Niclasapdk/ESD4_project/README.md

# ESD4_project

This repository contains notes and design files for the HiFi amplifier made in the P4 project at AAU in the spring semester of 2024.
