Niclasapdk/ESD4_project/figures/system_design/small_signal_figures/vas_stage.pdf

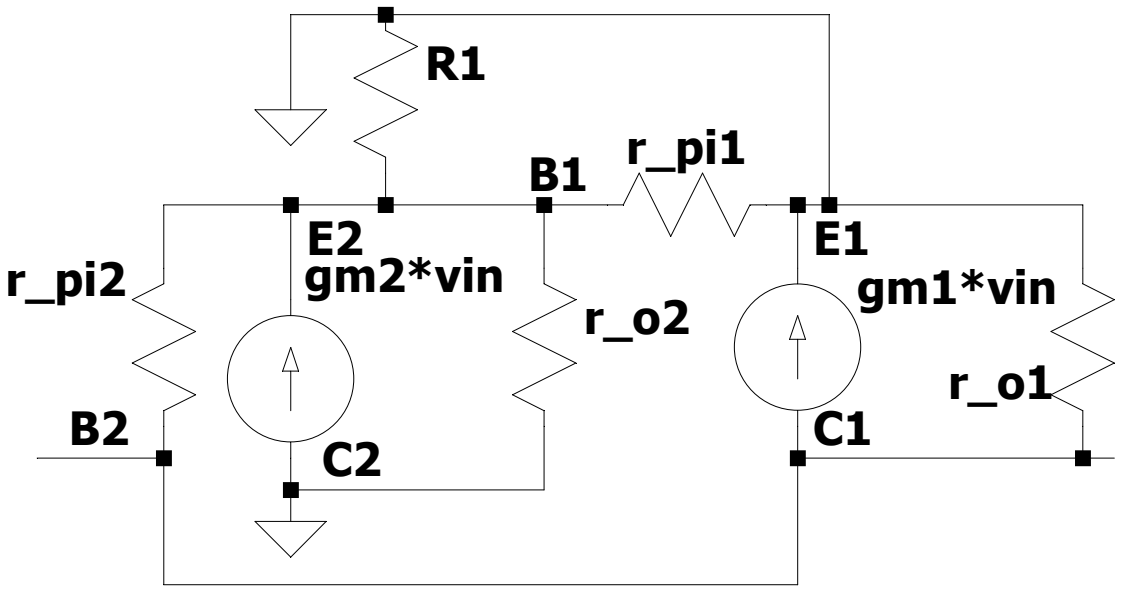
[picture p1: figure]
gm2*vin; gm1*vin

## Z_inOS

## Power Amp

--- C:\Users\johba\ESD4_project\figures\system_design\small_signal_figures\vas_stage.asc ---
