Niclasapdk/ESD4_project/figures/system_design/voltage_follower/Voltage_follower.pdf

U1
Input | Output

--- C:\Users\nicla\Documents\GitHub\ESD4_project\figures\system_design\voltage_follower\Voltage_follower.asc ---
