Niclasapdk/ESD4_project/aux_preamp/Readme.md

# op27
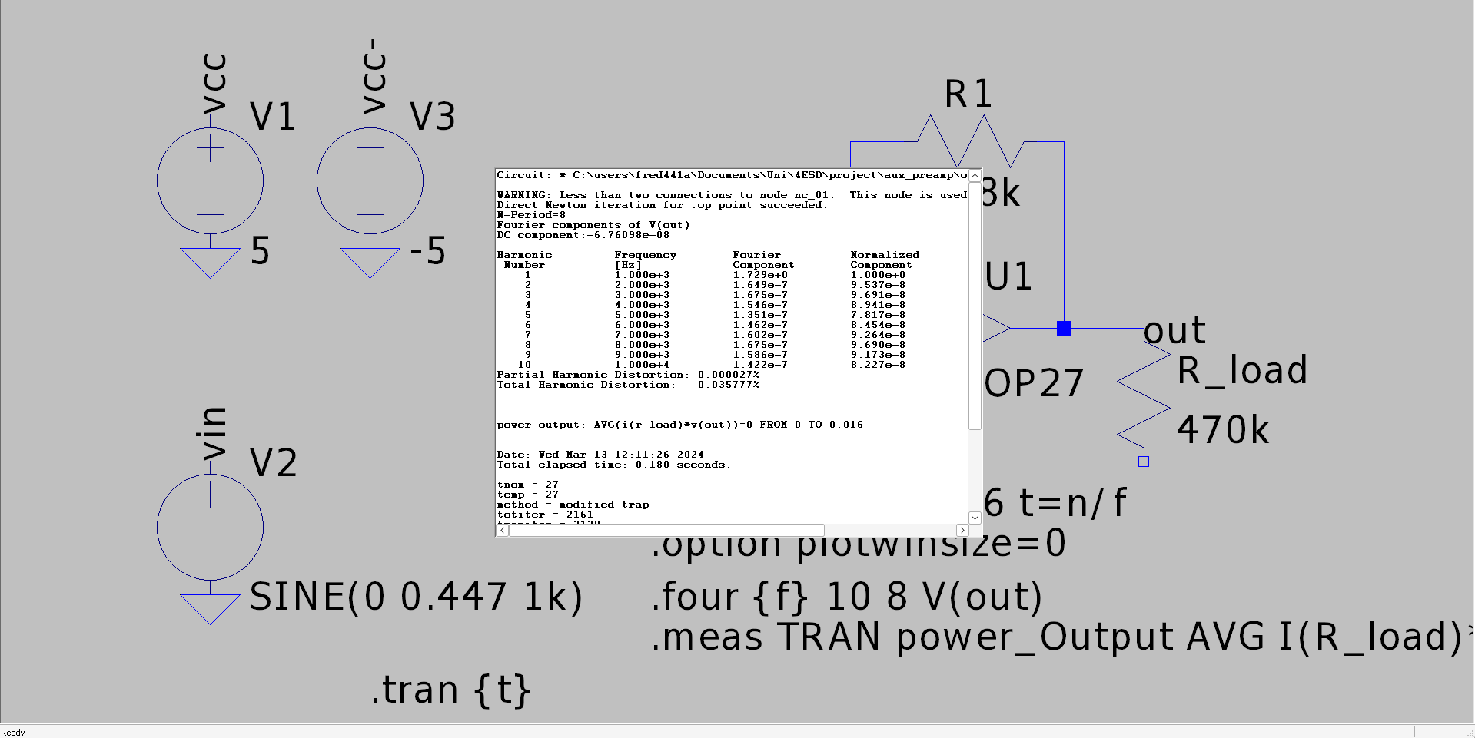
[picture p2: aux_preamp/images/img2222.png]

# op07
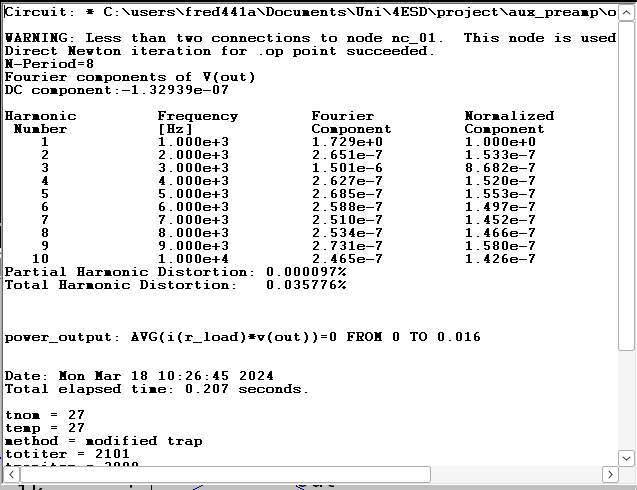
[picture p3: aux_preamp/images/img4966.png]

# differential
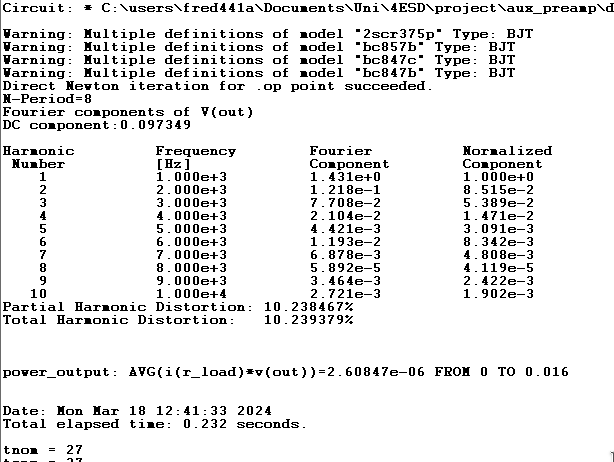
[picture p4: aux_preamp/images/img7617.png]
