Niclasapdk/ESD4_project/figures/system_design/small_signal_figures/differential_stage_v2.pdf

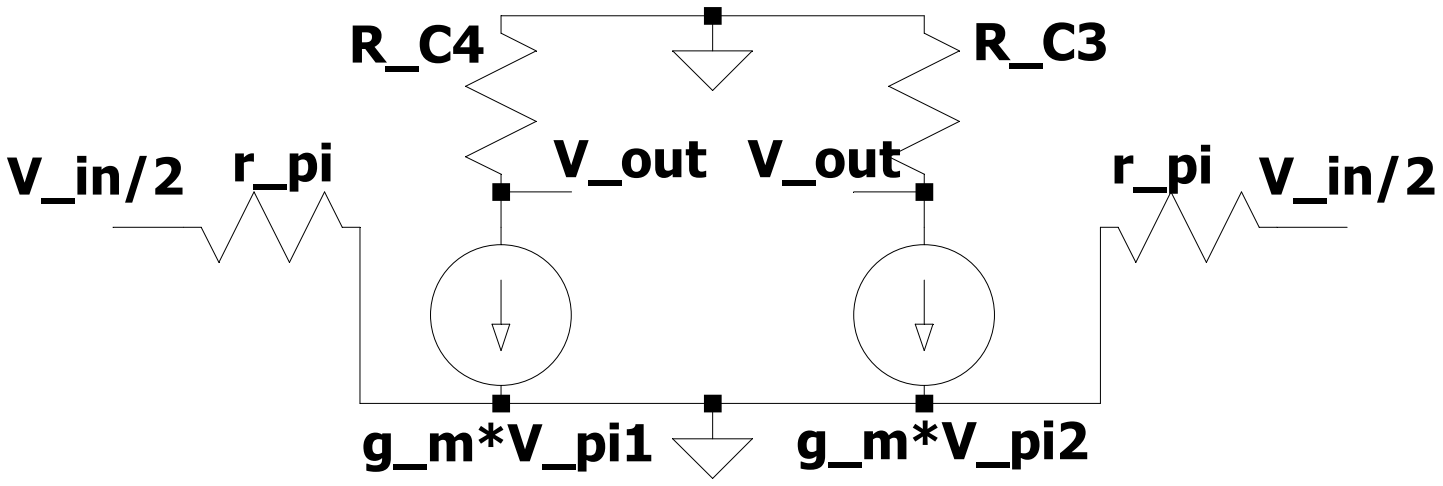
[picture p5: figure]
V_in/2 V_out V_out

--- C:\Users\johba\ESD4_project\figures\system_design\small_signal_figures\differential_stage_v2.asc ---
