Niclasapdk/ESD4_project/figures/system_design/output_compensation/output_compensation.pdf

L1

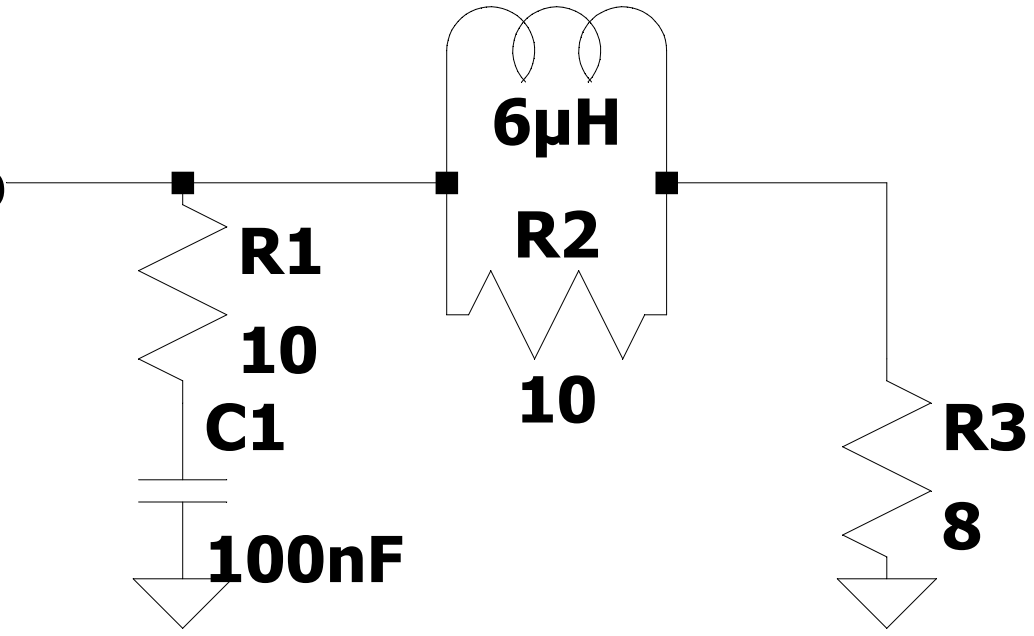
[picture p6: figure]

# Output_amp

--- C:\Users\nicla\Documents\GitHub\ESD4_project\figures\system_design\output_compensation\output_compensation.asc ---
