Niclasapdk/ESD4_project/figures/system_design/small_signal_figures/npn_darlington.pdf

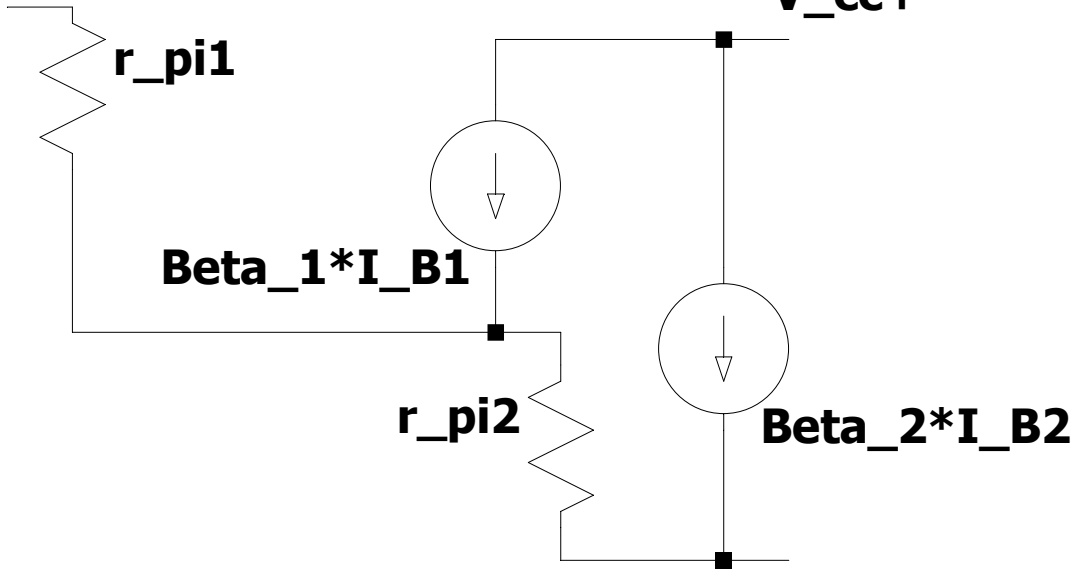
[picture p7: figure]
Beta_1*I_B1; Beta_2*I_B2

r_oVas | r_pi1

## V_cc+

## Out

--- C:\Users\johba\ESD4_project\figures\system_design\small_signal_figures\npn_darlington.asc ---
