Niclasapdk/ESD4_project/figures/system_design/vas_stage_pa/vas_stage_pa.pdf

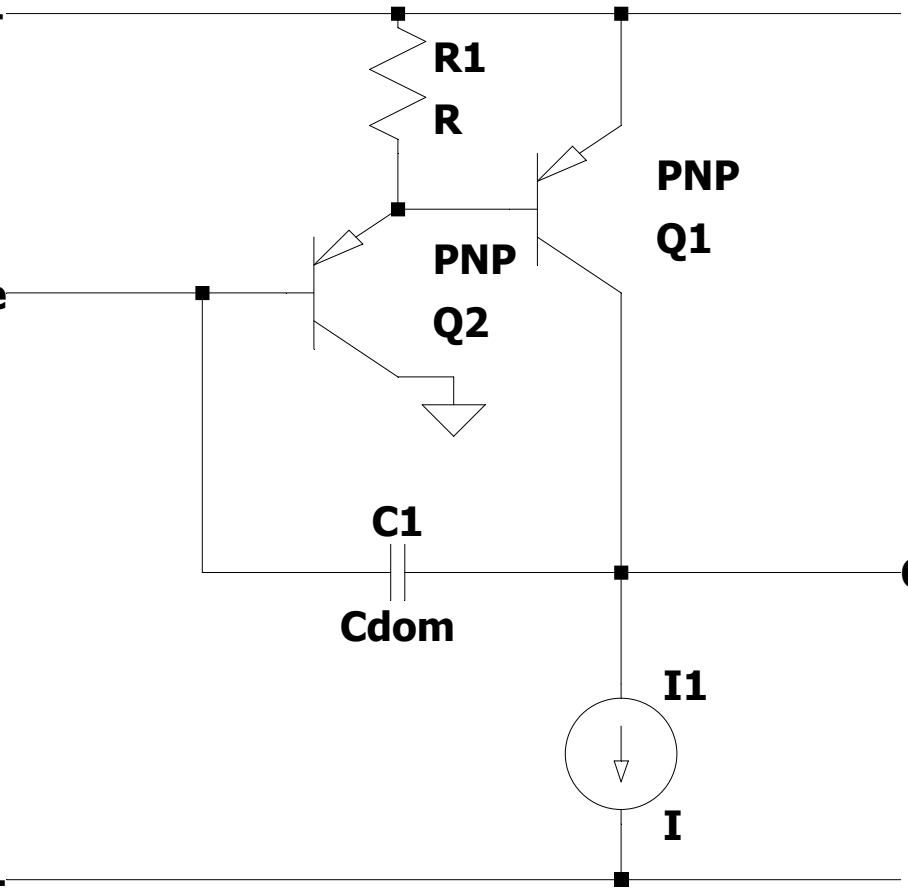
[picture p8: figure]
PNP; Cdom

## Input_Stage

V+

## Output_stage

V-

--- C:\Users\nicla\Documents\GitHub\ESD4_project\figures\system_design\vas_stage_pa\vas_stage_pa.asc ---
