Niclasapdk/ESD4_project/figures/system_design/riaa_preamp/rlc_hp_lp_schematic.pdf

R1

L1

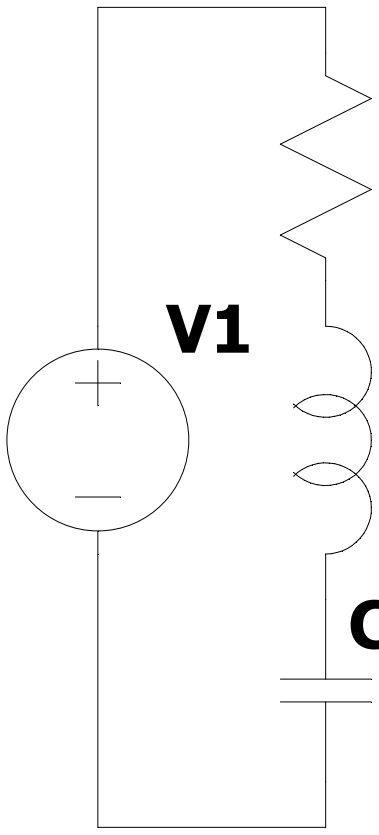
[picture p9: figure]

C1

C2

R2

R3

C3

V1 | V2 | V3
RLC | HP | LP

--- C:\Users\johba\ESD4_project\figures\system_design\riaa_pa\rlc_hp_lp_schematic.asc ---
