Niclasapdk/ESD4_project/figures/system_design/riaa_preamp/riaa_de-emphasis_circuit.pdf

R8

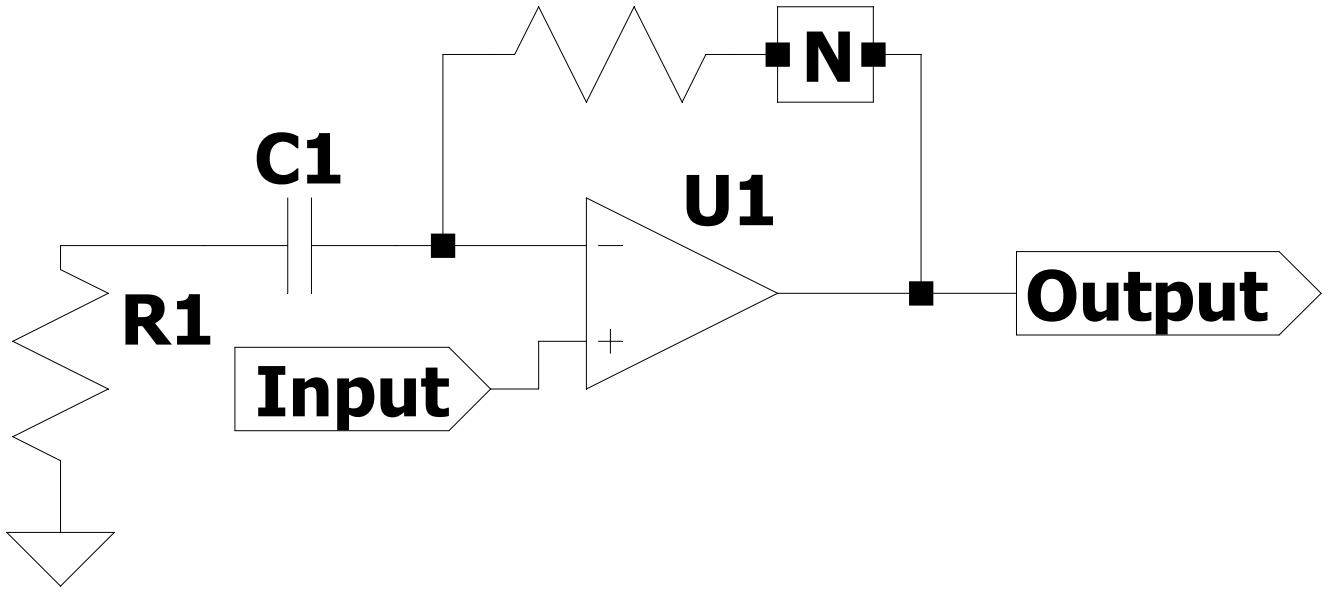
[picture p10: figure]
Input; Output

--- C:\Users\johba\ESD4_project\figures\system_design\riaa_pa\Draft1.asc ---
