Niclasapdk/ESD4_project/figures/system_design/bias_design/bias_design.pdf

# Vas

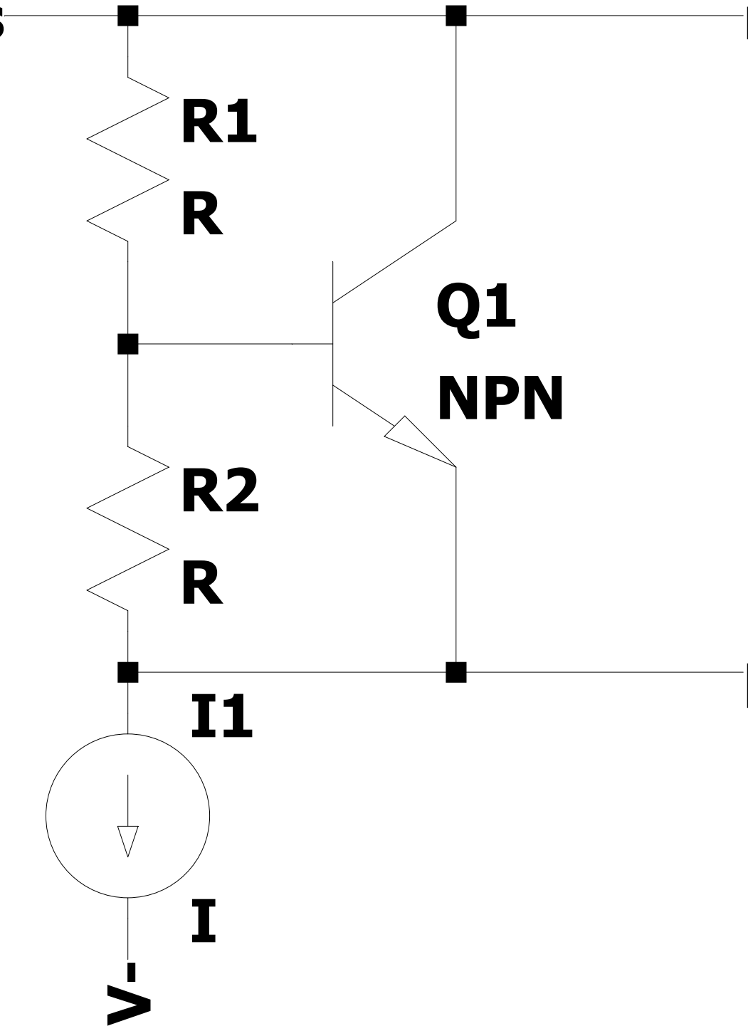
[picture p11: figure]
Q1 NPN

# pnp

# npn

--- C:\Users\nicla\Documents\GitHub\ESD4_project\figures\system_design\bias_design\bias_design.asc ---
