Niclasapdk/ESD4_project/figures/system_design/darlington_coupling/darling_coupling.pdf

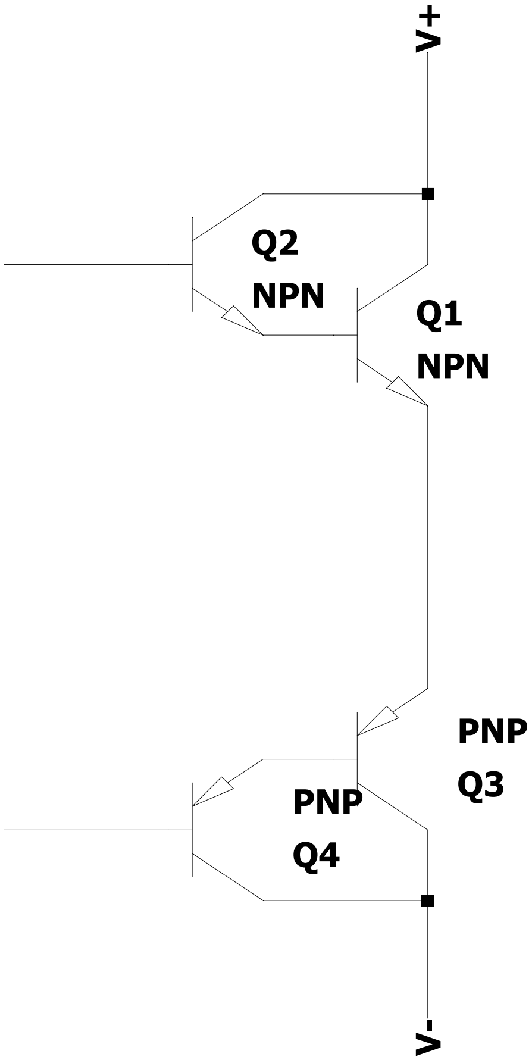
[picture p12: figure]
Q1 NPN; Q2 NPN; PNP; PNP V+ V⁻

--- C:\Users\nicla\Documents\GitHub\ESD4_project\figures\system_design\darlington_coupling\darlington_coupling.asc ---
