Niclasapdk/ESD4_project/figures/system_design/input_stage_pa/input_stage_pa.pdf

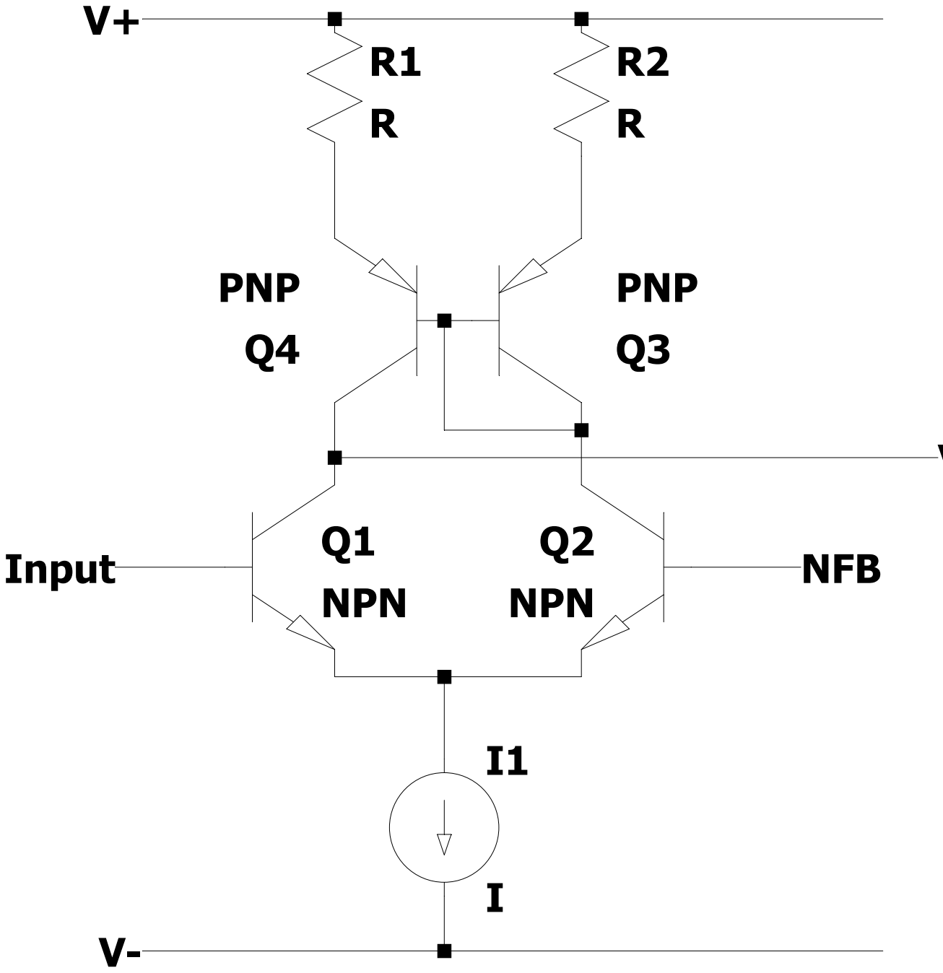
[picture p13: figure]
Q1 NPN; Q2 NPN; PNP; Input; NFB

# VAS

--- C:\Users\nicla\Documents\GitHub\ESD4_project\figures\system_design\input_stage_pa\input_stage_pa.asc ---
