Niclasapdk/ESD4_project/figures/system_design/output_stage_pa/output_stage_pa.pdf

V+

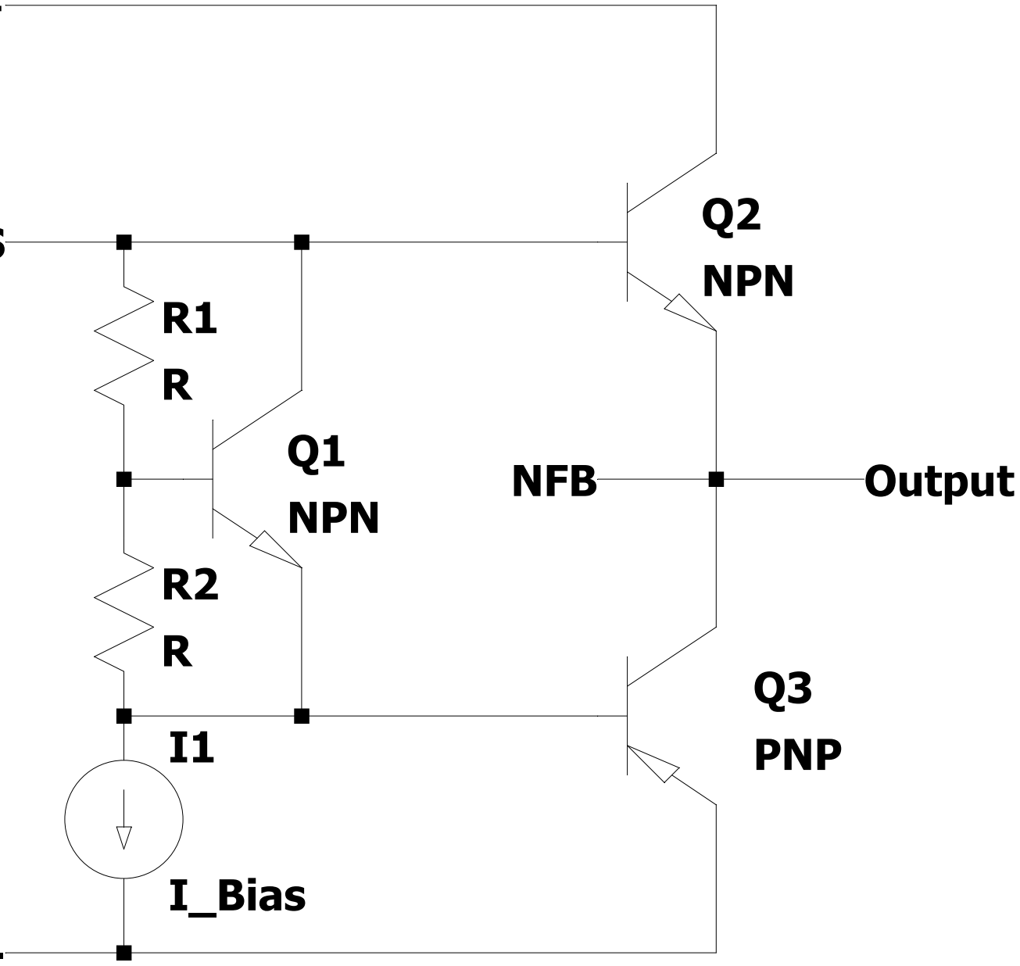
[picture p14: figure]
Q1 NPN; Q2 NPN; PNP; I_Bias; NFB; Output

V-

# VAS

--- C:\Users\nicla\Documents\GitHub\ESD4_project\figures\system_design\output_stage_pa\output_stage_pa.asc ---
