Niclasapdk/ESD4_project/forsider/Forside2.pdf

# Design of a Hi-Fi amplifier system

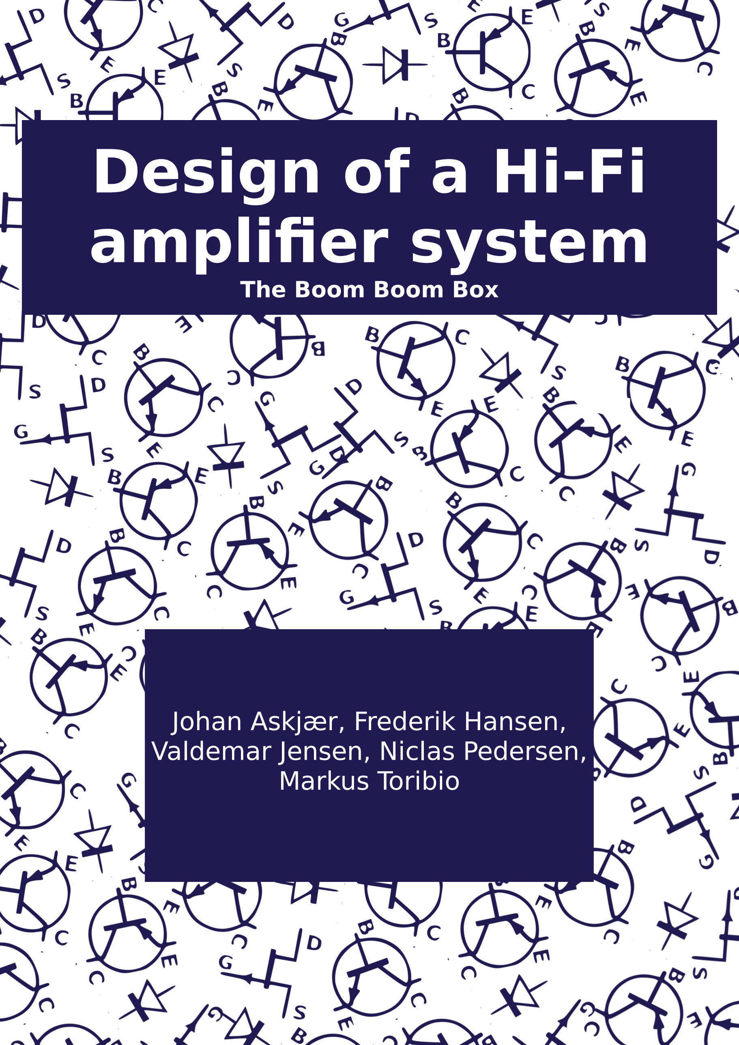
[picture p15: page 1]

Johan Askjær, Frederik Hansen, Valdemar Jensen, Niclas Pedersen, Markus Toribio

The Boom Boom Box
