Niclasapdk/ESD4_project/class_a_amplifier/output_stage.pdf

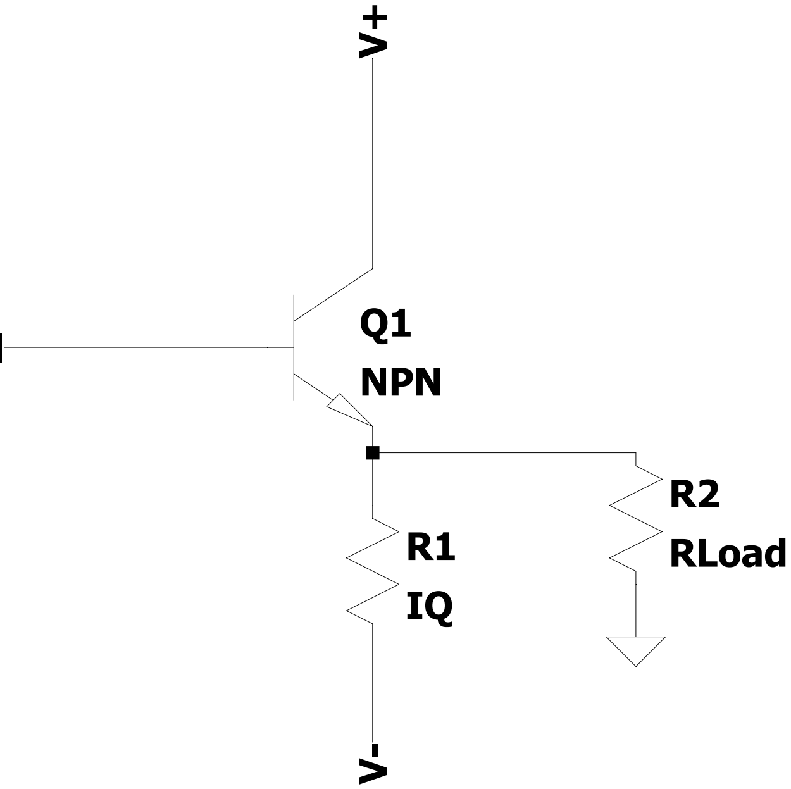
[picture p16: figure]
Q1 NPN; RLoad V+ V-

R2

# Signal

--- C:\Users\nicla\Documents\GitHub\ESD4_project\class_a_amplifier\output_stage.asc ---
