Niclasapdk/ESD4_project/forsider/Forside1.pdf

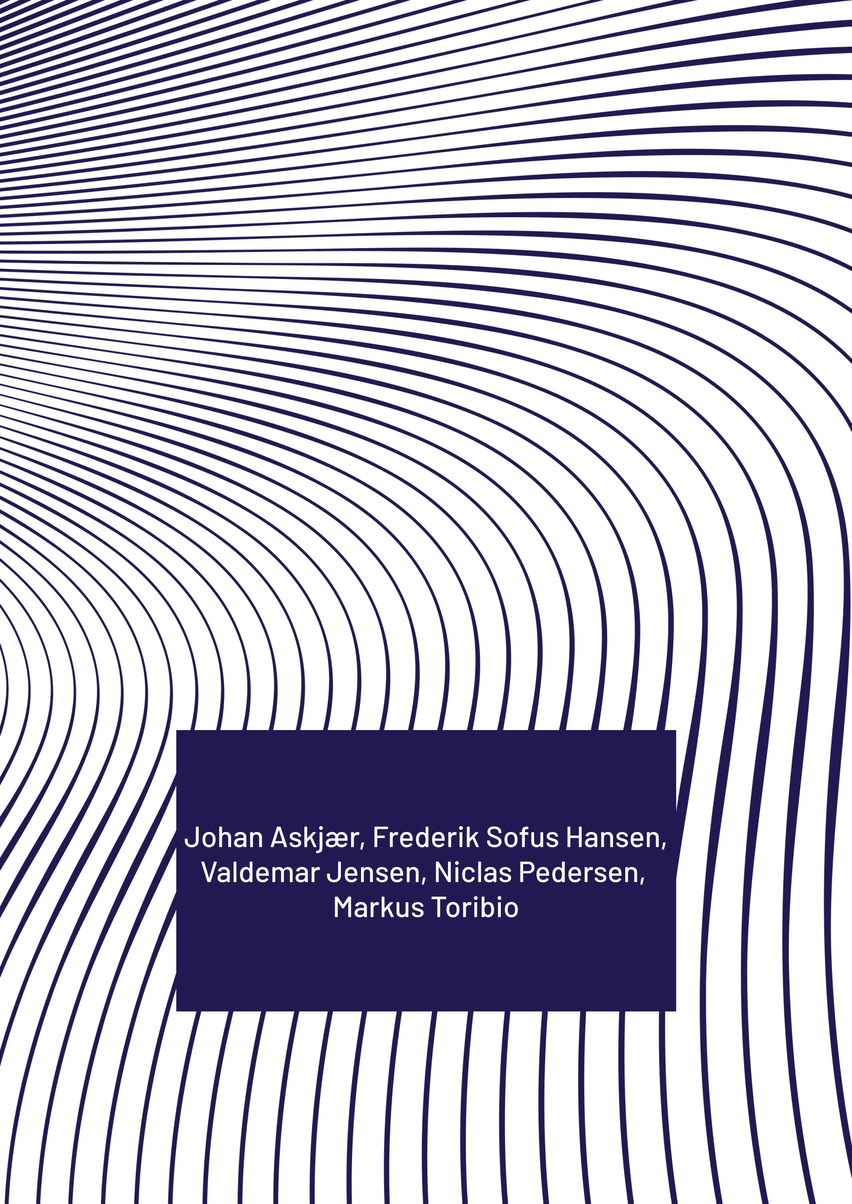
[picture p17: page 1]

Johan Askjær, Frederik Sofus Hansen, Valdemar Jensen, Niclas Pedersen, Markus Toribio
