Niclasapdk/ESD4_project/figures/system_design/small_signal_figures/differential_stage.pdf

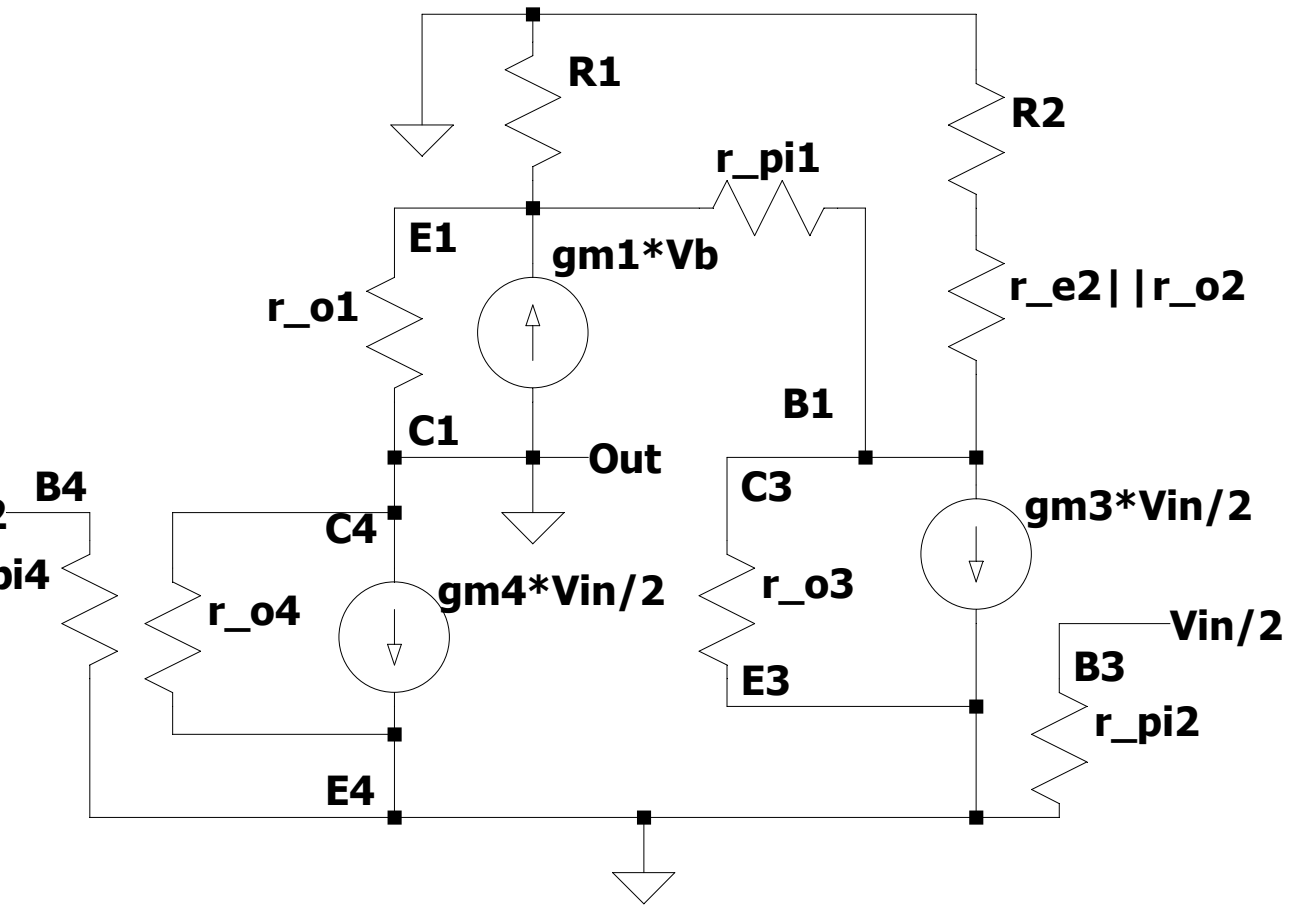
[picture p18: figure]
gm4*Vin/2; gm3*Vin/2; Out; Vin/2

## r_pi4

## Vin/2

--- C:\Users\johba\ESD4_project\figures\system_design\small_signal_figures\differential_stage.asc ---
