Niclasapdk/ESD4_project/class_ab_amplifier/images/img8365.png

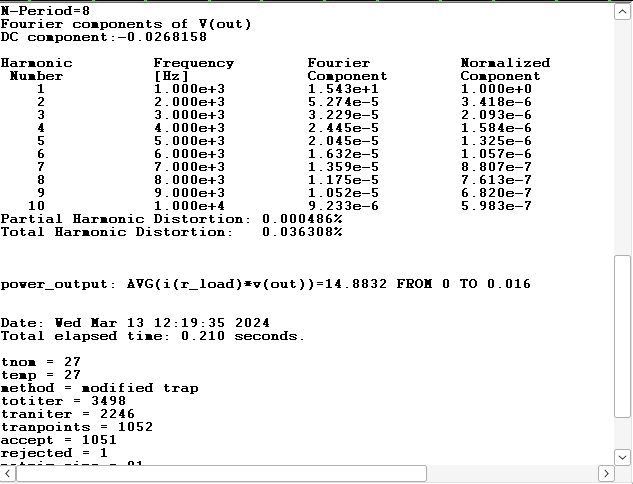
class_ab_amplifier/images/img8365.png
