Niclasapdk/ESD4_project/figures/integration/case/3dview_case_back.png

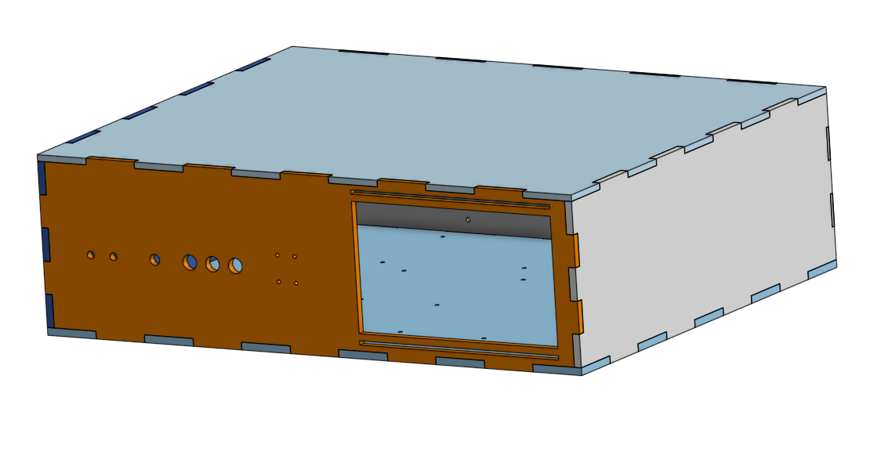
figures/integration/case/3dview_case_back.png
