Niclasapdk/ESD4_project/figures/integration/case/amplifier_box.png

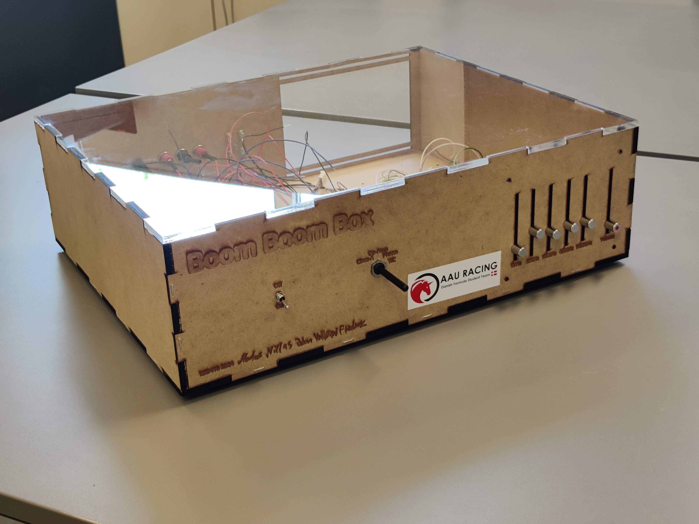
figures/integration/case/amplifier_box.png
