Niclasapdk/ESD4_project/figures/integration/case/backpane.png

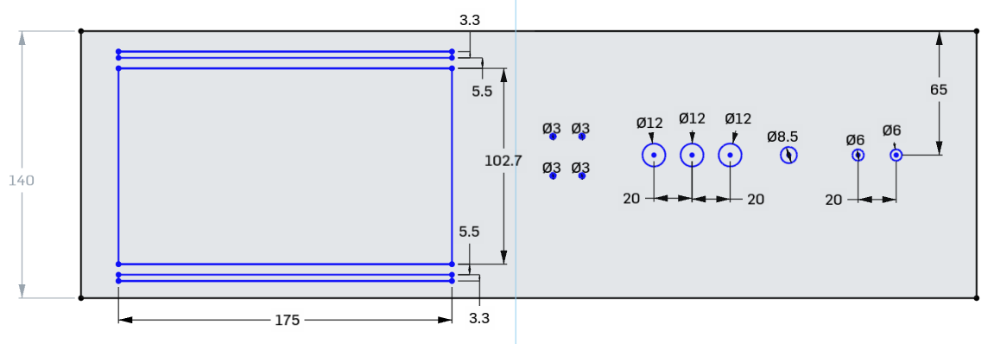
figures/integration/case/backpane.png
