Niclasapdk/ESD4_project/figures/integration/case/bottompane.png

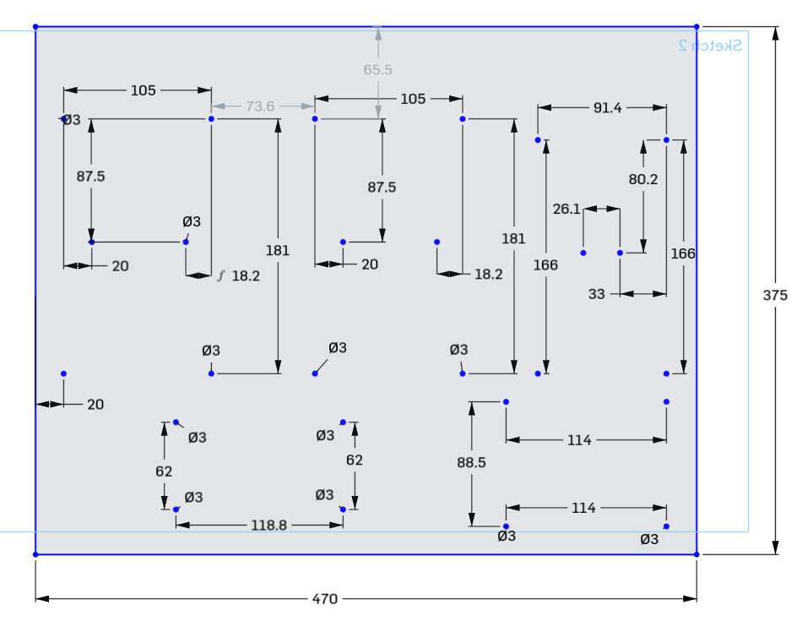
figures/integration/case/bottompane.png
