Niclasapdk/ESD4_project/figures/integration/case/frontpane.png

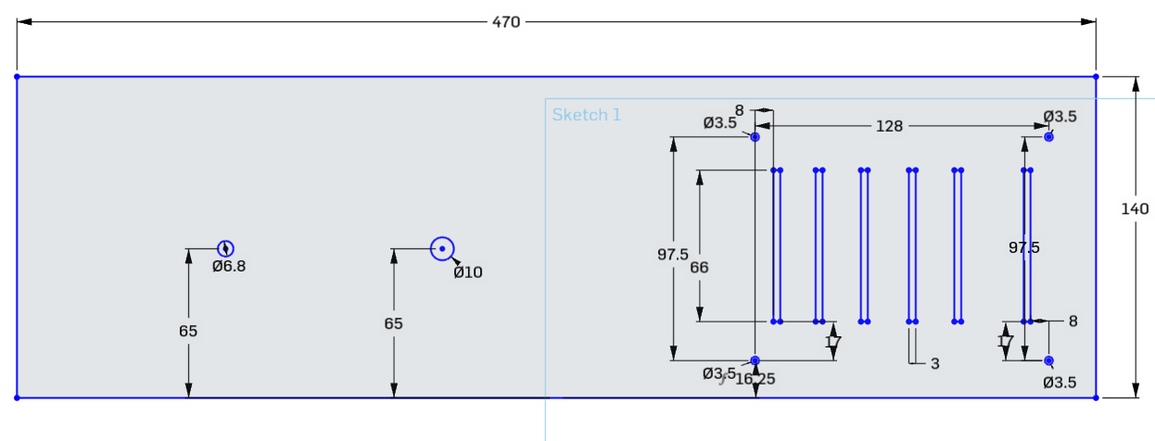
figures/integration/case/frontpane.png
