Niclasapdk/ESD4_project/figures/integration/classAPCB.png

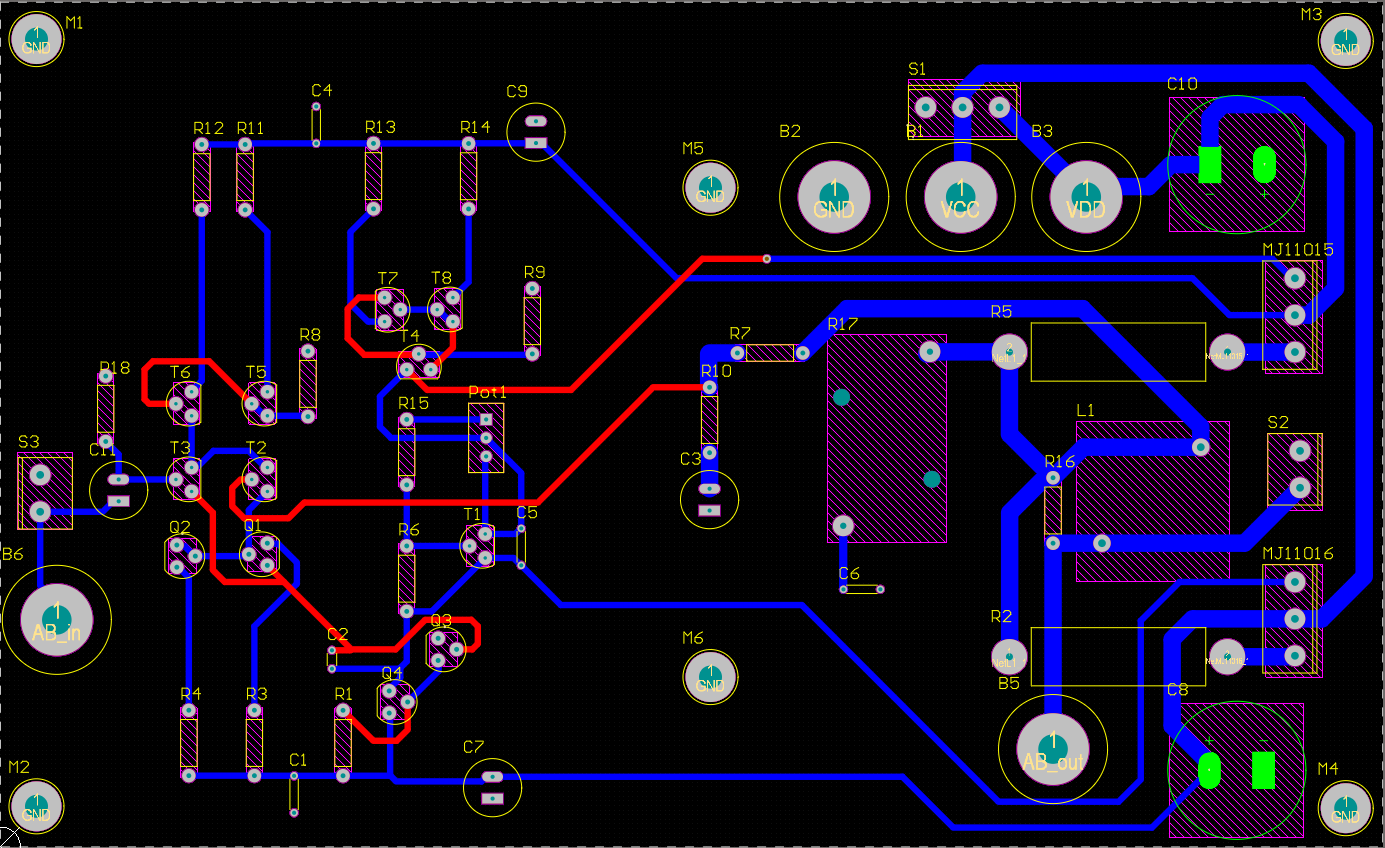
figures/integration/classAPCB.png
