Niclasapdk/ESD4_project/figures/integration/Equalizer_vol_bandpass.jpg

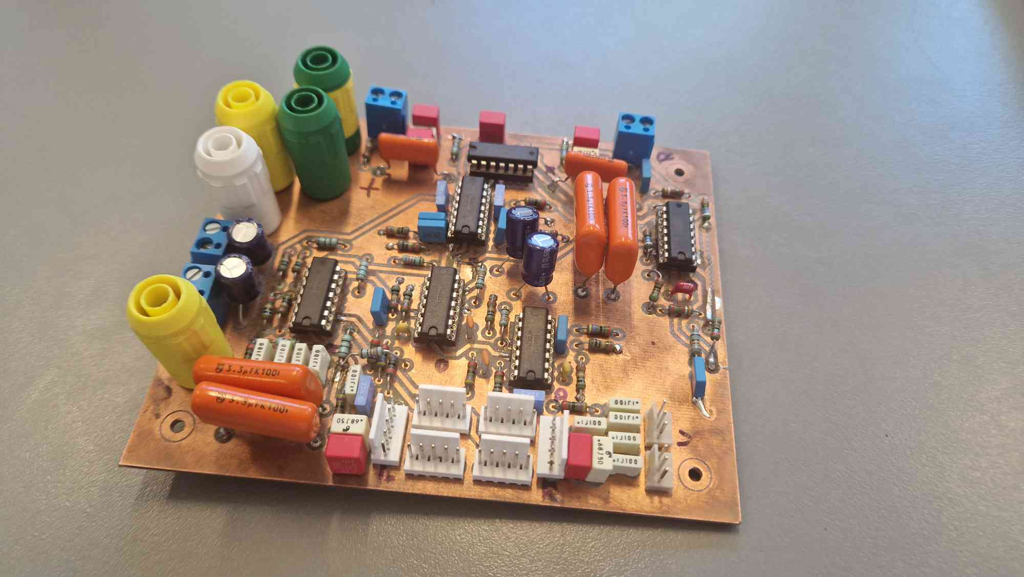
figures/integration/Equalizer_vol_bandpass.jpg
