Niclasapdk/ESD4_project/figures/integration/equalizerVCPCB.png

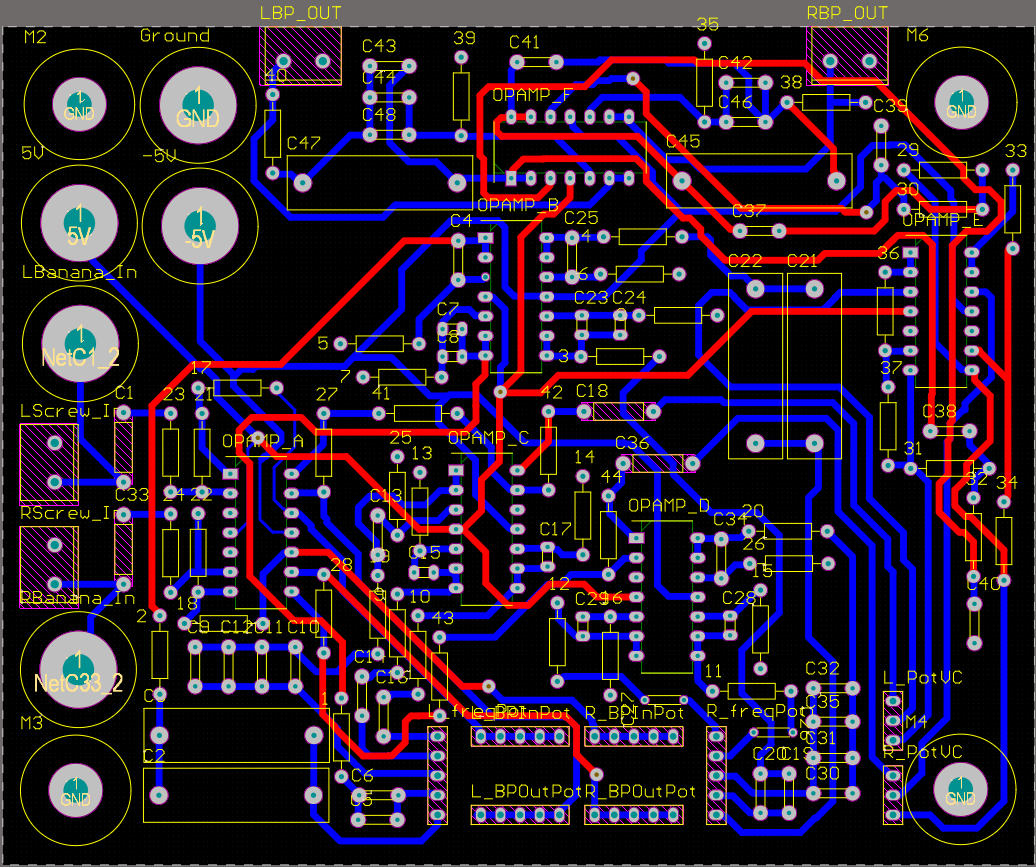
figures/integration/equalizerVCPCB.png
