Niclasapdk/ESD4_project/figures/integration/pa_heatsink.jpg

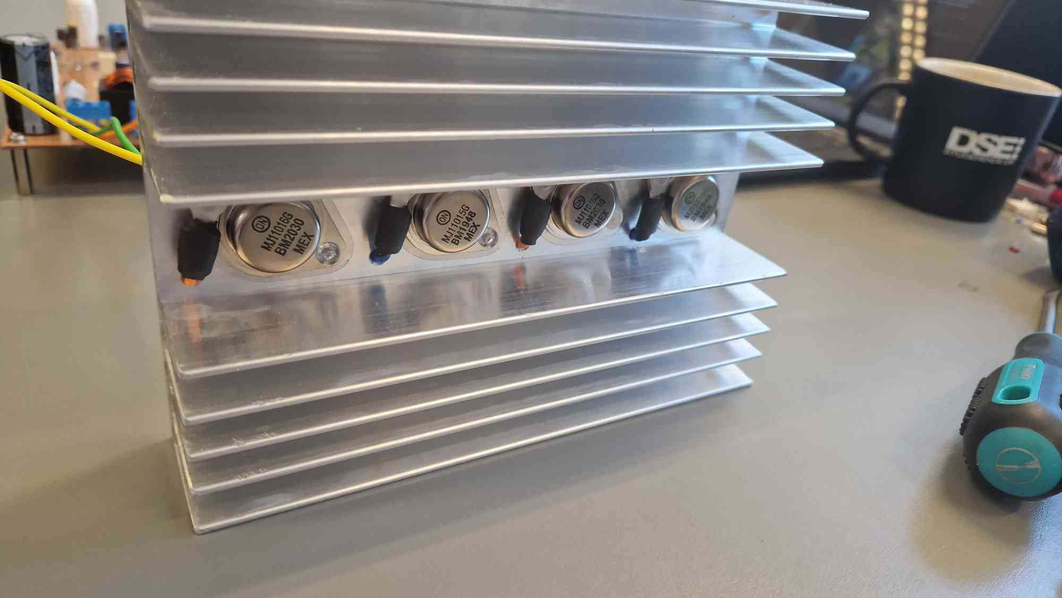
figures/integration/pa_heatsink.jpg
