Niclasapdk/ESD4_project/figures/integration/pa_physical.jpg

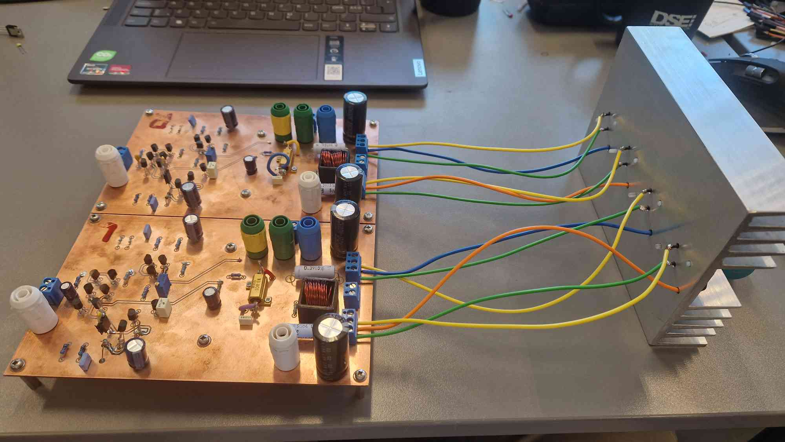
figures/integration/pa_physical.jpg
