Niclasapdk/ESD4_project/figures/integration/pcb_graveyard/eq_volume_control.jpg

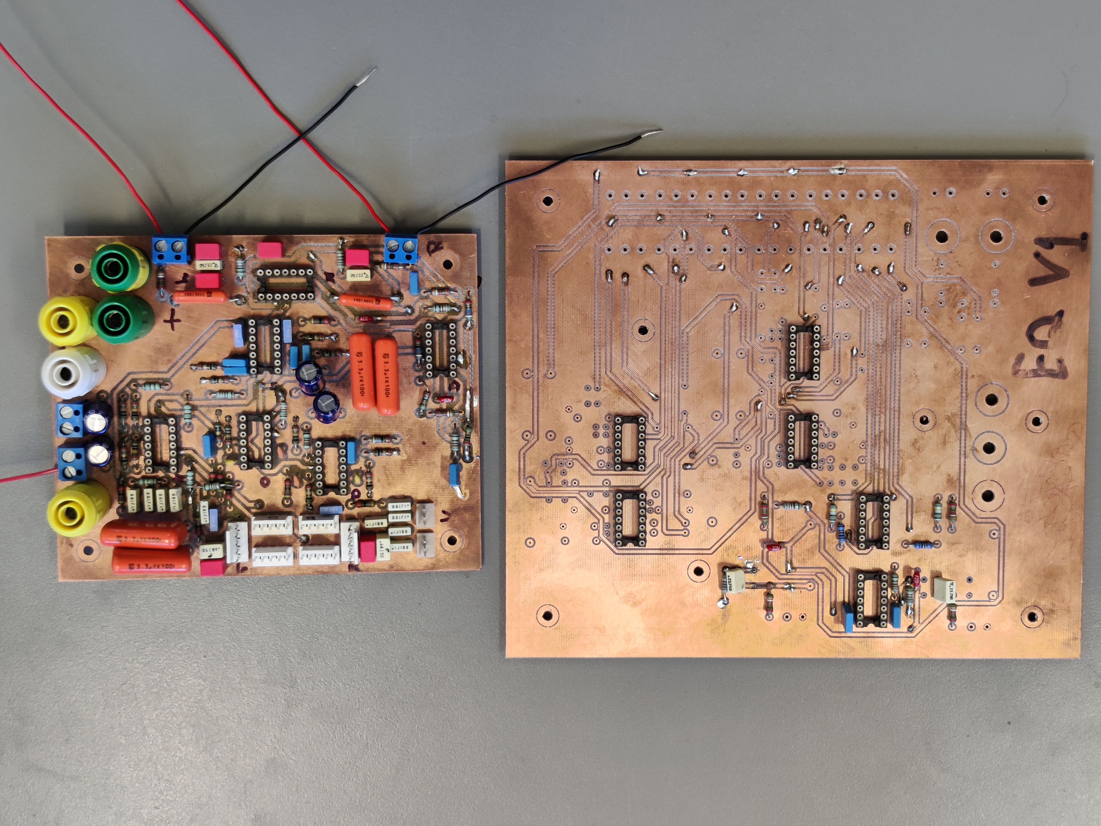
figures/integration/pcb_graveyard/eq_volume_control.jpg
