Niclasapdk/ESD4_project/figures/integration/pcb_graveyard/power_amplifier_spread.jpg

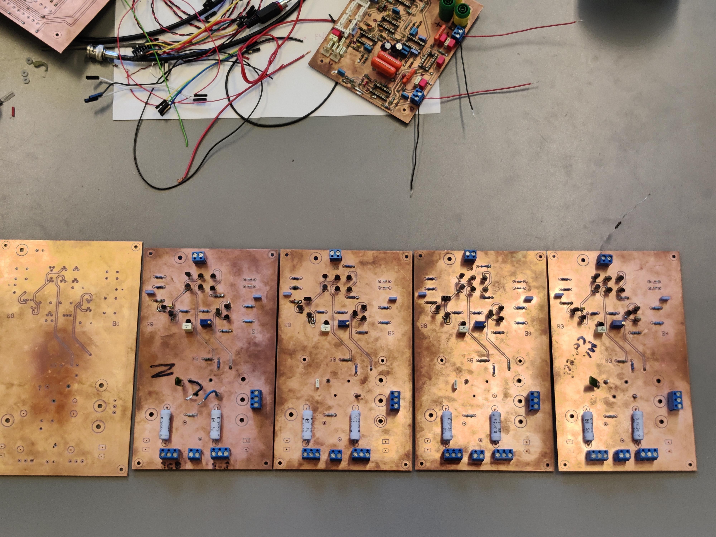
figures/integration/pcb_graveyard/power_amplifier_spread.jpg
