Niclasapdk/ESD4_project/figures/integration/pcb_graveyard/power_amplifier_stacked.jpg

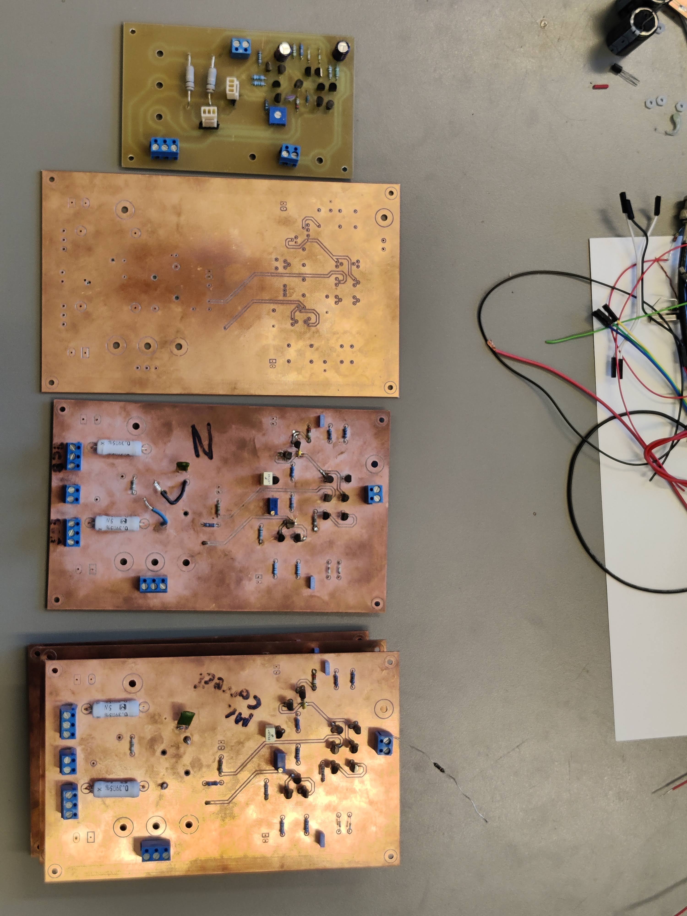
figures/integration/pcb_graveyard/power_amplifier_stacked.jpg
