Niclasapdk/ESD4_project/figures/integration/pcb_graveyard/power_supply.jpg

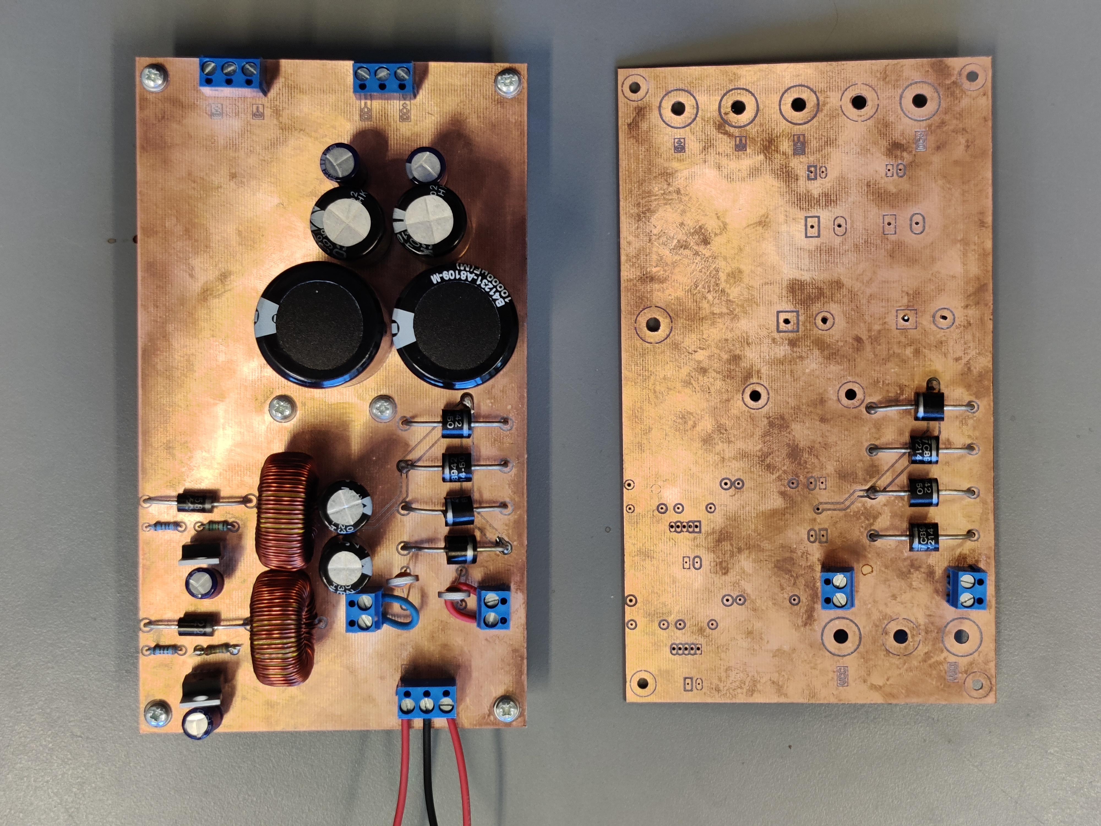
figures/integration/pcb_graveyard/power_supply.jpg
