Niclasapdk/ESD4_project/figures/integration/powersupply.jpg

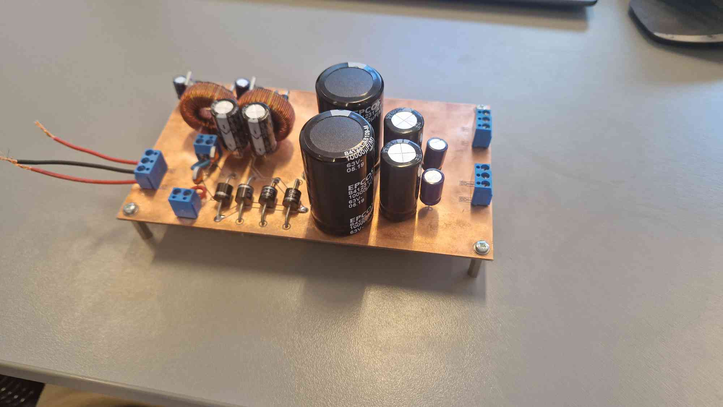
figures/integration/powersupply.jpg
