Niclasapdk/ESD4_project/figures/integration/powerSupplyPCB.png

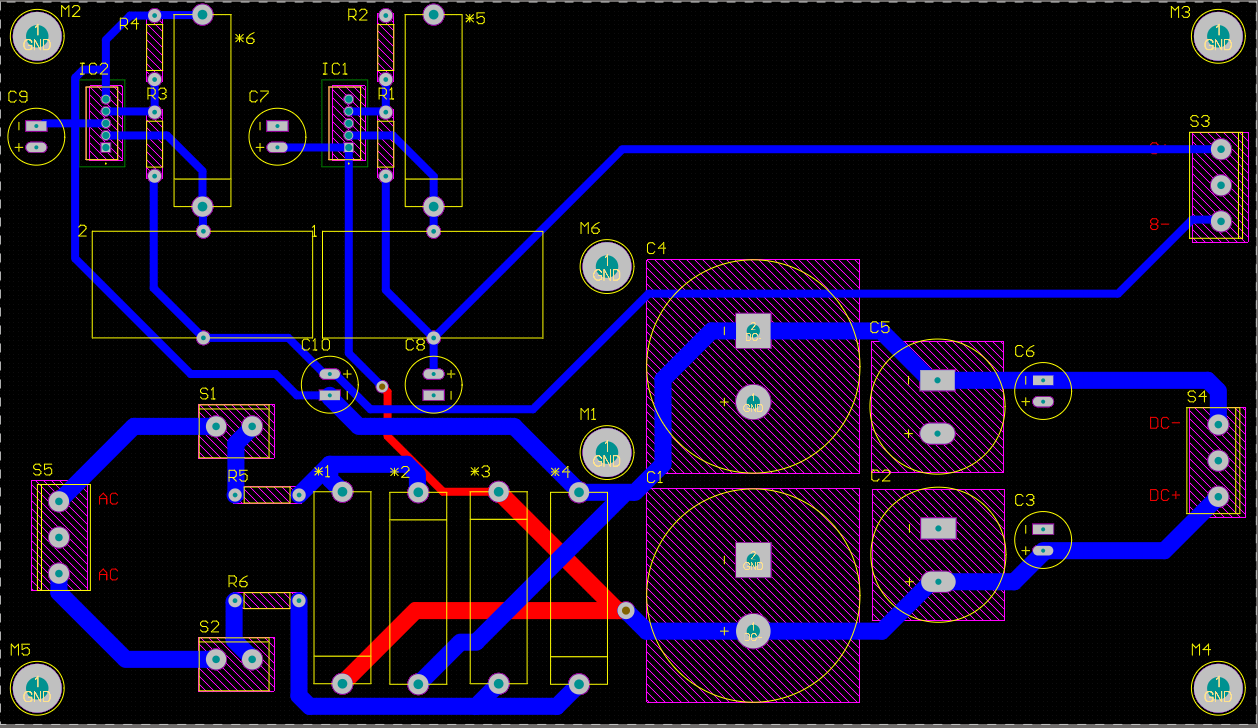
figures/integration/powerSupplyPCB.png
