Niclasapdk/ESD4_project/figures/integration/pre_amp_riaa.jpg

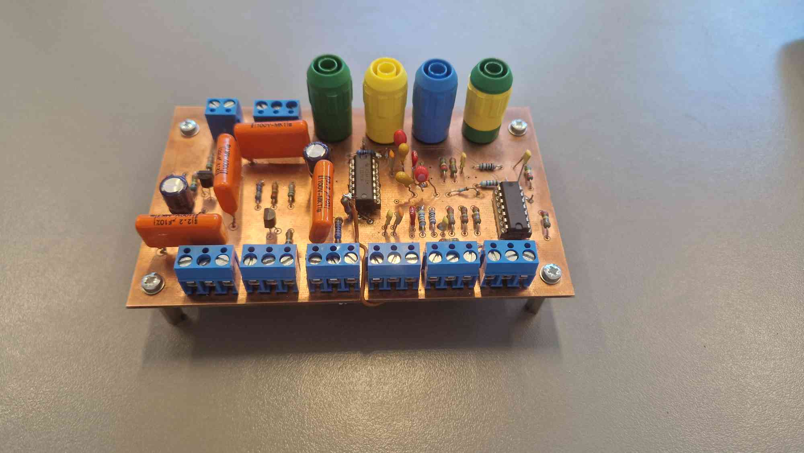
figures/integration/pre_amp_riaa.jpg
