Niclasapdk/ESD4_project/figures/integration/preampRIAAPCB.png

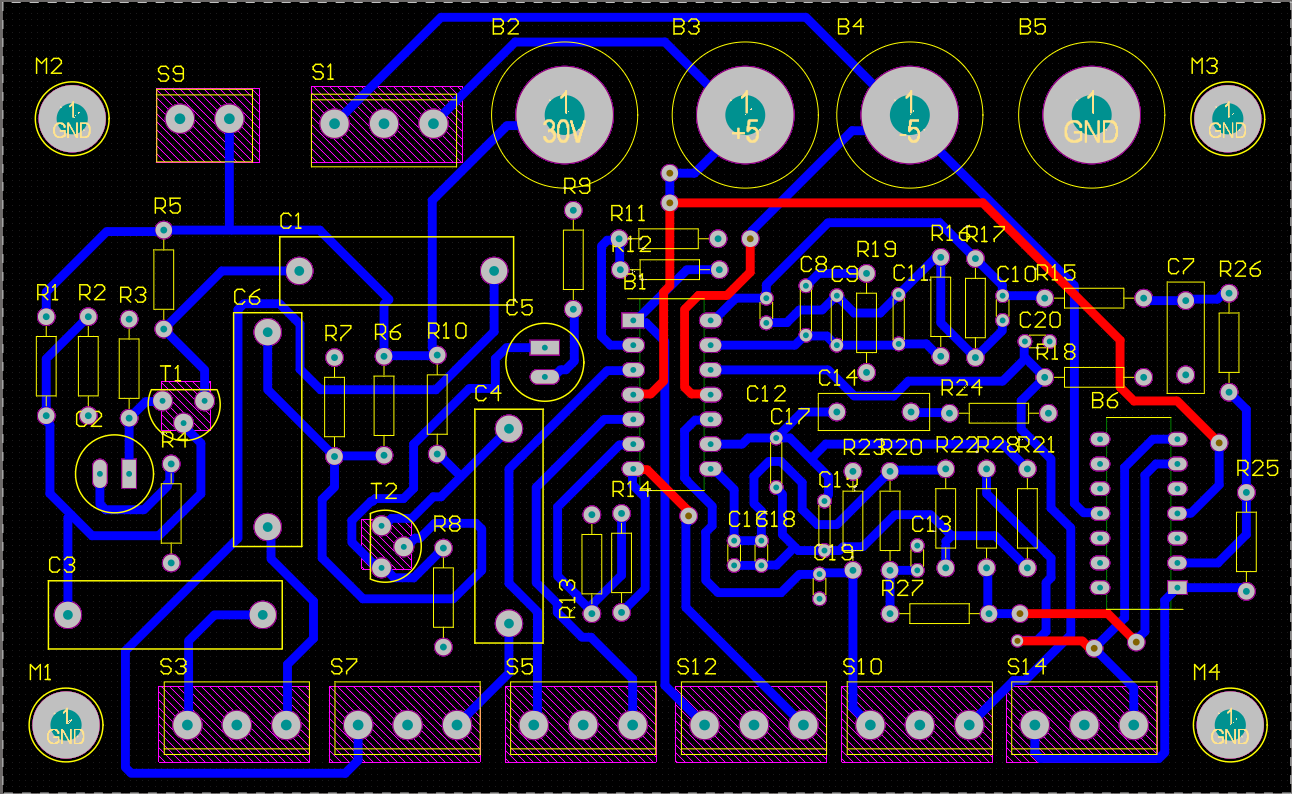
figures/integration/preampRIAAPCB.png
