Niclasapdk/ESD4_project/figures/integration_test/zo_schematic_equivalent.png

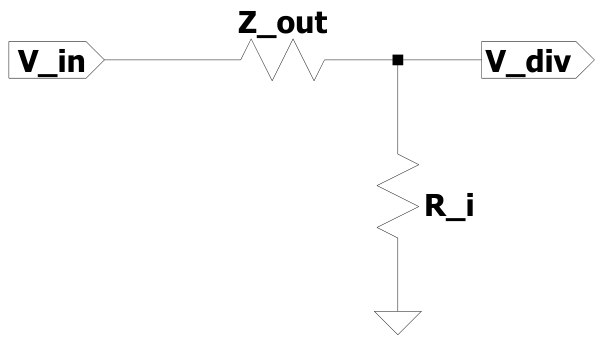
figures/integration_test/zo_schematic_equivalent.png
