Niclasapdk/ESD4_project/figures/system_design/auxPreAmp/ClassAPreAmp.png

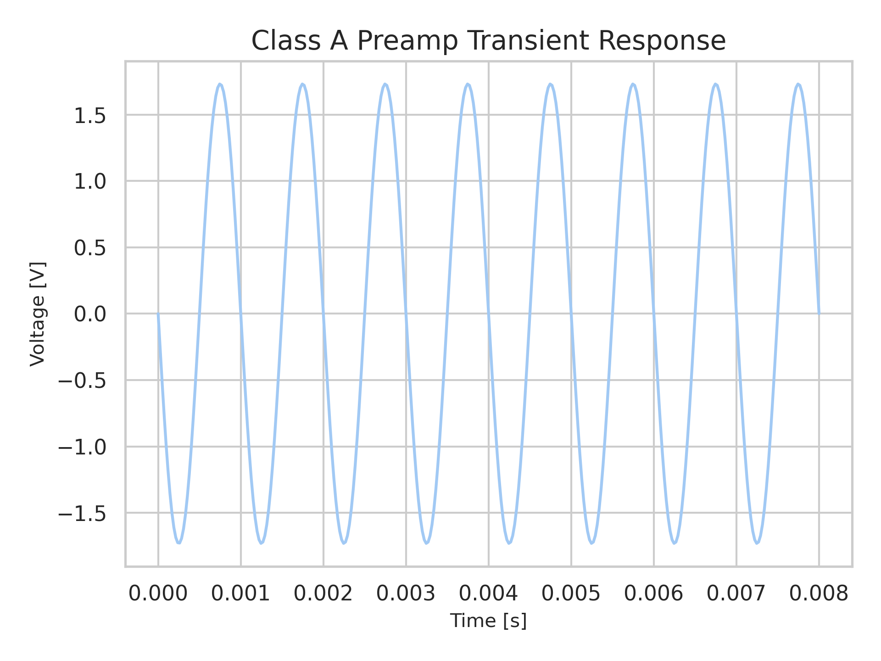
figures/system_design/auxPreAmp/ClassAPreAmp.png
