Niclasapdk/ESD4_project/figures/system_design/auxPreAmp/non_inverting_opamp.png

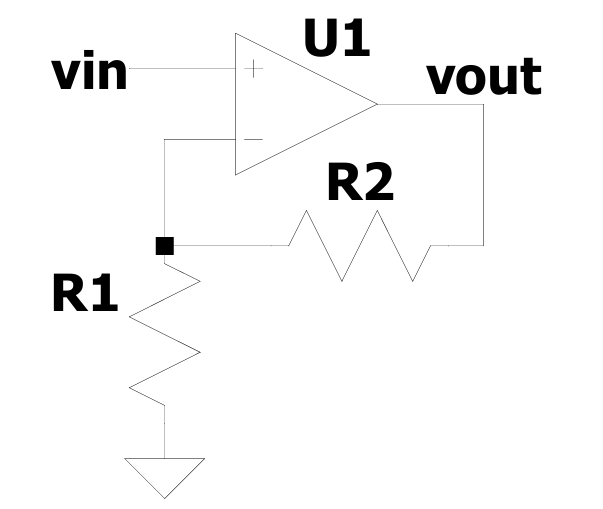
figures/system_design/auxPreAmp/non_inverting_opamp.png
