Niclasapdk/ESD4_project/figures/system_design/auxPreAmp/opamp_preamp_transient.png

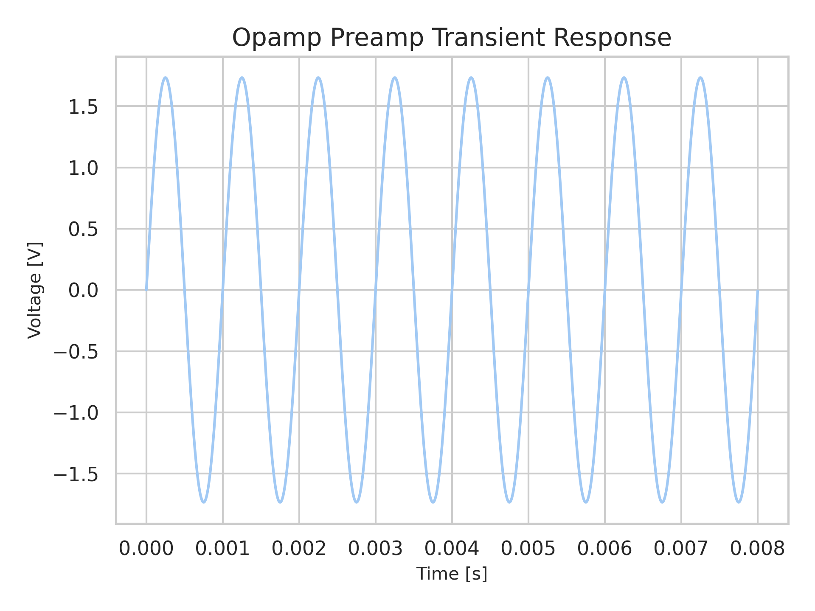
figures/system_design/auxPreAmp/opamp_preamp_transient.png
