Niclasapdk/ESD4_project/figures/system_design/auxPreAmp/preampTopologyDesign.png

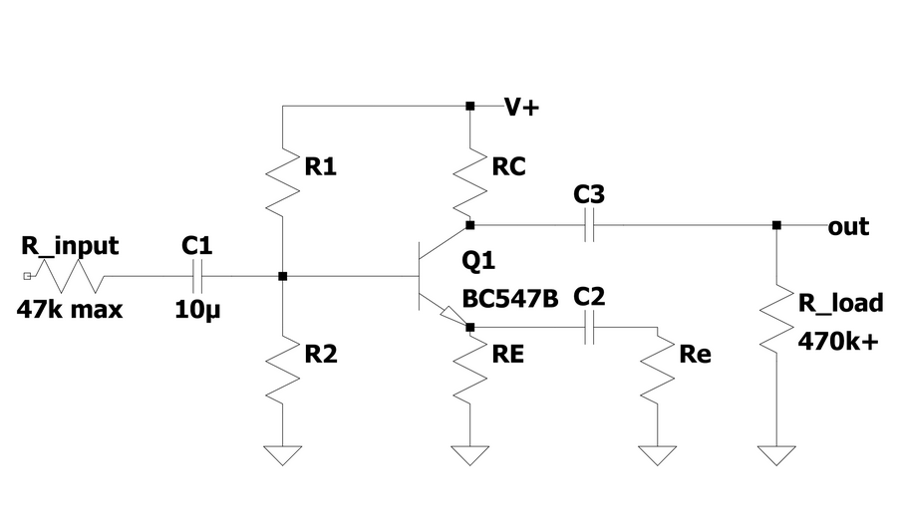
figures/system_design/auxPreAmp/preampTopologyDesign.png
