Niclasapdk/ESD4_project/figures/system_design/auxPreAmp/smallSignalAuxPreAmp.png

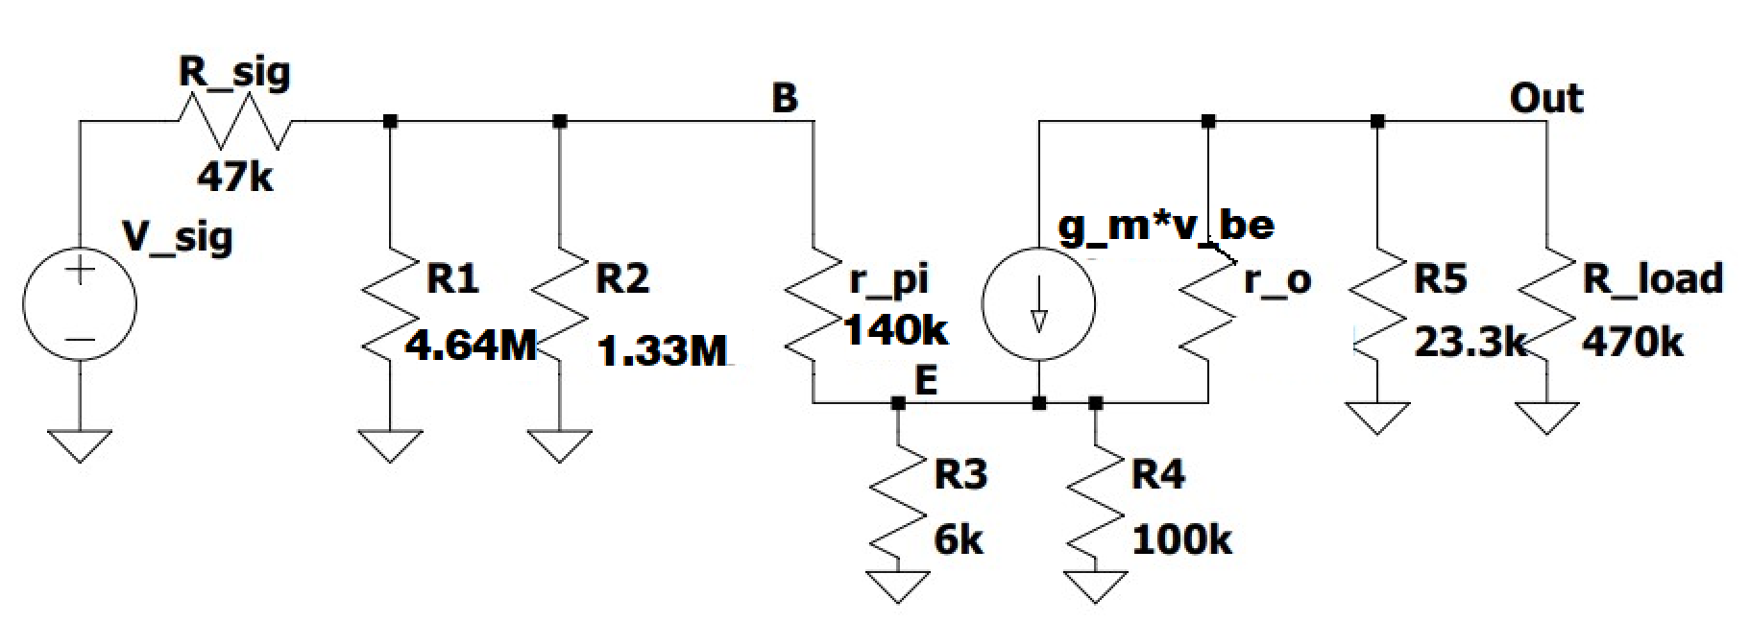
figures/system_design/auxPreAmp/smallSignalAuxPreAmp.png
