Niclasapdk/ESD4_project/figures/system_design/band_pass_response/bandpass_response_fig.png

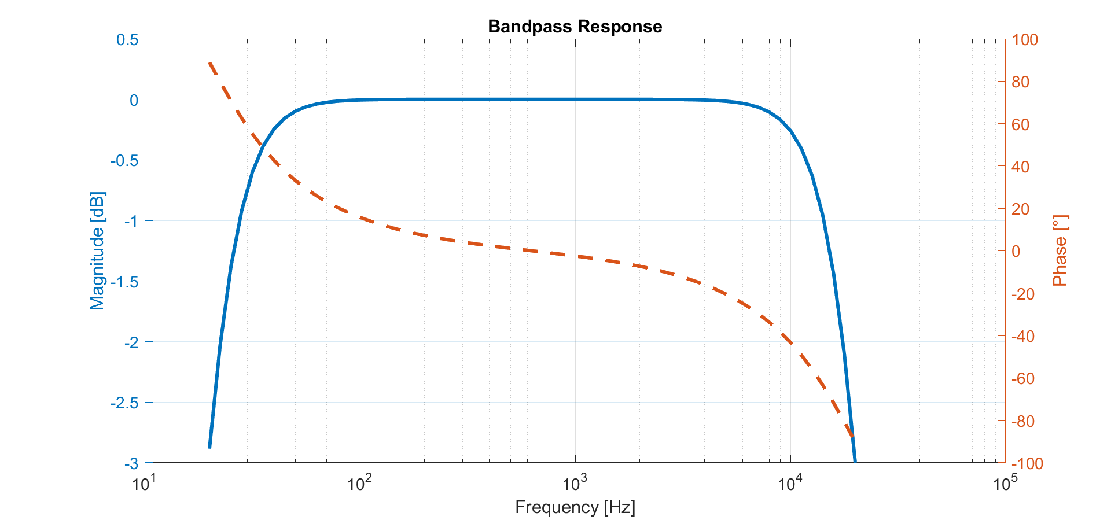
figures/system_design/band_pass_response/bandpass_response_fig.png
