Niclasapdk/ESD4_project/figures/system_design/band_pass_response/bandpass_script_calculated.png

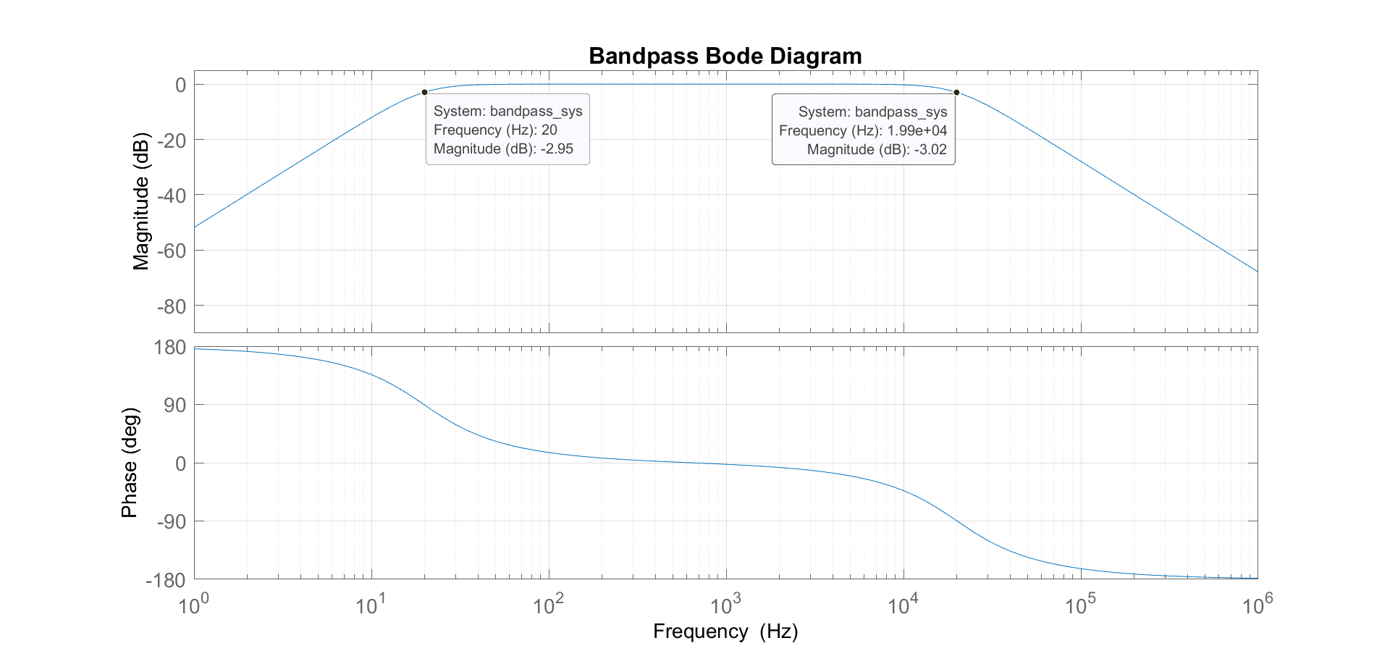
figures/system_design/band_pass_response/bandpass_script_calculated.png
