Niclasapdk/ESD4_project/figures/system_design/bandpass_filter_values/bandpass_filter_value.png

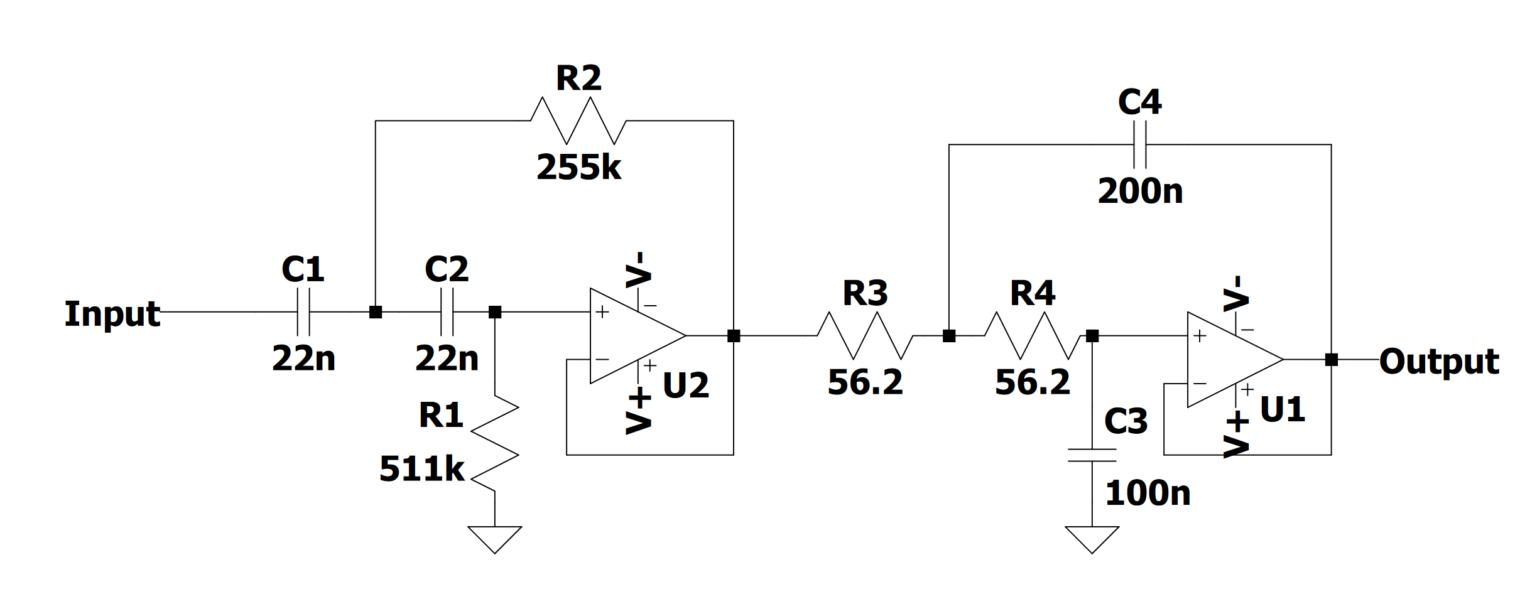
figures/system_design/bandpass_filter_values/bandpass_filter_value.png
