Niclasapdk/ESD4_project/figures/system_design/Baxendall.png

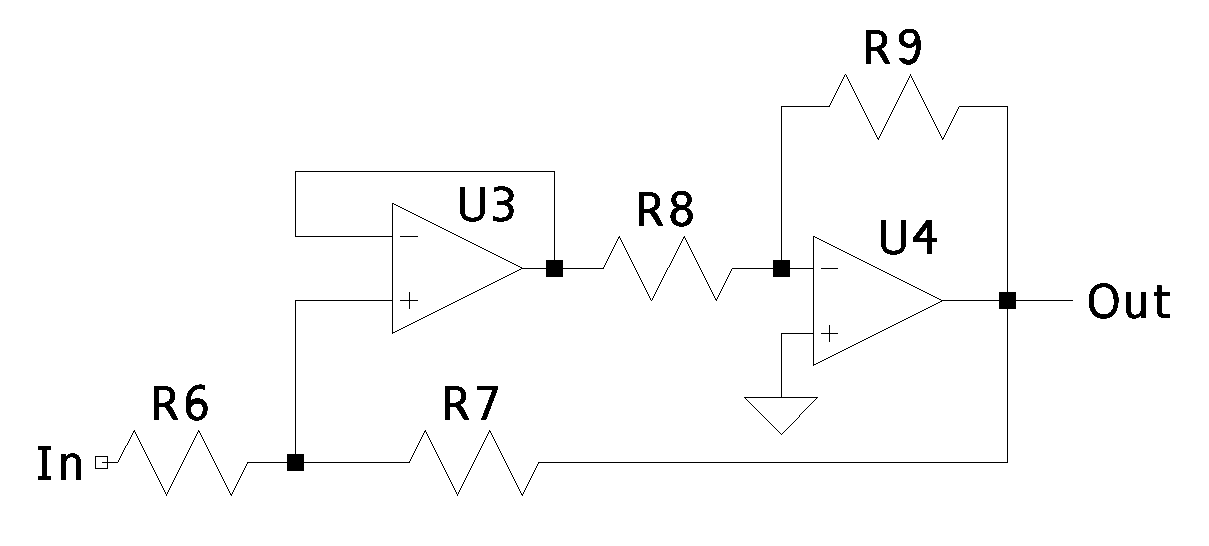
figures/system_design/Baxendall.png
