Niclasapdk/ESD4_project/figures/system_design/bias_current_final/bias_current_final.png

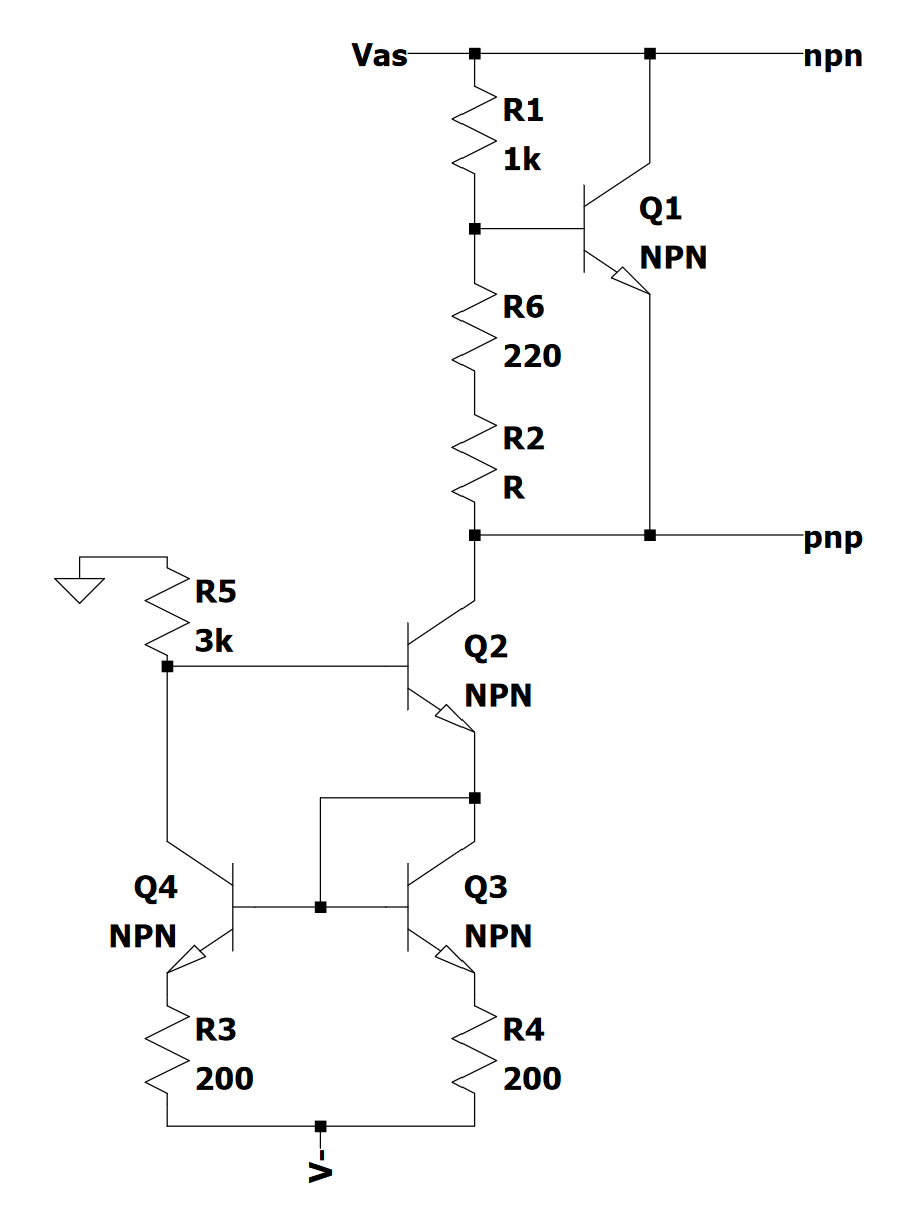
figures/system_design/bias_current_final/bias_current_final.png
