Niclasapdk/ESD4_project/figures/system_design/bias_design/bias_design.png

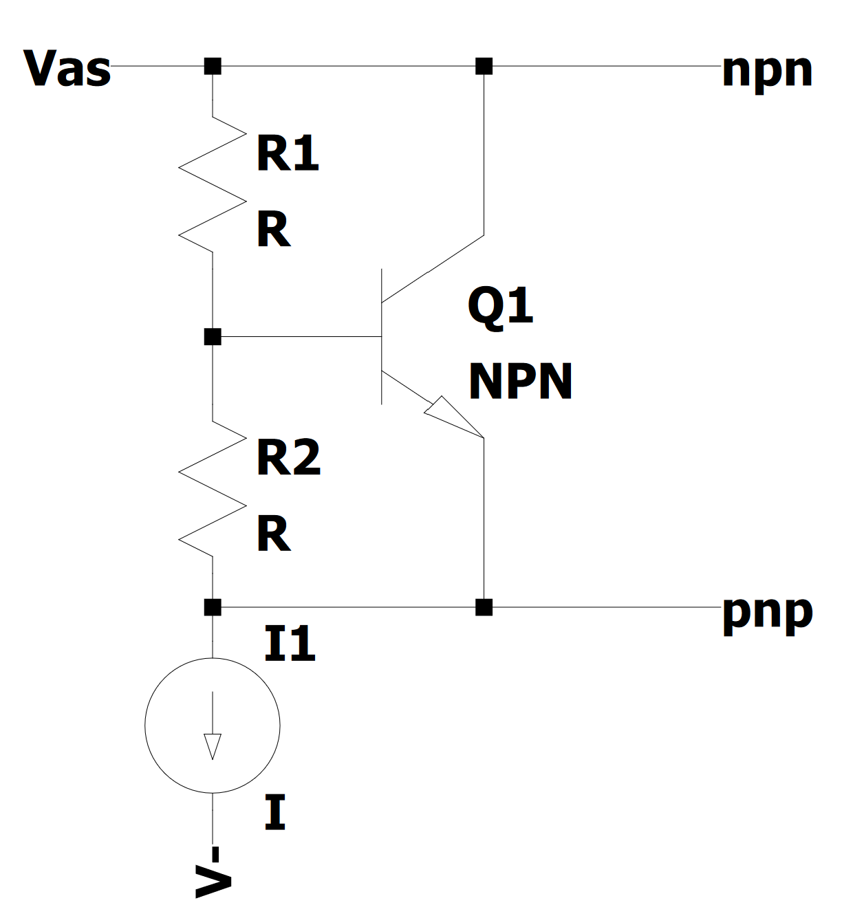
figures/system_design/bias_design/bias_design.png
