Niclasapdk/ESD4_project/figures/system_design/darlington_coupling/darlington_coupling.png

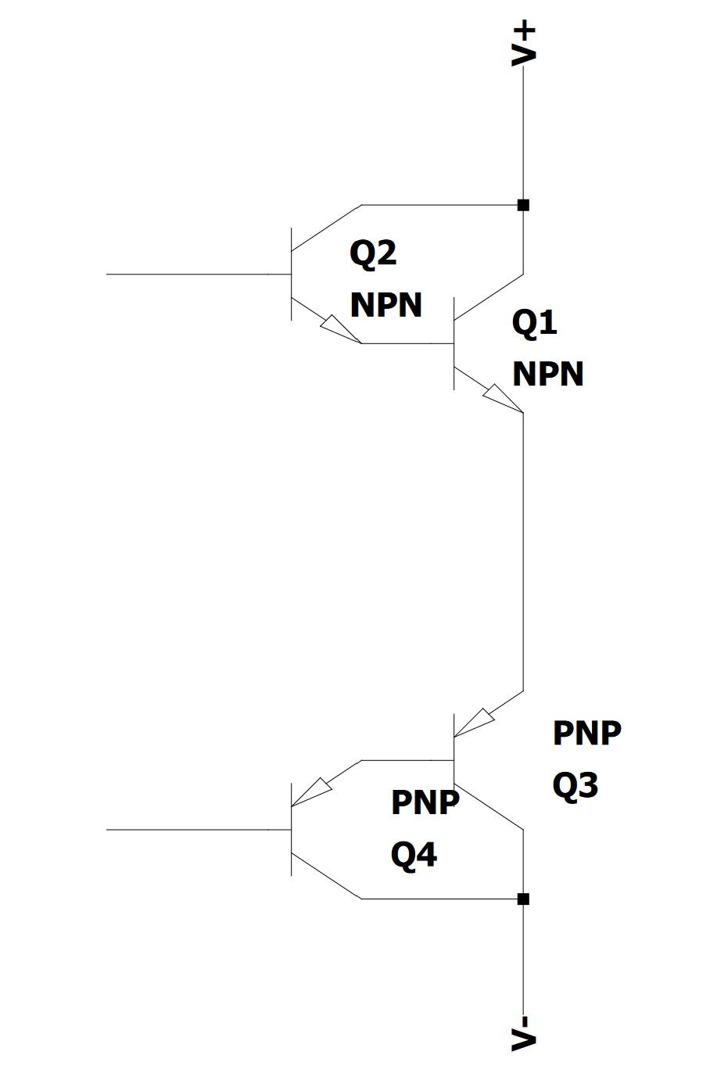
figures/system_design/darlington_coupling/darlington_coupling.png
