Niclasapdk/ESD4_project/figures/system_design/darlington_mj110_schematic.png

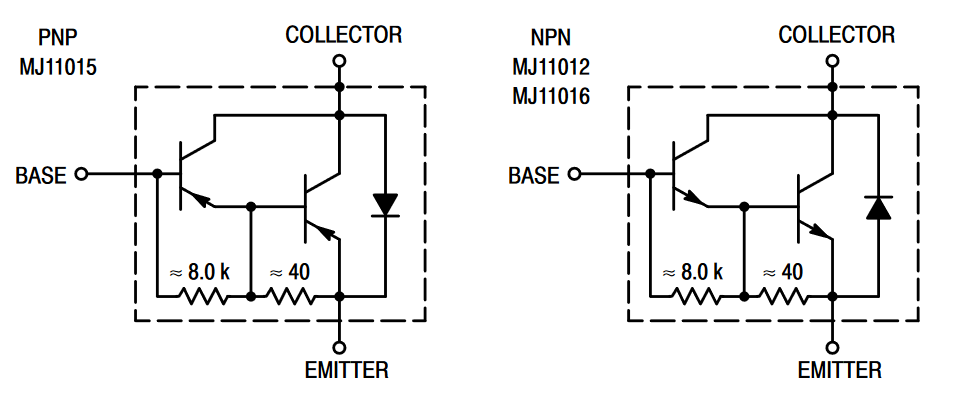
figures/system_design/darlington_mj110_schematic.png
