Niclasapdk/ESD4_project/figures/system_design/equalizer/equaliserMax.png

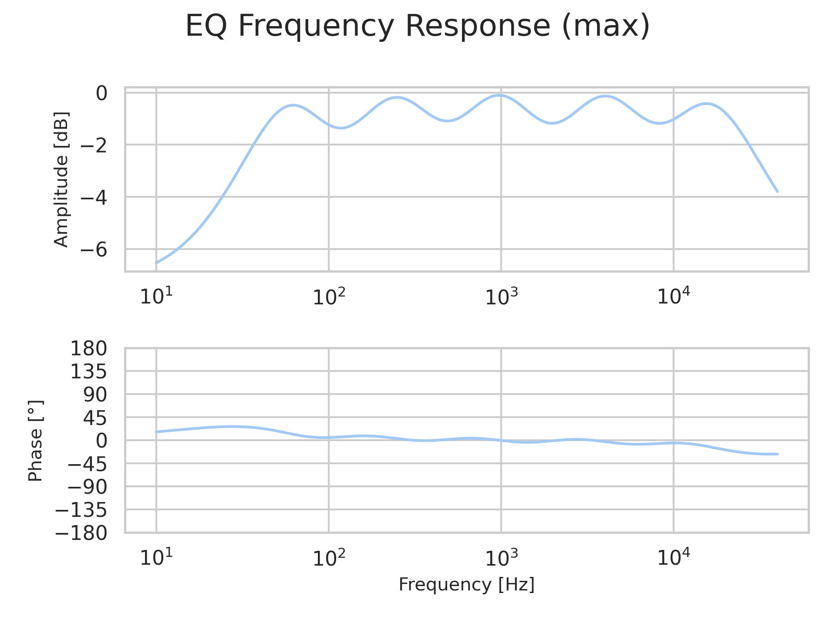
figures/system_design/equalizer/equaliserMax.png
