Niclasapdk/ESD4_project/figures/system_design/equalizer/equaliserMin.png

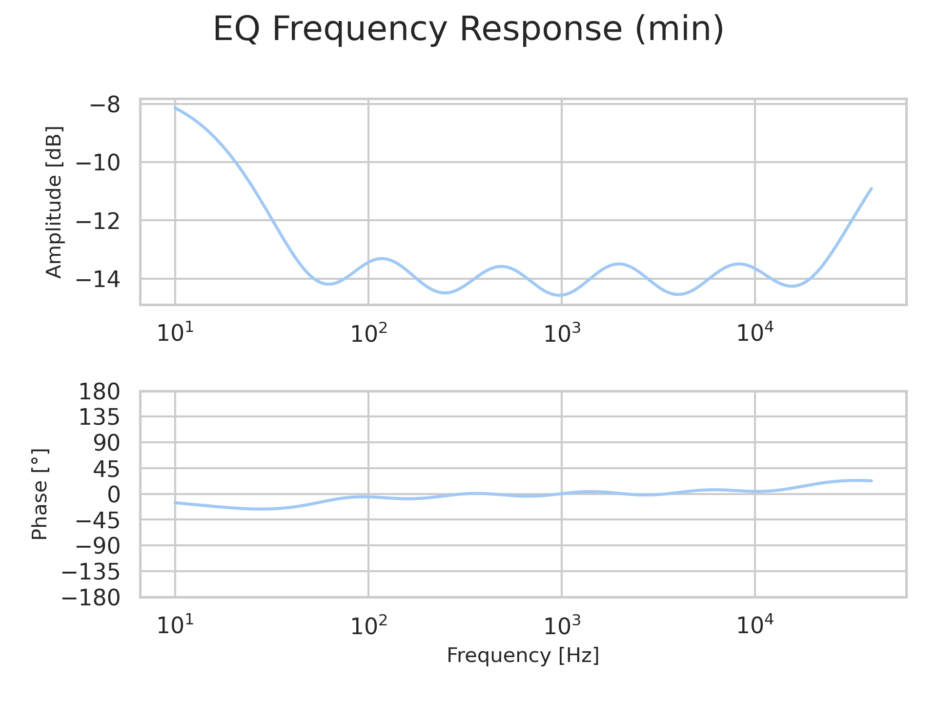
figures/system_design/equalizer/equaliserMin.png
