Niclasapdk/ESD4_project/figures/system_design/equalizer/Phaseplot.png

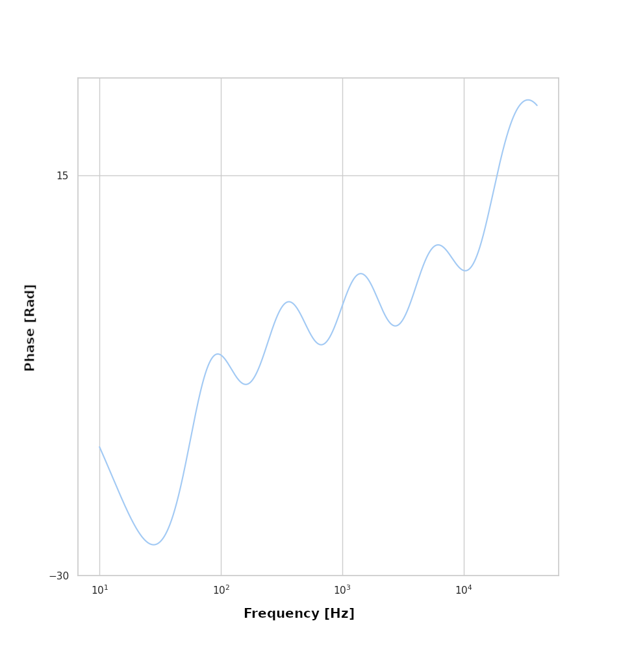
figures/system_design/equalizer/Phaseplot.png
