Niclasapdk/ESD4_project/figures/system_design/equalizer/topologyEqualizer.png

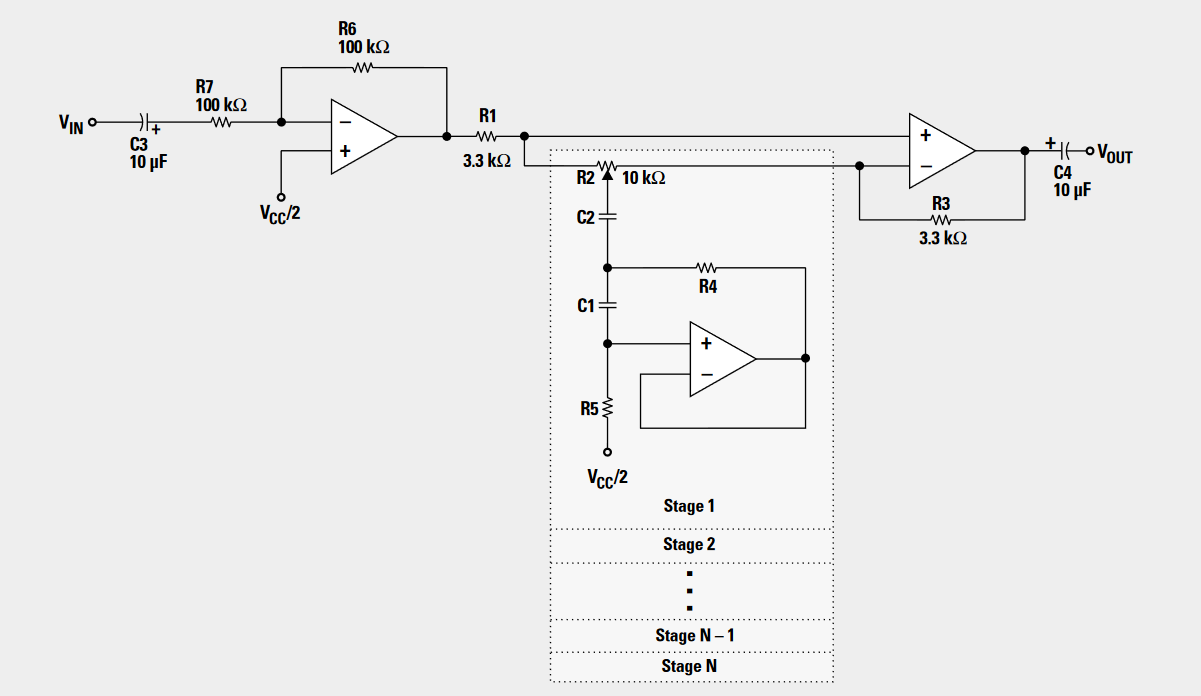
figures/system_design/equalizer/topologyEqualizer.png
