Niclasapdk/ESD4_project/figures/system_design/feedback_system/feedback_system.png

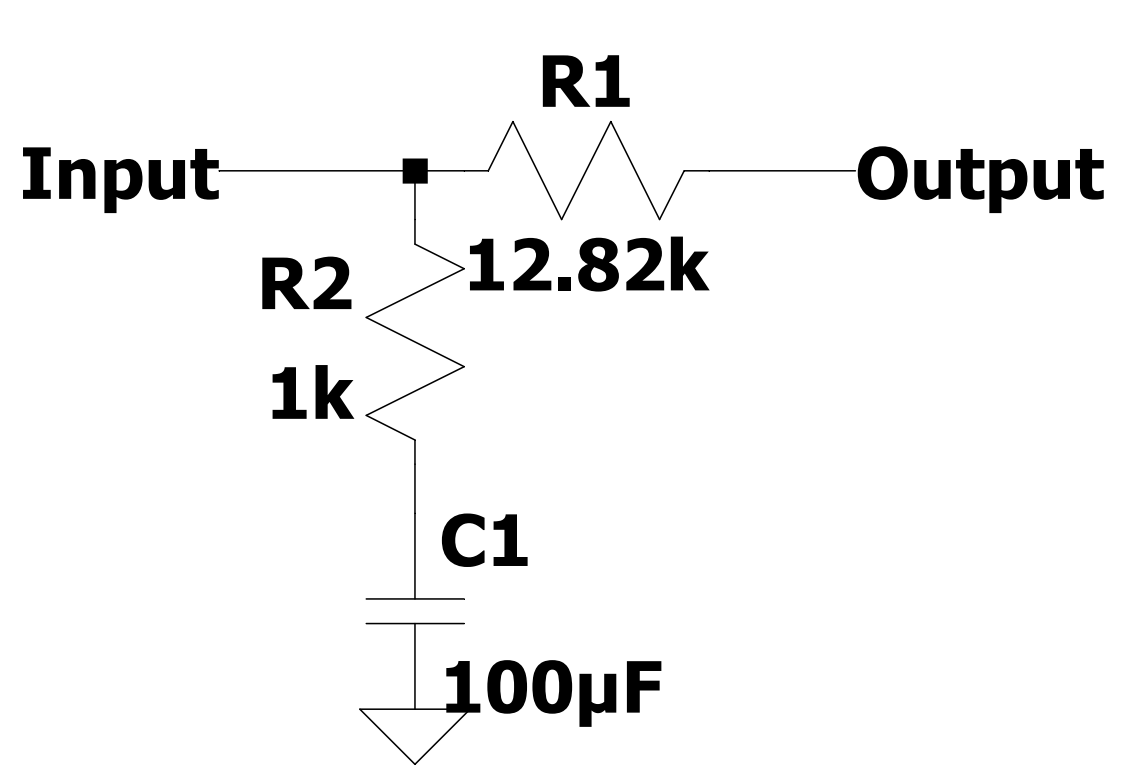
figures/system_design/feedback_system/feedback_system.png
