Niclasapdk/ESD4_project/figures/system_design/filtering/sallen_key_hp_lp.png

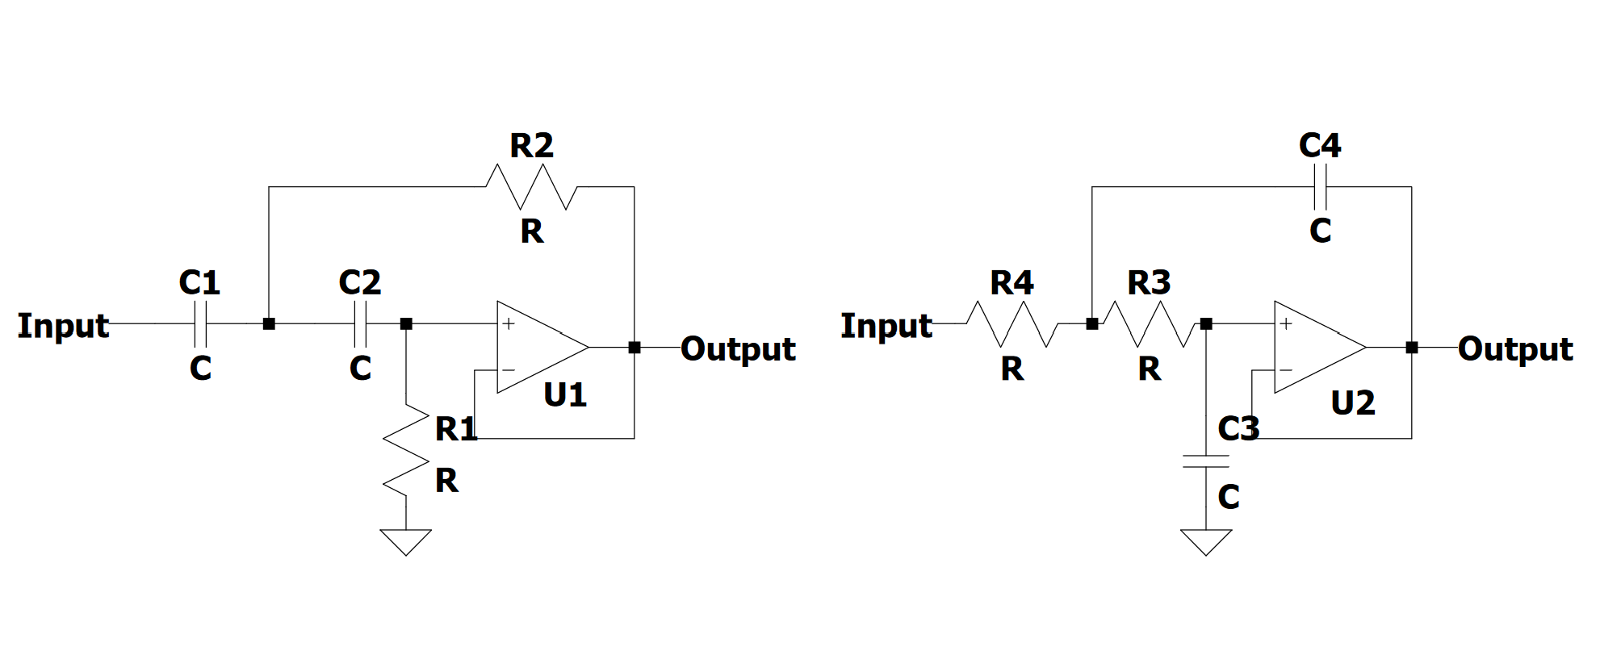
figures/system_design/filtering/sallen_key_hp_lp.png
