Niclasapdk/ESD4_project/figures/system_design/final_pa/final_pa.png

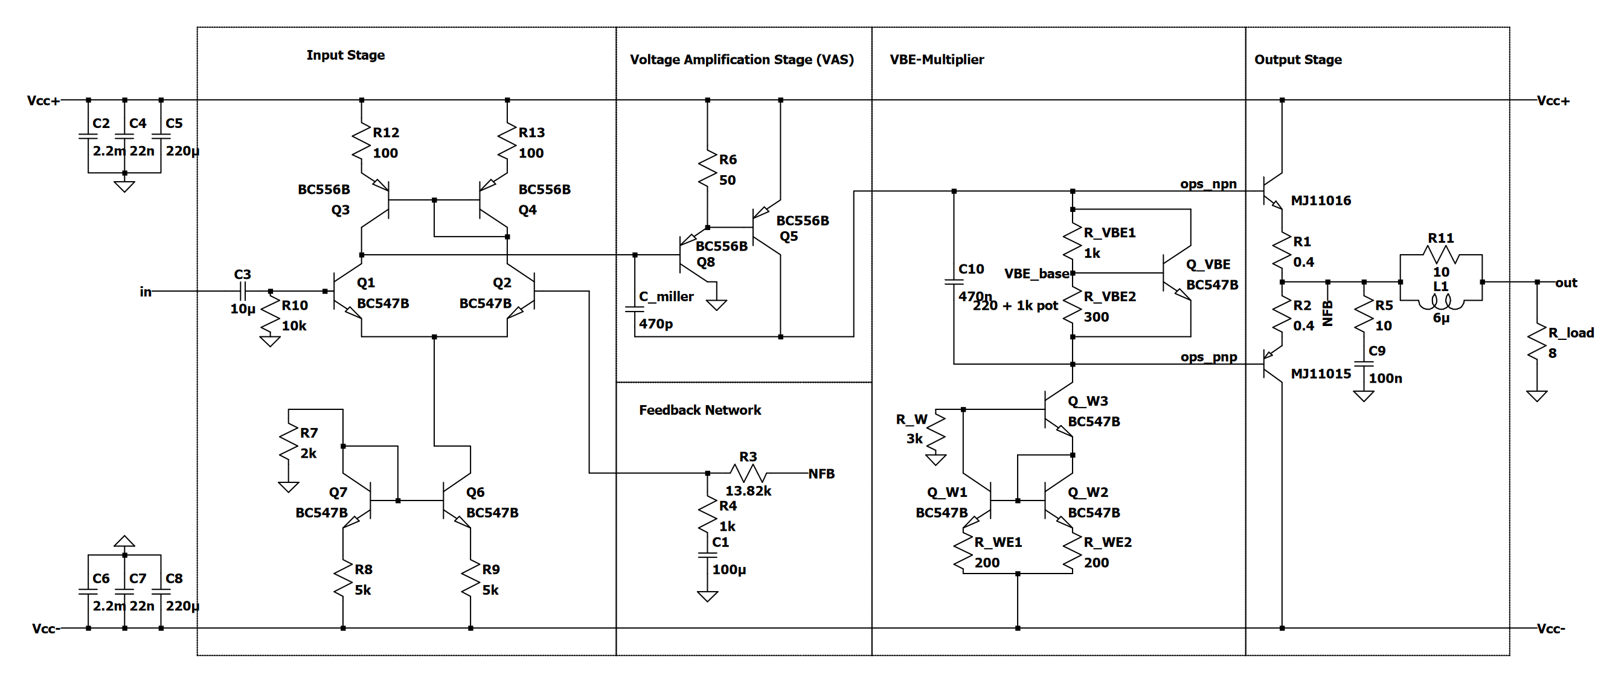
figures/system_design/final_pa/final_pa.png
