Niclasapdk/ESD4_project/figures/system_design/final_pa_topology/final_topology_pa.png

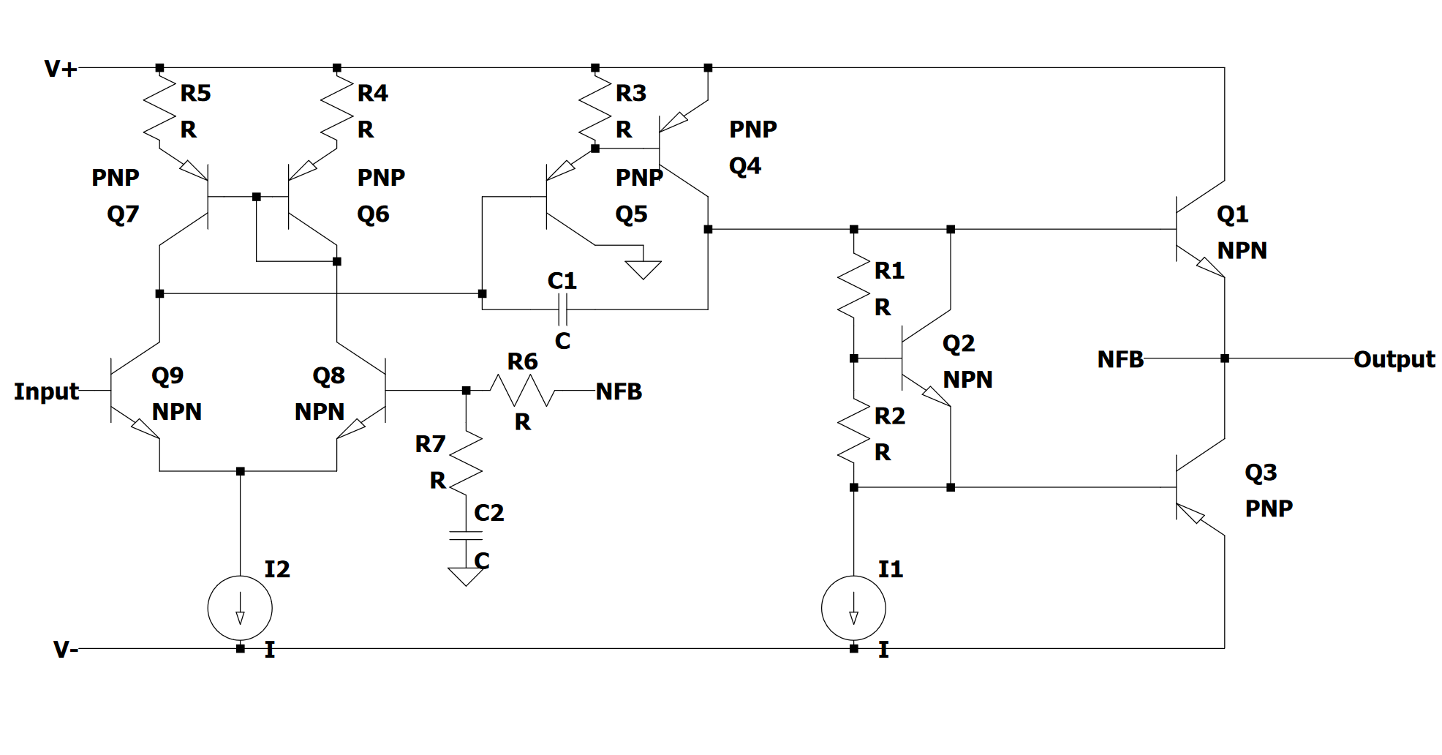
figures/system_design/final_pa_topology/final_topology_pa.png
