Niclasapdk/ESD4_project/figures/system_design/input_stage_pa/input_stage_pa.png

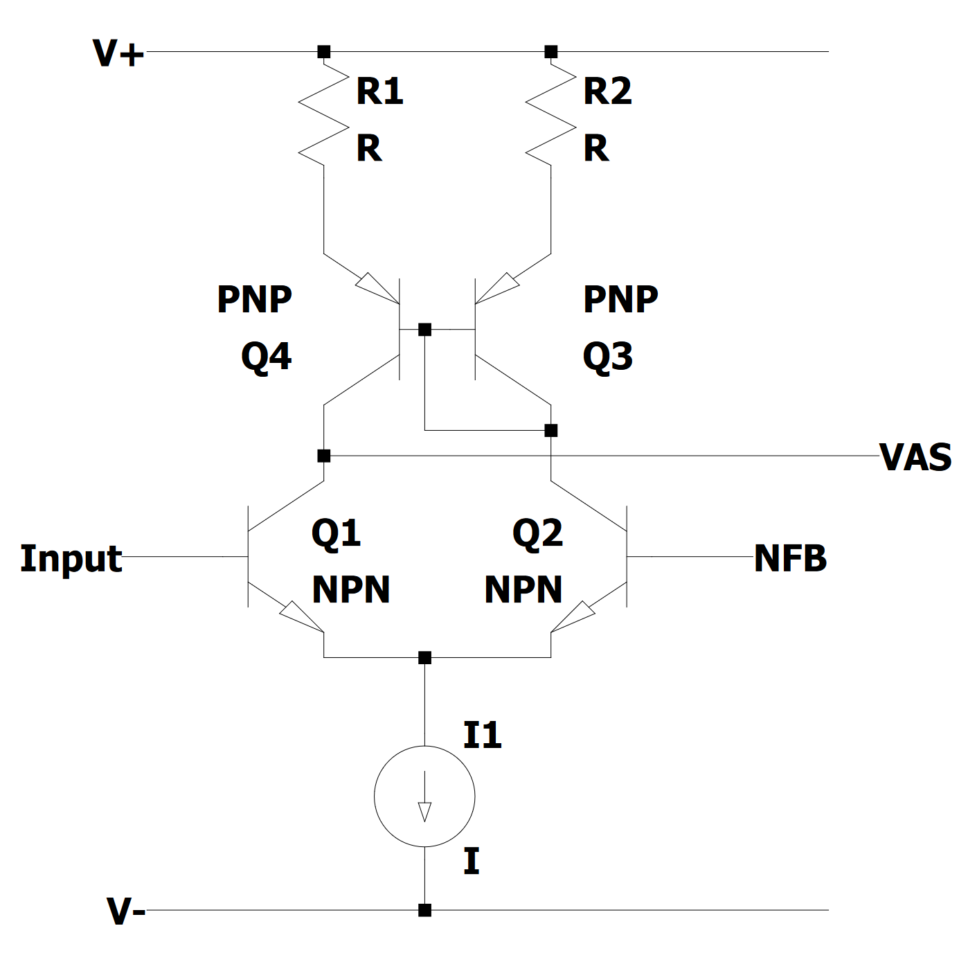
figures/system_design/input_stage_pa/input_stage_pa.png
