Niclasapdk/ESD4_project/figures/system_design/input_stage_with_current_mirror/input_stage_with_current_mirror.png

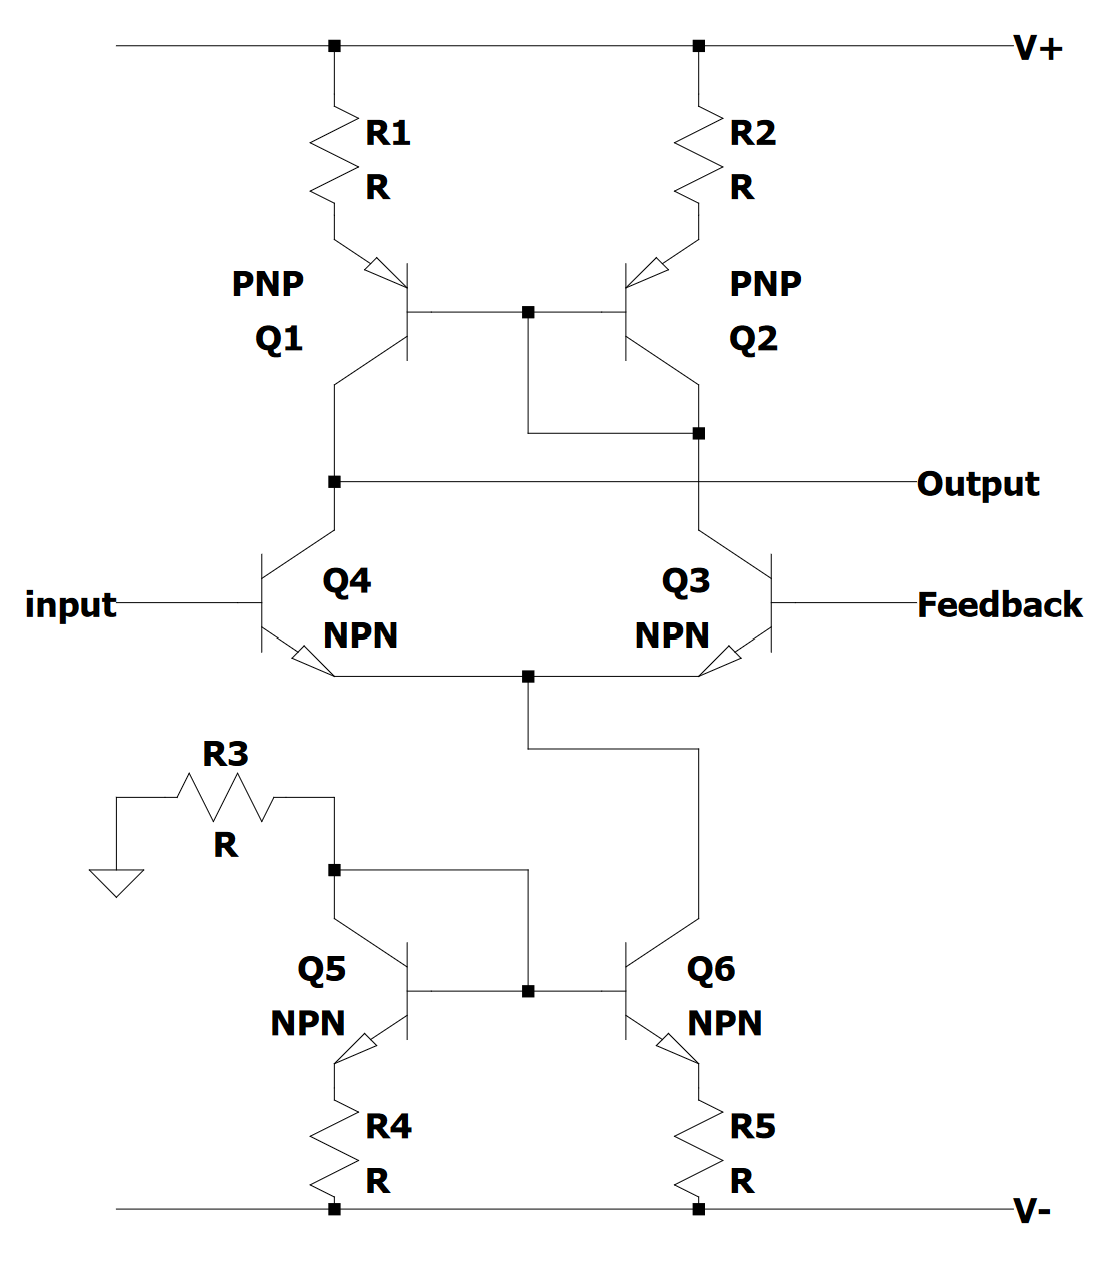
figures/system_design/input_stage_with_current_mirror/input_stage_with_current_mirror.png
