Niclasapdk/ESD4_project/figures/system_design/lm2575_typical_application.png

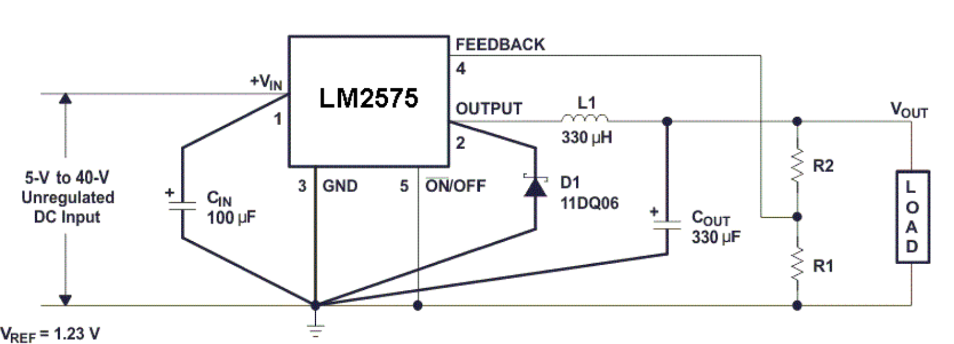
figures/system_design/lm2575_typical_application.png
