Niclasapdk/ESD4_project/figures/system_design/normalized_collector_fig_script.jpg

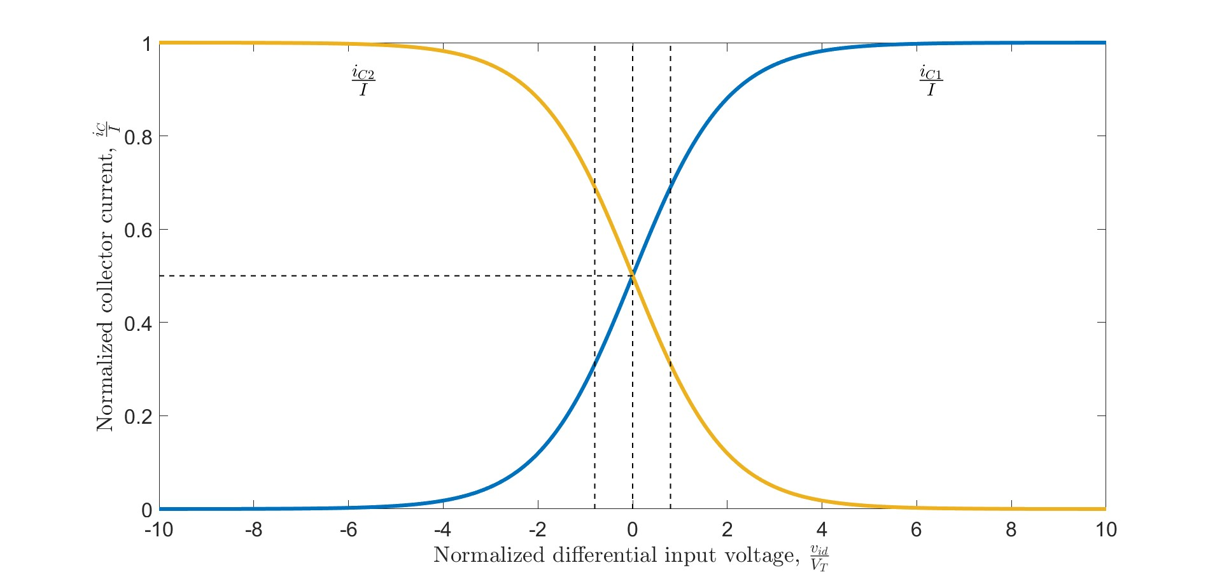
figures/system_design/normalized_collector_fig_script.jpg
