Niclasapdk/ESD4_project/figures/system_design/output_compensation/output_compensation.png

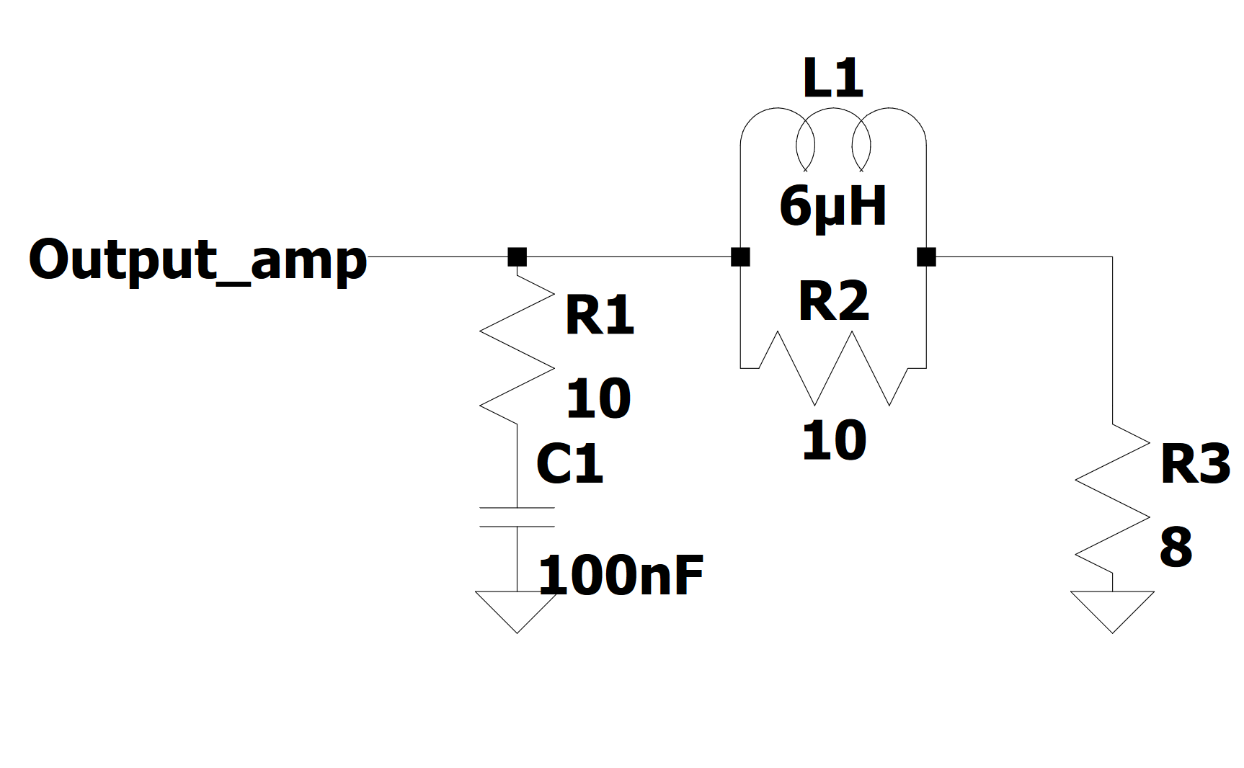
figures/system_design/output_compensation/output_compensation.png
