Niclasapdk/ESD4_project/figures/system_design/output_stage_current_mirror/output_stage_current_mirror.png

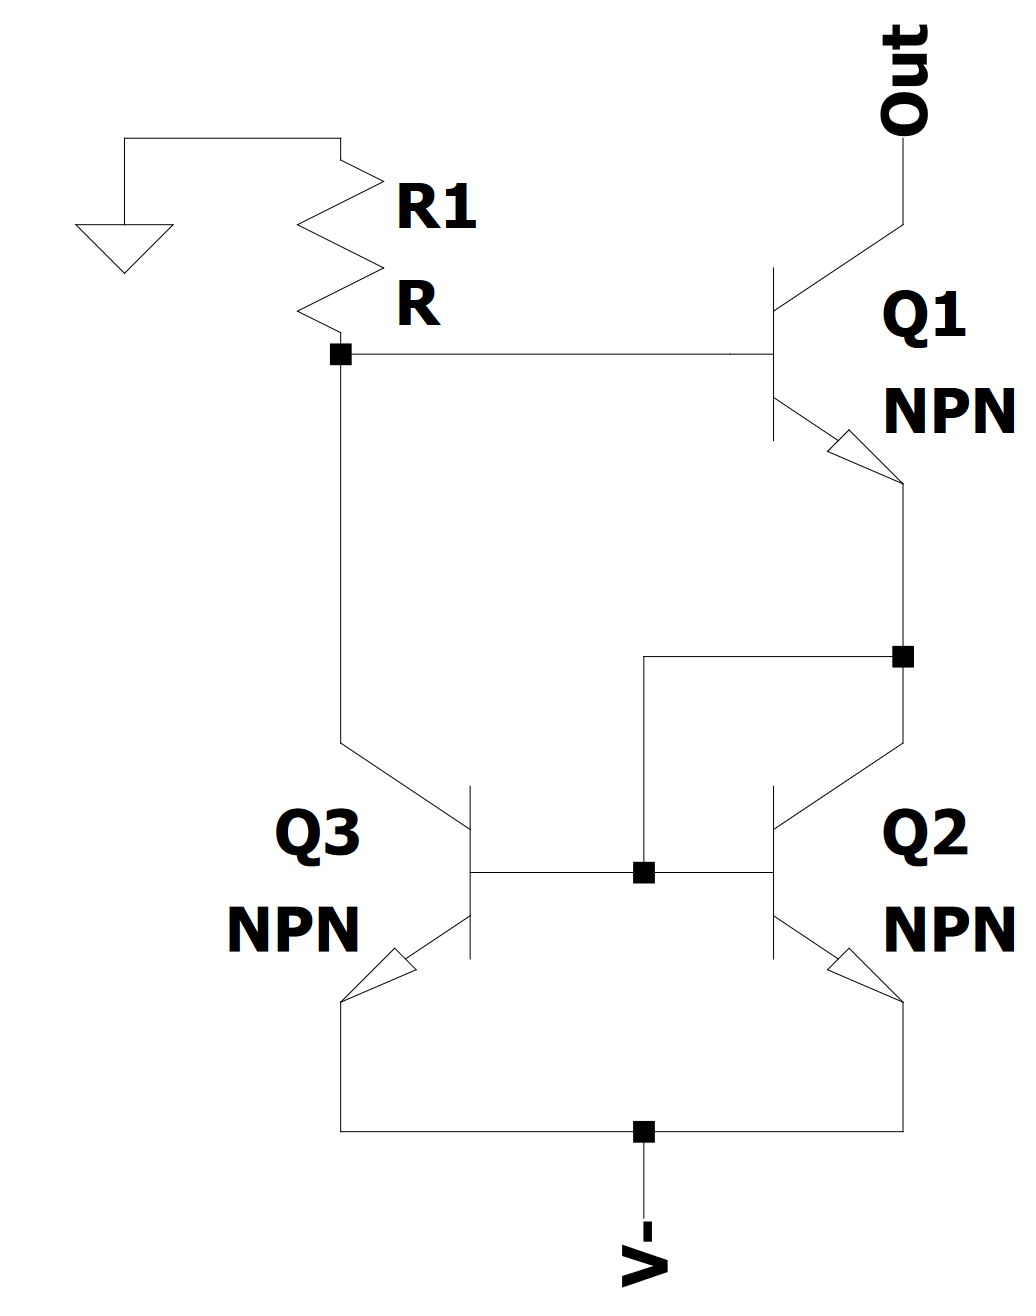
figures/system_design/output_stage_current_mirror/output_stage_current_mirror.png
