Niclasapdk/ESD4_project/figures/system_design/output_stage_pa/negative_feedback_fig.drawio.png

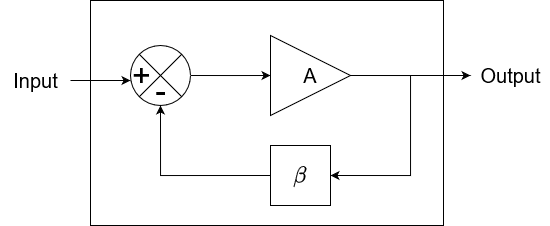
figures/system_design/output_stage_pa/negative_feedback_fig.drawio.png
