Niclasapdk/ESD4_project/figures/system_design/output_stage_pa/output_stage_pa.png

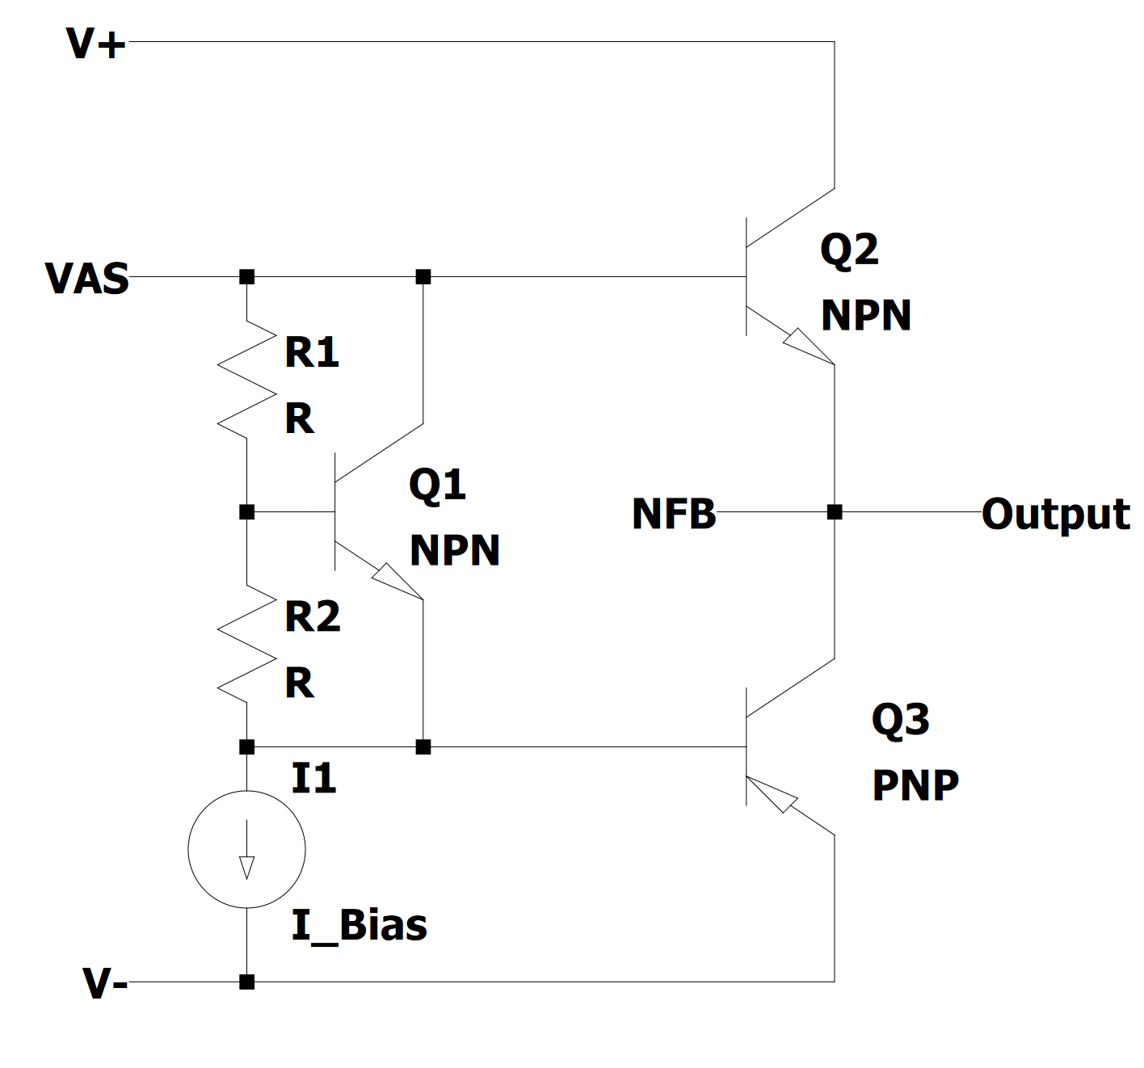
figures/system_design/output_stage_pa/output_stage_pa.png
