Niclasapdk/ESD4_project/figures/system_design/pa_after_theoretical_design/pa_after_theoretical_design.png

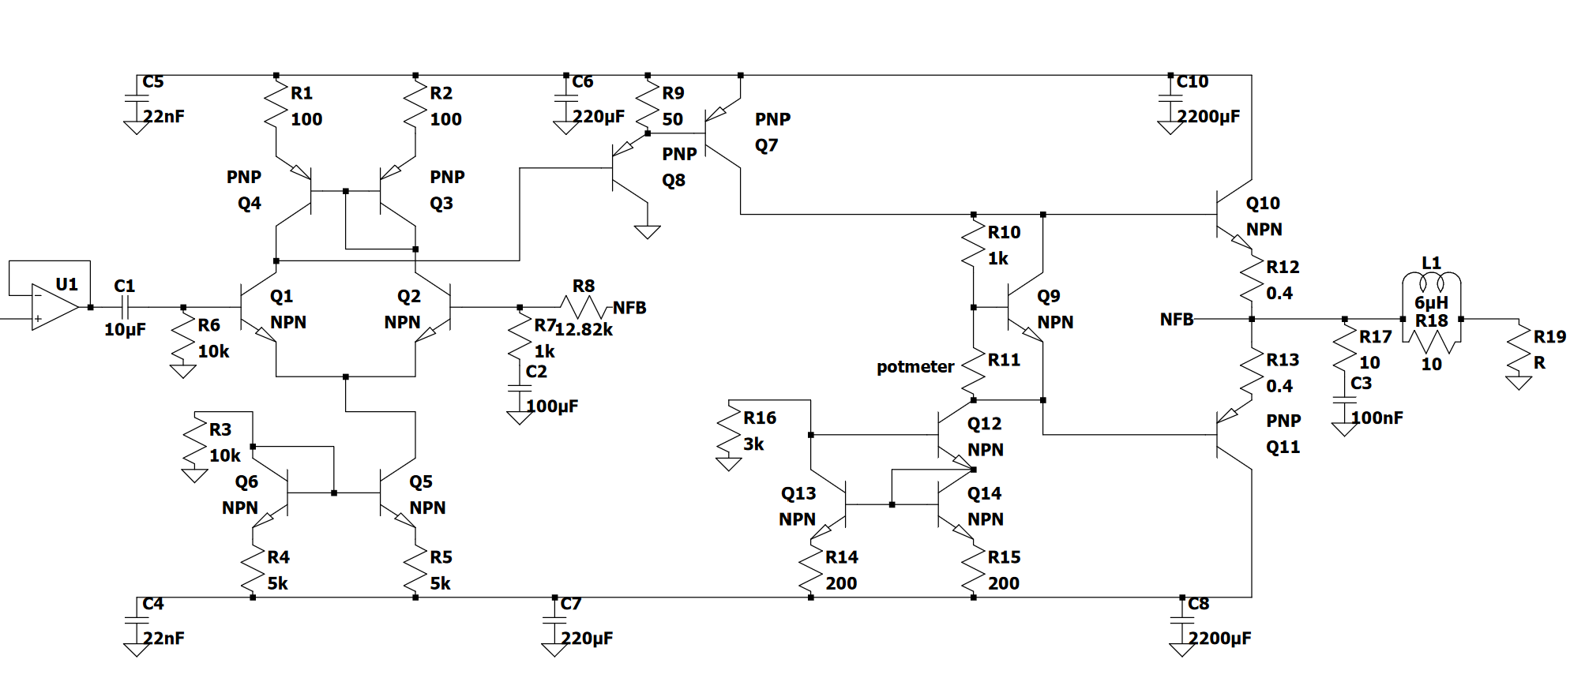
figures/system_design/pa_after_theoretical_design/pa_after_theoretical_design.png
