Niclasapdk/ESD4_project/figures/system_design/pa_stability/closed_loop_transient.png

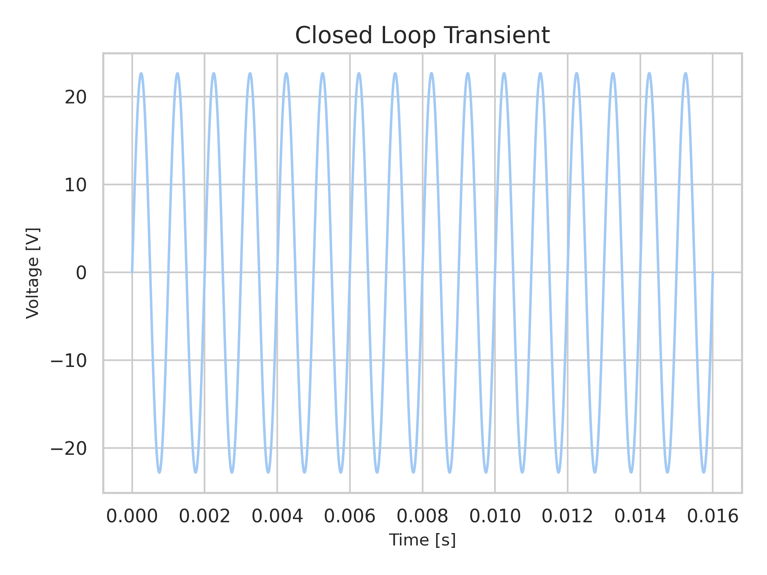
figures/system_design/pa_stability/closed_loop_transient.png
