Niclasapdk/ESD4_project/figures/system_design/pa_stability/closed_loop_with_HF_comp_cap.png

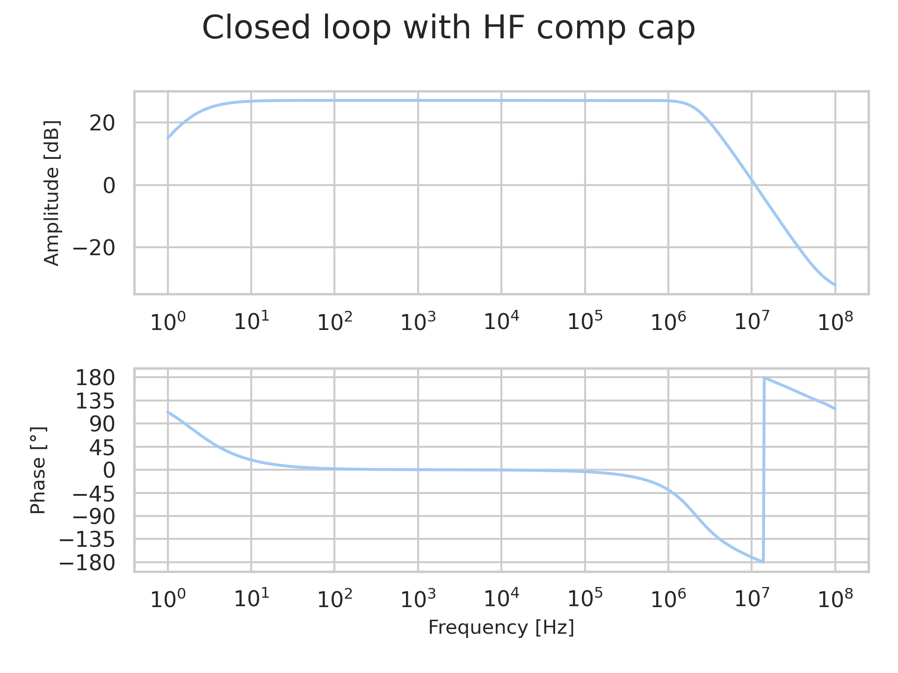
figures/system_design/pa_stability/closed_loop_with_HF_comp_cap.png
