Niclasapdk/ESD4_project/figures/system_design/pa_stability/open_loop_with_miller.png

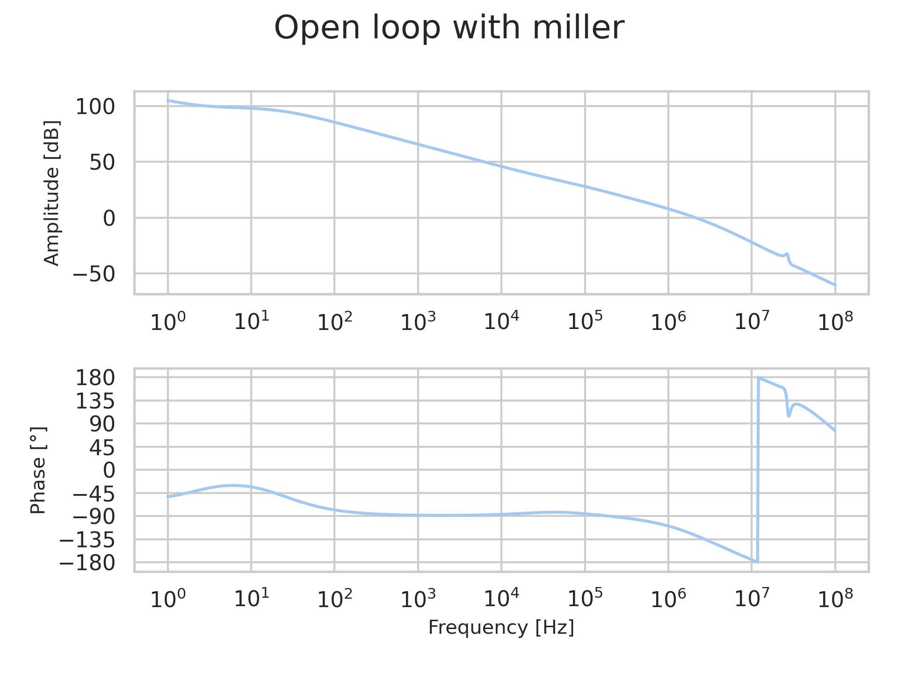
figures/system_design/pa_stability/open_loop_with_miller.png
