Niclasapdk/ESD4_project/figures/system_design/power_supply/switchmode_curcuit.png

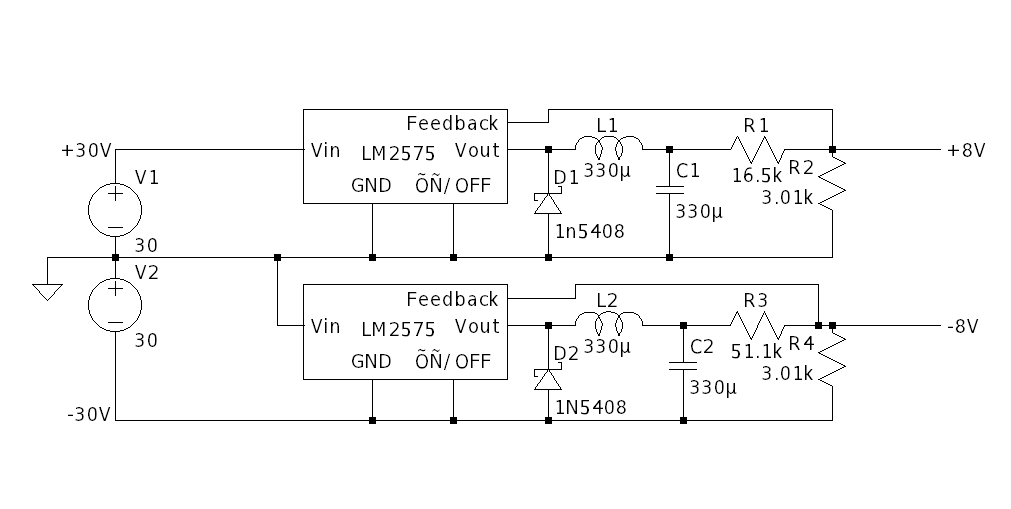
figures/system_design/power_supply/switchmode_curcuit.png
