Niclasapdk/ESD4_project/figures/system_design/riaa_filter_configurations.png

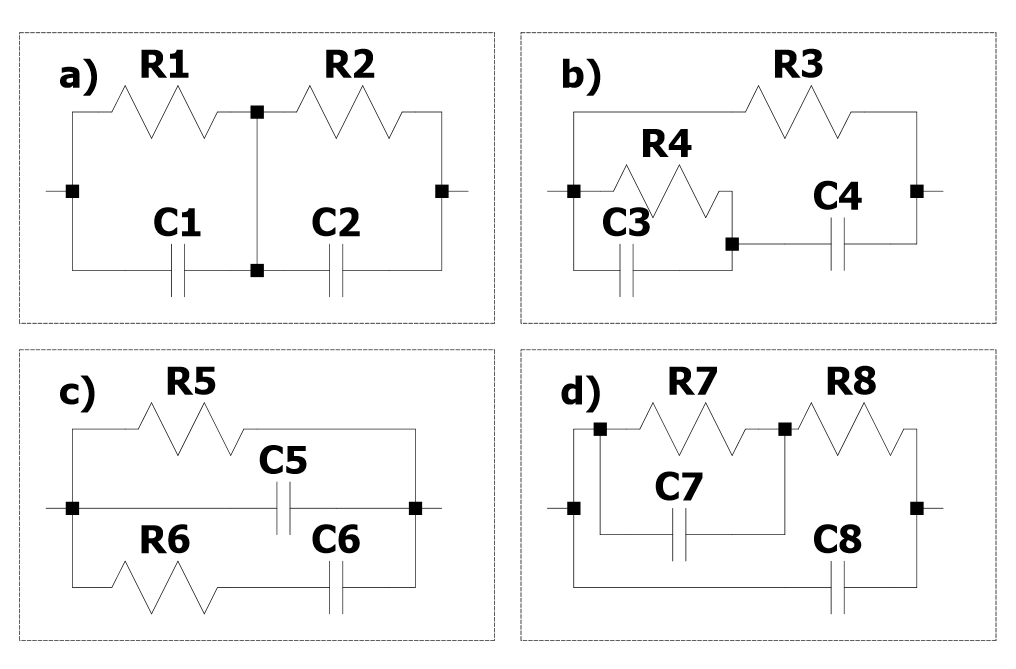
figures/system_design/riaa_filter_configurations.png
