Niclasapdk/ESD4_project/figures/system_design/riaa_preamp/complete_riaa_topology.png

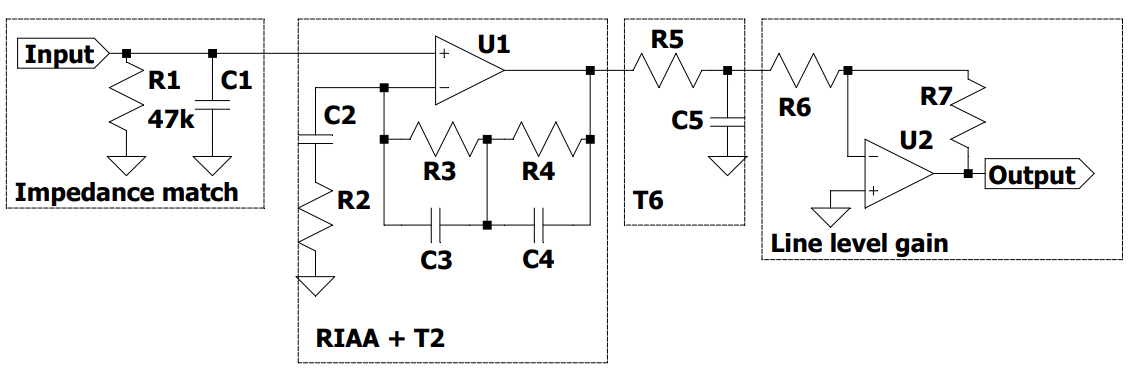
figures/system_design/riaa_preamp/complete_riaa_topology.png
