Niclasapdk/ESD4_project/figures/system_design/riaa_preamp/riaa_de-emphasis_circuit.png

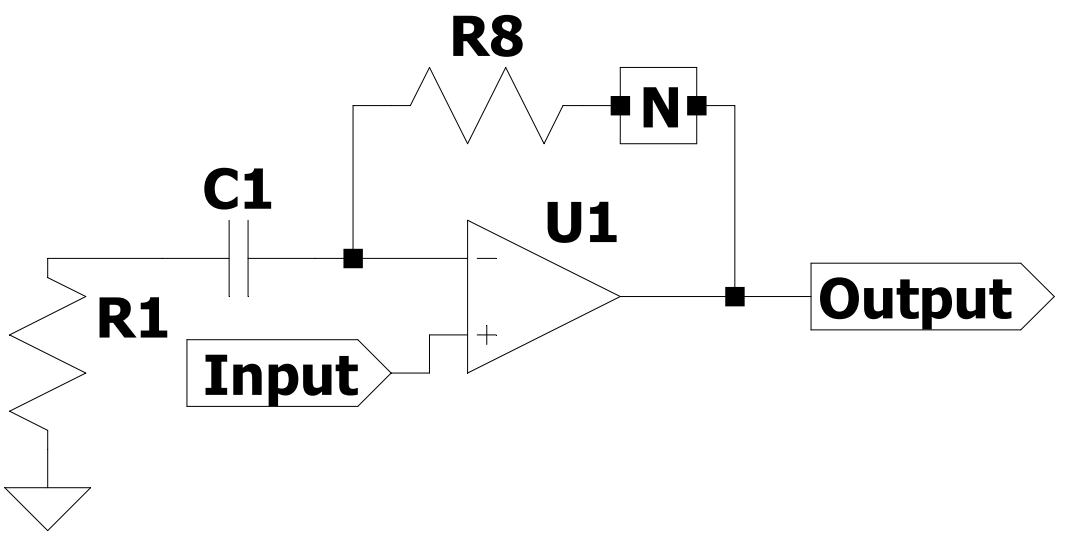
figures/system_design/riaa_preamp/riaa_de-emphasis_circuit.png
