Niclasapdk/ESD4_project/figures/system_design/riaa_preamp/riaa_simulated_tf.jpg

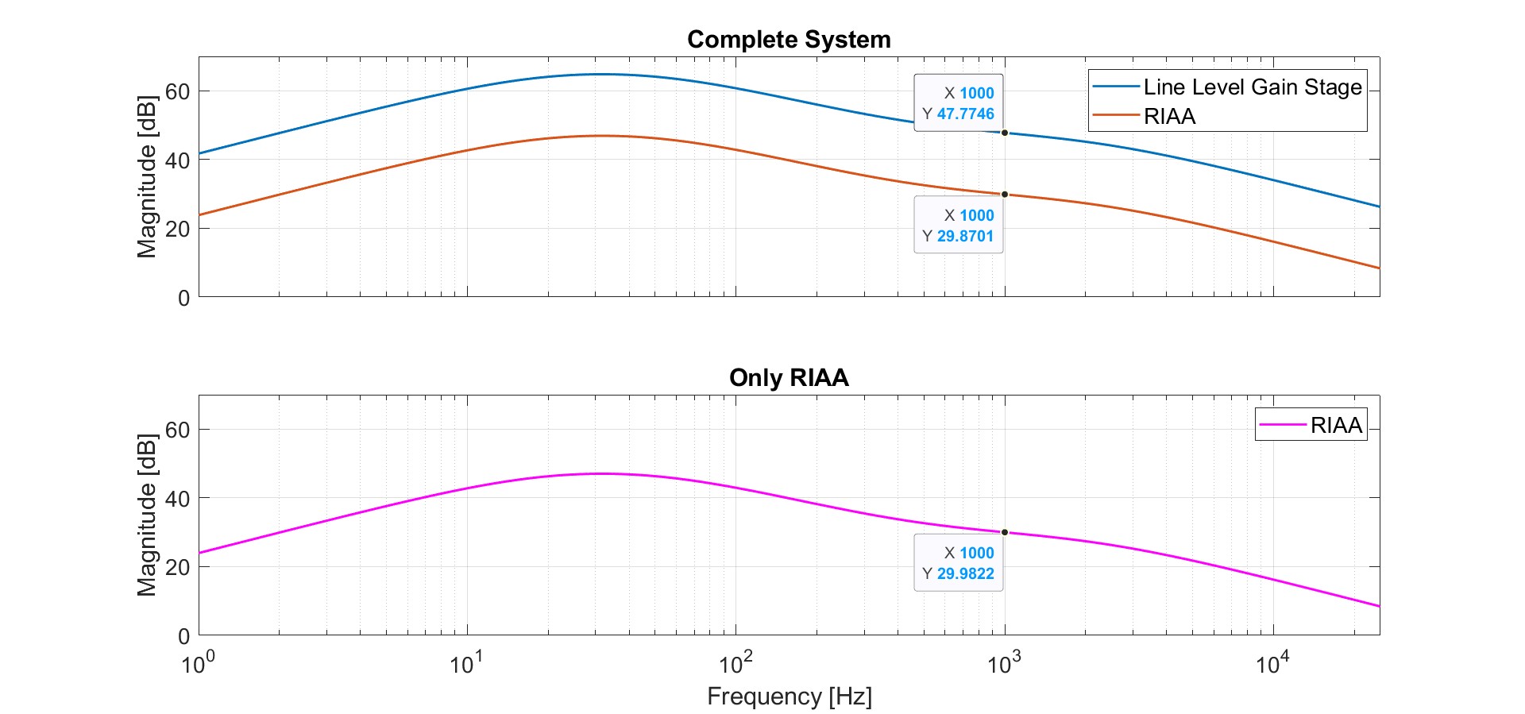
figures/system_design/riaa_preamp/riaa_simulated_tf.jpg
