Niclasapdk/ESD4_project/figures/system_design/riaa_preamp/rlc_hp_lp_schematic.png

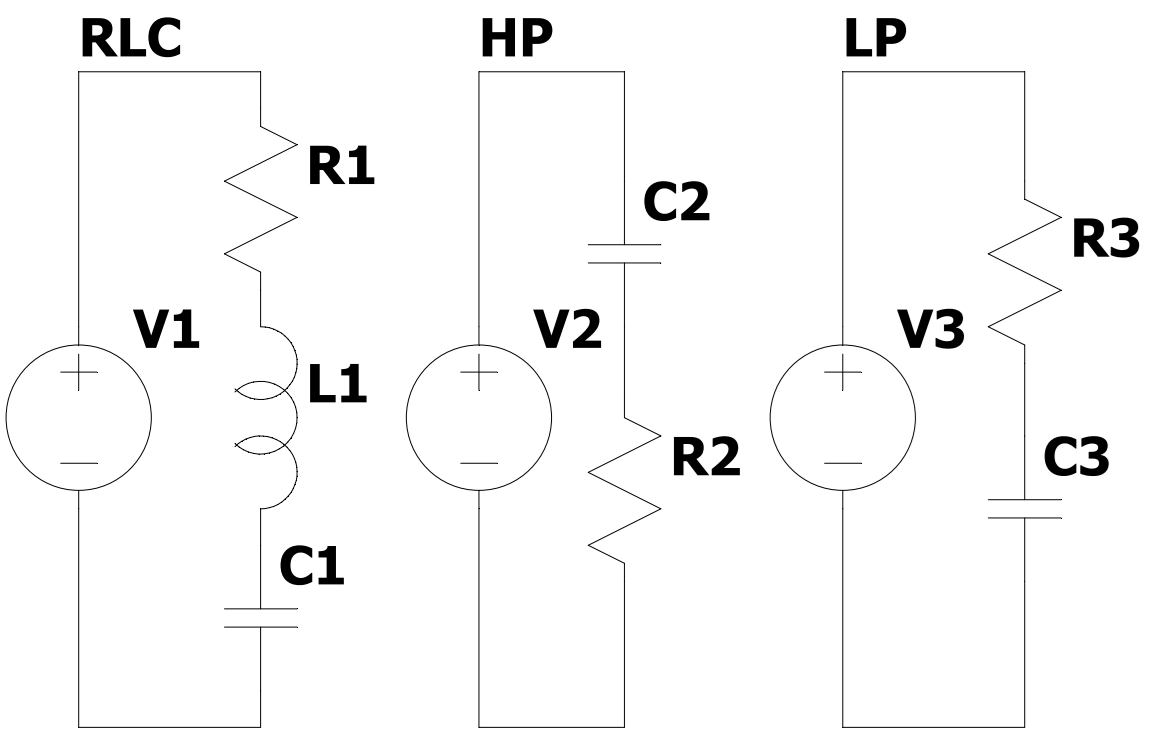
figures/system_design/riaa_preamp/rlc_hp_lp_schematic.png
