Niclasapdk/ESD4_project/figures/system_design/riaa_preamp/transfer_function_riaa.png

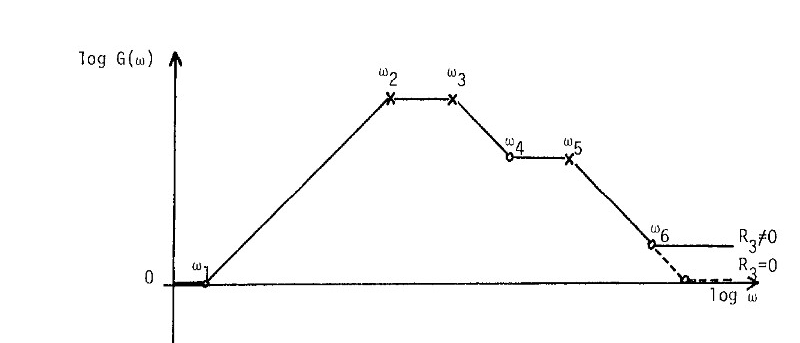
figures/system_design/riaa_preamp/transfer_function_riaa.png
