Niclasapdk/ESD4_project/figures/system_design/small_signal_figures/differential_stage_small_signal.png

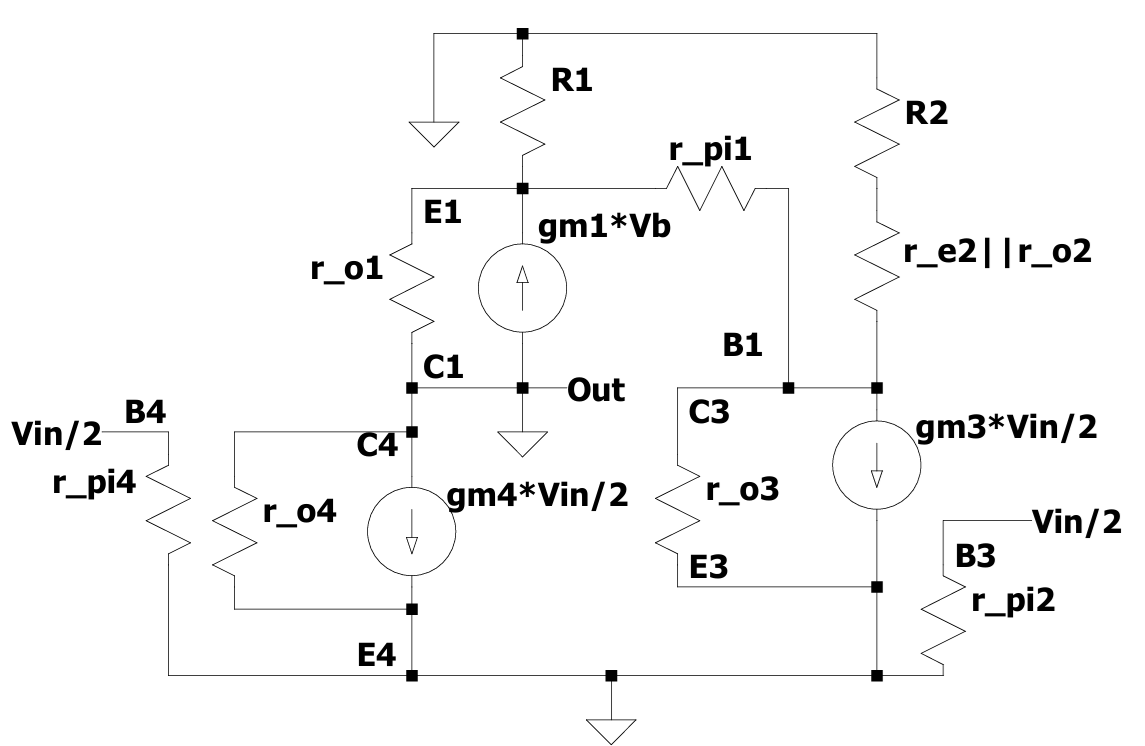
figures/system_design/small_signal_figures/differential_stage_small_signal.png
