Niclasapdk/ESD4_project/figures/system_design/small_signal_figures/npn_darlington_small_signal.png

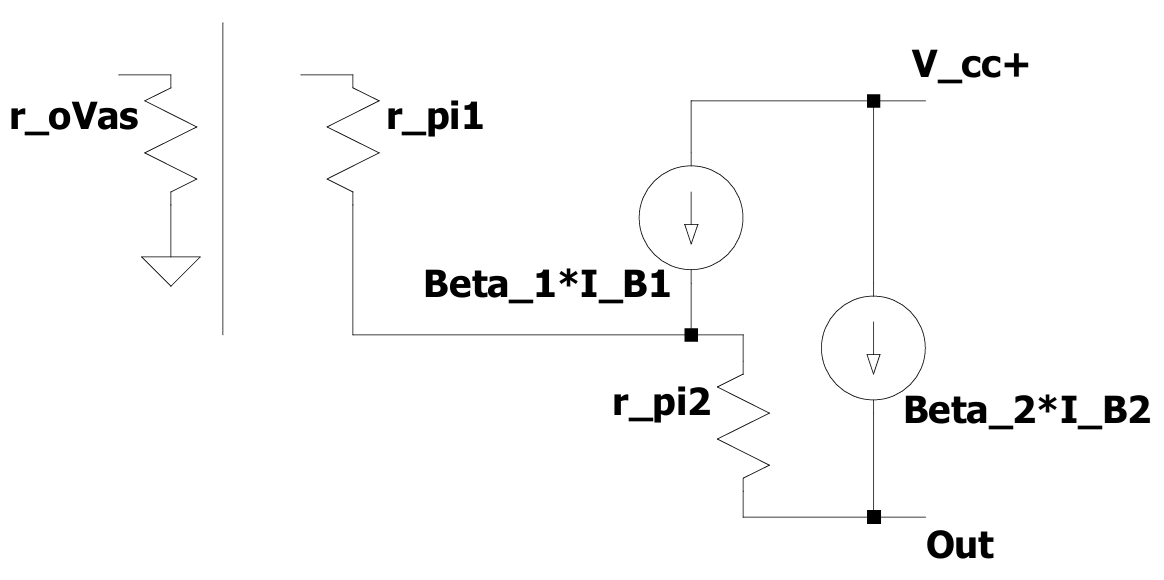
figures/system_design/small_signal_figures/npn_darlington_small_signal.png
