Niclasapdk/ESD4_project/figures/system_design/small_signal_figures/vas_stage_small_signal.png

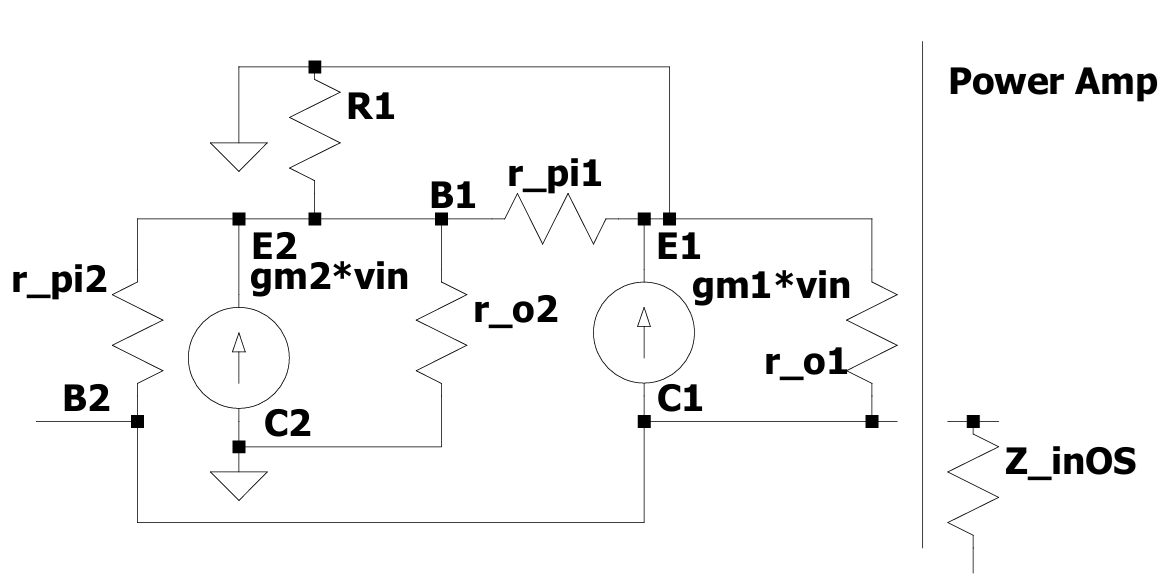
figures/system_design/small_signal_figures/vas_stage_small_signal.png
