Niclasapdk/ESD4_project/figures/system_design/three_stage_pa/three_stage_pa.png

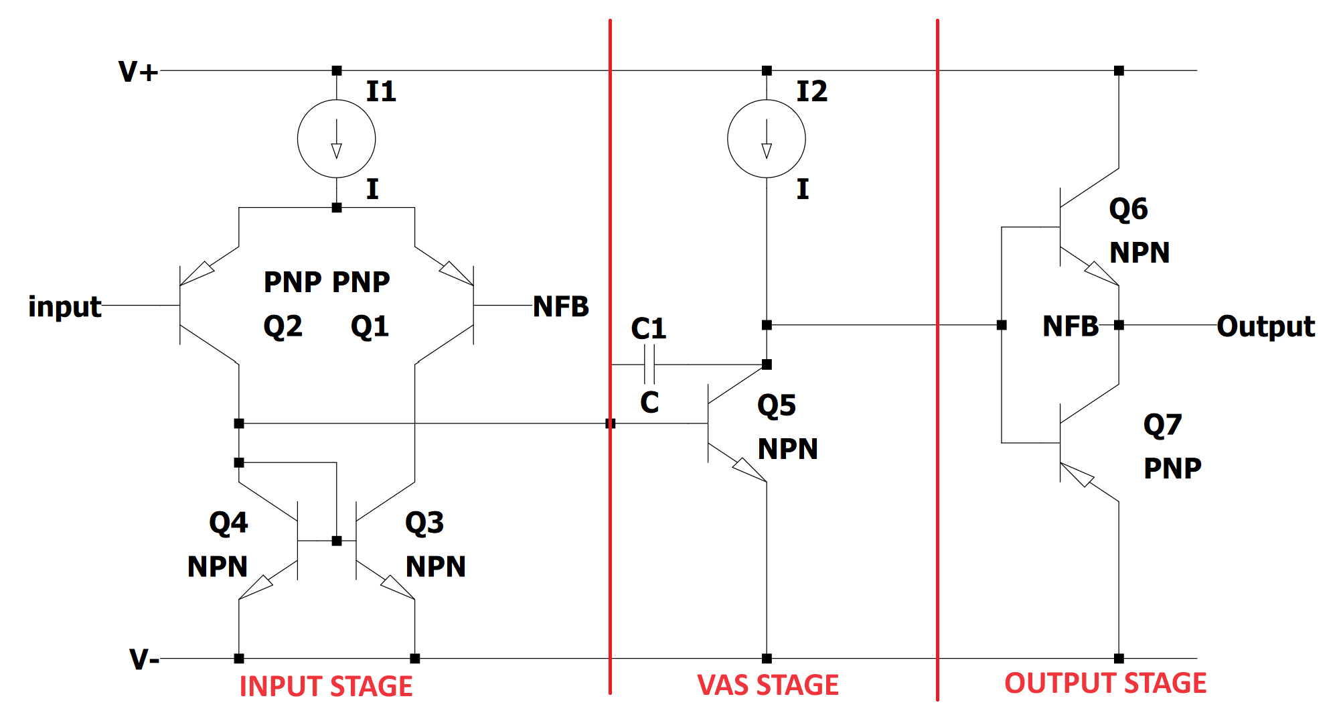
figures/system_design/three_stage_pa/three_stage_pa.png
