Niclasapdk/ESD4_project/figures/system_design/unregulated_powersupply/unregulated_powersupply.png

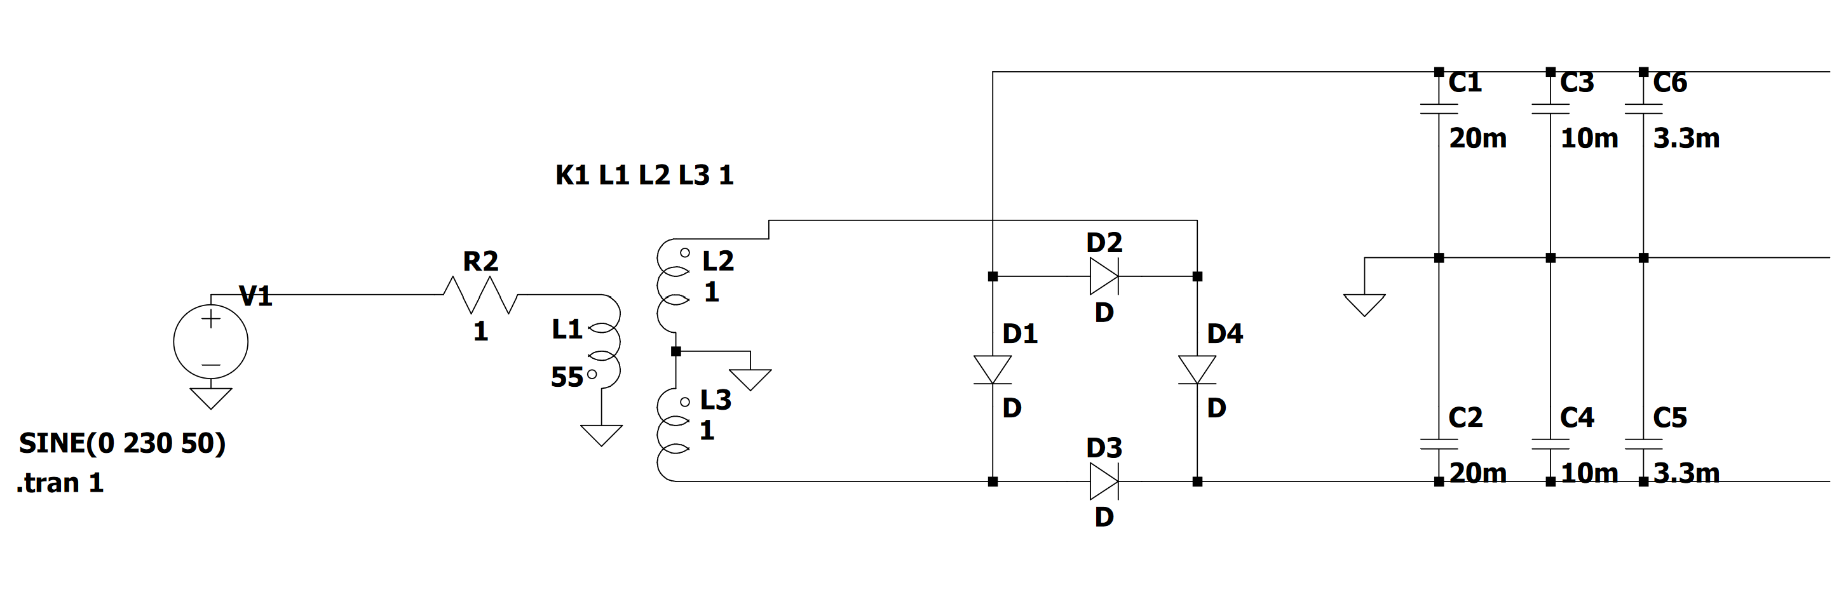
figures/system_design/unregulated_powersupply/unregulated_powersupply.png
