Niclasapdk/ESD4_project/figures/system_design/unregulated_powersupply/unregulated_supply_rails.png

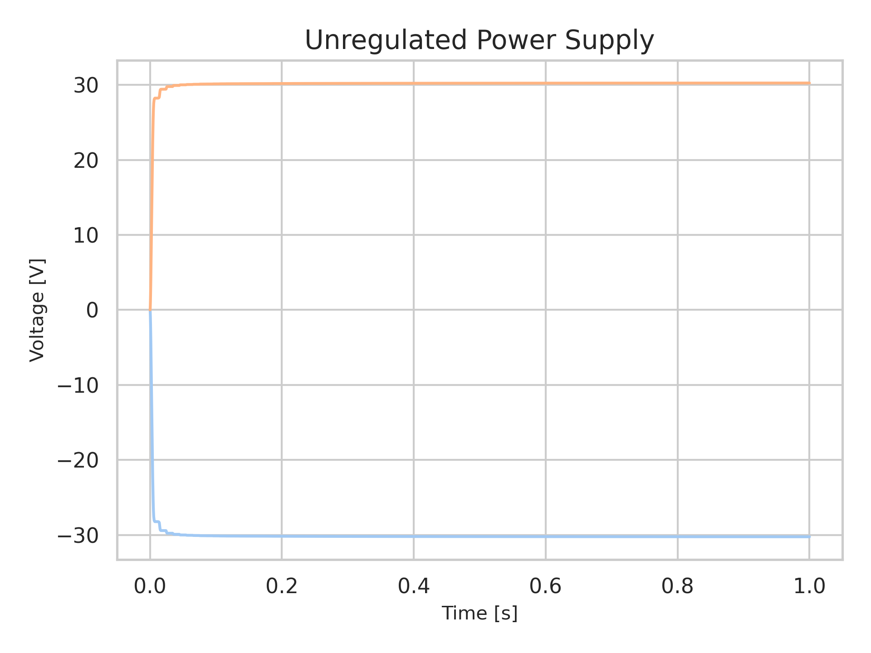
figures/system_design/unregulated_powersupply/unregulated_supply_rails.png
