Niclasapdk/ESD4_project/figures/system_design/vas_stage_pa/vas_stage_pa.png

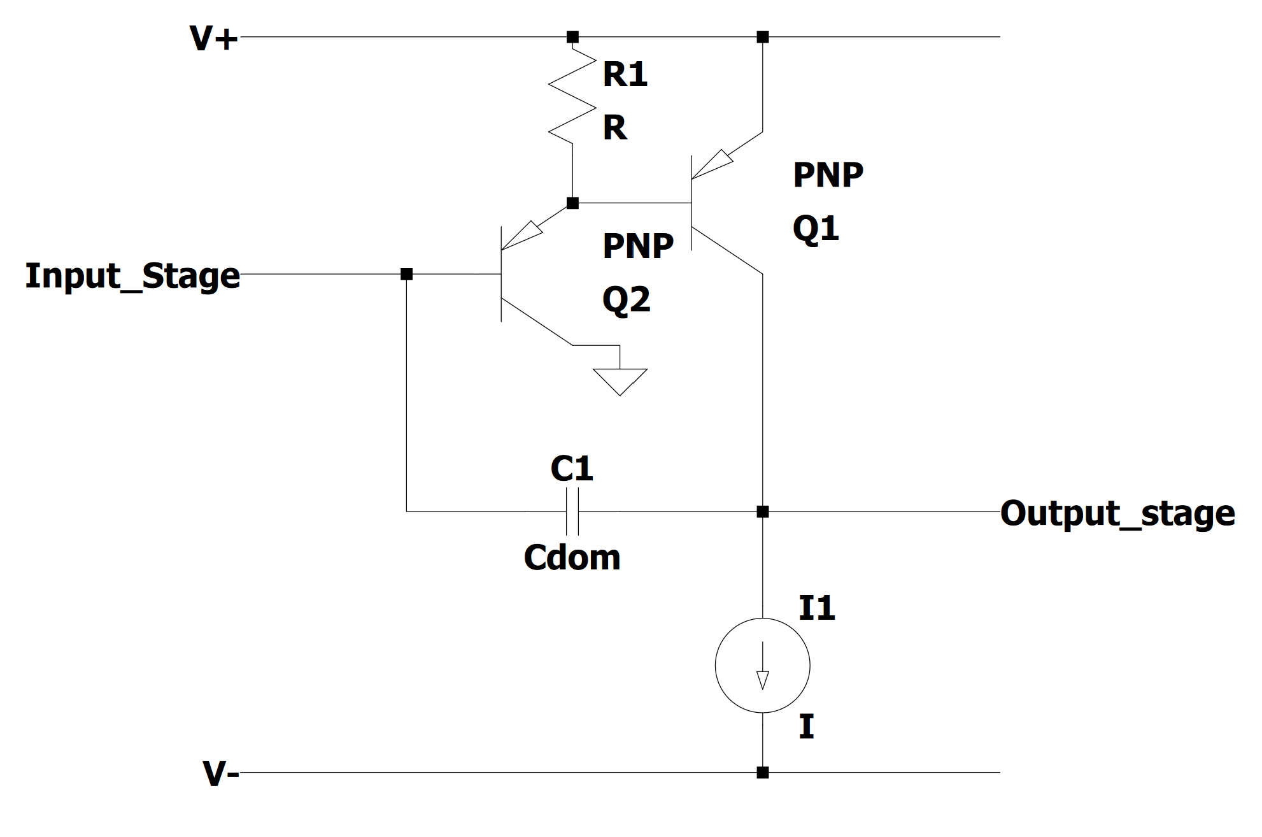
figures/system_design/vas_stage_pa/vas_stage_pa.png
