Niclasapdk/ESD4_project/figures/system_design/voltage_follower/voltage_follower.png

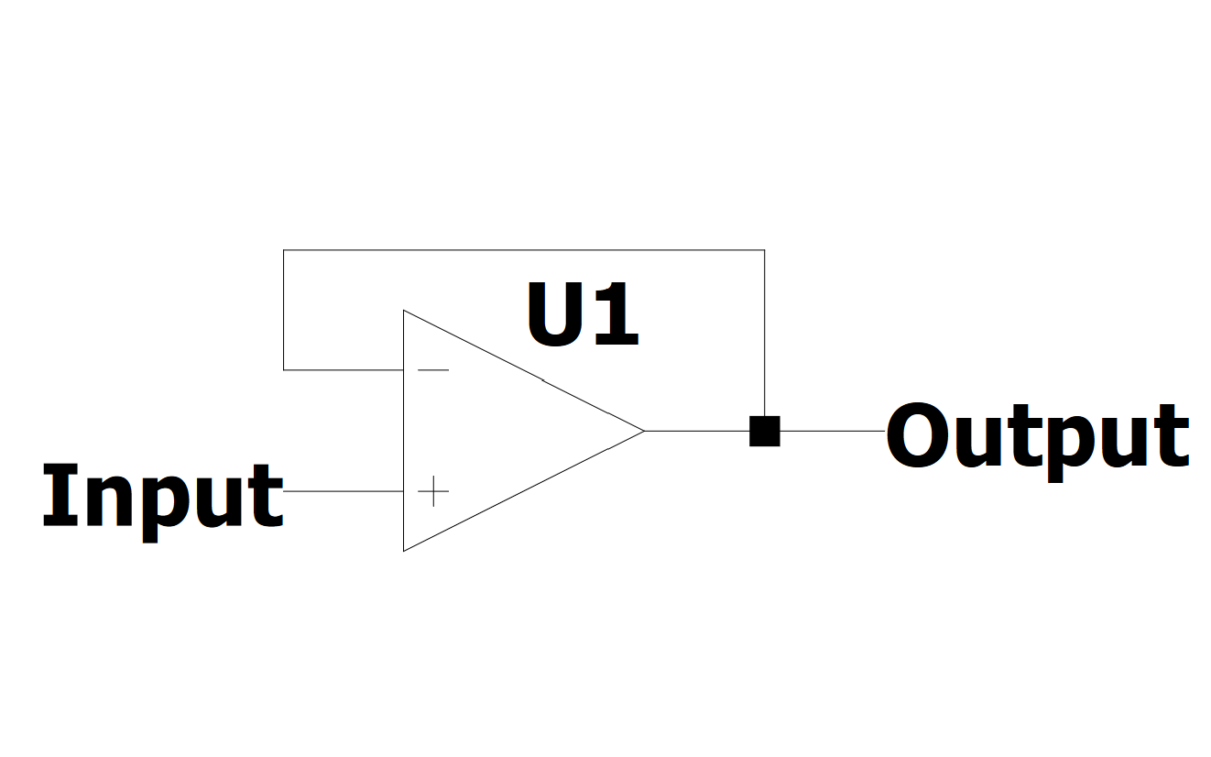
figures/system_design/voltage_follower/voltage_follower.png
