Niclasapdk/ESD4_project/figures/system_design/volume_control/volume_control.png

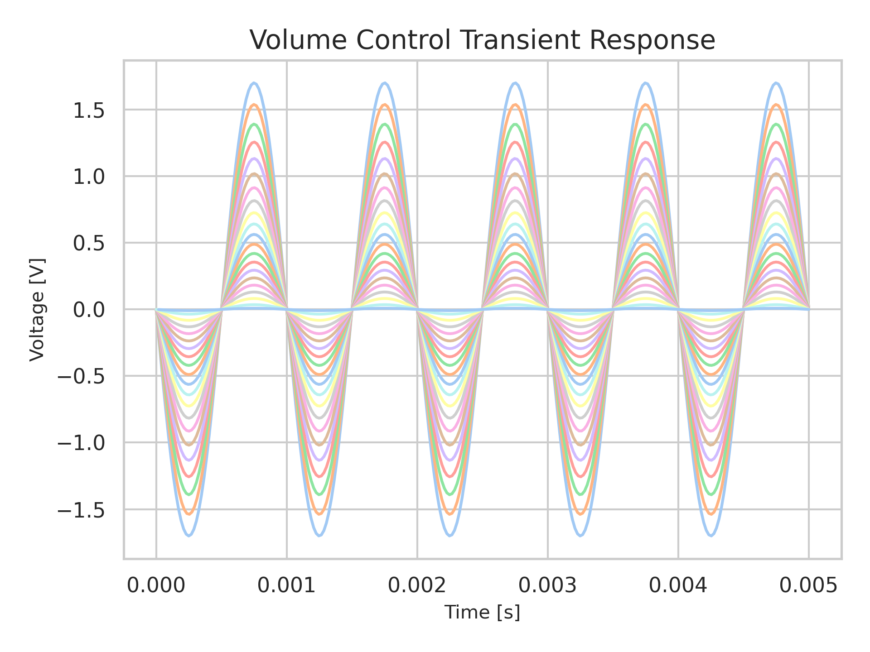
figures/system_design/volume_control/volume_control.png
