Niclasapdk/ESD4_project/figures/technical_analysis/amplifier_classes.png

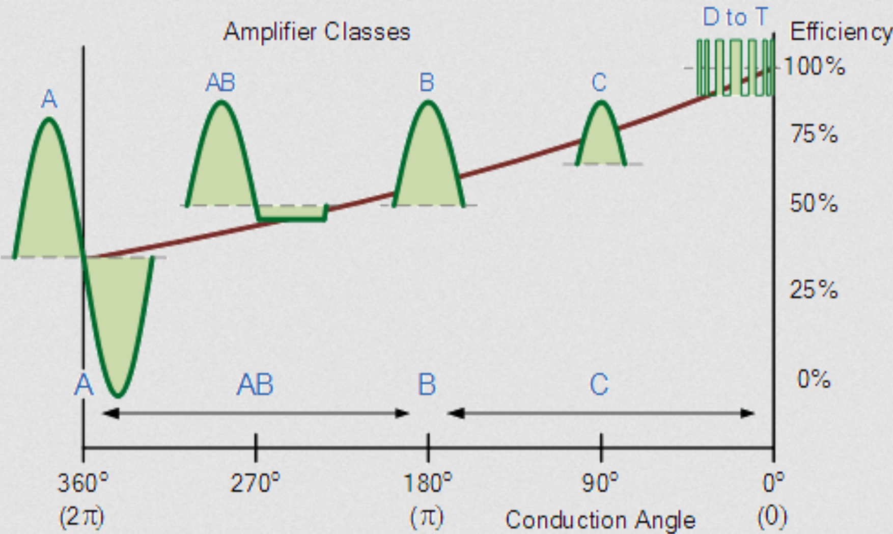
figures/technical_analysis/amplifier_classes.png
