Niclasapdk/ESD4_project/figures/technical_analysis/audio_sound_signal_ex.png

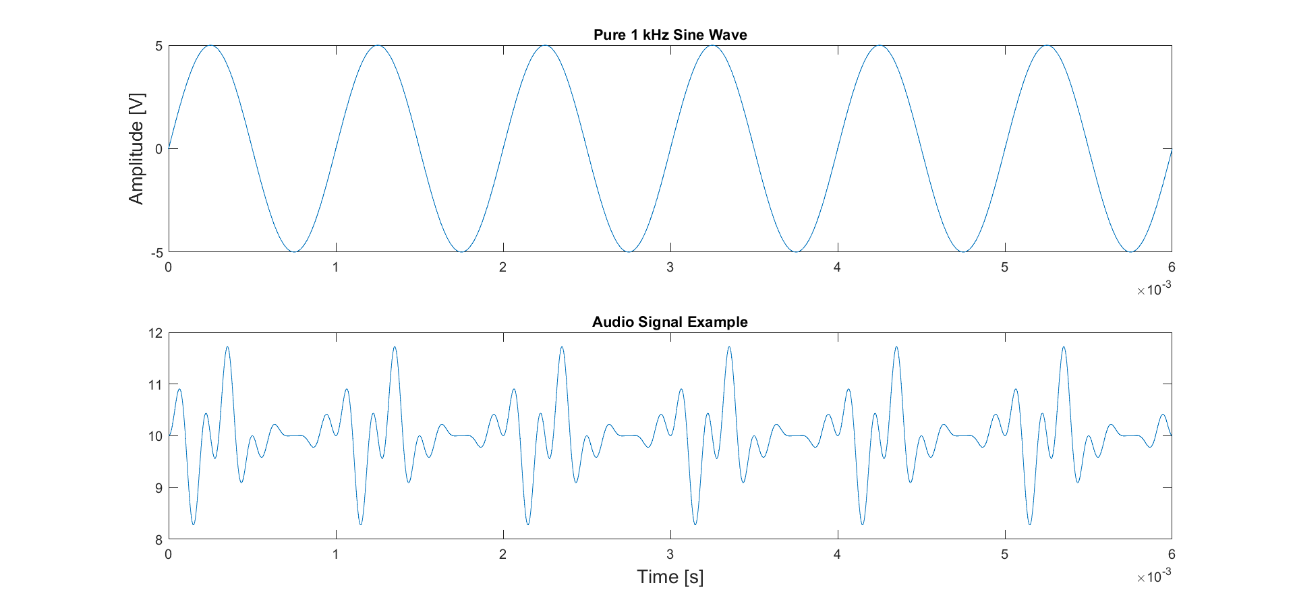
figures/technical_analysis/audio_sound_signal_ex.png
