Niclasapdk/ESD4_project/figures/technical_analysis/bandwidth_bp_illustration.png

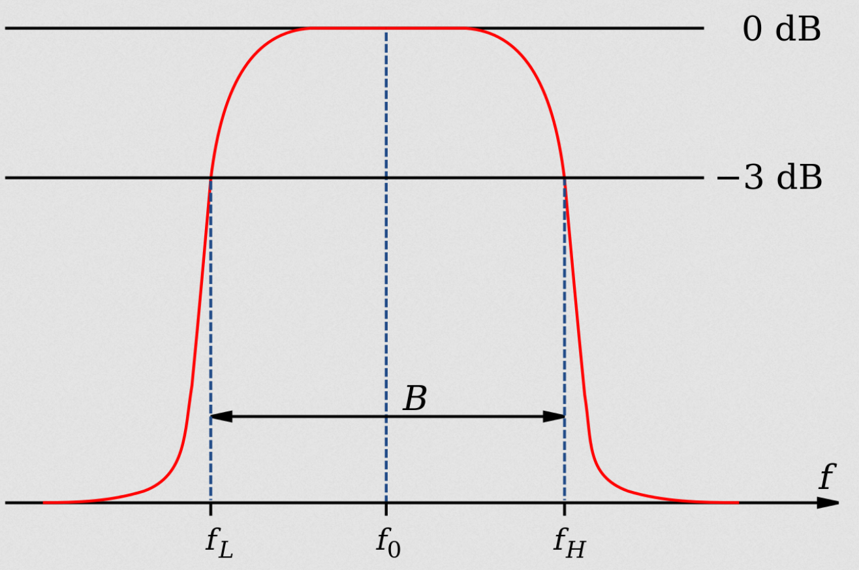
figures/technical_analysis/bandwidth_bp_illustration.png
