Niclasapdk/ESD4_project/figures/technical_analysis/bc547_hfe.png

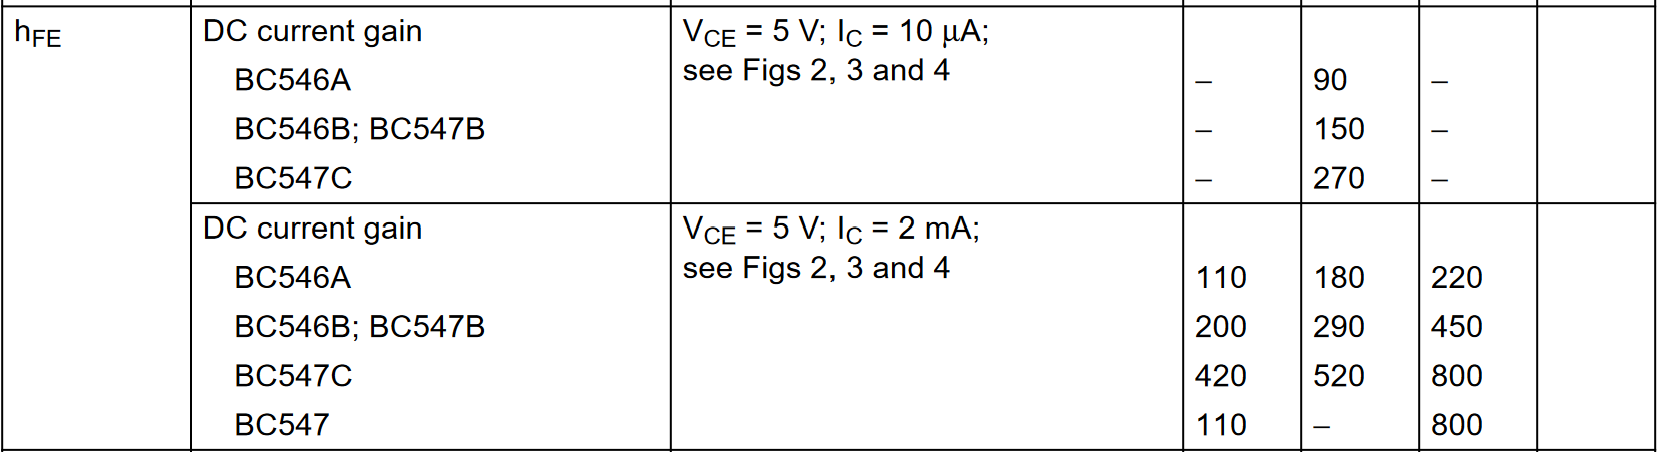
figures/technical_analysis/bc547_hfe.png
