Niclasapdk/ESD4_project/figures/technical_analysis/bc547_hfe_graph.png

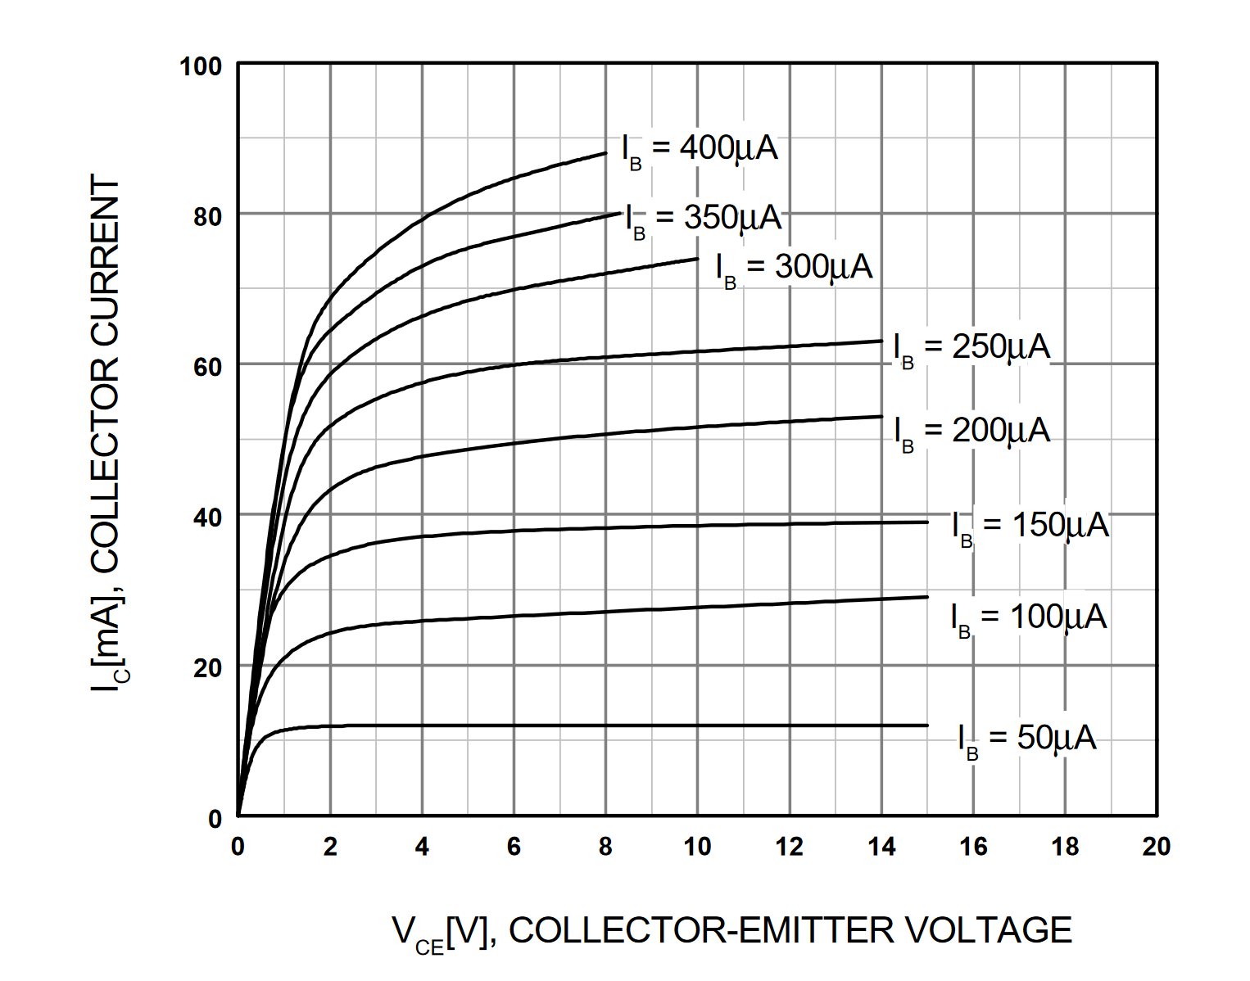
figures/technical_analysis/bc547_hfe_graph.png
