Niclasapdk/ESD4_project/figures/technical_analysis/bp_variable_q.png

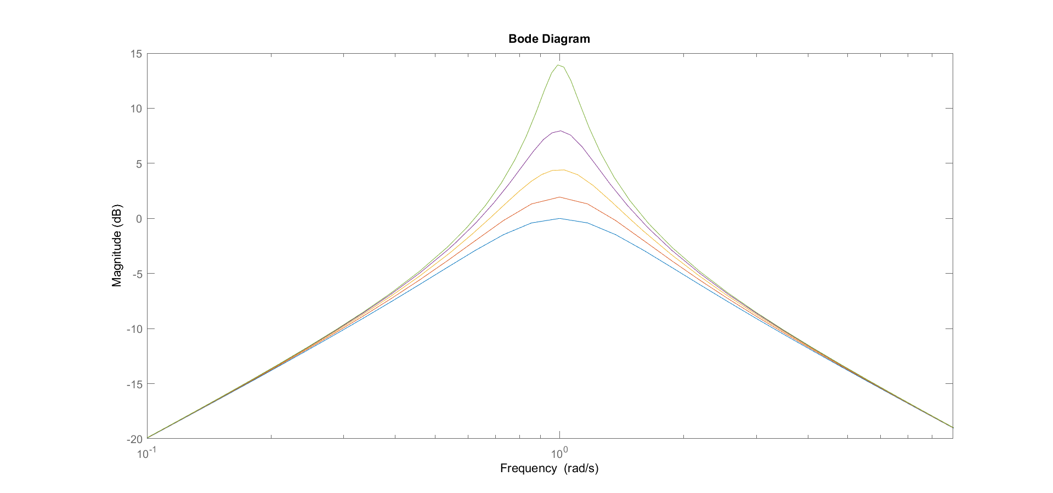
figures/technical_analysis/bp_variable_q.png
