Niclasapdk/ESD4_project/figures/technical_analysis/Class_a_circuit.png

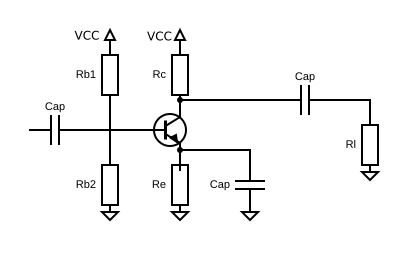
figures/technical_analysis/Class_a_circuit.png
