Niclasapdk/ESD4_project/figures/technical_analysis/Class_b_circuit.png

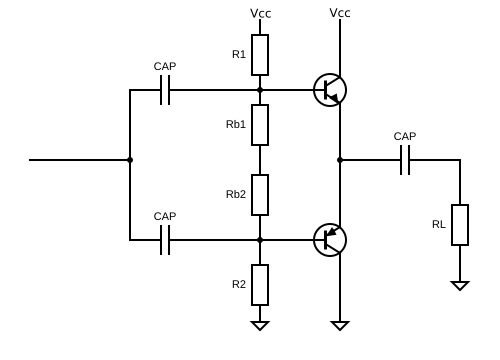
figures/technical_analysis/Class_b_circuit.png
