Niclasapdk/ESD4_project/figures/technical_analysis/class_d_working_principle.png

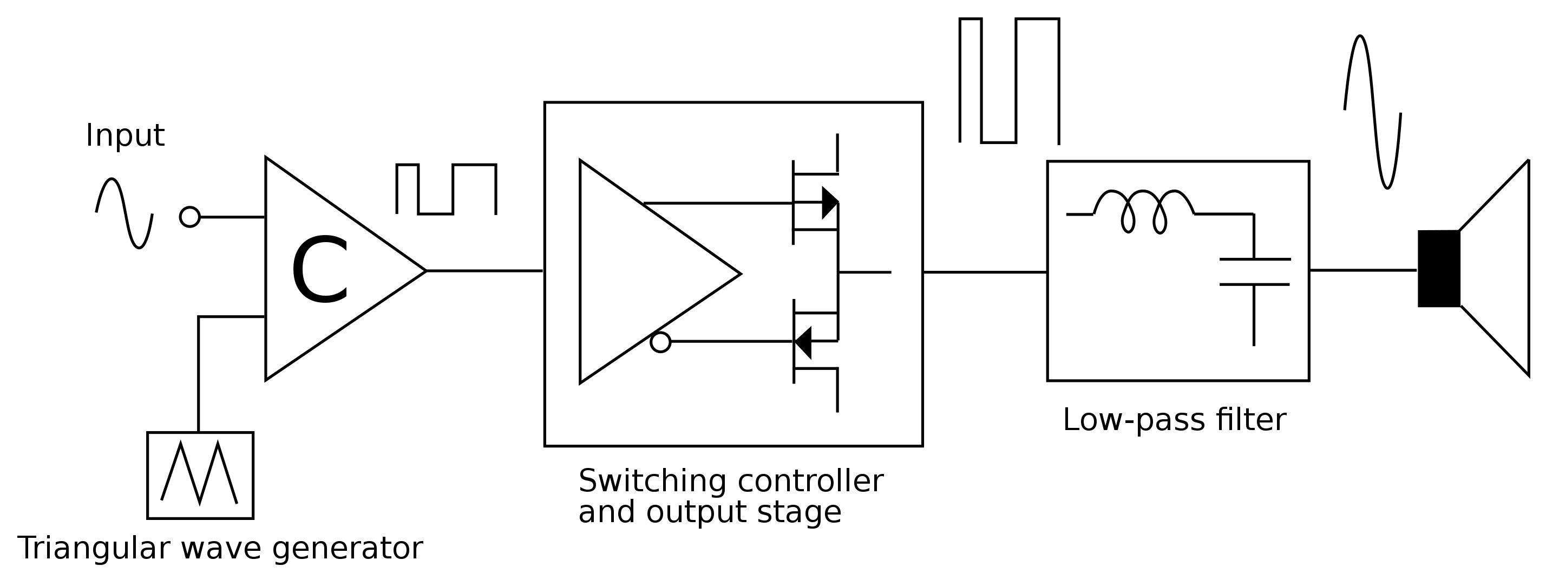
figures/technical_analysis/class_d_working_principle.png
