Niclasapdk/ESD4_project/figures/technical_analysis/crossover_distortion.jpg

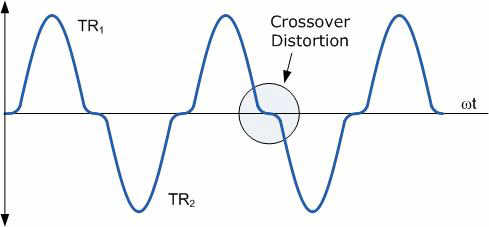
figures/technical_analysis/crossover_distortion.jpg
