Niclasapdk/ESD4_project/figures/technical_analysis/fet_schematic.png

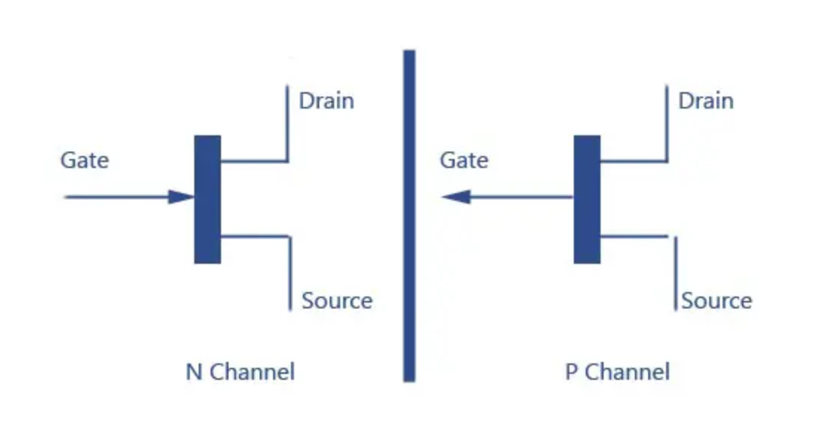
figures/technical_analysis/fet_schematic.png
