Niclasapdk/ESD4_project/figures/technical_analysis/Graphic_eq.jpg

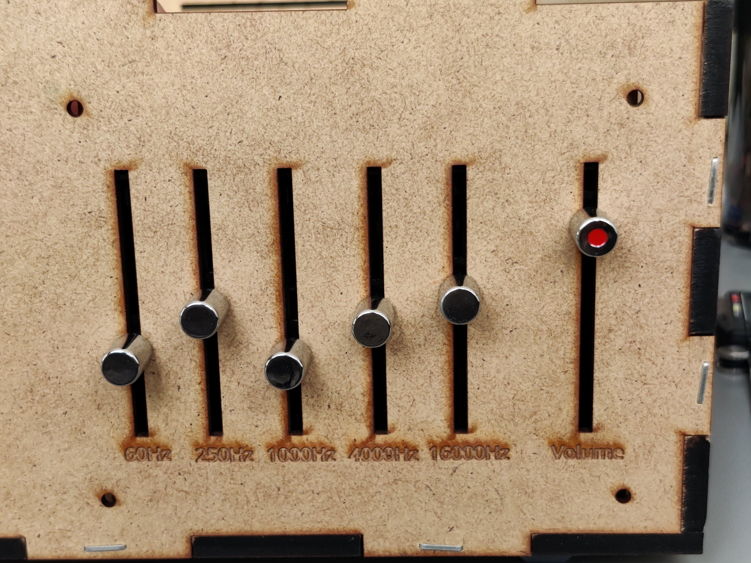
figures/technical_analysis/Graphic_eq.jpg
