Niclasapdk/ESD4_project/figures/technical_analysis/hp_lp_freq_response.png

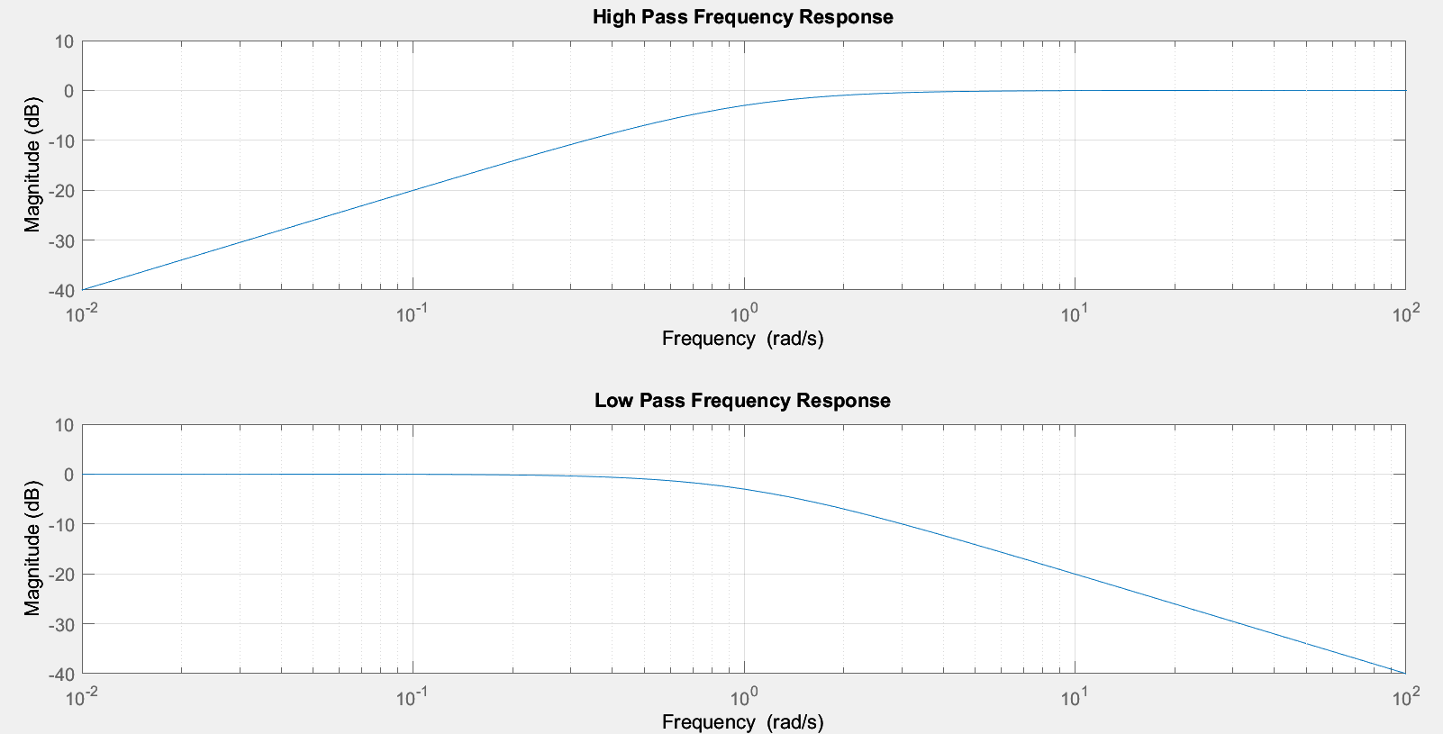
figures/technical_analysis/hp_lp_freq_response.png
