Niclasapdk/ESD4_project/figures/technical_analysis/movingMagnetMovingCoil.jpg

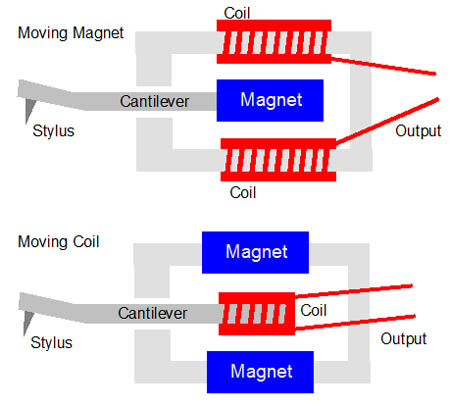
figures/technical_analysis/movingMagnetMovingCoil.jpg
