Niclasapdk/ESD4_project/figures/technical_analysis/npn_pnp_schematic.png

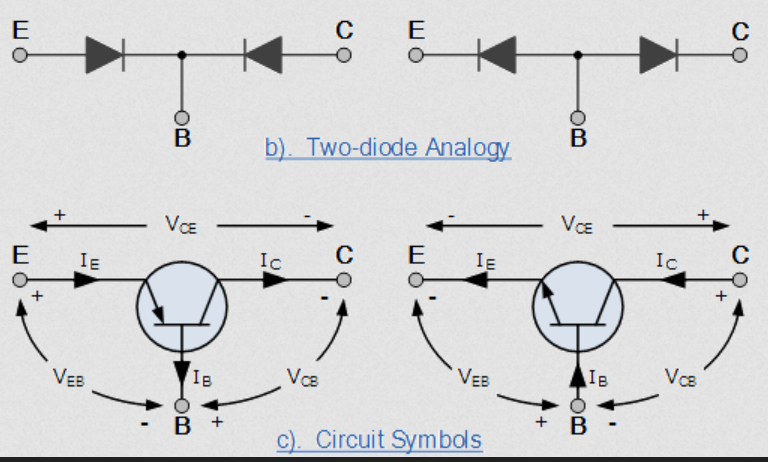
figures/technical_analysis/npn_pnp_schematic.png
