Niclasapdk/ESD4_project/figures/technical_analysis/Physical-structure-of-an-nMOS-transistor.png

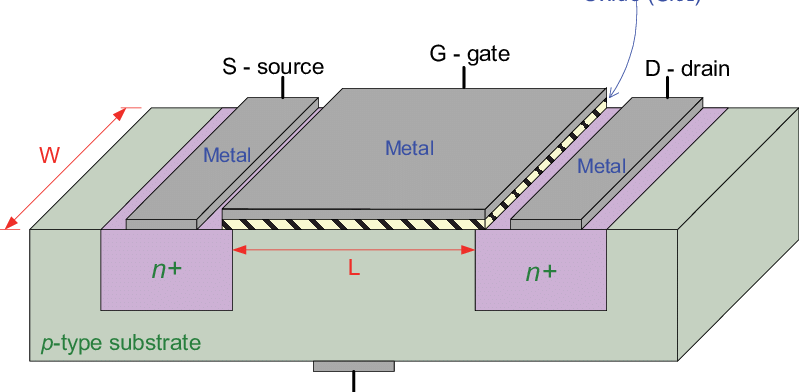
figures/technical_analysis/Physical-structure-of-an-nMOS-transistor.png
