Niclasapdk/ESD4_project/figures/technical_analysis/speaker.png

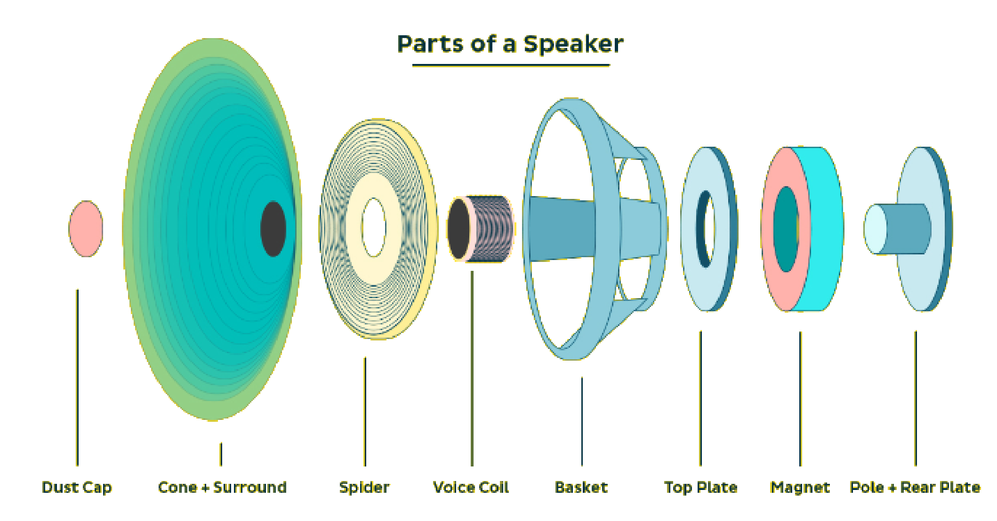
figures/technical_analysis/speaker.png
