Niclasapdk/ESD4_project/figures/technical_analysis/vinyl_groove_close_up.png

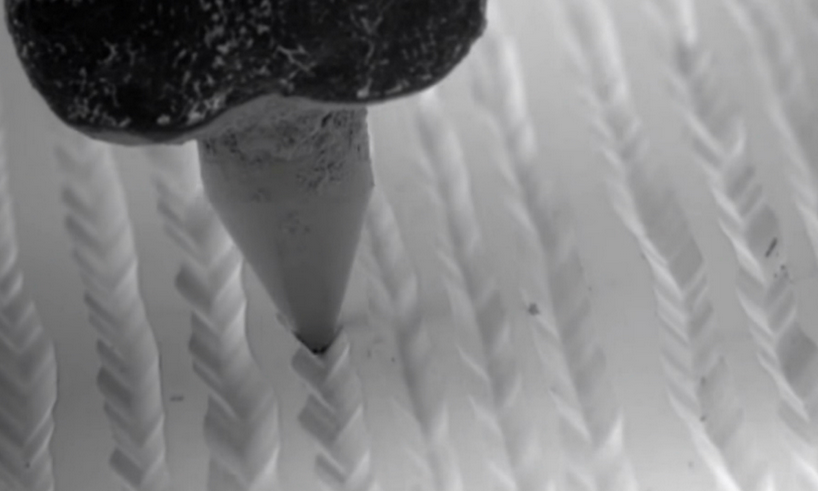
figures/technical_analysis/vinyl_groove_close_up.png
