Niclasapdk/ESD4_project/RIAA/scope_0.png

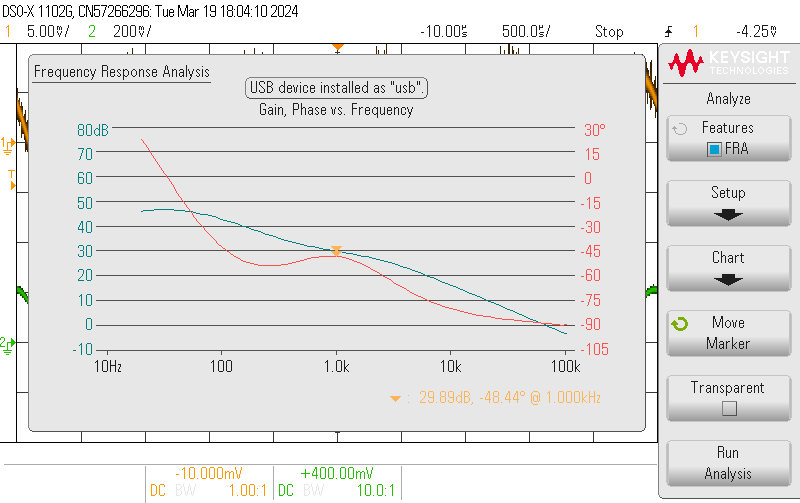
RIAA/scope_0.png
