Niclasapdk/ESD4_project/figures/system_design/final_riaa_component/final_riaa_component.png

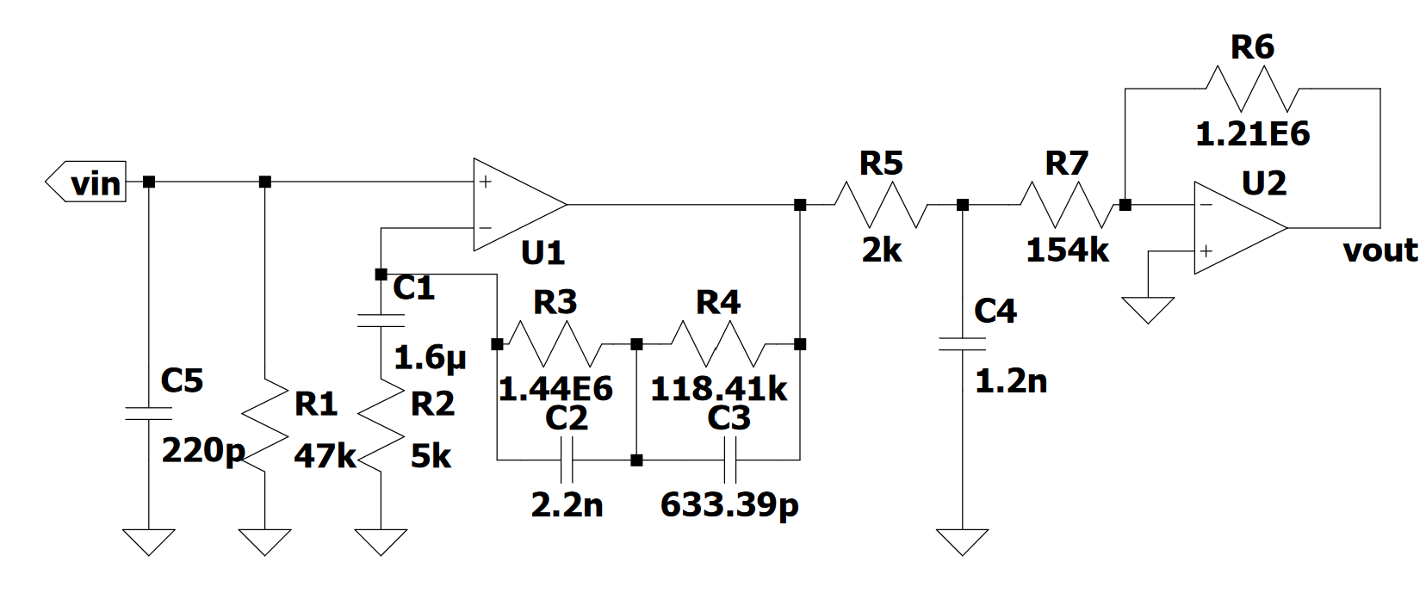
figures/system_design/final_riaa_component/final_riaa_component.png
