Niclasapdk/ESD4_project/construction_parts/eq_faceplate/Part Studio 1 - Part 1.stl

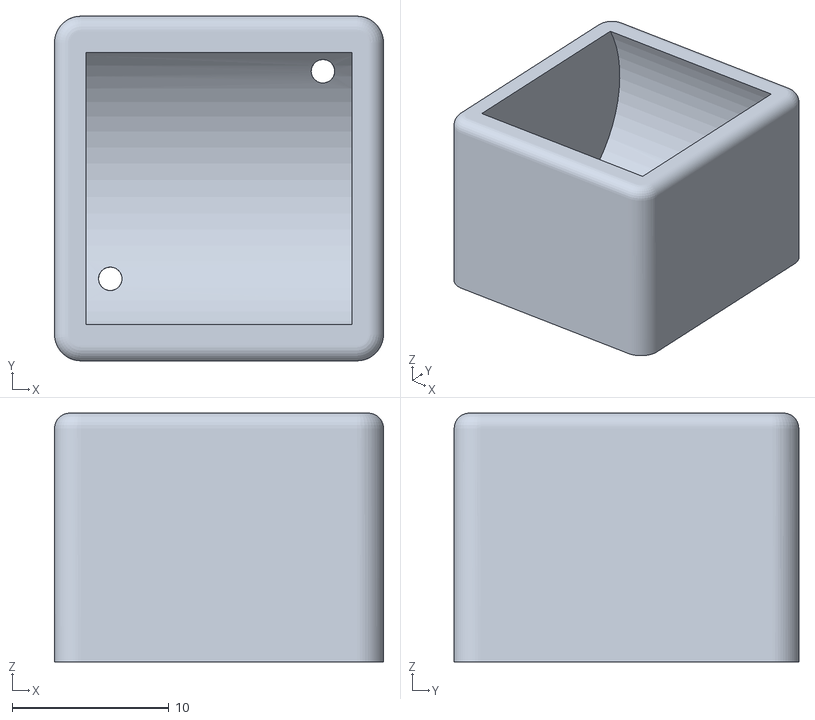
[picture p109: CAD file, 2024-04-08]
construction_parts/eq_faceplate/Part Studio 1 - Part 1.stl
21.0 x 22.0 x 15.9
