Niclasapdk/ESD4_project/construction_parts/markus_vil_gerne_have_stepfil.step

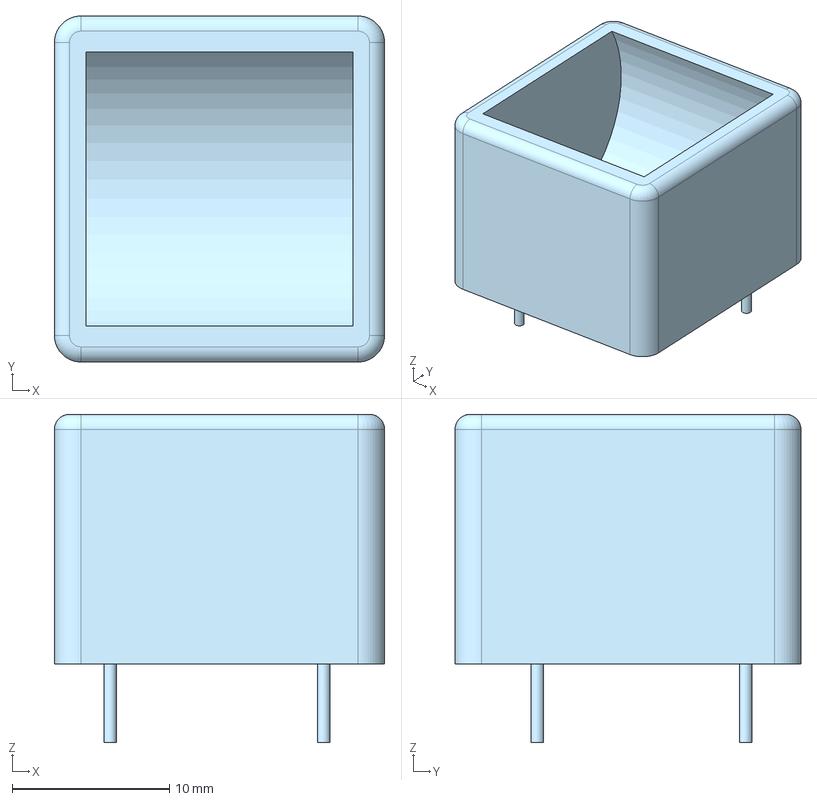
[picture p110: CAD file, 2024-03-18]
construction_parts/markus_vil_gerne_have_stepfil.step
21.0 x 22.0 x 20.9 mm
