Niclasapdk/ESD4_project/construction_parts/eq_faceplate/Part Studio 1 - Sketch 1(1).dxf

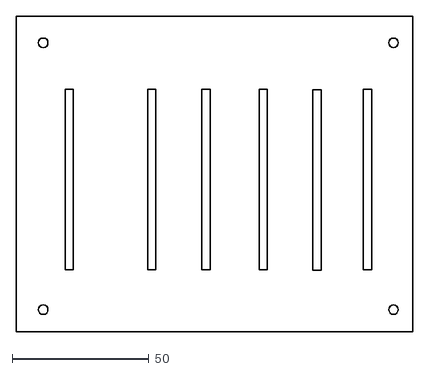
[picture p112: CAD file, 2024-04-08, an earlier design]
construction_parts/eq_faceplate/Part Studio 1 - Sketch 1(1).dxf
144.9 x 115.5
