Niclasapdk/ESD4_project/(list of files, cad)

Other CAD files:
construction_parts/coil_box_with_legs.stl
construction_parts/coil_box.stl
construction_parts/eq_faceplate/Part Studio 1 - Part 1(1).stl
construction_parts/eq_faceplate/Part Studio 1 - Part 1.x_t
