Niclasapdk/ESD4_project/fft/build/sketch/Readme.md

#line 1 "/home/fred441a/Documents/Uni/4ESD/project/fft/Readme.md"
# Timing calculations

```{python}
import math

print((44*math.pow(10,3))/(240*math.pow(10,6))*100)
```
0.0183% cpu time for sampling
