Niclasapdk/ESD4_project/figures/technical_analysis/npn_operating_regions.png

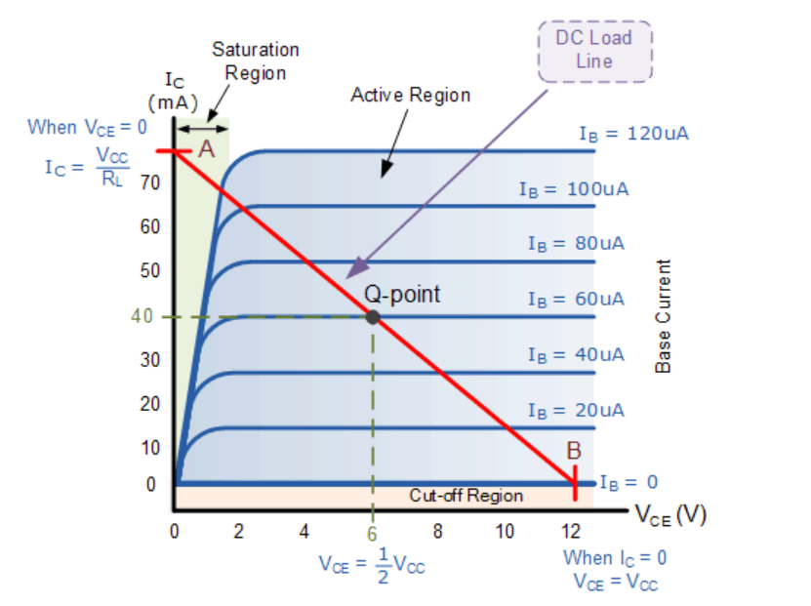
figures/technical_analysis/npn_operating_regions.png
