Niclasapdk/ESD4_project/figures/system_design/pa_stability/closed_loop_test.txt

Freq.	V(out)
1.00000000000000e+00	(1.50175133233920e+01dB,1.12104051280673e+02°)
1.02329299228075e+00	(1.53127352329228e+01dB,1.11152256880812e+02°)
1.04712854805090e+00	(1.56046566524632e+01dB,1.10183565999302e+02°)
1.07151930523761e+00	(1.58931930469065e+01dB,1.09198388467689e+02°)
1.09647819614318e+00	(1.61782614867148e+01dB,1.08197156672122e+02°)
1.12201845430196e+00	(1.64597808475942e+01dB,1.07180325471062e+02°)
1.14815362149688e+00	(1.67376720134620e+01dB,1.06148372021799e+02°)
1.17489755493953e+00	(1.70118580817189e+01dB,1.05101795511252e+02°)
1.20226443461741e+00	(1.72822645696310e+01dB,1.04041116788192e+02°)
1.23026877081238e+00	(1.75488196205695e+01dB,1.02966877894392e+02°)
1.25892541179417e+00	(1.78114542087832e+01dB,1.01879641493287e+02°)
1.28824955169313e+00	(1.80701023413421e+01dB,1.00779990195105e+02°)
1.31825673855641e+00	(1.83247012559548e+01dB,9.96685257782584e+01°)
1.34896288259165e+00	(1.85751916131666e+01dB,9.85458683082315e+01°)
1.38038426460288e+00	(1.88215176815133e+01dB,9.74126551558315e+01°)
1.41253754462275e+00	(1.90636275143545e+01dB,9.62695399170334e+01°)
1.44543977074593e+00	(1.93014731168781e+01dB,9.51171912386919e+01°)
1.47910838816821e+00	(1.95350106020274e+01dB,9.39562915544436e+01°)
1.51356124843621e+00	(1.97642003341038e+01dB,9.27875357360503e+01°)
1.54881661891248e+00	(1.99890070586780e+01dB,9.16116296677287e+01°)
1.58489319246111e+00	(2.02094000179804e+01dB,9.04292887489650e+01°)
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
9.33254300796970e+07	(-3.48542906877011e+01dB,1.21301706648886e+02°)
9.54992586021414e+07	(-3.50092234560382e+01dB,1.20786439429463e+02°)
9.77237220955788e+07	(-3.51558637734220e+01dB,1.20247725031236e+02°)
1.00000000000000e+08	(-3.52944225016338e+01dB,1.19683114291356e+02°)
