Niclasapdk/ESD4_project/figures/system_design/pa_stability/open_loop_test.txt

Freq.	V(out)
1.00000000000000e+00	(1.05288577185692e+02dB,-4.97509713034630e+01°)
1.02329299228075e+00	(1.05141390462402e+02dB,-4.94915423852459e+01°)
1.04712854805090e+00	(1.04995366602170e+02dB,-4.92192223289056e+01°)
1.07151930523761e+00	(1.04850563300876e+02dB,-4.89342194756301e+01°)
1.09647819614318e+00	(1.04707037440250e+02dB,-4.86367541217884e+01°)
1.12201845430196e+00	(1.04564845007393e+02dB,-4.83270585564749e+01°)
1.14815362149688e+00	(1.04424041010595e+02dB,-4.80053770697258e+01°)
1.17489755493953e+00	(1.04284679391751e+02dB,-4.76719659277391e+01°)
1.20226443461741e+00	(1.04146812935631e+02dB,-4.73270933120909e+01°)
1.23026877081238e+00	(1.04010493176598e+02dB,-4.69710392197847e+01°)
1.25892541179417e+00	(1.03875770303249e+02dB,-4.66040953215219e+01°)
1.28824955169313e+00	(1.03742693061319e+02dB,-4.62265647753184e+01°)
1.31825673855641e+00	(1.03611308655571e+02dB,-4.58387619936246e+01°)
1.34896288259165e+00	(1.03481662651407e+02dB,-4.54410123618286e+01°)
1.38038426460288e+00	(1.03353798876650e+02dB,-4.50336519068363e+01°)
1.41253754462275e+00	(1.03227759324309e+02dB,-4.46170269146103e+01°)
1.44543977074593e+00	(1.03103584057089e+02dB,-4.41914934962330e+01°)
1.47910838816821e+00	(1.02981311114351e+02dB,-4.37574171024158e+01°)
1.51356124843621e+00	(1.02860976422319e+02dB,-4.33151719868417e+01°)
1.54881661891248e+00	(1.02742613708188e+02dB,-4.28651406194976e+01°)
1.58489319246111e+00	(1.02626254419101e+02dB,-4.24077130515046e+01°)
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
9.33254300796970e+07	(-3.86942691601231e+01dB,6.25876570614239e+01°)
9.54992586021414e+07	(-3.94173240527468e+01dB,6.18967185505141e+01°)
9.77237220955788e+07	(-4.01432796707234e+01dB,6.12300271559164e+01°)
1.00000000000000e+08	(-4.08719871124517e+01dB,6.05880381641967e+01°)
