Niclasapdk/ESD4_project/integration_test/boom_boom/snr_nosignal.csv

x-axis | 1 | 2
second | Volt | Volt
-250.0000E-06 | +3.9195977E-03 | -3.6180904E-03
-249.7500E-06 | -2.1105530E-03 | -4.3216080E-03
-249.5000E-06 | +3.9195977E-03 | -4.8241206E-03
-249.2500E-06 | -2.1105530E-03 | -5.2261306E-03
-249.0000E-06 | +3.9195977E-03 | -5.6281406E-03
-248.7500E-06 | +1.9095475E-03 | -6.0301507E-03
-248.5000E-06 | +3.9195977E-03 | -6.0301507E-03
-248.2500E-06 | +3.9195977E-03 | -4.9246231E-03
-248.0000E-06 | +3.9195977E-03 | -4.8241206E-03
-247.7500E-06 | +1.9095475E-03 | -4.4221105E-03
-247.5000E-06 | -100.5027E-06 | -4.2211055E-03
-247.2500E-06 | -6.1306534E-03 | -4.4221105E-03
-247.0000E-06 | +3.9195977E-03 | -4.8241206E-03
-246.7500E-06 | -4.1206032E-03 | -4.8241206E-03
-246.5000E-06 | +3.9195977E-03 | -5.4271356E-03
-246.2500E-06 | +3.9195977E-03 | -5.3266331E-03
-246.0000E-06 | +3.9195977E-03 | -5.6281406E-03
-245.7500E-06 | +3.9195977E-03 | -5.0251256E-03
-245.5000E-06 | -4.1206032E-03 | -4.8241206E-03
-245.2500E-06 | +1.9095475E-03 | -4.9246231E-03
-245.0000E-06 | -4.1206032E-03 | -4.4221105E-03
-244.7500E-06 | +1.9095475E-03 | -4.9246231E-03
-244.5000E-06 | -100.5027E-06 | -5.0251256E-03
-244.2500E-06 | -4.1206032E-03 | -5.2261306E-03
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
