Niclasapdk/ESD4_project/integration_test/boom_boom/snr_signal.csv

x-axis | 1 | 2
second | Volt | Volt
-2.500000E-03 | -8.040201E-03 | -1.407035187E+00
-2.497500E-03 | -22.110553E-03 | -1.658291470E+00
-2.495000E-03 | -28.140703E-03 | -1.708542727E+00
-2.492500E-03 | -32.160804E-03 | -1.959799010E+00
-2.490000E-03 | -40.201005E-03 | -2.010050267E+00
-2.487500E-03 | -48.241206E-03 | -2.060301524E+00
-2.485000E-03 | -56.281406E-03 | -2.311557807E+00
-2.482500E-03 | -68.341708E-03 | -2.562814090E+00
-2.480000E-03 | -64.321607E-03 | -2.814070374E+00
-2.477500E-03 | -74.371858E-03 | -2.663316604E+00
-2.475000E-03 | -80.402009E-03 | -2.713567860E+00
-2.472500E-03 | -84.422110E-03 | -2.864321630E+00
-2.470000E-03 | -104.522612E-03 | -3.015075400E+00
-2.467500E-03 | -104.522612E-03 | -3.266331684E+00
-2.465000E-03 | -112.562813E-03 | -3.417085454E+00
-2.462500E-03 | -120.603014E-03 | -3.567839224E+00
-2.460000E-03 | -128.643215E-03 | -3.819095507E+00
-2.457500E-03 | -128.643215E-03 | -3.969849277E+00
-2.455000E-03 | -136.683416E-03 | -3.919598021E+00
-2.452500E-03 | -144.723617E-03 | -4.020100534E+00
-2.450000E-03 | -152.763817E-03 | -4.221105561E+00
-2.447500E-03 | -158.793968E-03 | -4.271356817E+00
-2.445000E-03 | -160.804018E-03 | -4.321608074E+00
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
