Niclasapdk/ESD4_project/integration_test/eq_volctrl/zi_eq_l.csv

#Digilent WaveForms Impedance Analyzer - Impedance
#Device Name: Discovery2
#Serial Number: SN:210321A364C9
#Date Time:
#Digilent WaveForms Impedance Analyzer Trace#Trace: Trace
#Start: 20 Hz
#Stop: 20000 Hz
#Steps: 201
#Resistor: 1e+06 O
#Average: 1
#ProbeResistance: 1.04e+06 O
#ProbeCapacitance: 4.3e-11 F
#Compensation:none
#Wavegen: Wavegen1
#Amplitude: 1.736 V
#Offset: 0 V
#Amplification: 1 X
#Settle: 0.01 s
#MinPeriods: 16
#Scale: Logarithmic
#Channel: Channel 1
#Range: 5.5024 V
#Offset: -1.4451e-05 V
#Attenuation: 1 X
#Channel: Channel 2
#Range: 5.48701 V
#Offset: -0.000319257 V
#Attenuation: 1 X
Frequency (Hz) | Trace |Z| (Ohm)
20.00000000000002 | 499233.6859922974
20.70284333358691 | 500333.118503403
21.43038610475214 | 500335.9739817151
22.18349630524804 | 500365.32973204
22.96307242993768 | 500341.5731668783
23.7700445487404 | 500331.8074612934
24.60537541624765 | 500379.6774156438
25.47006162033326 | 500374.4724956274
26.36513477112818 | 500417.3860281754
27.29166273177853 | 500401.332073675
28.25075089245511 | 500402.4585920154
29.2435434891344 | 500398.6106535646
30.2712249687242 | 500428.3306646036
31.335021402163 | 500419.7762155521
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
