Niclasapdk/ESD4_project/integration_test/eq_volctrl/pot_min/audioanalyzer_eqvolctrl_min_l.tsv

% | Date: | 2024-05-17 | Time: | 12:21:27
% | Sampling frequency |  | [Hz]: | 200000
% | Generator amplitude |  | [V]: | 1.7300
% | Settle time |  | [s]: | 0.025000
% | Settle cycles: |  |  | 5
% | Integration time |  | [s]: | 0.025000
% | Integration cycles: |  |  | 5
% Freq. | Amplitude | Phase | THD | HD 2 | HD 3 | HD 4 | HD 5
% [Hz] | [dB] | [deg] | [dB] | [dB ref fund] | [dB ref fund] | [dB ref fund] | [dB ref fund]
1.0000E+1 | -8.3183E+0 | -1.7339E+1 | -5.6671E+1 | -7.0219E+1 | -9.6943E+1 | -1.0210E+2 | -5.6868E+1
1.0289E+1 | -8.3672E+0 | -1.7745E+1 | -5.9275E+1 | -7.0218E+1 | -9.7274E+1 | -1.2258E+2 | -5.9640E+1
1.0586E+1 | -8.4187E+0 | -1.8155E+1 | -6.6589E+1 | -6.9941E+1 | -9.8305E+1 | -9.8907E+1 | -6.9292E+1
1.0892E+1 | -8.4724E+0 | -1.8568E+1 | -7.0216E+1 | -7.0242E+1 | -9.3544E+1 | -1.0327E+2 | -1.0109E+2
1.1207E+1 | -8.5286E+0 | -1.8984E+1 | -6.9851E+1 | -6.9954E+1 | -9.7830E+1 | -8.7322E+1 | -9.3866E+1
1.1531E+1 | -8.5874E+0 | -1.9400E+1 | -6.9541E+1 | -7.0235E+1 | -9.6087E+1 | -7.8003E+1 | -9.4652E+1
1.1864E+1 | -8.6488E+0 | -1.9819E+1 | -6.2833E+1 | -7.0013E+1 | -9.6318E+1 | -6.3758E+1 | -1.1984E+2
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
