Niclasapdk/ESD4_project/integration_test/eq_volctrl/pot_max/audioanalyzer_eqvolctrl_max_l.tsv

% | Date: | 2024-05-13 | Time: | 11:12:45
% | Sampling frequency |  | [Hz]: | 204800
% | Generator amplitude |  | [V]: | 1.0000
% | Settle time |  | [s]: | 0.025000
% | Settle cycles: |  |  | 5
% | Integration time |  | [s]: | 0.025000
% | Integration cycles: |  |  | 5
% Freq. | Amplitude | Phase | THD | HD 2 | HD 3 | HD 4 | HD 5
% [Hz] | [dB] | [deg] | [dB] | [dB ref fund] | [dB ref fund] | [dB ref fund] | [dB ref fund]
2.0000E+1 | -4.4016E+0 | 2.6112E+1 | -6.9789E+1 | -7.0196E+1 | -8.1388E+1 | -1.1299E+2 | -8.6726E+1
2.0530E+1 | -4.2924E+0 | 2.6320E+1 | -7.0752E+1 | -7.0908E+1 | -8.7186E+1 | -1.0094E+2 | -9.0126E+1
2.1075E+1 | -4.1805E+0 | 2.6511E+1 | -6.7656E+1 | -6.7700E+1 | -8.8969E+1 | -9.7290E+1 | -9.5462E+1
2.1633E+1 | -4.0661E+0 | 2.6682E+1 | -8.2223E+1 | -8.4093E+1 | -8.7254E+1 | -9.9363E+1 | -1.0005E+2
2.2207E+1 | -3.9493E+0 | 2.6834E+1 | -6.1970E+1 | -6.1973E+1 | -9.4460E+1 | -1.0373E+2 | -1.0302E+2
2.2796E+1 | -3.8304E+0 | 2.6965E+1 | -5.9875E+1 | -5.9882E+1 | -8.9019E+1 | -9.9363E+1 | -9.9642E+1
2.3400E+1 | -3.7093E+0 | 2.7073E+1 | -5.3345E+1 | -5.3345E+1 | -9.2177E+1 | -1.0664E+2 | -1.0611E+2
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
