Niclasapdk/ESD4_project/integration_test/power_amplifier/audioanalyzer_poweramp_l.tsv

% Freq. | Amplitude | Phase | THD | HD 2 | HD 3 | HD 4 | HD 5
10.0 | 21.915165810407235 | 9.8141 | 0.03442221754399078 | -81.733 | -69.583 | -93.637 | -89.904
10.086 | 21.918617656552886 | 9.7373 | 0.0342042659818085 | -81.959 | -69.611 | -93.926 | -91.96
10.172 | 21.92082429447063 | 9.6611 | 0.03403955408009246 | -81.916 | -69.667 | -93.993 | -90.883
10.259 | 21.923205540707883 | 9.5855 | 0.034064171594262706 | -81.961 | -69.654 | -93.48 | -91.833
10.347 | 21.92578481935016 | 9.5104 | 0.03414133076531619 | -81.823 | -69.647 | -93.879 | -90.664
10.436 | 21.929253947313743 | 9.4359 | 0.03398405451851963 | -81.871 | -69.683 | -93.91 | -90.419
10.525 | 21.930647719472578 | 9.362 | 0.03402708507848019 | -81.686 | -69.675 | -94.316 | -91.437
10.615 | 21.932892951681623 | 9.2886 | 0.03387670522838316 | -81.88 | -69.703 | -94.622 | -91.48
10.706 | 21.93510608998231 | 9.2158 | 0.033844531110863746 | -81.757 | -69.721 | -94.727 | -91.046
10.798 | 21.93670434113804 | 9.1436 | 0.03385135437270315 | -82.031 | -69.704 | -95.364 | -91.171
10.89 | 21.939548846252286 | 9.0718 | 0.033903902109064056 | -81.772 | -69.707 | -94.838 | -91.243
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
