Niclasapdk/ESD4_project/integration_test/power_amplifier/audioanalyzer_poweramp_r.tsv

% Freq. | Amplitude | Phase | THD | HD 2 | HD 3 | HD 4 | HD 5
10.0 | 21.915816063685384 | 9.8141 | 0.034432022199062495 | -81.733 | -69.583 | -93.637 | -89.904
10.086 | 21.919706357881203 | 9.7373 | 0.034182122656334 | -81.959 | -69.611 | -93.926 | -91.96
10.172 | 21.923069512607565 | 9.6611 | 0.034026186378731095 | -81.916 | -69.667 | -93.993 | -90.883
10.259 | 21.926189733008865 | 9.5855 | 0.034060845372654774 | -81.961 | -69.654 | -93.48 | -91.833
10.347 | 21.929651616659108 | 9.5104 | 0.034143147157199225 | -81.823 | -69.647 | -93.879 | -90.664
10.436 | 21.932589825829243 | 9.4359 | 0.03398574996767334 | -81.871 | -69.683 | -93.91 | -90.419
10.525 | 21.933659535495995 | 9.362 | 0.03403099064908283 | -81.686 | -69.675 | -94.316 | -91.437
10.615 | 21.937225689656835 | 9.2886 | 0.03387632477034983 | -81.88 | -69.703 | -94.622 | -91.48
10.706 | 21.940250761667865 | 9.2158 | 0.03383102129842643 | -81.757 | -69.721 | -94.727 | -91.046
10.798 | 21.942178205126268 | 9.1436 | 0.033803446005070174 | -82.031 | -69.704 | -95.364 | -91.171
10.89 | 21.945411894401953 | 9.0718 | 0.03384128526875383 | -81.772 | -69.707 | -94.838 | -91.243
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
