Niclasapdk/ESD4_project/integration_test/power_amplifier/zi_poweramp_l.csv

#Digilent WaveForms Impedance Analyzer
#Device Name: Discovery2
#Serial Number: SN:210321A364C9
#Date Time:
#Digilent WaveForms Impedance Analyzer Trace#Trace: Trace
#Start: 20 Hz
#Stop: 20000 Hz
#Steps: 201
#Resistor: 1000 O
#Average: 1
#ProbeResistance: 1.04e+06 O
#ProbeCapacitance: 4.3e-11 F
#Compensation:none
#Wavegen: Wavegen1
#Amplitude: 1.736 V
#Offset: 0 V
#Amplification: 1 X
#Settle: 0.01 s
#MinPeriods: 16
#Scale: Logarithmic
#Channel: Channel 1
#Range: 5.5024 V
#Offset: -1.4451e-05 V
#Attenuation: 1 X
#Channel: Channel 2
#Range: 5.48701 V
#Offset: -0.000319257 V
#Attenuation: 1 X
Frequency (Hz) | Trace |Z| (Ohm)
20.00000000000002 | 76051584.44769941
20.70284333358691 | 34725567.8826537
21.43038610475214 | 60596177.5744326
22.18349630524804 | 69203005.47583608
22.96307242993768 | 58597206.73242281
23.7700445487404 | 35930979.24747504
24.60537541624765 | 106456890.7229177
25.47006162033326 | 63719202.40154454
26.36513477112818 | 44468482.5632544
27.29166273177853 | 35906815.80623003
28.25075089245511 | 56867205.09101614
29.2435434891344 | 38991296.61542824
30.2712249687242 | 33819343.53143262
31.335021402163 | 42220674.13337836
32.43620194717863 | 42580603.91161383
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
