Niclasapdk/ESD4_project/integration_test/power_amplifier/zi_poweramp_r.csv

#Digilent WaveForms Impedance Analyzer
#Device Name: Discovery2
#Serial Number: SN:210321A364C9
#Date Time:
#Digilent WaveForms Impedance Analyzer Trace#Trace: Trace
#Start: 20 Hz
#Stop: 20000 Hz
#Steps: 201
#Resistor: 1000 O
#Average: 1
#ProbeResistance: 1.04e+06 O
#ProbeCapacitance: 4.3e-11 F
#Compensation:none
#Wavegen: Wavegen1
#Amplitude: 1.736 V
#Offset: 0 V
#Amplification: 1 X
#Settle: 0.01 s
#MinPeriods: 16
#Scale: Logarithmic
#Channel: Channel 1
#Range: 5.5024 V
#Offset: -1.4451e-05 V
#Attenuation: 1 X
#Channel: Channel 2
#Range: 5.48701 V
#Offset: -0.000319257 V
#Attenuation: 1 X
Frequency (Hz) | Trace |Z| (Ohm)
20.00000000000002 | 91755427.16818629
20.70284333358691 | 44143589.04559659
21.43038610475214 | 61398266.70836098
22.18349630524804 | 33087605.9660393
22.96307242993768 | 52872847.9811615
23.7700445487404 | 105887484.5984083
24.60537541624765 | 27387541.59134781
25.47006162033326 | 35359380.62966039
26.36513477112818 | 87533117.22756502
27.29166273177853 | 62497944.46179993
28.25075089245511 | 167344574.8563066
29.2435434891344 | 85657773.36157188
30.2712249687242 | 49878343.2647347
31.335021402163 | 41193899.84823769
32.43620194717863 | 63486213.04351845
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
