Niclasapdk/ESD4_project/integration_test/preamp_class_a/audioanalyzer_classA_l.tsv

% | Date: | 2024-04-15 | Time: | 16:19:43
% | Sampling frequency |  | [Hz]: | 204800
% | Generator amplitude |  | [V]: | 0.44700
% | Settle time |  | [s]: | 0.025000
% | Settle cycles: |  |  | 10
% | Integration time |  | [s]: | 0.025000
% | Integration cycles: |  |  | 10
% Freq. | Amplitude | Phase | THD | HD 2 | HD 3 | HD 4 | HD 5
% [Hz] | [dB] | [deg] | [%] | [dB ref fund] | [dB ref fund] | [dB ref fund] | [dB ref fund]
2.0000E+1 | 1.1906E+1 | -1.7965E+2 | 1.1228E-2 | -7.9233E+1 | -9.8531E+1 | -1.1227E+2 | -9.2771E+1
2.0467E+1 | 1.1906E+1 | -1.7966E+2 | 1.0642E-2 | -7.9503E+1 | -1.0036E+2 | -1.1524E+2 | -1.0724E+2
2.0946E+1 | 1.1906E+1 | -1.7967E+2 | 1.0590E-2 | -7.9547E+1 | -1.0052E+2 | -1.1486E+2 | -1.0637E+2
2.1435E+1 | 1.1906E+1 | -1.7968E+2 | 1.0675E-2 | -7.9479E+1 | -1.0130E+2 | -1.1389E+2 | -1.0372E+2
2.1936E+1 | 1.1906E+1 | -1.7970E+2 | 1.0533E-2 | -7.9590E+1 | -1.0098E+2 | -1.1756E+2 | -1.0627E+2
2.2449E+1 | 1.1906E+1 | -1.7971E+2 | 1.0420E-2 | -7.9682E+1 | -1.0106E+2 | -1.1811E+2 | -1.0762E+2
2.2974E+1 | 1.1906E+1 | -1.7972E+2 | 1.1136E-2 | -7.9099E+1 | -1.0128E+2 | -1.2029E+2 | -1.0739E+2
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
