Niclasapdk/ESD4_project/integration_test/preamp_class_a/audioanalyzer_classA_r.tsv

% | Date: | 2024-04-15 | Time: | 16:21:39
% | Sampling frequency |  | [Hz]: | 204800
% | Generator amplitude |  | [V]: | 0.44700
% | Settle time |  | [s]: | 0.025000
% | Settle cycles: |  |  | 10
% | Integration time |  | [s]: | 0.025000
% | Integration cycles: |  |  | 10
% Freq. | Amplitude | Phase | THD | HD 2 | HD 3 | HD 4 | HD 5
% [Hz] | [dB] | [deg] | [%] | [dB ref fund] | [dB ref fund] | [dB ref fund] | [dB ref fund]
2.0000E+1 | 1.1930E+1 | -1.7964E+2 | 1.1831E-2 | -7.8698E+1 | -1.0058E+2 | -1.1908E+2 | -9.3830E+1
2.0467E+1 | 1.1930E+1 | -1.7965E+2 | 1.1793E-2 | -7.8642E+1 | -1.0089E+2 | -1.1790E+2 | -9.8127E+1
2.0946E+1 | 1.1930E+1 | -1.7966E+2 | 1.1749E-2 | -7.8629E+1 | -1.0112E+2 | -1.1868E+2 | -1.0866E+2
2.1435E+1 | 1.1930E+1 | -1.7967E+2 | 1.1634E-2 | -7.8723E+1 | -1.0031E+2 | -1.1617E+2 | -1.0669E+2
2.1936E+1 | 1.1930E+1 | -1.7968E+2 | 1.1778E-2 | -7.8611E+1 | -1.0085E+2 | -1.1612E+2 | -1.0741E+2
2.2449E+1 | 1.1930E+1 | -1.7970E+2 | 1.1951E-2 | -7.8482E+1 | -1.0100E+2 | -1.2017E+2 | -1.0763E+2
2.2974E+1 | 1.1930E+1 | -1.7971E+2 | 1.1816E-2 | -7.8593E+1 | -9.9697E+1 | -1.1048E+2 | -1.0702E+2
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
