Niclasapdk/ESD4_project/figures/integration_test/test_setup_snr.jpg

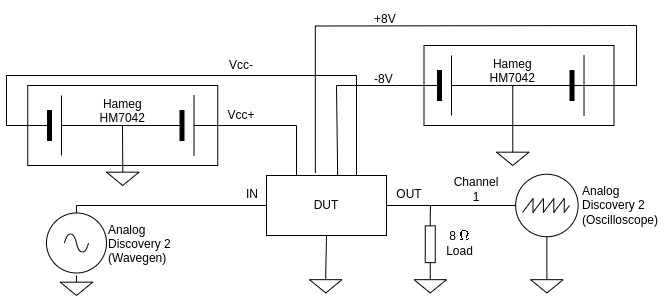
figures/integration_test/test_setup_snr.jpg
