Niclasapdk/ESD4_project/figures/integration_test/test_setup_thd_freqresp.jpg

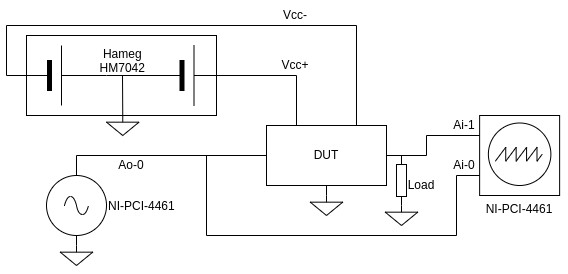
figures/integration_test/test_setup_thd_freqresp.jpg
