Niclasapdk/ESD4_project/figures/integration_test/test_setup_zi.jpg

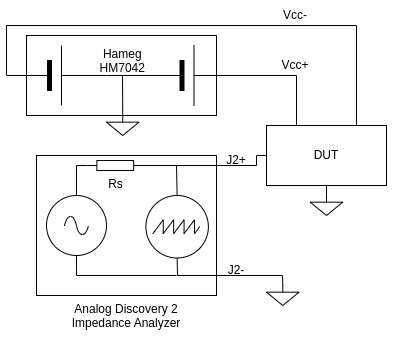
figures/integration_test/test_setup_zi.jpg
