Niclasapdk/ESD4_project/figures/integration_test/test_setup_zo.jpg

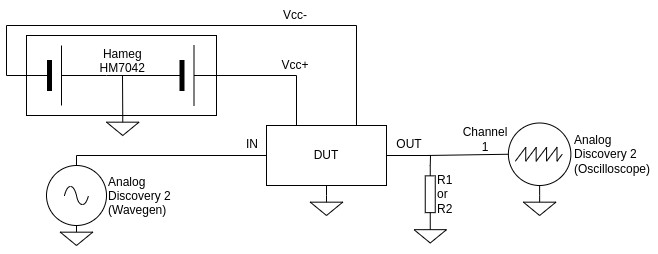
figures/integration_test/test_setup_zo.jpg
