Niclasapdk/ESD4_project/figures/system_design/pa_stability/closed_loop_test.png

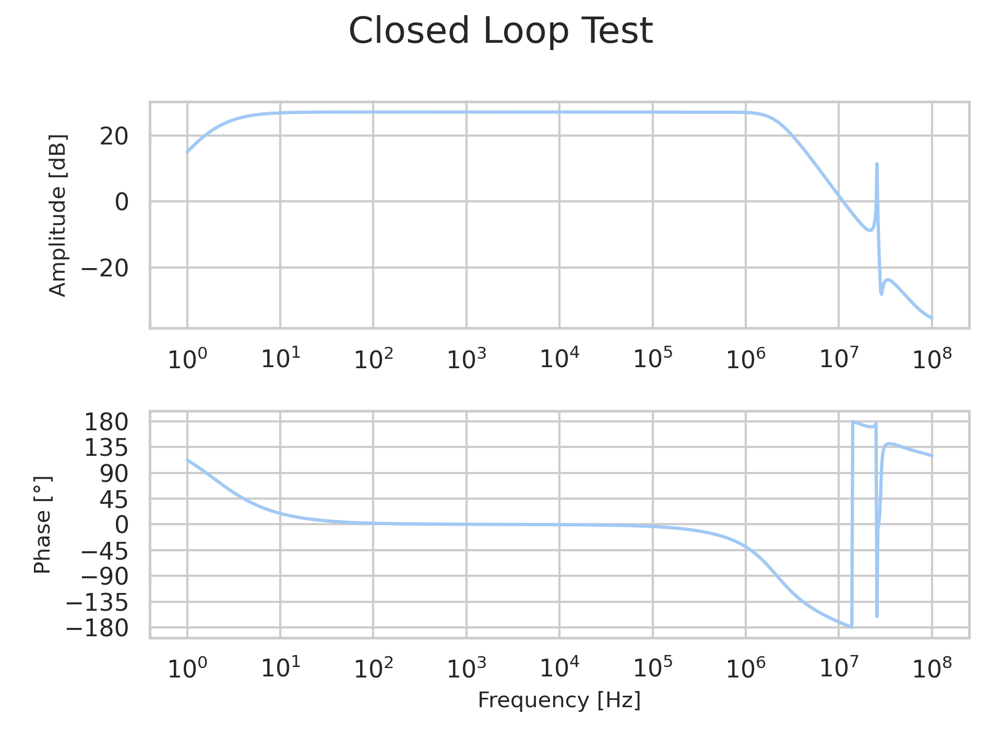
figures/system_design/pa_stability/closed_loop_test.png
