Niclasapdk/ESD4_project/figures/system_design/pa_stability/open_loop_test.png

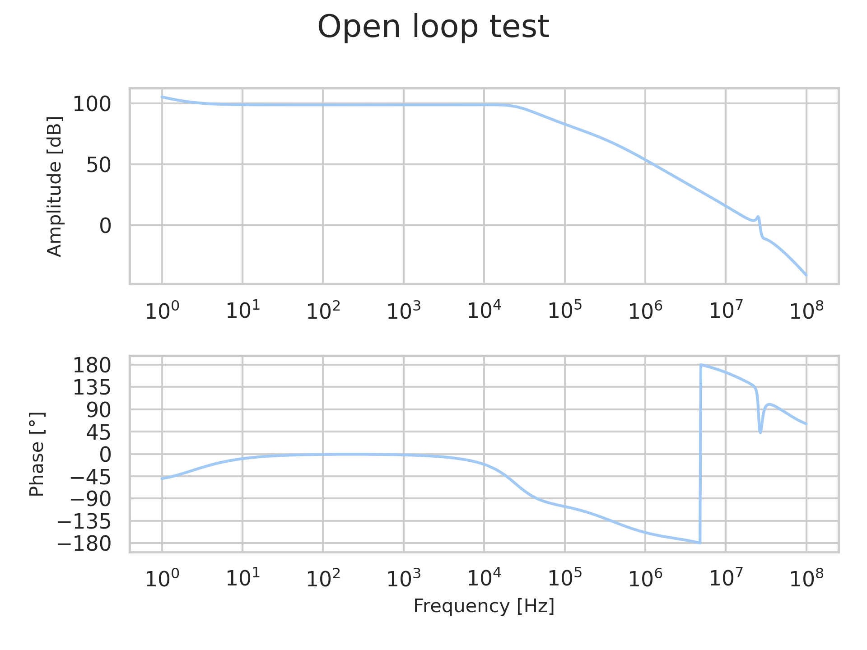
figures/system_design/pa_stability/open_loop_test.png
