Niclasapdk/ESD4_project/figures/system_design/pa_stability/open_loop_test_schematic.png

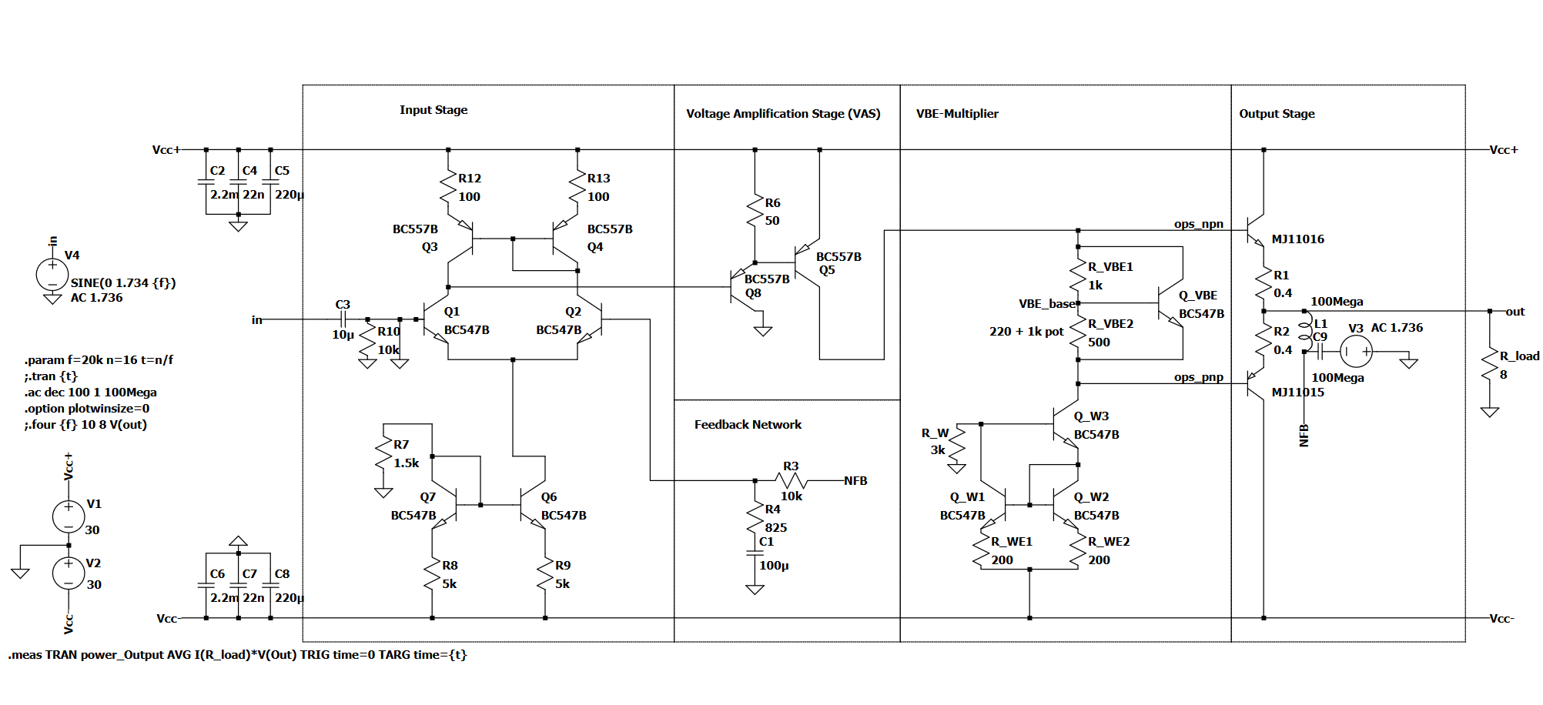
figures/system_design/pa_stability/open_loop_test_schematic.png
