Niclasapdk/ESD4_project/figures/technical_analysis/bc547_hfe_test.jpg

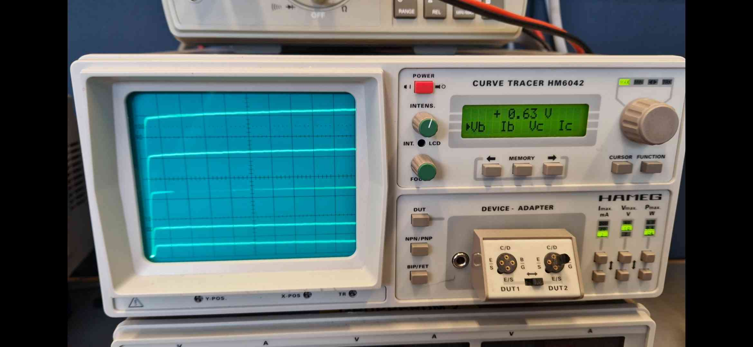
figures/technical_analysis/bc547_hfe_test.jpg
