Niclasapdk/ESD4_project/figures/technical_analysis/npn_pnp_characteristics.png

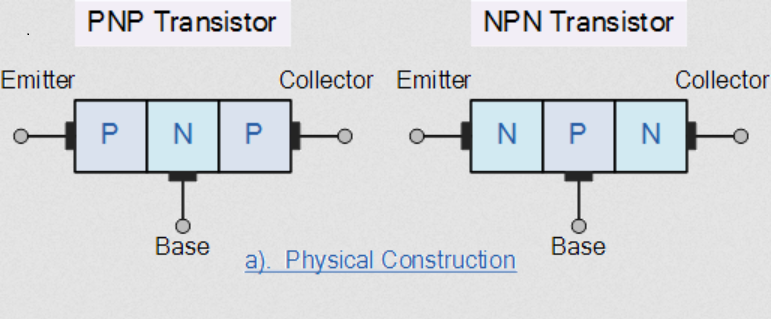
figures/technical_analysis/npn_pnp_characteristics.png
