Niclasapdk/ESD4_project/integration_test/eq_volctrl/pot_max/thd_eq_volctrl_pot_max.png

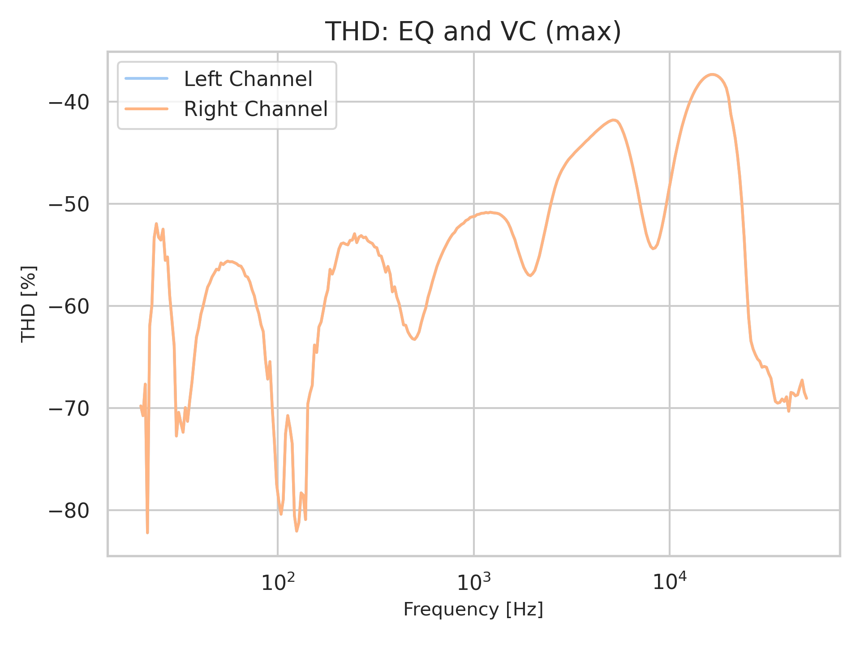
integration_test/eq_volctrl/pot_max/thd_eq_volctrl_pot_max.png
