Niclasapdk/ESD4_project/integration_test/eq_volctrl/pot_min/freqresp_eq_volctrl_pot_min.png

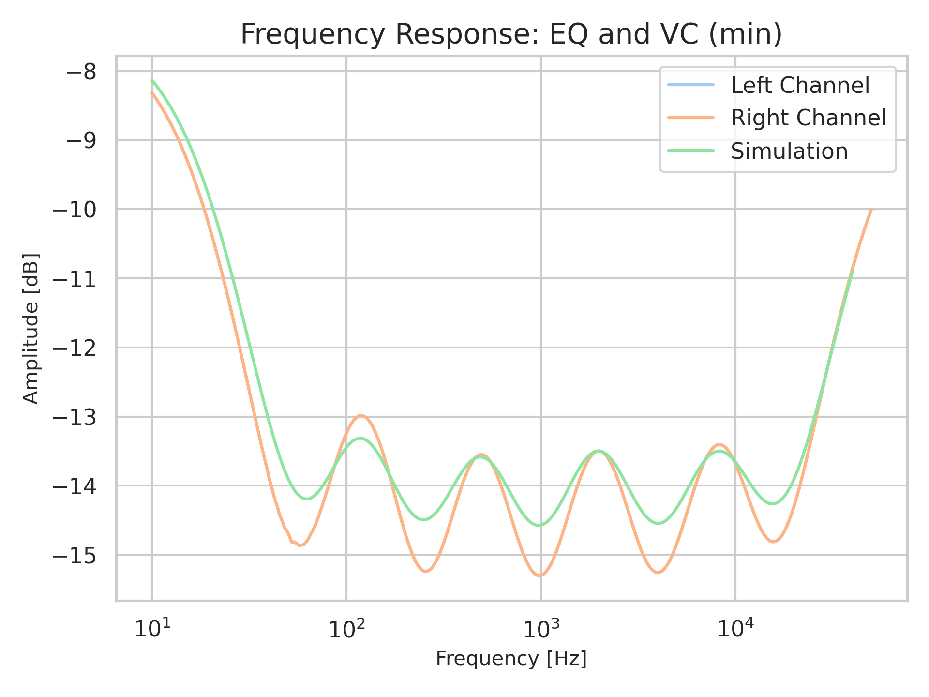
integration_test/eq_volctrl/pot_min/freqresp_eq_volctrl_pot_min.png
