Niclasapdk/ESD4_project/integration_test/eq_volctrl/zi_eq_volctrl.png

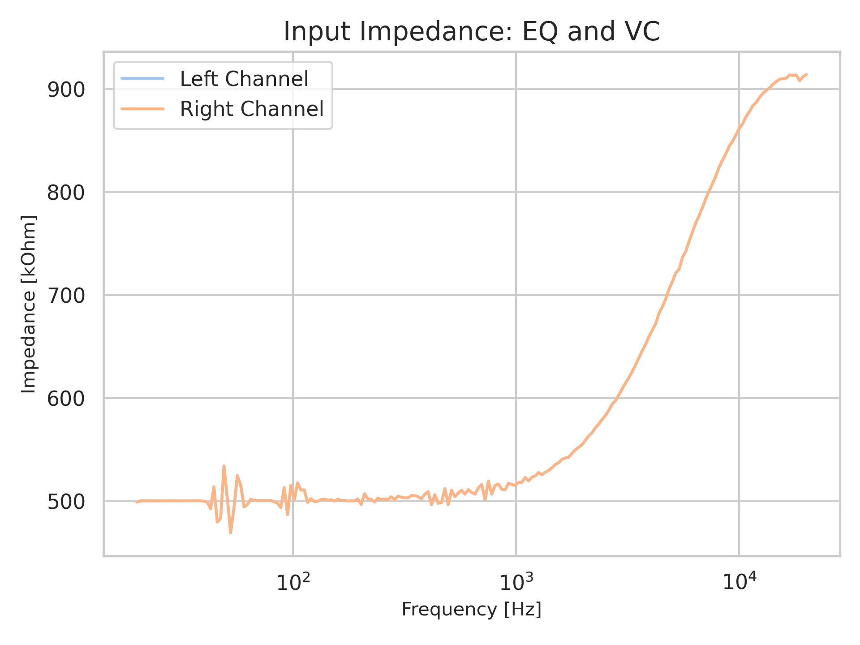
integration_test/eq_volctrl/zi_eq_volctrl.png
