Niclasapdk/ESD4_project/integration_test/power_amplifier/freqresp_power_amplifier.png

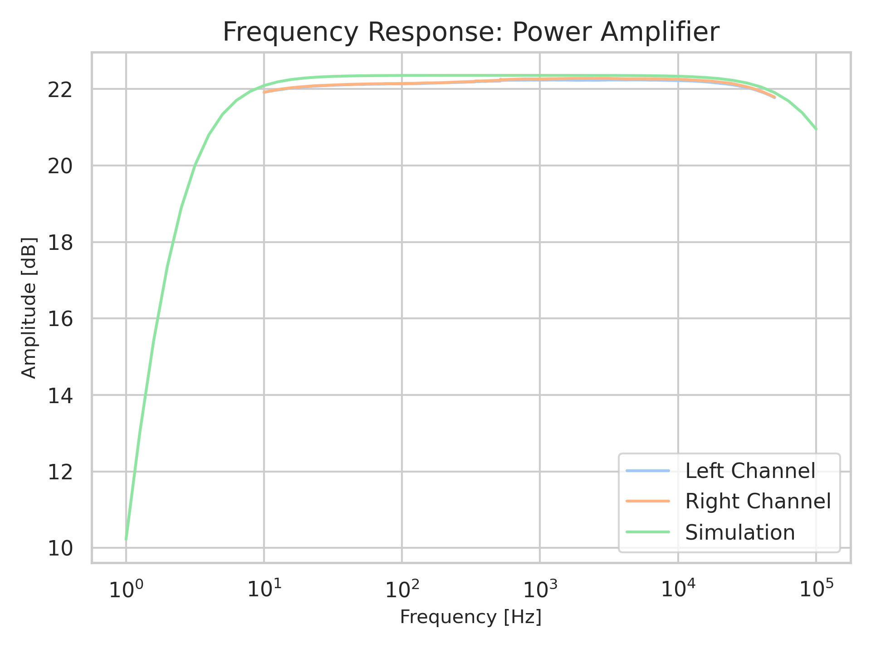
integration_test/power_amplifier/freqresp_power_amplifier.png
