Niclasapdk/ESD4_project/integration_test/power_amplifier/thd_power_amplifier.png

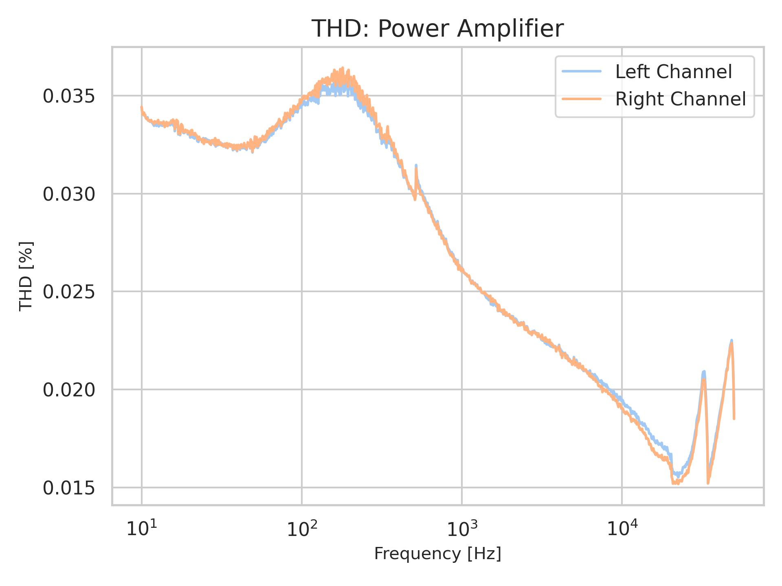
integration_test/power_amplifier/thd_power_amplifier.png
