Niclasapdk/ESD4_project/integration_test/power_amplifier/zi_power_amplifier.png

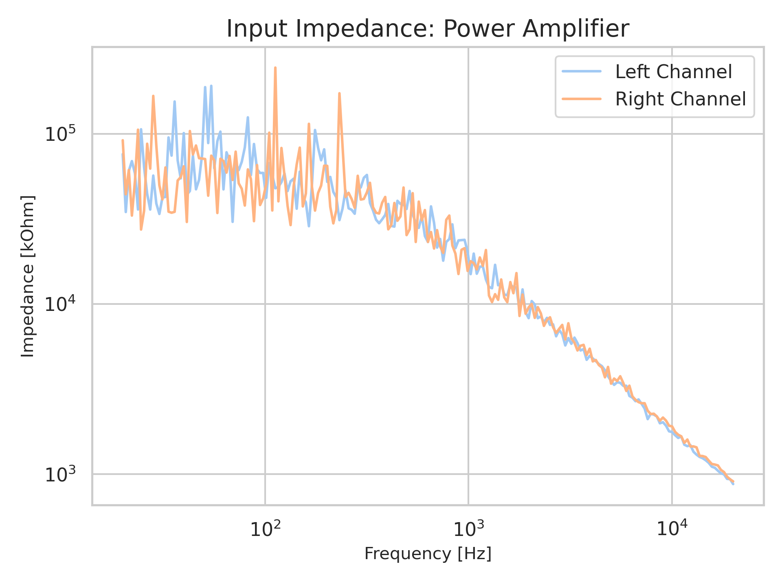
integration_test/power_amplifier/zi_power_amplifier.png
