Niclasapdk/ESD4_project/integration_test/preamp_class_a/fig_freq_resp_both_channels.jpg

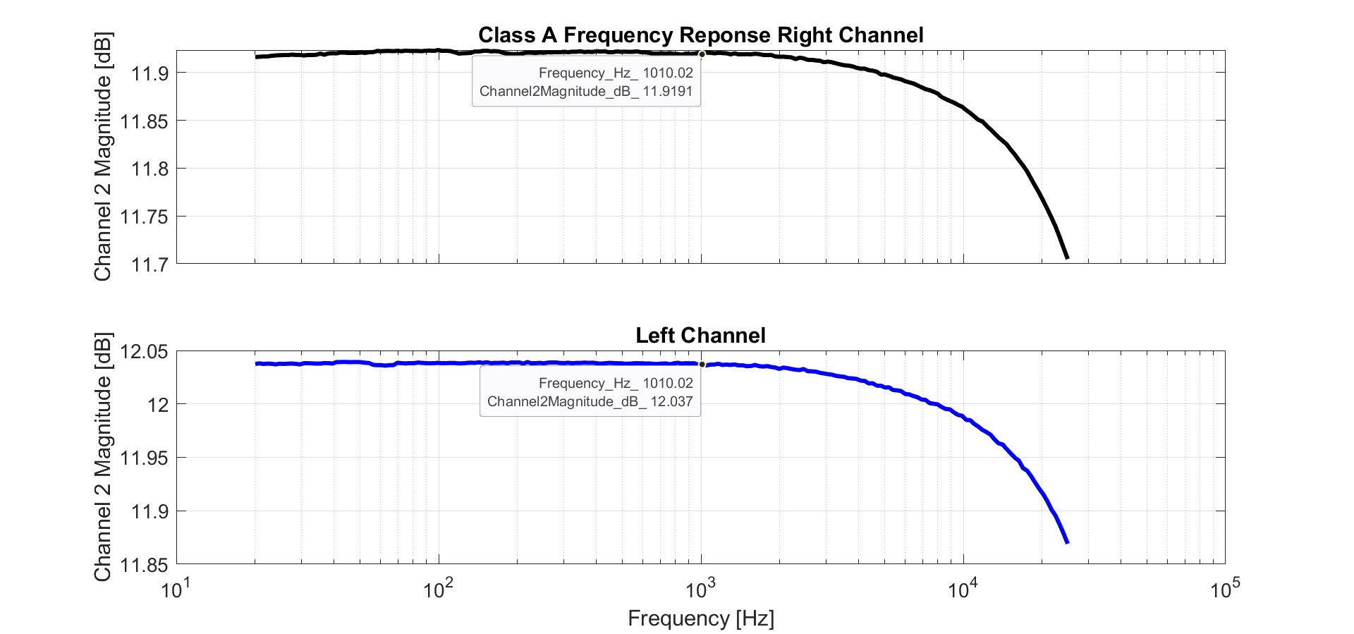
integration_test/preamp_class_a/fig_freq_resp_both_channels.jpg
