Niclasapdk/ESD4_project/integration_test/preamp_class_a/zi_preamp_class_a.png

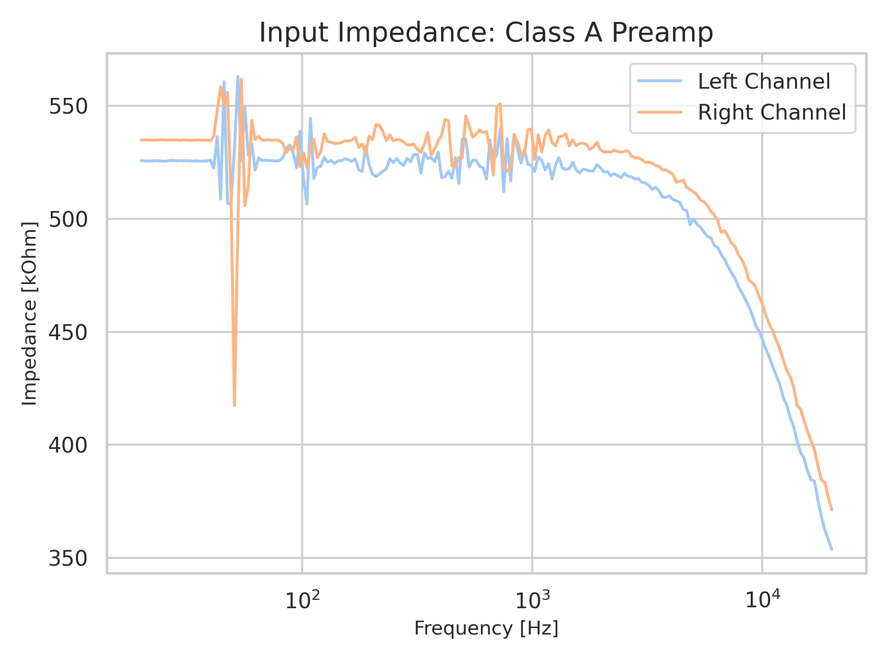
integration_test/preamp_class_a/zi_preamp_class_a.png
