Niclasapdk/ESD4_project/integration_test/preamp_opamp/zi_preamp_opamp.png

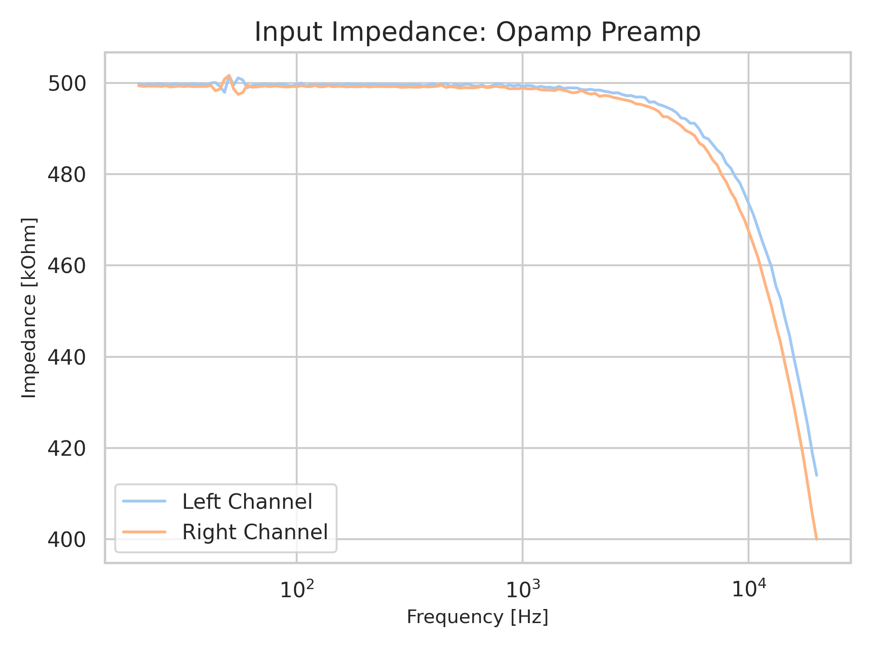
integration_test/preamp_opamp/zi_preamp_opamp.png
