Niclasapdk/ESD4_project/integration_test/preamp_opamp/zo_preamp_opamp.png

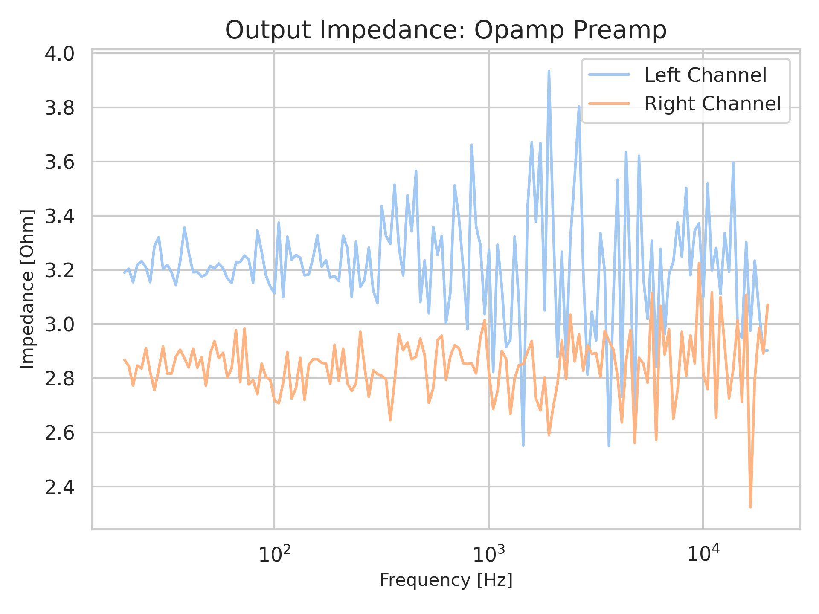
integration_test/preamp_opamp/zo_preamp_opamp.png
