Niclasapdk/ESD4_project/integration_test/preamp_riaa/freqresp_preamp_riaa.png

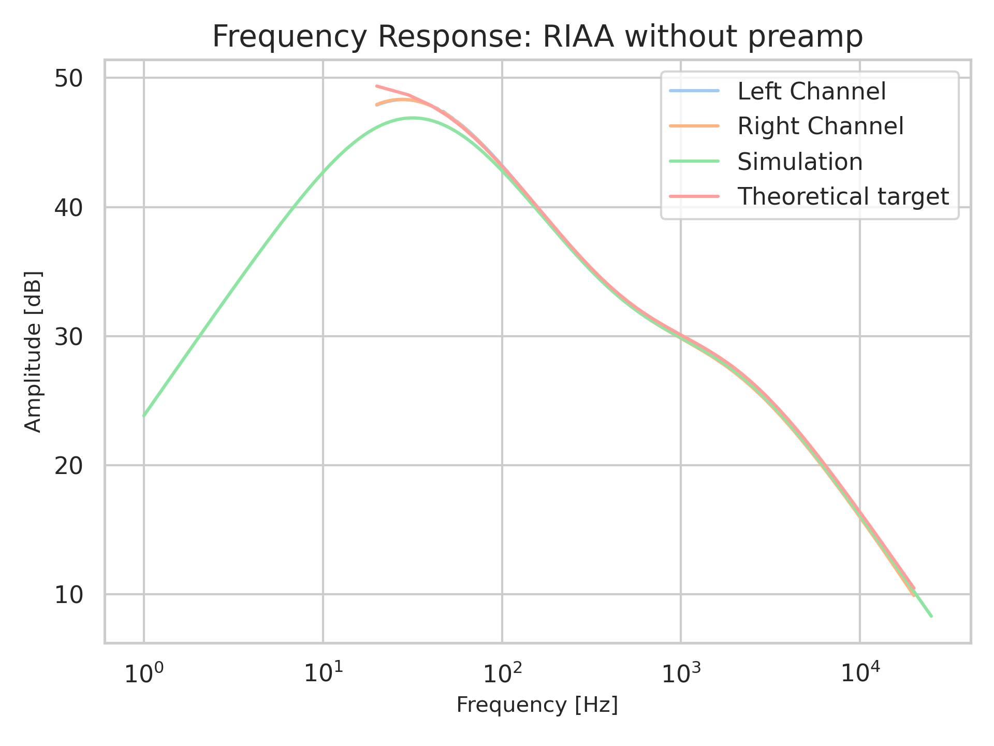
integration_test/preamp_riaa/freqresp_preamp_riaa.png
