Niclasapdk/ESD4_project/integration_test/preamp_riaa/thd_preamp_riaa.png

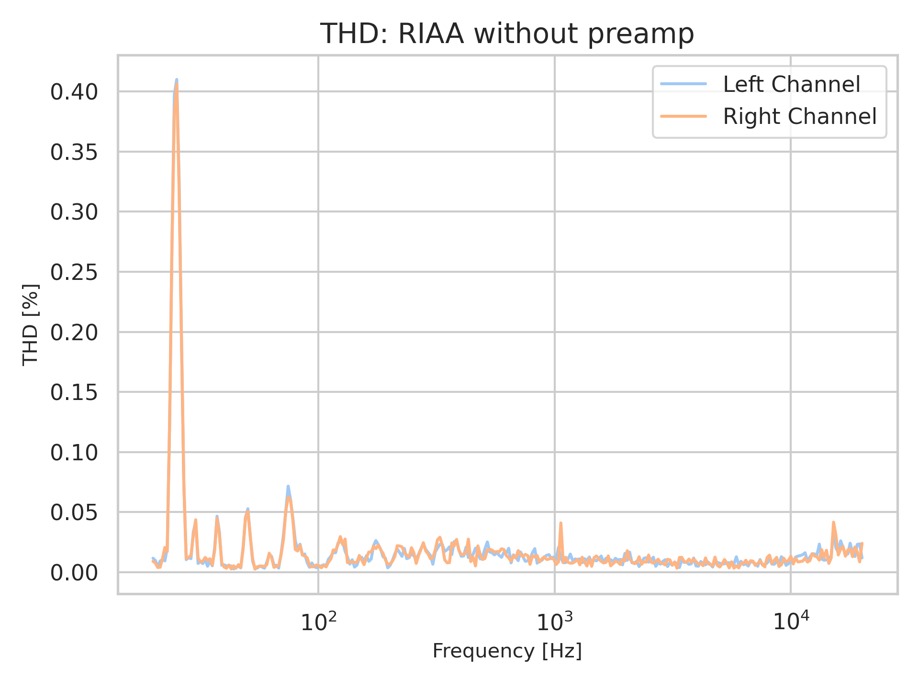
integration_test/preamp_riaa/thd_preamp_riaa.png
