Niclasapdk/ESD4_project/integration_test/preamp_riaa/zi_preamp_riaa.png

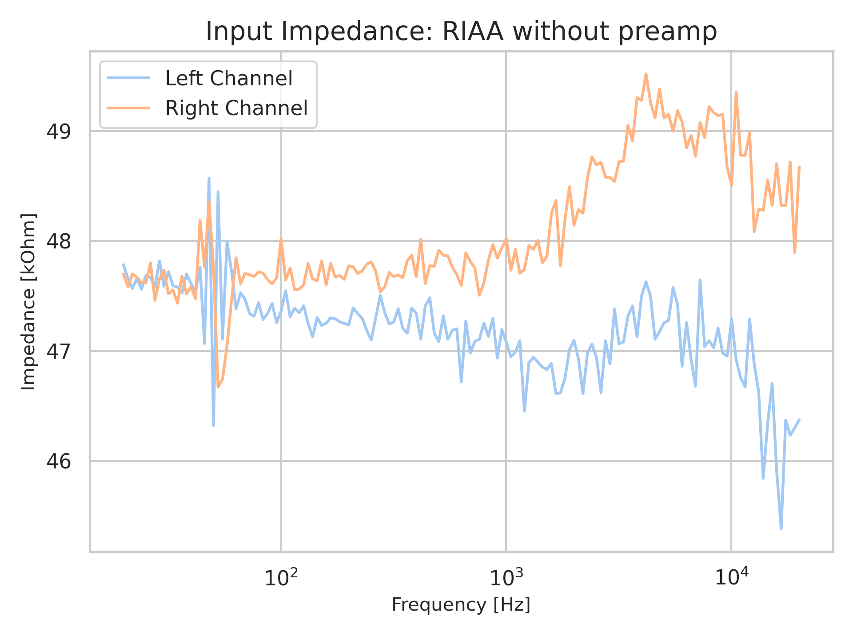
integration_test/preamp_riaa/zi_preamp_riaa.png
