Niclasapdk/ESD4_project/integration_test/preamp_riaa_opamp/freqresp_preamp_riaa_opamp.png

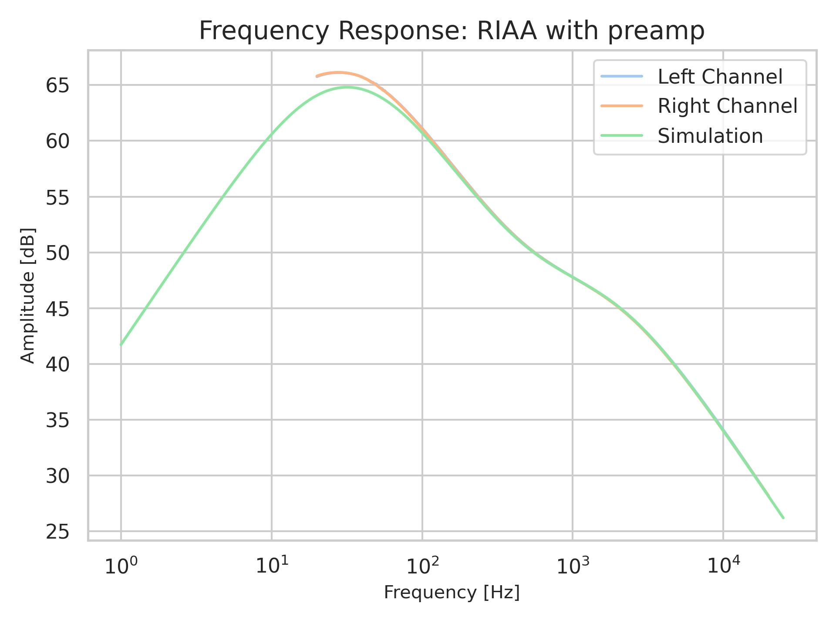
integration_test/preamp_riaa_opamp/freqresp_preamp_riaa_opamp.png
