Niclasapdk/ESD4_project/test_journals/29-02-24new-transistor-bias.md

# Transistor bias measurements

## Purpose

The PNP power transistor burns/breaks when the biasing is to high (read correct)
therefore a lab test will be done to  

## Method

Therefore the:
- Voltage between the bases can be measured.
- The output of the amplifier can be measured.
- Measure output at different bias voltages.

## Results
|bias voltage|output voltage| power draw |
|---|---| --- |
| +1.14  / -1.041 | | +0.019 / 0.03|
| +1.34 / -1.36 | | +0.06 / -0.078*| 
|  | | | 

\* continous increasing current

## Notes
input signal 37.1mvPP
ops_npn 1.56V
ops_pnp -1.06V

Det virker til at vores problem er at den ene biasing spænding er meget højere end den anden, og største delen af vores signal derfor ryger i PNP det giver også mening at det kun er den der sprænger så

dette scenarie sker først når et input signal sendes ind
