Niclasapdk/ESD4_project/test_journals/templates/exampledata1.tsv

% | Date: | 2024-04-15 | Time: | 12:05:10
% | Sampling frequency |  | [Hz]: | 50000
% | Generator amplitude |  | [V]: | 0.44700
% | Settle time |  | [s]: | 0.25000
% | Settle cycles: |  |  | 5
% | Integration time |  | [s]: | 0.025000
% | Integration cycles: |  |  | 10
% Freq. | Amplitude | Phase | THD | HD 2 | HD 3 | HD 4 | HD 5
% [Hz] | [dB] | [deg] | [%] | [dB ref fund] | [dB ref fund] | [dB ref fund] | [dB ref fund]
2.0000E+1 | 1.1923E+1 | -1.7969E+2 | 1.1693E-2 | -7.8835E+1 | -9.9548E+1 | -1.1843E+2 | -9.3150E+1
2.0706E+1 | 1.1923E+1 | -1.7971E+2 | 1.1575E-2 | -7.8777E+1 | -9.9507E+1 | -1.1865E+2 | -1.0506E+2
2.1438E+1 | 1.1923E+1 | -1.7972E+2 | 1.0977E-2 | -7.9268E+1 | -9.7091E+1 | -1.0909E+2 | -1.1230E+2
2.2195E+1 | 1.1923E+1 | -1.7974E+2 | 1.2117E-2 | -7.8368E+1 | -9.9904E+1 | -1.1773E+2 | -1.0761E+2
2.2979E+1 | 1.1923E+1 | -1.7975E+2 | 1.1848E-2 | -7.8563E+1 | -1.0013E+2 | -1.1795E+2 | -1.0799E+2
2.3791E+1 | 1.1923E+1 | -1.7977E+2 | 1.7626E-2 | -7.5103E+1 | -9.7621E+1 | -1.0927E+2 | -1.1379E+2
2.4631E+1 | 1.1923E+1 | -1.7978E+2 | 1.8488E-2 | -7.4706E+1 | -1.0008E+2 | -9.6413E+1 | -1.0937E+2
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
