Niclasapdk/ESD4_project/test_journals/templates/exampledata2.tsv

% | Date: | 2024-04-15 | Time: | 12:02:45
% | Sampling frequency |  | [Hz]: | 50000
% | Generator amplitude |  | [V]: | 0.44700
% | Settle time |  | [s]: | 0.25000
% | Settle cycles: |  |  | 5
% | Integration time |  | [s]: | 0.025000
% | Integration cycles: |  |  | 10
% Freq. | Amplitude | Phase | THD | HD 2 | HD 3 | HD 4 | HD 5
% [Hz] | [dB] | [deg] | [%] | [dB ref fund] | [dB ref fund] | [dB ref fund] | [dB ref fund]
2.0000E+1 | 1.1899E+1 | -1.7971E+2 | 1.0876E-2 | -7.9532E+1 | -9.8293E+1 | -1.1403E+2 | -9.2680E+1
2.0706E+1 | 1.1900E+1 | -1.7972E+2 | 1.0425E-2 | -7.9689E+1 | -9.9958E+1 | -1.1433E+2 | -1.0706E+2
2.1438E+1 | 1.1900E+1 | -1.7974E+2 | 1.0486E-2 | -7.9637E+1 | -9.9894E+1 | -1.1808E+2 | -1.0685E+2
2.2195E+1 | 1.1900E+1 | -1.7975E+2 | 1.0294E-2 | -7.9804E+1 | -9.9467E+1 | -1.1607E+2 | -1.0720E+2
2.2979E+1 | 1.1900E+1 | -1.7976E+2 | 8.8374E-3 | -8.1142E+1 | -9.9852E+1 | -1.2137E+2 | -1.0761E+2
2.3791E+1 | 1.1900E+1 | -1.7978E+2 | 6.7786E-3 | -8.3491E+1 | -1.0008E+2 | -1.1644E+2 | -1.0733E+2
2.4631E+1 | 1.1900E+1 | -1.7979E+2 | 2.8424E-2 | -7.0946E+1 | -9.8013E+1 | -9.7305E+1 | -1.0516E+2
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
