Niclasapdk/ESD4_project/test_journals/images/EQAllEven.png

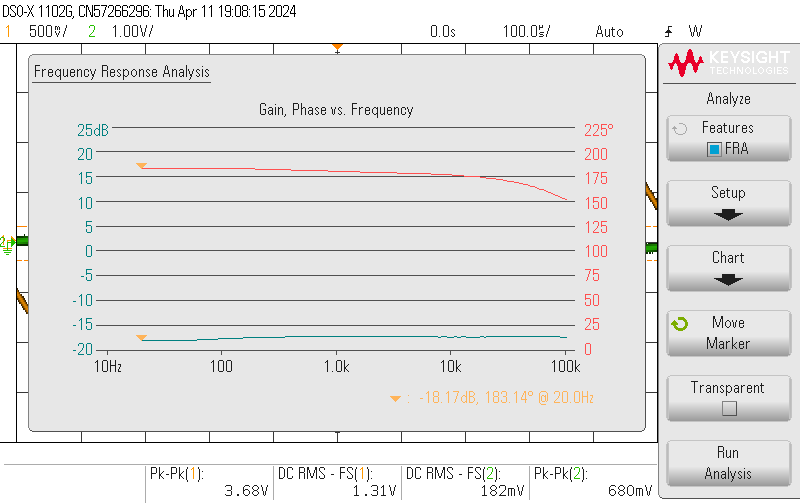
test_journals/images/EQAllEven.png
