Niclasapdk/ESD4_project/test_journals/images/EQAllHigh.png

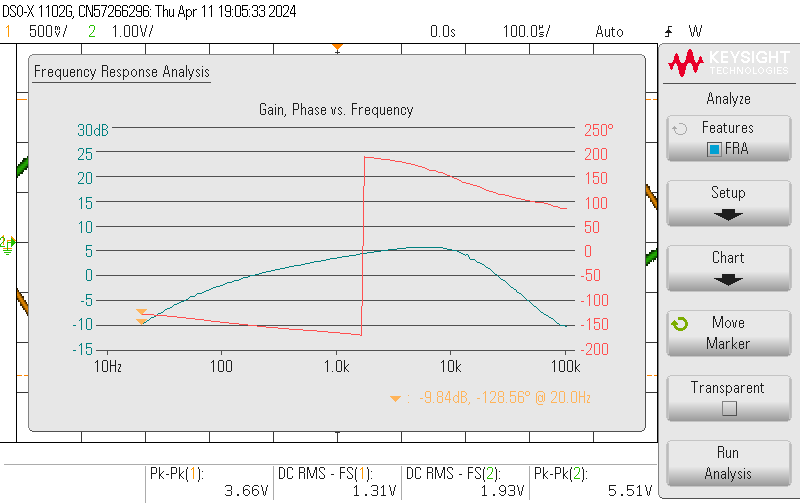
test_journals/images/EQAllHigh.png
