Niclasapdk/ESD4_project/test_journals/images/EQAllLow.png

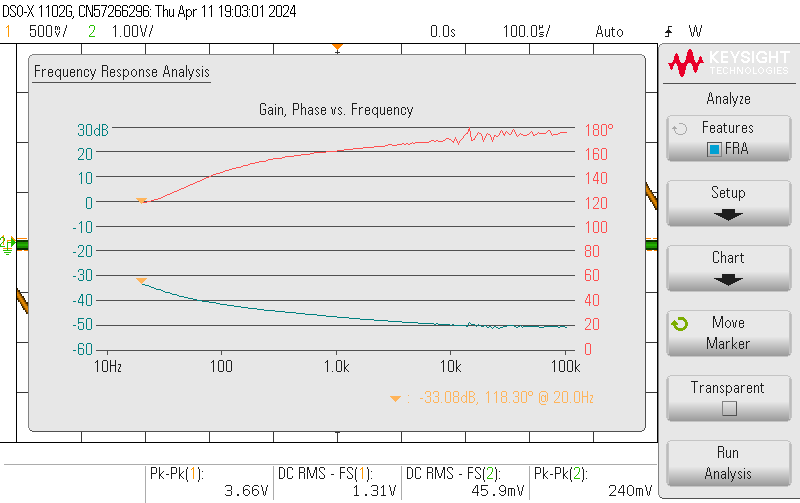
test_journals/images/EQAllLow.png
