Niclasapdk/ESD4_project/test_journals/images/scope_0.png

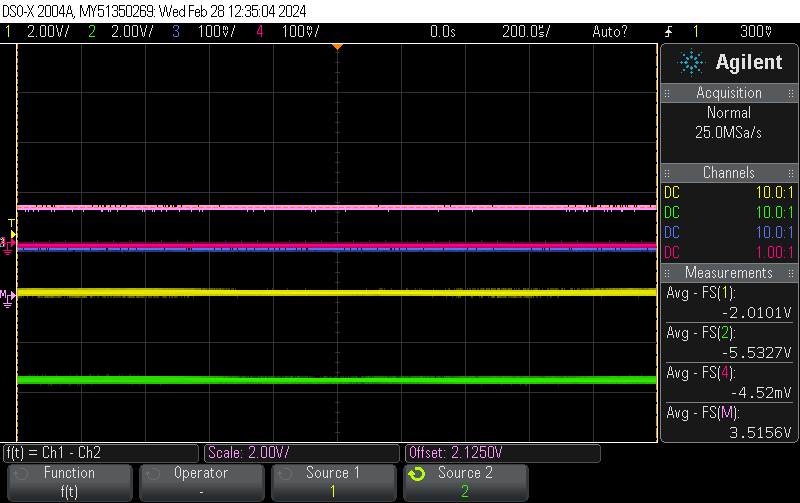
test_journals/images/scope_0.png
