Niclasapdk/ESD4_project/test_journals/images/scope_1.png

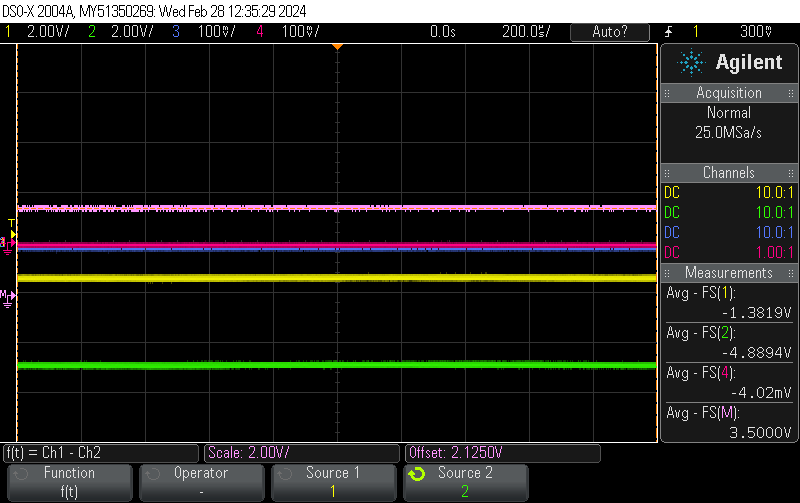
test_journals/images/scope_1.png
