Niclasapdk/ESD4_project/test_journals/images/scope_2.png

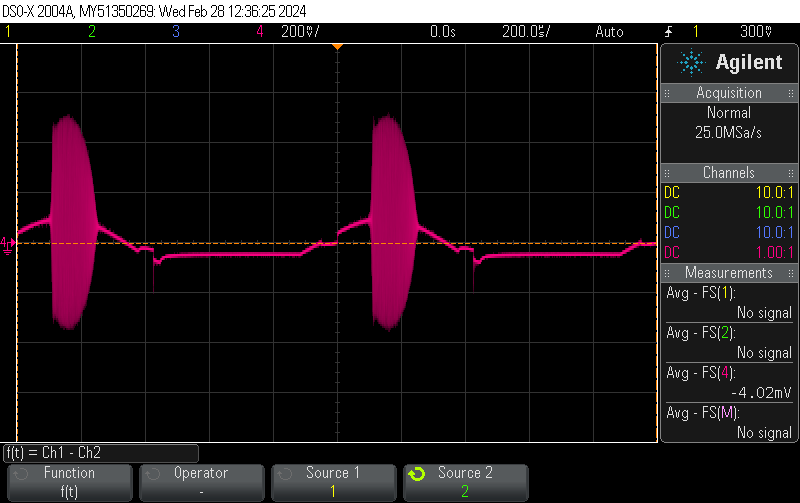
test_journals/images/scope_2.png
