Niclasapdk/ESD4_project/test_journals/images/scope_3.png

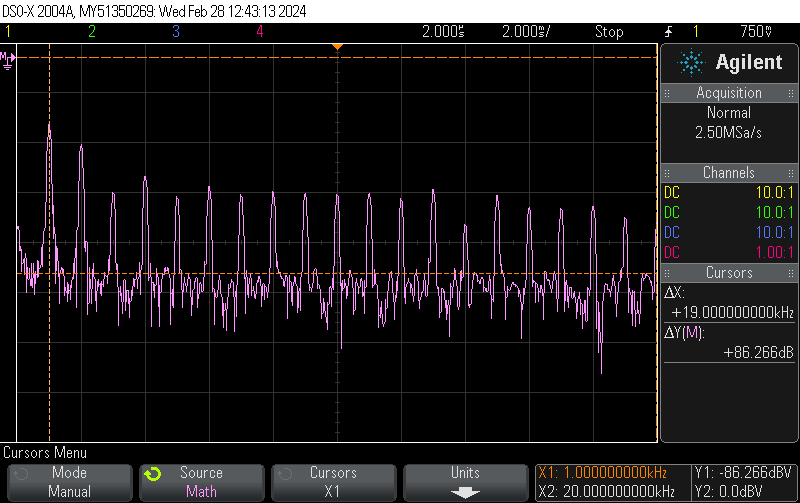
test_journals/images/scope_3.png
