Niclasapdk/ESD4_project/test_journals/images/scope_5.png

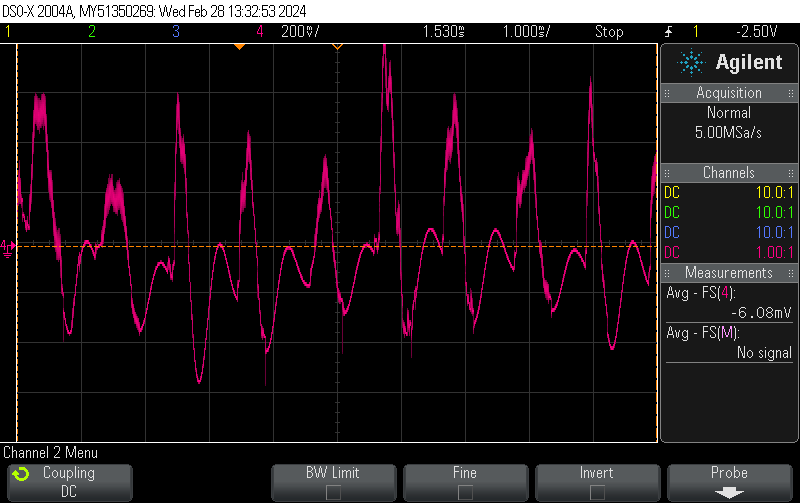
test_journals/images/scope_5.png
