Niclasapdk/ESD4_project/test_journals/images/scope_6.png

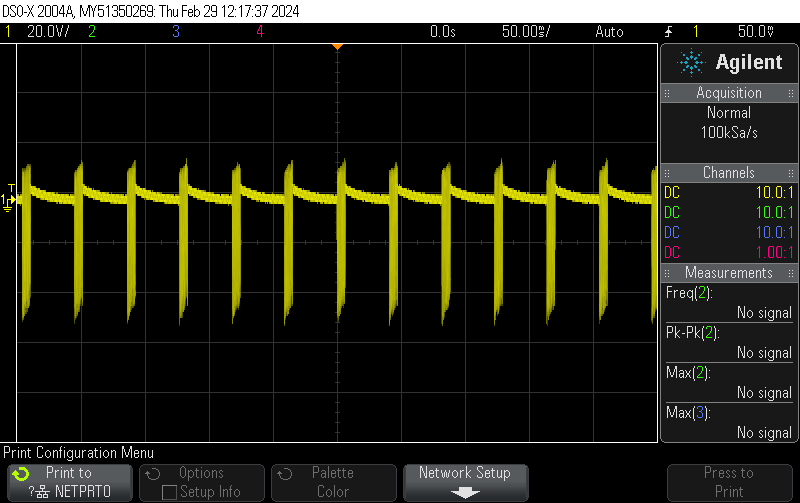
test_journals/images/scope_6.png
