Niclasapdk/ESD4_project/test_journals/images/scope_7.png

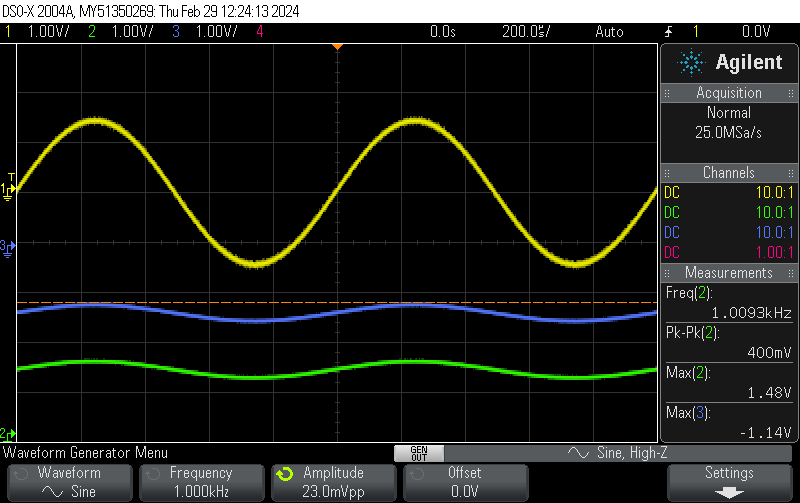
test_journals/images/scope_7.png
