Niclasapdk/ESD4_project/test_journals/preamp/oscilloscope_data/class_a_freq_response_l.png

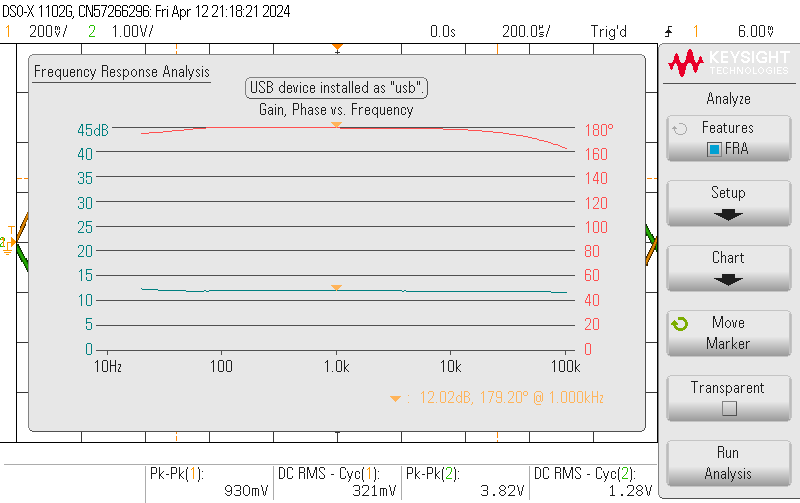
test_journals/preamp/oscilloscope_data/class_a_freq_response_l.png
