Niclasapdk/ESD4_project/figures/system_design/final_riaa_component/final_riaa_component.pdf

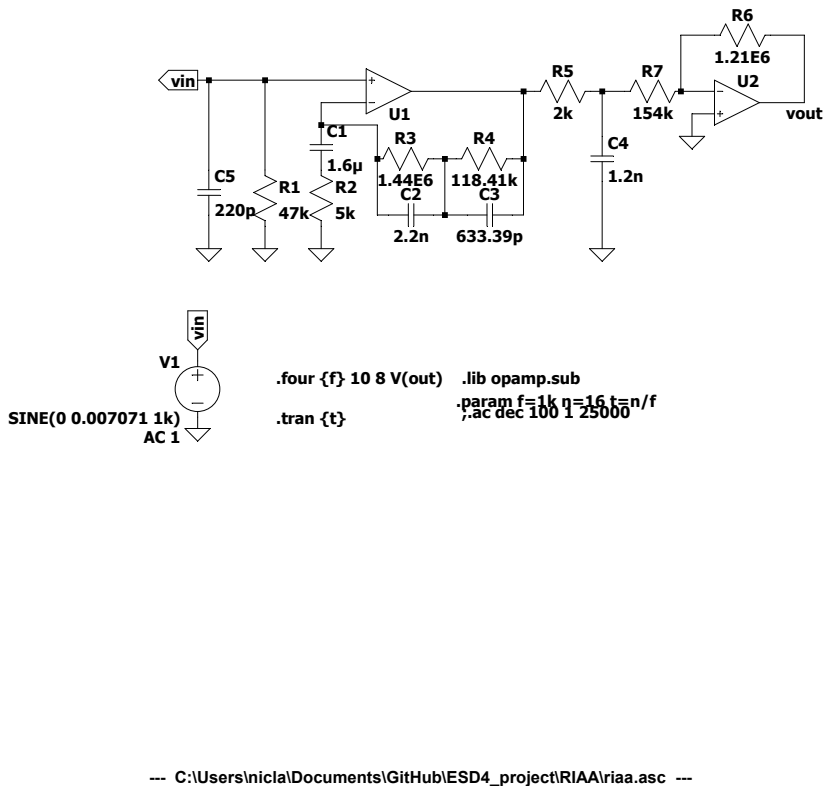
[picture p166: page 1]

.four {f} 10 8 V(out) .lib opamp.sub
.param f=1k n=16 t=n/f ;.ac dec 100 1 25000 .tran {t}

--- C:\Users\nicla\Documents\GitHub\ESD4_project\RIAA\riaa.asc ---
