Niclasapdk/ESD4_project/figures/system_design/final_pa/final_pa.pdf

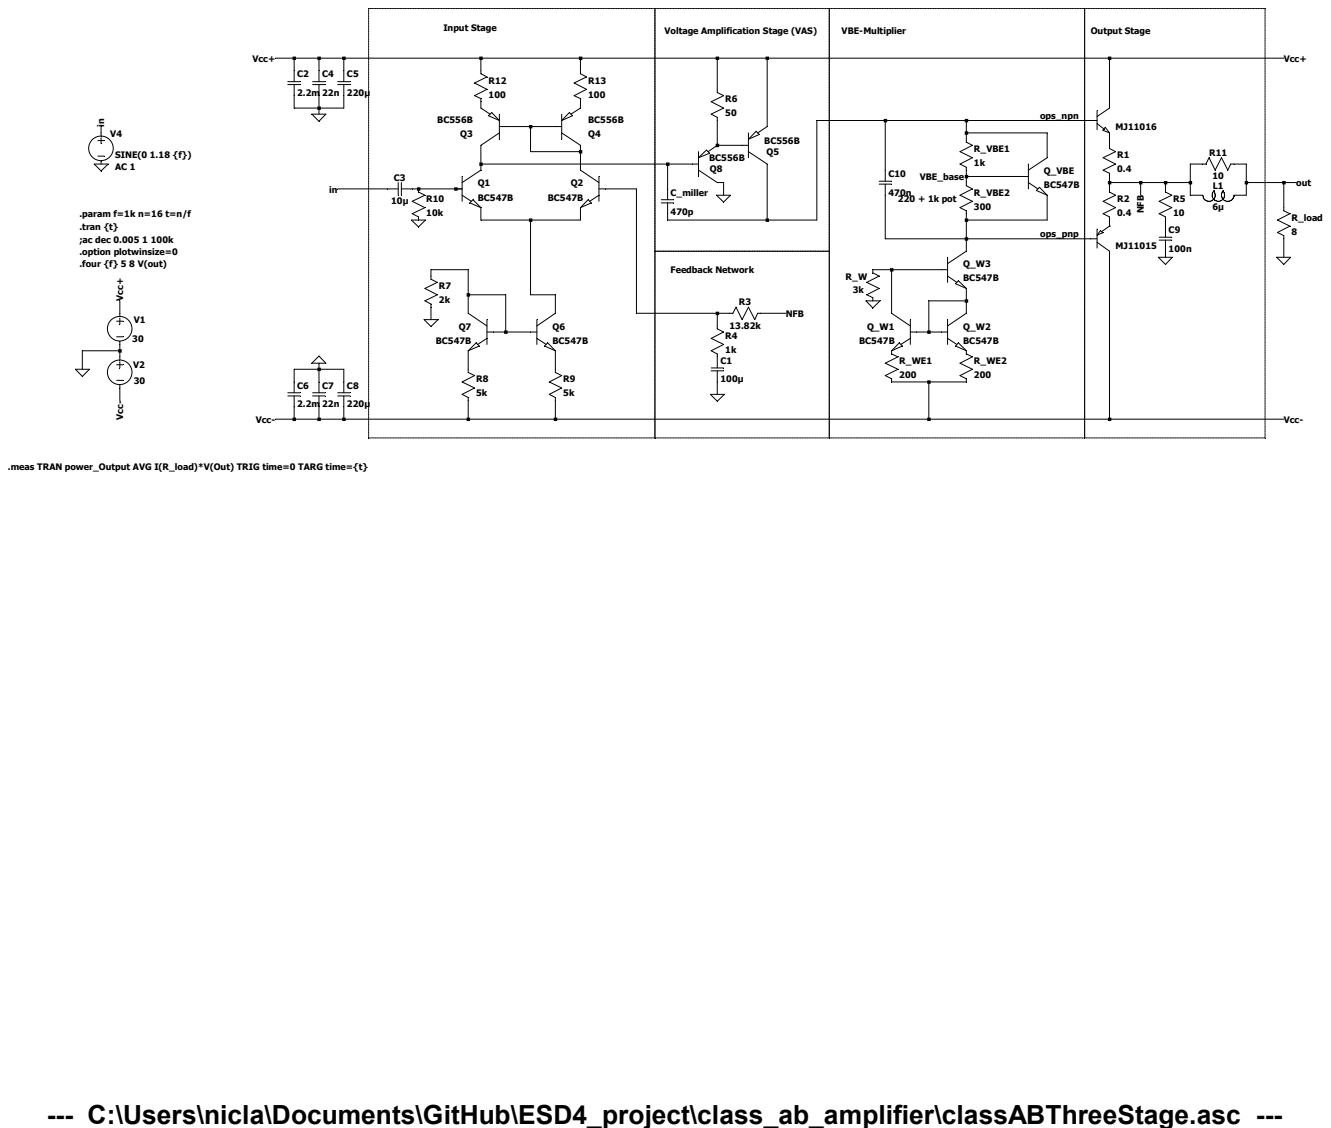
[picture p167: page 1]

R12 100 | R13 100 | Voltage Amplification Stage (VAS) Input Stage | VBE-Multiplier ops_npn | Output Stage | R11 R1 6µ | Vcc+ Vcc⁻ Vcc+ in

.meas TRAN power_Output AVG I(R_load)*V(Out) TRIG time=0 TARG time={t}

--- C:\Users\nicla\Documents\GitHub\ESD4_project\class_ab_amplifier\classABThreeStage.asc ---
