Niclasapdk/ESD4_project/figures/system_design/filtering/sallen_key_hp_lp.pdf

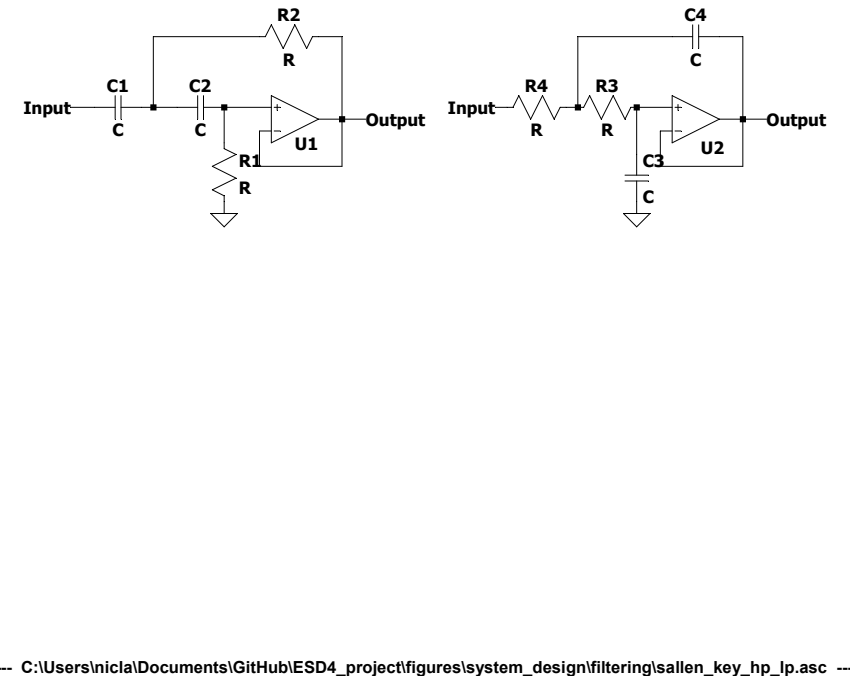
[picture p168: page 1]

--- C:\Users\nicla\Documents\GitHub\ESD4_project\figures\system_design\filtering\sallen_key_hp_lp.asc ---
