Niclasapdk/ESD4_project/pcb/class_ab_three_stage_orig/class_ab_three_stage.pdf

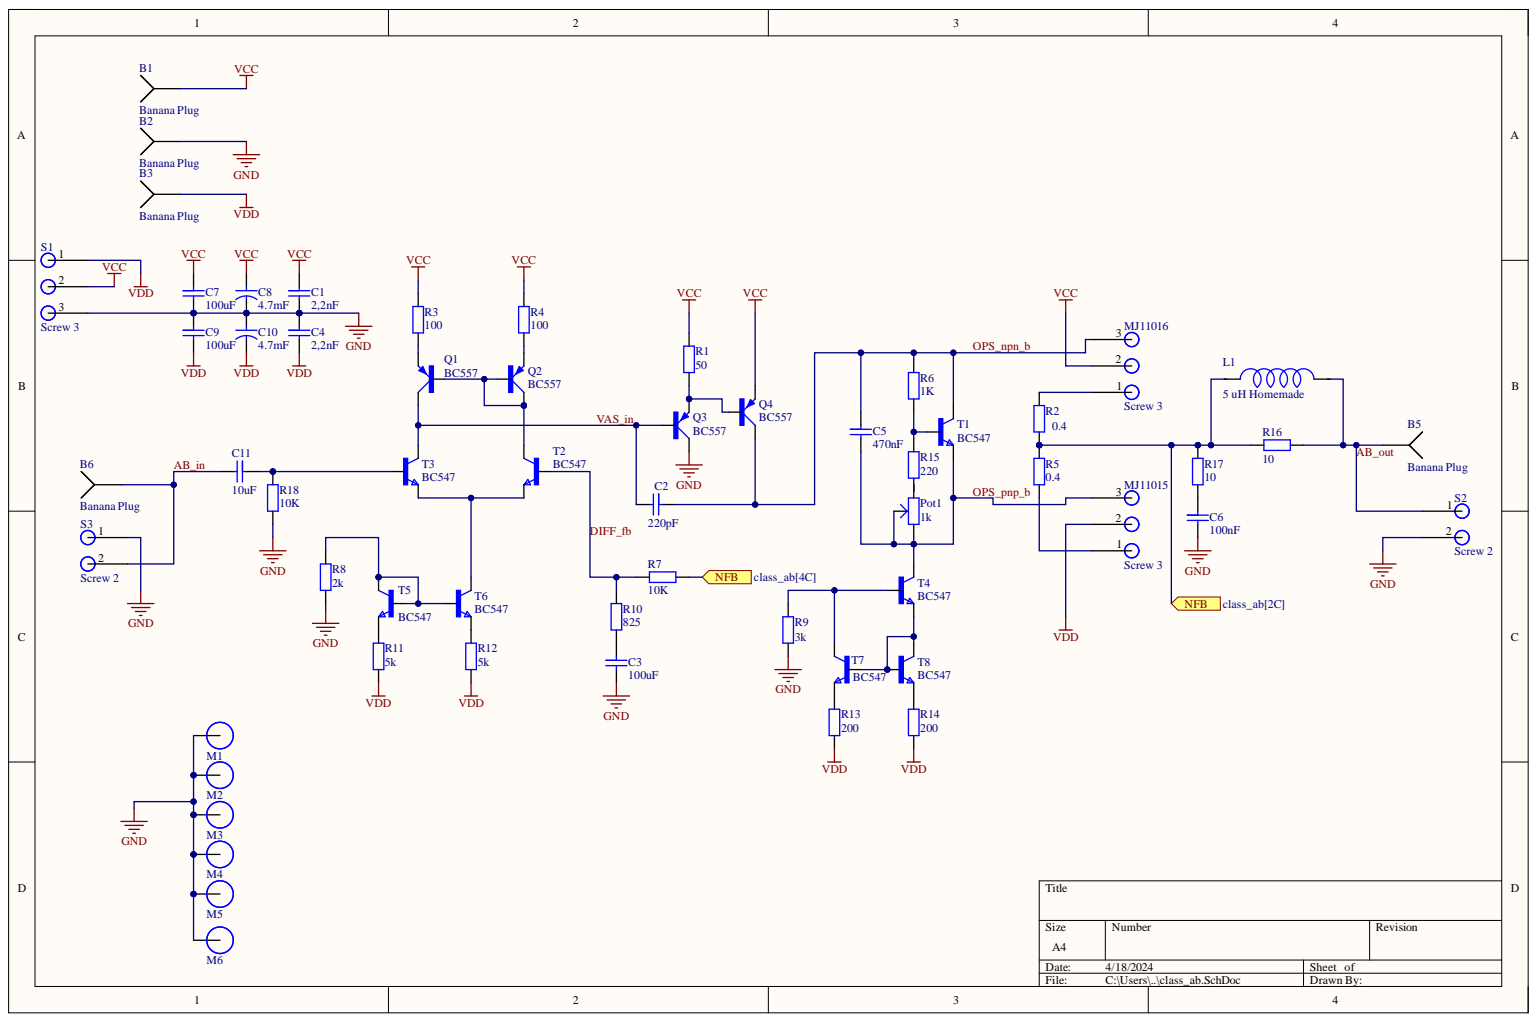
[picture p169: page 1]

DIFF_fb | GND

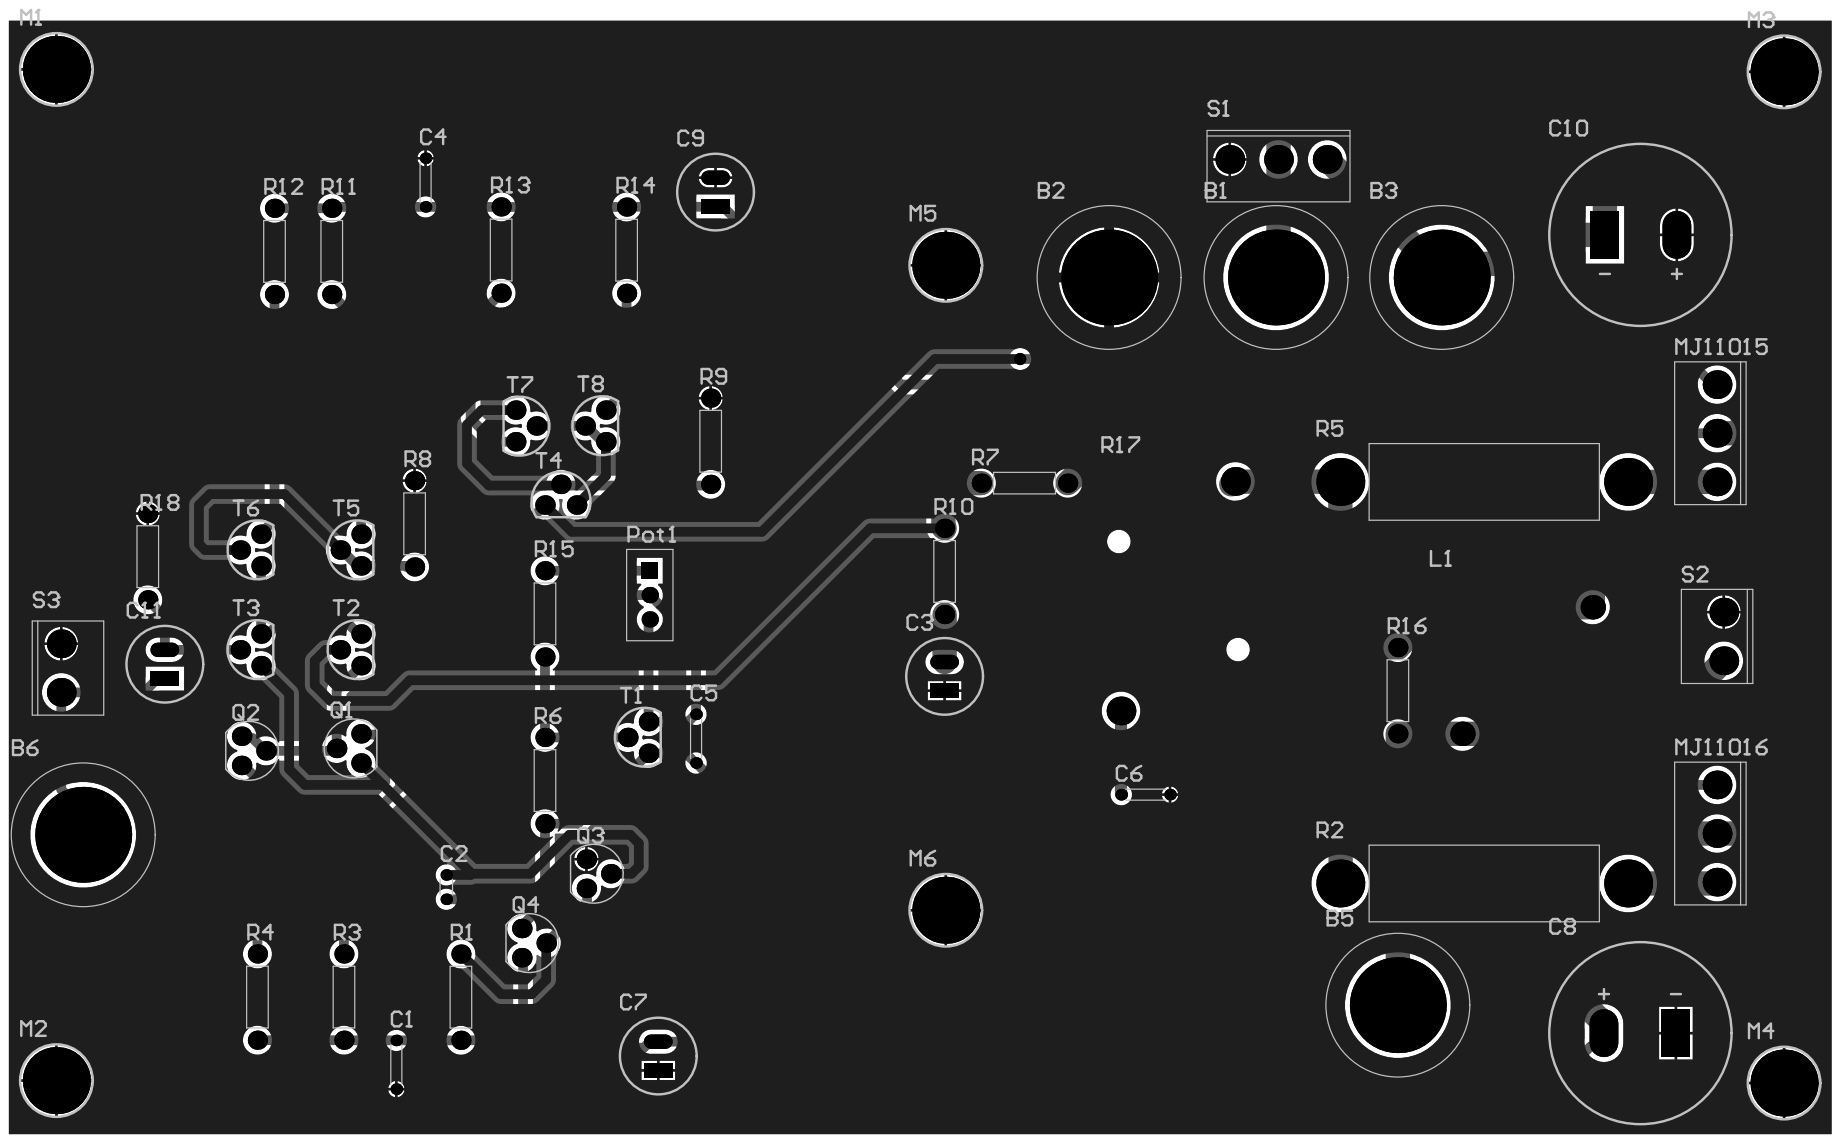
[picture p170: page 2]

Comment | Description | Designator | Footprint | LibRef | Quantity
BananaPlug | | B1, B2, B3, B5, B6 | BananaPlugOntop | BananaPlug | 5
Cap | | C1, C4, C5, C6 | Cap-1 | Capacitor 1space | 4
Cap | | C2 | Cap-0 | Capacitor 0space | 1
Cap | | C3, C7, C9, C11 | CapØ8 | Capacitor unpolarized | 4
Cap | | C8, C10 | CapLyt Ø18 | Capacitor electrolytic | 2
5uHHomemade | | L1 | homecookedinductor | homemadeinductor | 1
ScrewHole | | M1, M2, M3, M4, M5, M6 | M3Hole | ScrewHole | 6
Screw3 | | MJ11015, MJ11016, S1 | Screw-3 | Screw3 | 3
Pot Trim | Potentiometer | Pot1 | Pot trimslimhigh | Pot Trim | 1
BC557 | Bipolar(BJT)Transistor PNP45V100mA 320MHz625mW ThroughHoleTO-92 (TO-226) | Q1, Q2, Q3, Q4 | SOT54A | BC557 | 4
Resistor | | R1, R3, R4, R6, R7, R8, R9, R10, R11, R12, R13, R14, R15, R16, R18 | RESTHT9mm | Resistor | 15
Resistor | | R2, R5 | RESTHT30mm | Resistor | 2
Resistor | | R17 | Power RES5watt | Resistor | 1
Screw2 | | S2, S3 | Screw-2 | Screw2 | 2
BC547 | TransGPBJTNPN45V 0.1A500mW3-PinTO-92T/R | T1, T2, T3, T4, T5, T6, T7, T8 | TO92 | BC547 | 8
