Niclasapdk/ESD4_project/figures/system_design/bandpass_filter_values/bandpass_filter_values.pdf

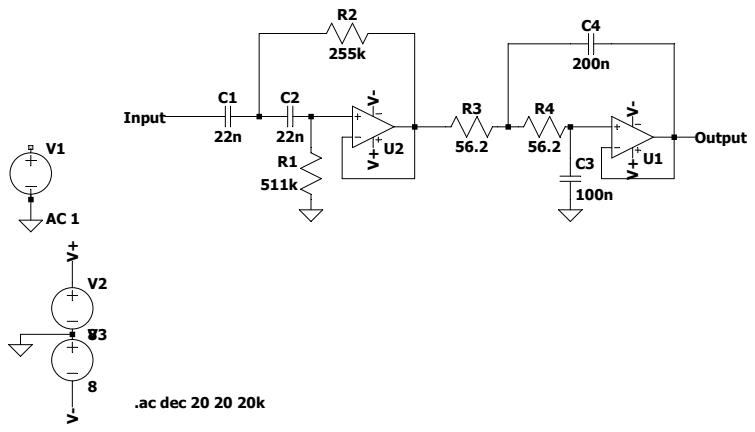
[picture p171: page 1]
