Niclasapdk/ESD4_project/figures/system_design/pa_after_theoretical_design/pa_after_theoretical_design.pdf

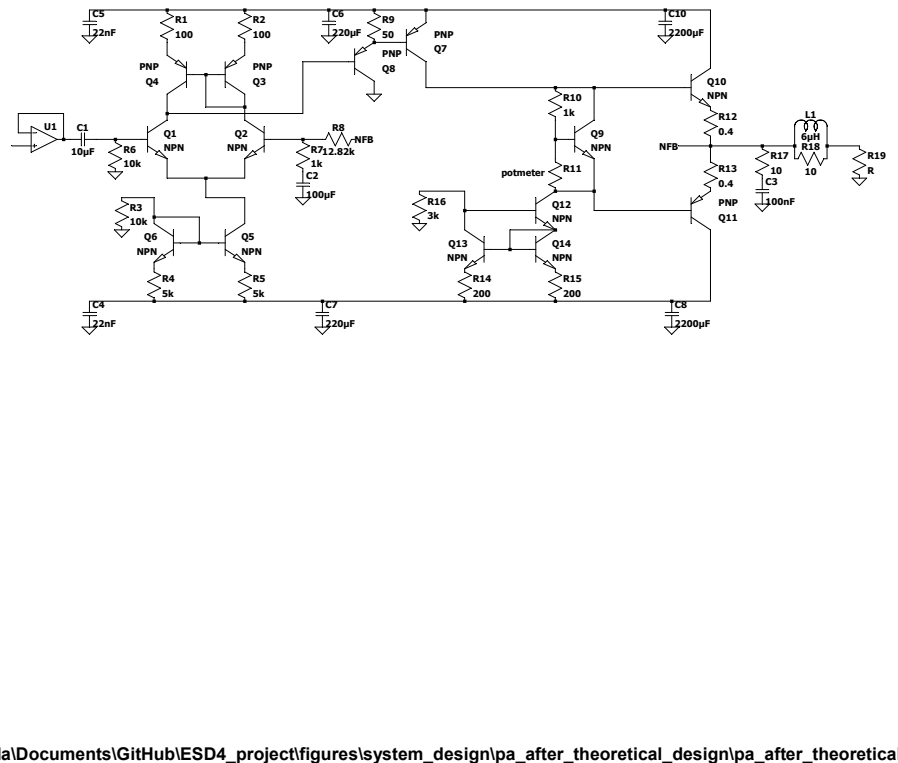
[picture p172: page 1]

--- C:\Users\nicla\Documents\GitHub\ESD4_project\figures\system_design\pa_after_theoretical_design\pa_after_theoretical_design.asc ---
