Niclasapdk/ESD4_project/figures/system_design/input_stage_with_current_mirror/input_stage_with_current_mirror.pdf

## PNP

## PNP

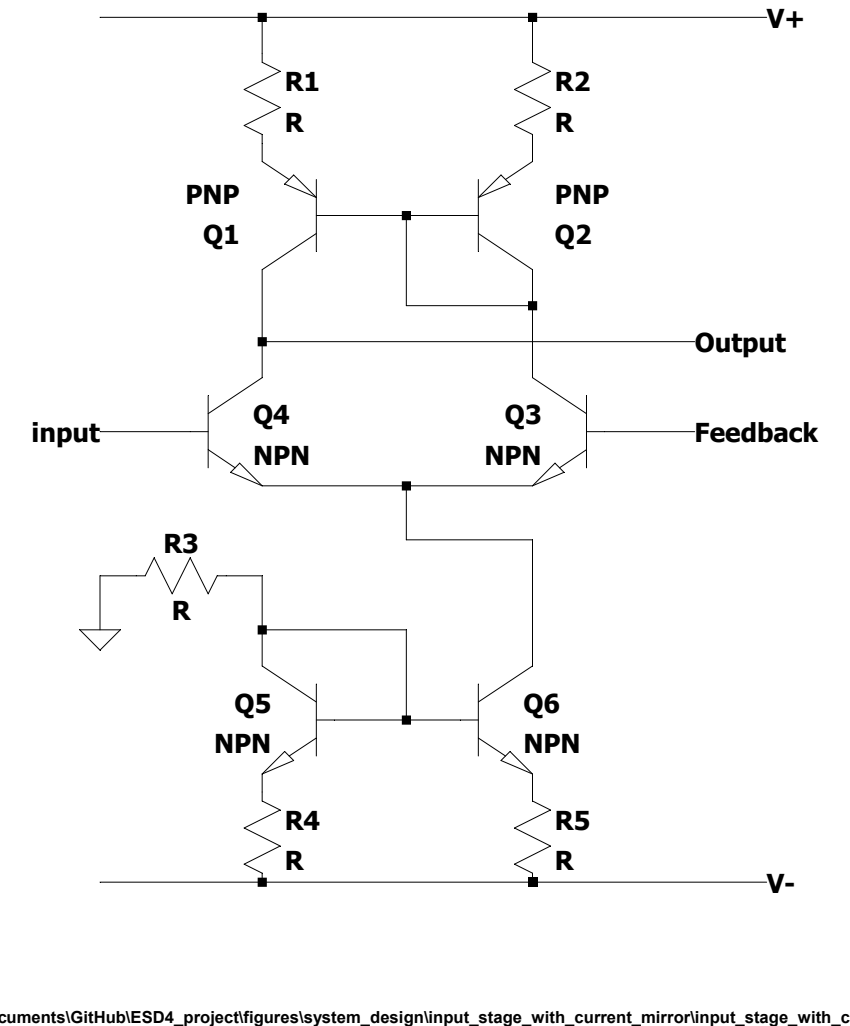
[picture p173: page 1]

--- C:\Users\nicla\Documents\GitHub\ESD4_project\figures\system_design\input_stage_with_current_mirror\input_stage_with_current_mirror.asc ---
