Niclasapdk/ESD4_project/figures/system_design/final_pa_topology/final_topology_pa.pdf

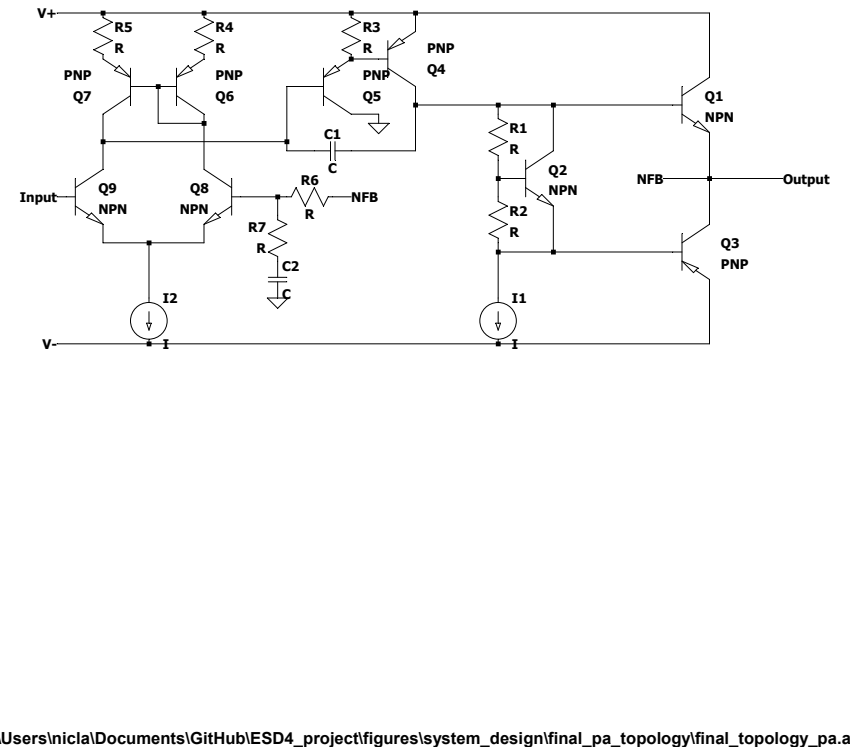
[picture p174: page 1]

--- C:\Users\nicla\Documents\GitHub\ESD4_project\figures\system_design\final_pa_topology\final_topology_pa.asc ---
