Niclasapdk/ESD4_project/figures/system_design/unregulated_powersupply/unregulated_powersupply.pdf

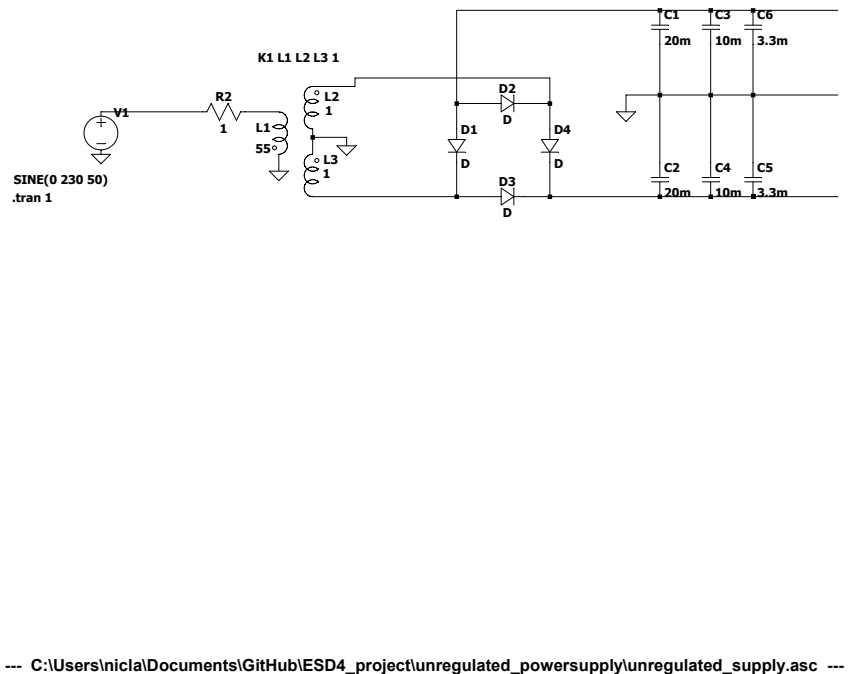
[picture p175: page 1]

--- C:\Users\nicla\Documents\GitHub\ESD4_project\unregulated_powersupply\unregulated_supply.asc ---
