Niclasapdk/ESD4_project/figures/system_design/bias_current_final/bias_current_final.pdf

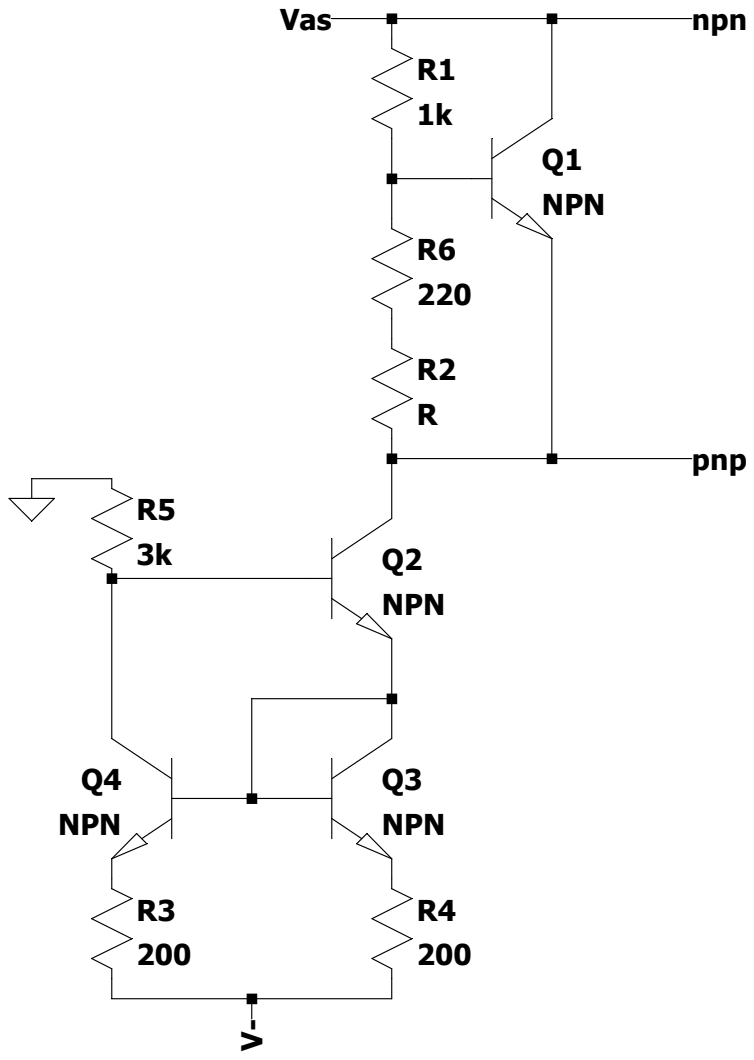
[picture p176: page 1]
