Niclasapdk/ESD4_project/figures/system_design/output_stage_current_mirror/output_stage_current_mirror.pdf

Q1

R1

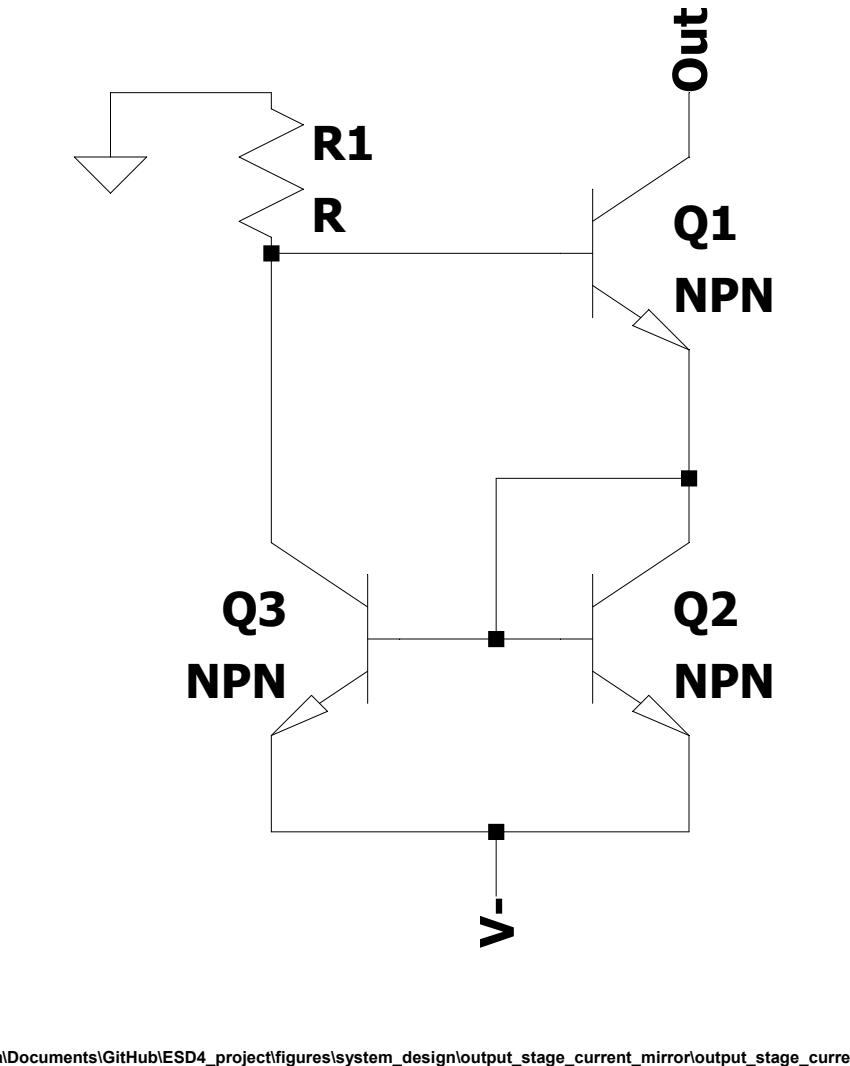
[picture p177: page 1]
NPN; Q2 NPN; Q3 NPN

--- C:\Users\nicla\Documents\GitHub\ESD4_project\figures\system_design\output_stage_current_mirror\output_stage_current_mirror.asc ---
