Niclasapdk/ESD4_project/figures/system_design/riaa_preamp/complete_riaa_topology.pdf

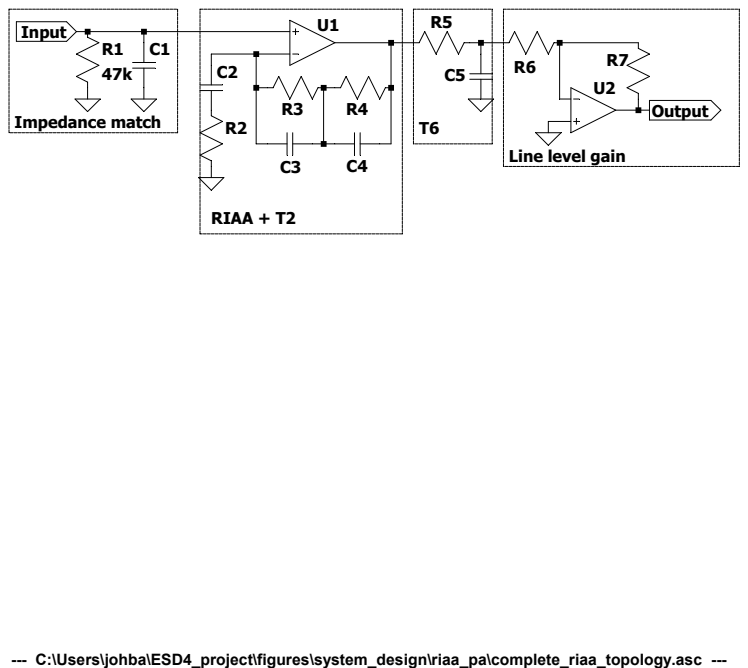
[picture p178: page 1]

--- C:\Users\johba\ESD4_project\figures\system_design\riaa_pa\complete_riaa_topology.asc ---
