Niclasapdk/ESD4_project/figures/system_design/three_stage_pa/three_stage_pa.pdf

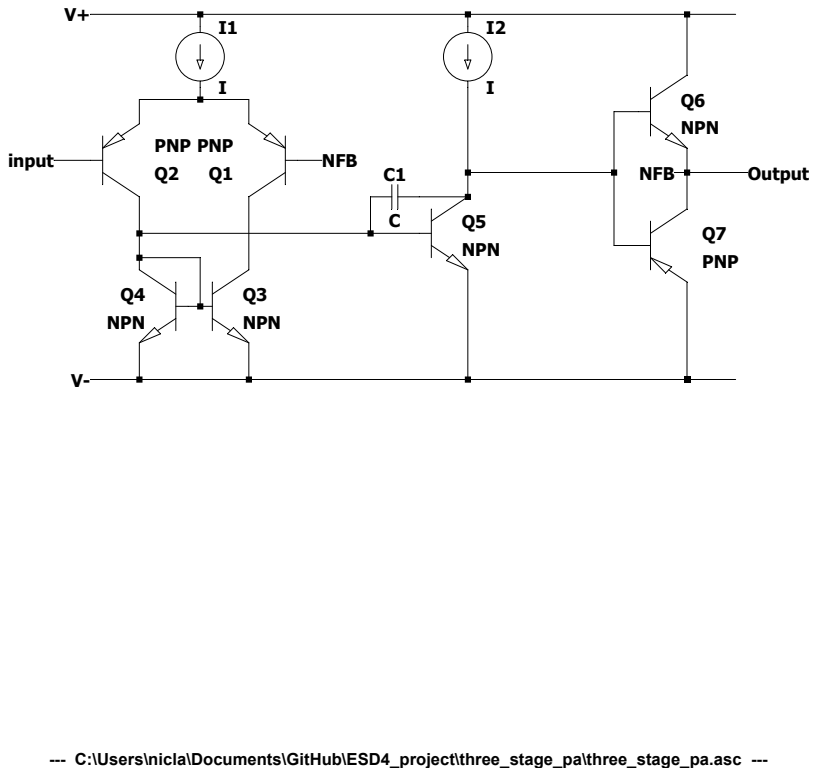
[picture p179: page 1]

--- C:\Users\nicla\Documents\GitHub\ESD4_project\three_stage_pa\three_stage_pa.asc ---
