Niclasapdk/ESD4_project/pcb/class_ab_three_stage_orig/class_ab_pcb.pdf

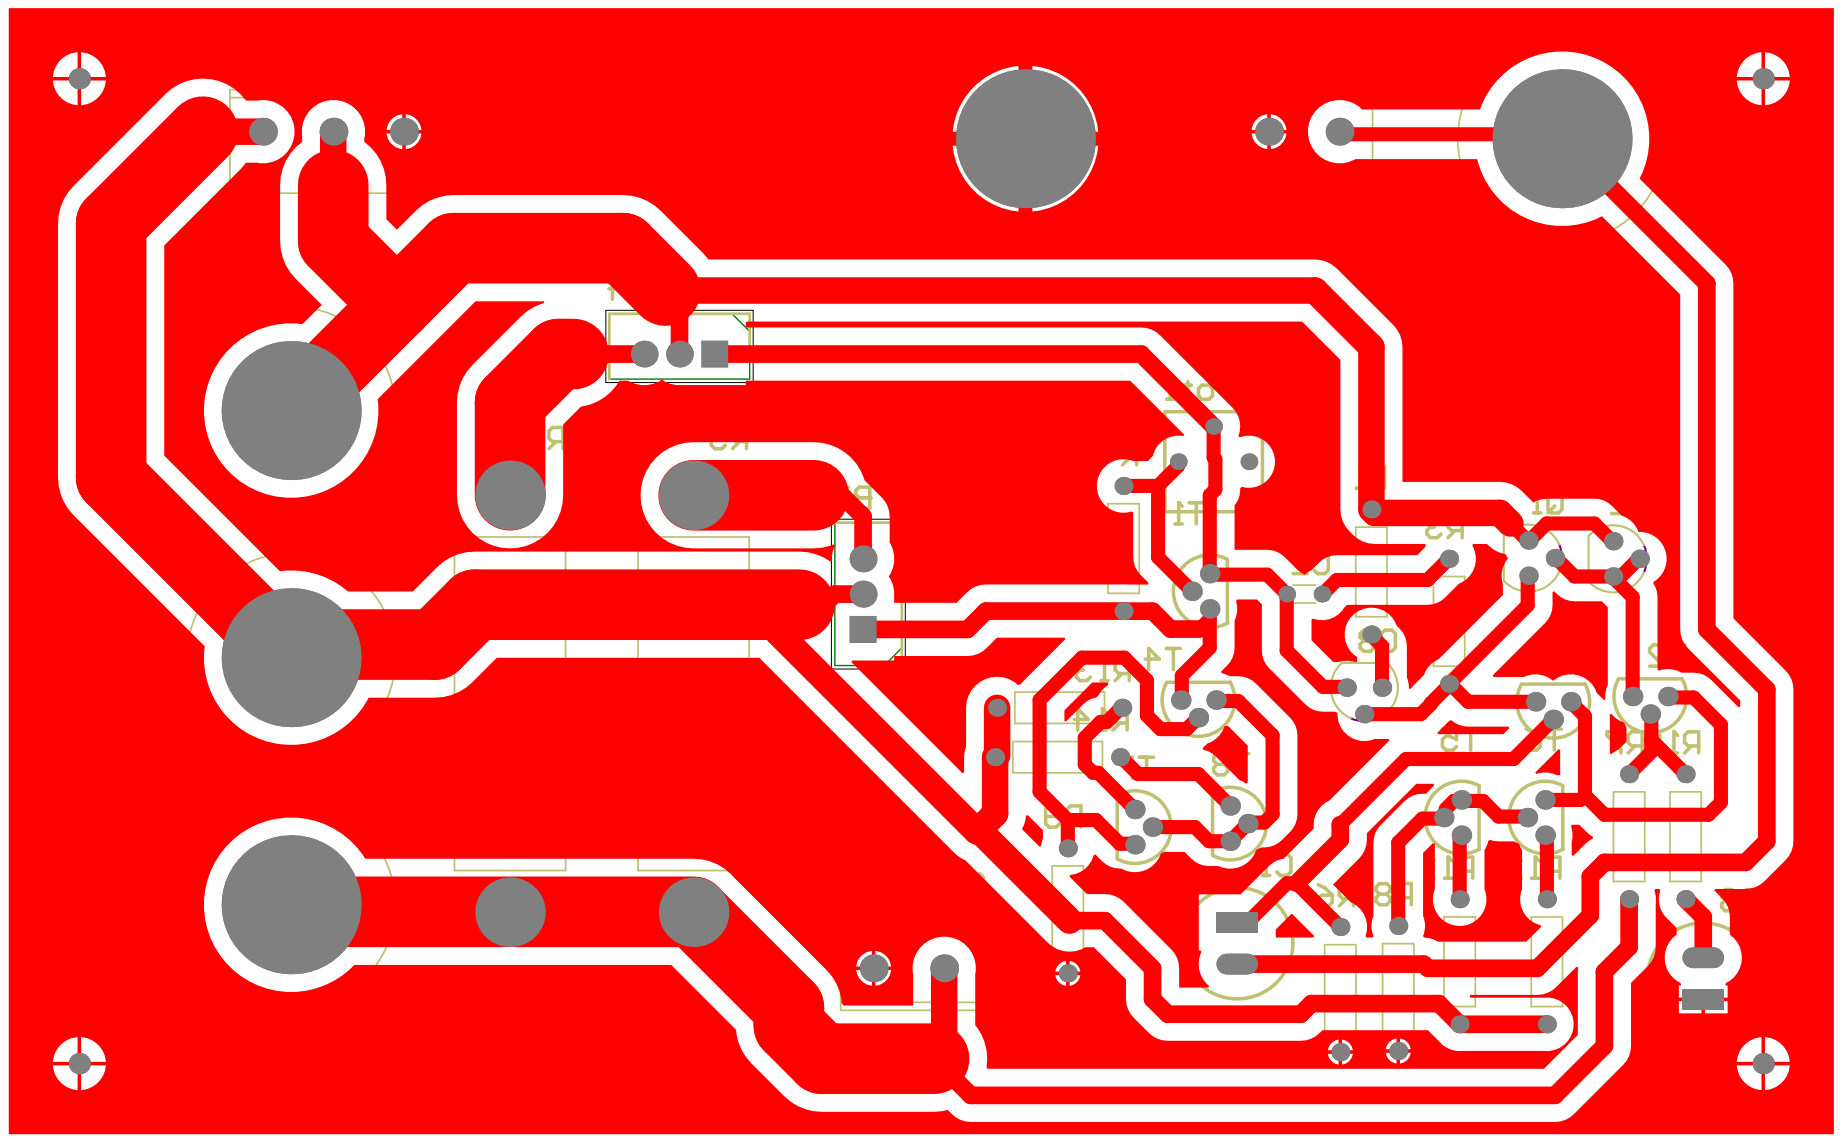
[picture p180: page 1]
