Niclasapdk/ESD4_project/pcb/class_ab_three_stage_orig/class_ab_sch.pdf

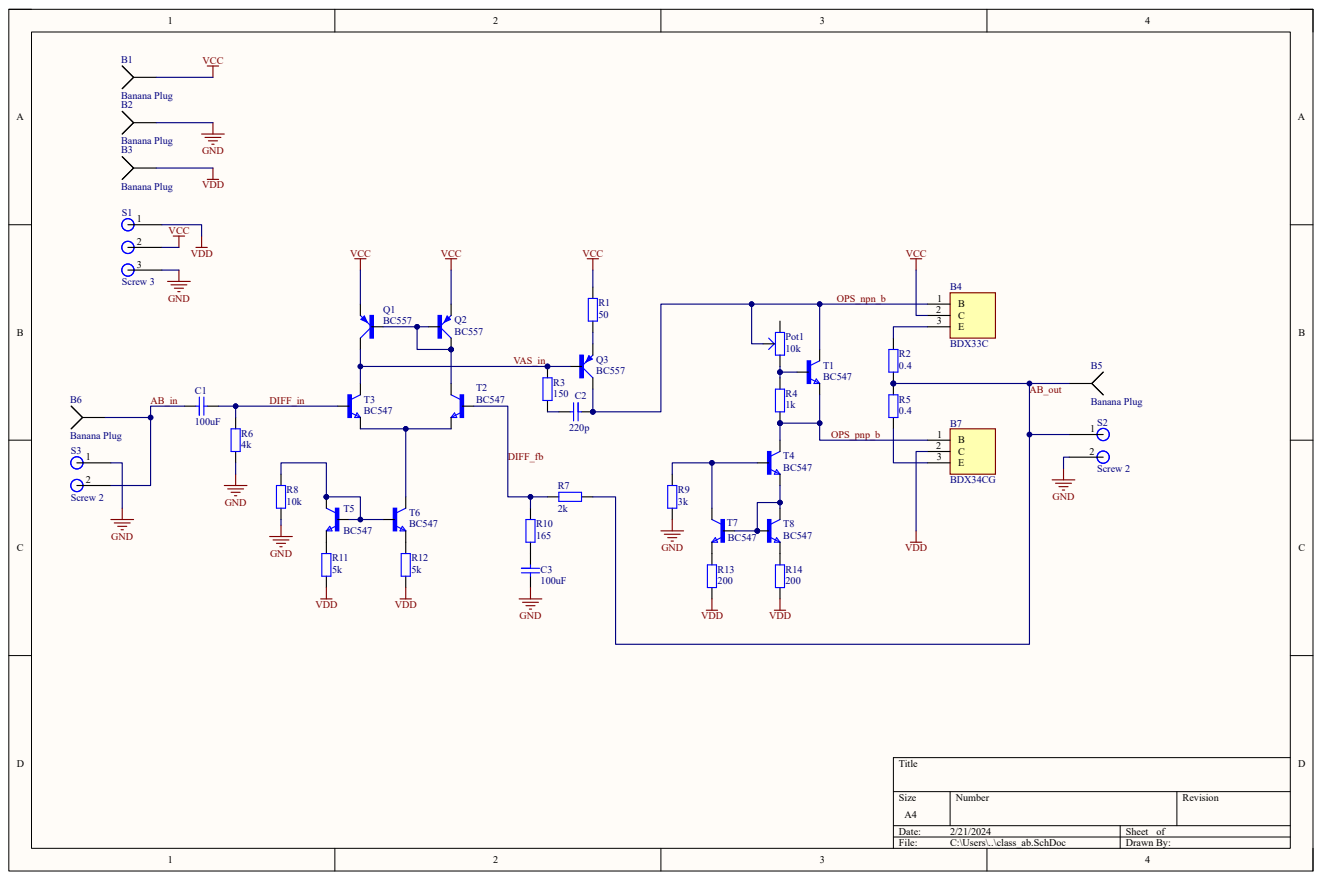
[picture p181: page 1]
