Niclasapdk/ESD4_project/switch_mode_powersupply/RapportDrawing.asc

C1: cap; 330µ
C2: cap; 330µ
D1: schottky; 1n5408
D2: schottky; 1N5408
L1: ind; 330µ
L2: ind; 330µ
R1: res; 16.5k
R2: res; 3.01k
R3: res; 51.1k
R4: res; 3.01k
V1: voltage; 30
V2: voltage; 30
X1: LM2575
X2: LM2575
Named nets: 0
+8V
-8V
+30V
-30V
