Niclasapdk/ESD4_project/figures/integration_test/zo_schematic_equivalent.asc

R_i: res; R_i
Z_out: res
Named nets: 0, V_div, V_in
