Niclasapdk/ESD4_project/figures/system_design/feedback_system/feedback_system.asc

C1: cap; 100µF
R1: res; 12.82k
R2: res; 1k
Named nets: 0, Output, Input
