Niclasapdk/ESD4_project/figures/system_design/pa_after_theoretical_design/pa_after_theoretical_design.asc

C1: cap; 10µF
C2: cap; 100µF
C3: cap; 100nF
C4: cap; 22nF
C5: cap; 22nF
C6: cap; 220µF
C7: cap; 220µF
C8: cap; 2200µF
C10: cap; 2200µF
L1: ind; 6µH
Q1: npn
Q2: npn
Q3: pnp
Q4: pnp
Q5: npn
Q6: npn
Q7: pnp
Q8: pnp
Q9: npn
Q10: npn
Q11: pnp
Q12: npn
Q13: npn
Q14: npn
R1: res; 100
R2: res; 100
R3: res; 10k
R4: res; 5k
R5: res; 5k
R6: res; 10k
R7: res; 1k
R8: res; 12.82k
R9: res; 50
R10: res; 1k
R11: res; potmeter
R12: res; 0.4
R13: res; 0.4
R14: res; 200
R15: res; 200
R16: res; 3k
R17: res; 10
R18: res; 10
R19: res
U1: opamp
Named nets: 0, NFB
