Niclasapdk/ESD4_project/figures/system_design/small_signal_figures/differential_stage_v2.asc

g_m*V_pi1: current; ""
g_m*V_pi2: current; ""
R_C3: res; ""
R_C4: res; ""
r_pi: res; ""
r_pi: res; ""
Named nets: 0
V_in/2
V_in/2
V_out
V_out
