Niclasapdk/ESD4_project/figures/system_design/auxPreAmp/non_inverting_opamp.asc

R1: res; ""
R2: res; ""
U1: opamp
Named nets: 0, vin, vout
