Niclasapdk/ESD4_project/figures/system_design/input_stage_with_current_mirror/input_stage_with_current_mirror.asc

Q1: pnp
Q2: pnp
Q3: npn
Q4: npn
Q5: npn
Q6: npn
R1: res
R2: res
R3: res
R4: res
R5: res
Named nets: 0, V+, input, Feedback, V-, Output
