Niclasapdk/ESD4_project/figures/system_design/output_compensation/output_compensation.asc

C1: cap; 100nF
L1: ind; 6µH
R1: res; 10
R2: res; 10
R3: res; 8
Named nets: 0, Output_amp
