Niclasapdk/ESD4_project/figures/system_design/small_signal_figures/vas_stage.asc

gm1*vin: current; ""
gm2*vin: current; ""
R1: res; ""
r_o1: res; ""
r_o2: res; ""
r_pi1: res; ""
r_pi2: res; ""
Z_inOS: res; ""
Named nets: 0
B1
C1
E2
E1
C2
B2
Power Amp
