Niclasapdk/ESD4_project/figures/system_design/final_pa_topology/final_topology_pa.asc

C1: cap
C2: cap
I1: current
I2: current
Q1: npn
Q2: npn
Q3: pnp
Q4: pnp
Q5: pnp
Q6: pnp
Q7: pnp
Q8: npn
Q9: npn
R1: res
R2: res
R3: res
R4: res
R5: res
R6: res
R7: res
Named nets: 0, Output, NFB, Input, V+, V-
