Niclasapdk/ESD4_project/figures/system_design/small_signal_figures/Draft1.asc

gm1*Vin/2: current; ""
gm2*Vin/2: current; ""
gm4*Vb: current; ""
R1||R2: res; ""
r_e3||r_o3: res; ""
r_o1: res; ""
r_o2: res; ""
r_o4: res; ""
r_pi1: res; ""
r_pi2: res; ""
r_pi4: res; ""
Named nets: 0, Vout, Vin/2
