Niclasapdk/ESD4_project/figures/system_design/small_signal_figures/npn_darlington.asc

Beta_1*I_B1: current; ""
Beta_2*I_B2: current; ""
r_oVas: res; ""
r_pi1: res; ""
r_pi2: res; ""
Named nets: 0
V_cc+
Out
