Niclasapdk/ESD4_project/figures/system_design/vas_stage_pa/vas_stage_pa.asc

C1: cap; Cdom
I1: current
Q1: pnp
Q2: pnp
R1: res
Named nets: 0, Input_Stage, V+, Output_stage, V-
