Niclasapdk/ESD4_project/figures/system_design/bias_current_final/bias_current_final.asc

Q1: npn
Q2: npn
Q3: npn
Q4: npn
R1: res; 1k
R2: res; R_pot
R3: res; 200
R4: res; 200
R5: res; 3k
R6: res; 220
Named nets: Vas, pnp, npn, 0, V-
