Niclasapdk/ESD4_project/figures/system_design/filtering/sallen_key_hp_lp.asc

C1: cap
C2: cap
C3: cap
C4: cap
R1: res
R2: res
R3: res
R4: res
U1: opamp
U2: opamp
Named nets: 0, Input, Output
