Niclasapdk/ESD4_project/figures/system_design/output_stage_current_mirror/output_stage_current_mirror.asc

Q1: npn
Q2: npn
Q3: npn
R1: res
Named nets: 0, V-, Out
