Niclasapdk/ESD4_project/figures/system_design/riaa_preamp/Draft1.asc

C1: cap; ""
C2: cap; ""
C3: cap; ""
L1: ind; ""
R1: res; ""
R2: res; ""
R3: res; ""
V1: voltage; ""
V2: voltage; ""
V3: voltage; ""
RLC
HP
LP
