Niclasapdk/ESD4_project/figures/system_design/riaa_preamp/complete_riaa_topology.asc

C1: cap; ""
C2: cap; ""
C3: cap; ""
C4: cap; ""
C5: cap; ""
R1: res; 47k
R2: res; ""
R3: res; ""
R4: res; ""
R5: res; ""
R6: res; ""
R7: res; ""
U1: opamp
U2: opamp
Named nets: 0, Input, Output
T6
RIAA + T2
Line level gain
Impedance match
