Niclasapdk/ESD4_project/figures/system_design/bias_design/bias_design.asc

I1: current
Q1: npn
R1: res
R2: res
Named nets: Vas, pnp, npn, V-
