Niclasapdk/ESD4_project/figures/system_design/darlington_coupling/darlington_coupling.asc

Q1: npn
Q2: npn
Q3: pnp
Q4: pnp
Named nets: V+, V-
