Niclasapdk/ESD4_project/figures/system_design/input_stage_pa/input_stage_pa.asc

I1: current
Q1: npn
Q2: npn
Q3: pnp
Q4: pnp
R1: res
R2: res
Named nets: V+, V-, NFB, Input, VAS
