Niclasapdk/ESD4_project/figures/system_design/output_stage_pa/output_stage_pa.asc

I1: current; I_Bias
Q1: npn
Q2: npn
Q3: pnp
R1: res
R2: res
Named nets: V+, V-, Output, NFB, VAS
