Niclasapdk/ESD4_project/figures/system_design/three_stage_pa/three_stage_pa.asc

C1: cap
I1: current
I2: current
Q1: pnp
Q2: pnp
Q3: npn
Q4: npn
Q5: npn
Q6: npn
Q7: pnp
Named nets: input, NFB, V+, V-, Output
