Niclasapdk/ESD4_project/class_ab_amplifier/classABThreeStage.asc

C1: cap; 100µ
C2: cap; 2.2m
C3: cap; 3.3µF
C4: cap; 22n
C5: cap; 220µ
C6: cap; 2.2m
C7: cap; 22n
C8: cap; 220µ
C9: cap; 100n
C10: cap; 470n
C11: cap; 68pF
C_miller: cap; 470p
L1: ind; 6µ
Q1: npn; BC547B
Q2: npn; BC547B
Q3: pnp; BC556B
Q4: pnp; BC556B
Q5: pnp; BC556B
Q6: npn; BC547B
Q7: npn; BC547B
Q8: pnp; BC556B
Q_VBE: npn; BC547B
Q_W1: npn; BC547B
Q_W2: npn; BC547B
Q_W3: npn; BC547B
R1: res; 0.4
R2: res; 0.4
R3: res; 12.82k
R4: res; 1k
R5: res; 10
R6: res; 1k
R7: res; 2k
R8: res; 5k
R9: res; 5k
R10: res; 24.9k
R11: res; 10
R12: res; 100
R13: res; 100
R14: res; 100
R15: res; 11.5k
R_load: res; 8
R_VBE1: res; 1k
R_VBE2: res; 300
R_W: res; 3k
R_WE1: res; 200
R_WE2: res; 200
U1: mj11016
U2: mj11015
V1: voltage; 30
V2: voltage; 30
V4: voltage; SINE(0 1.7366 {f}); AC 1
Named nets: 0, Vcc+, Vcc-, in, ops_npn, ops_pnp, VBE_base, NFB, out
VBE-Multiplier
Feedback Network
Voltage Amplification Stage (VAS)
Input Stage
Output Stage
.tran {t}
.option plotwinsize=0
.four {f} 5 8 V(out)
.meas TRAN power_Output AVG I(R_load)*V(Out) TRIG time=0 TARG time={t}
.param f=1k n=16 t=n/f
220 + 1k pot
