Niclasapdk/ESD4_project/equaliser/equaliser.asc

C1: cap; 10µ
C2: cap; 10µ
C3: cap; 5.4n
C4: cap; 1.6µ
C5: cap; 23n
C6: cap; 6.1µ
C7: cap; 1.4n
C8: cap; 400n
C9: cap; 340p
C10: cap; 100n
C11: cap; 85p
C12: cap; 25n
R1: res; 500k
R2: res; 221k
R3: res; 604
R4: res; 604
R5: res; {rg2}
R6: res; 100k
R7: res; 475
R8: res; {potmax-rg2}
R9: res; {rg3}
R10: res; {rg1}
R11: res; {potmax-rg1}
R12: res; 100k
R13: res; 475
R14: res; 100k
R15: res; 475
R16: res; {potmax-rg3}
R17: res; {rg4}
R18: res; 100k
R19: res; 475
R20: res; {potmax-rg4}
R21: res; {rg5}
R22: res; 100k
R23: res; 475
R24: res; {potmax-rg5}
R25: res; 232
R26: res; 232
R_load: res; {Rload}
U1: UniversalOpAmp
U2: UniversalOpAmp
U3: UniversalOpAmp
U4: UniversalOpAmp
U5: UniversalOpAmp
U6: UniversalOpAmp
U7: UniversalOpAmp
U8: opamp
V1: voltage; ""; AC 1
V2: voltage; {Vsupply}
V3: voltage; {Vsupply}
Named nets: 0, Vcc, Vdd, bp_in, bp_out, out, in
.ac dec 1k 10 40k
.lib opamp.sub
.param g1=0.99 g2=0.99 g3=0.99 g4=0.99 g5=0.99
.param potmax=10k
Pot
.param rg1={g1*potmax} rg2={g2*potmax} rg3={g3*potmax} rg4={g4*potmax} rg5={g5*potmax}
.param Vsupply=8
Variables
.param Rload=470k
Band 1
Pot
Band 2
Pot
Band 3
Pot
Band 4
Pot
Band 5
60 Hz
250 Hz
1 kHz
4 kHz
16 kHz
