Niclasapdk/ESD4_project/subsonic_ultrasonic_filter/bandpass.asc

C1: cap; 22n
C2: cap; 22n
C3: cap; 100n
C4: cap; 200n
R1: res; 511k
R2: res; 255k
R3: res; 56.2
R4: res; 56.2
U1: UniversalOpAmp
U2: UniversalOpAmp
V1: voltage; ""; AC 1
V2: voltage; 8
V3: voltage; 8
Named nets: 0, V+, V-, Input, Output
.ac dec 20 20 20k
