Niclasapdk/ESD4_project/aux_preamp/opamp-preamp.asc

R1: res; 2.88k
R2: res; 1k
R3: res; 499k
R_load: res; 470k
U1: OP07
V1: voltage; 5
V2: voltage; SINE(0 0.447 {f})
V3: voltage; -5
Named nets: vcc, 0, vin, vcc-, out
.tran {t}
.param f=1k n=16 t=n/f
.option plotwinsize=0
.four {f} 10 8 V(out)
.meas TRAN power_Output AVG I(R_load)*V(Out) TRIG time=0 TARG time={t}
