Niclasapdk/ESD4_project/unregulated_powersupply/unregulated_supply.asc

C1: cap; 20m
C2: cap; 20m
C3: cap; 10m
C4: cap; 10m
C5: cap; 3.3m
C6: cap; 3.3m
D1: diode
D2: diode
D3: diode
D4: diode
L1: ind2; 55
L2: ind2; 1
L3: ind2; 1
R2: res; 1
V1: voltage; SINE(0 230 50)
Named nets: 0
.tran 1
K1 L1 L2 L3 1
