Niclasapdk/ESD4_project/volume_control/volume_control.asc

R1: res; {rg}
R2: res; {potmax-rg}
R3: res; 1k
R4: res; 1k
R5: res; {Rload}
U1: opamp
U2: opamp
V1: voltage; SINE(0 1.736 1k); AC 1
Named nets: 0, in, out
.lib opamp.sub
;.ac dec 1k 10 40k
.param g=0.5 potmax=10k rg={potmax*g} Rload=470k
.tran 5m
Baxandall Active Volume Control
Load
Lower R3 for more gain
.step param g 0.01 0.99 0.05
