Niclasapdk/ESD4_project/class_a_amplifier/output_stage.asc

Q1: npn
R1: res; IQ
R2: res; RLoad
Named nets: 0, V+, V-, Signal
