Niclasapdk/ESD4_project/switch_mode_powersupply/Draft2.asc

C1: cap; 250n
R1: res; 1k
R2: res; 1k
R3: res; 1k
U1: OP07
U2: OP07
U3: opamp
U4: OP07
V1: voltage; 5
V2: voltage; -5
V3: voltage; 1v
Named nets: 0, v+, v-
.lib opamp.sub
.tran 200m
