Niclasapdk/ESD4_project/switch_mode_powersupply/Switch_mode.asc

C1: cap; 10000µ
C2: cap; 10000µ
D2: schottky
D3: schottky
L1: ind; 9.66µ
L3: ind; 9.66µ
M1: nmos; SUP90N08-8m2P
M2: nmos; SUP90N08-8m2P
R1: res; 50
R2: res; 50
V1: voltage; 30
V2: voltage; PULSE(0 35 0 0 0 21n 139.2n)
V3: voltage; 30
V4: voltage; PULSE(0 35 0 0 0 32n 139.2n)
Named nets: 0
.tran 3m
