Niclasapdk/ESD4_project/aux_preamp/Draft3.asc

C1: cap; 2µ
C2: cap; 68.2µ
C3: cap; 937.3n
Q1: npn; BC546B
R1: res; 1k
R2: res; 309k
R3: res; 110k
R4: res; 3.01k
R5: res; 6.98k
R6: res; 10k
V1: voltage; SINE(0 14.14m 2k); AC 1
V2: voltage; 15
Named nets: Vs, 0, vi, vo
;.tran 0 5m 0 100n
.four 2k 10 100 V(vo)
.ac dec 1 1 100E6
ac for for at finde f_L og f_H tran for at se total harmonic under view på grafen eller .four og view spice error log
