Niclasapdk/ESD4_project/RIAA/riaa.asc

C1: cap; 1.6µ
C2: cap; 2.2n
C3: cap; 633.39p
C4: cap; 1.2n
R1: res; 47k
R2: res; 5k
R3: res; 1.44E6
R4: res; 118.41k
R5: res; 2k
R6: res; 1.21E6
R7: res; 154k
U1: opamp
U2: opamp
V1: voltage; SINE(0 0.007071 1k); AC 1
Named nets: 0, vin, out, vout
.lib opamp.sub
.four {f} 10 8 V(out)
.param f=1k n=16 t=n/f
;.ac dec 100 1 25000
.tran {t}
