Niclasapdk/ESD4_project/aux_preamp/differential.asc

C1: cap; 100n
Q1: npn
Q2: npn
Q3: pnp
Q4: pnp
Q5: npn
Q6: npn
R1: res; 100k
R2: res; 450k
R3: res; 1k
R4: res; 2.88k
V1: voltage; 30
V2: voltage; -30
V3: voltage; SINE(0 0.460 1k)
Named nets: out, 0, vcc, vcc-, in
.tran {t}
.param f = 1k n=16 t=n/f
.four {f} 10 8 V(out)
.meas TRAN power_Output AVG I(R_load)*V(Out) TRIG time=0 TARG time={t}
