Niclasapdk/ESD4_project/switch_mode_powersupply/Draft1.asc

10k: res; 100k
A1: dflop
C1: cap; 100n
C2: cap; 100n
R1: res; 10k
R2: res; 10k
U1: opamp
U2: opamp
V1: voltage; PULSE(0 5 0 0 0 0.5u 1u)
V2: voltage; SINE(0 3 20k 0)
Named nets: 0
.tran 1m
.lib opamp.sub
