Niclasapdk/ESD4_project/switch_mode_powersupply/sigma_delta.asc

10k: res; 100k
A1: dflop
A2: dflop
A3: dflop
C1: cap; 100n
C2: cap; 100n
C3: cap; 1µ
C4: cap; 100n
R1: res; 10k
R2: res; 10k
R3: res; 1k
R4: res; 1k
R5: res; 10k
R6: res; 10k
R7: res; 1Meg
R8: res; 1Meg
R9: res; 1Meg
R10: res; 1Meg
R11: res; 1Meg
U1: opamp
U2: opamp
U3: OP07
U4: OP07
U5: OP07
U6: OP07
U7: OP07
U8: OP07
V1: voltage; PULSE(0 1 0 0 0 0.5u 1u)
V2: voltage; SINE(0 1 1k 0)
V3: voltage; PULSE(0 3.3 0 0 0 0.5u 1u)
V4: voltage; 3.3
V5: voltage; SINE(0 2 20k)
V6: voltage; 3.3
V7: voltage; 3.3
V8: voltage; SINE(0 2 300)
V9: voltage; PULSE(0 3.3 0 0 0 0.5u 1u)
V10: voltage; 3.3
Named nets: 0, v+, v-
.tran 5m
.lib opamp.sub
