Niclasapdk/ESD4_project/(list of files, drawings)

Other design files:
equaliser/equalizerAndVoltageControl/equalizerAndVoltageControl.PrjPcb
equaliser/equalizerAndVoltageControl/Sheet1.SchDoc
pcb/auxpreamp_riaa/auxpreamp_riaa.PcbDoc
pcb/auxpreamp_riaa/auxpreamp_riaa.PrjPcb
pcb/auxpreamp_riaa/auxpreamp_riaa.SchDoc
pcb/auxpreamp_riaa/pcblibpreamp.PcbLib
pcb/auxpreamp_riaa/schematiclibpre.SchLib
pcb/class_ab_three_stage_orig/BC547.SchLib
pcb/class_ab_three_stage_orig/BC557.SchLib
pcb/class_ab_three_stage_orig/BDX33C.SchLib
pcb/class_ab_three_stage_orig/BDX34CG.SchLib
pcb/class_ab_three_stage_orig/class_ab.SchDoc
pcb/class_ab_three_stage_orig/class_ab_three_stage.PrjPcb
pcb/class_ab_three_stage_orig/SOT54A.PcbLib
pcb/class_ab_three_stage_orig/TO92.PcbLib
pcb/class_ab_three_stage_orig/TO254P470X990X1900-3P.PcbLib
pcb/class_ab_three_stage_orig/TO254P482X997X2018-3P.PcbLib
pcb/class_ab_three_stage_orig/version1.PcbDoc
pcb/class_ab_three_stage_orig/version2.PcbDoc
pcb/equalizerAndVoltageControl/equalizer.SchDoc
pcb/equalizerAndVoltageControl/equalizerAndVoltageControl.PrjPcb
pcb/equalizerAndVoltageControl/eqVcVersion1.PcbDoc
pcb/equalizerAndVoltageControl/eqVcVersion2.PcbDoc
pcb/equalizerAndVoltageControl/voltageControl.SchDoc
pcb/front_pot_plate/front_pot_plate.PcbDoc
pcb/front_pot_plate/front_pot_plate.PrjPcb
pcb/front_pot_plate/front_pot_plate.SchDoc
pcb/powersupply/powersupply.PcbDoc
pcb/powersupply/powersupply.PrjPcb
pcb/powersupply/powersupply.SchDoc
