Niclasapdk/ESD4_project/(commit log)

2024-02-14 added windows symlinks 🤮
2024-02-15 simulate output stage with darlington model
2024-02-16 create a start point for simulating three stage class AB amplifier
2024-02-20 add current mirror
2024-02-20 update output stage emitter resistors
2024-02-20 clean up schematic and add comments
2024-02-21 Update LT-spice class AB amplifier circuit
2024-02-21 Added class b amplifier files WIP, design choices have been made, calculations on the circuit, and the feedback is needed
2024-02-22 update resistor values to be consistent with altium
2024-03-04 add script for calculating values for AB amplifier output stage
2024-03-06 add new transistor models to circuit
2024-03-06 print headlines in color and space sections from each other for readability
2024-03-07 update resistors to be e96
2024-03-07 Added first draft of equalizer in Altium
    [Sheet1.SchDoc, equalizerAndVoltageControl.PrjPcb]
2024-03-11 adds simple class A schematic instead of current aux schematic
2024-03-11 linearise input stage
2024-03-11 Add preamp LT-Spice Schematic, we might want to calculate the capacitor values
2024-03-13 add power-supply-rejection and output stage stability
2024-03-13 add fancy rectangle around output stage
2024-03-13 Adds decouple/bypass capacitor for vbe to reduce THD at high frequnecies
2024-03-14 schematic and outline for riaa :))
2024-03-14 add original amplifier pcb
    [BC547.SchLib, BC557.SchLib, BDX33C.SchLib, BDX34CG.SchLib, SOT54A.PcbLib, TO254P470X990X1900-3P.PcbLib, TO254P482X997X2018-3P.PcbLib, TO92.PcbLib]
2024-03-14 Adds subsonic and ultrasonic filtering before Power amplifier
2024-03-14 Add schematics for volumecontrol and bp filter before power amplifier
    [eqVcPcb.PcbDoc, equalizer.SchDoc, equalizerAndVoltageControl.PrjPcb, voltageControl.SchDoc]
2024-03-14 add auxpreamp and riaa schematic folder
    [auxpreamp_riaa.PrjPcb]
2024-03-14 add schematic for preamp and riaa
    [auxpreamp_riaa.PrjPcb, auxpreamp_riaa.SchDoc]
2024-03-14 updates schematic for new amplifier modifications to reach THD 0.0004%
    [class_ab.SchDoc]
2024-03-14 updates to schematic for abclass amplifier
    [class_ab.SchDoc]
2024-03-14 Updates schematic with rail capacitors and corrects NFB
    [class_ab.SchDoc, class_ab_three_stage.PrjPcb]
2024-03-15 add class a aux preamp
    [auxpreamp_riaa.SchDoc, pcblibpreamp.PcbLib, schematiclibpre.SchLib]
2024-03-15 reivse component naming preamp
    [auxpreamp_riaa.PrjPcb, auxpreamp_riaa.SchDoc]
2024-03-18 Fixed naming for volume control and the bp filter
    [voltageControl.SchDoc]
2024-03-18 added coil box stl file
    [coil_box.stl]
2024-03-18 added stl for altium
    [coil_box_with_legs.stl]
2024-03-18 made box less shit
    [coil_box.stl, coil_box_with_legs.stl]
2024-03-18 markus vil gerne have en step fil
    [markus_vil_gerne_have_stepfil.step]
2024-03-18 updates inductor calculations and schematic for Power amplifier
    [class_ab.SchDoc]
2024-03-18 Adds altium pcb footprint for homecooked inductor
2024-03-18 Finalizes schematic for Power amplifier with homemade inductor
    [class_ab.SchDoc]
2024-03-18 continue schematic and pcb for preamp
    [auxpreamp_riaa.PcbDoc, auxpreamp_riaa.PrjPcb, auxpreamp_riaa.SchDoc, pcblibpreamp.PcbLib, schematiclibpre.SchLib]
2024-03-18 revise preamp pcb/schematic
    [auxpreamp_riaa.PcbDoc, auxpreamp_riaa.SchDoc]
2024-03-18 fixes libraries for PA and starts the layout for the print
    [class_ab.SchDoc, version1.PcbDoc, version2.PcbDoc]
2024-03-18 Update eq vc pcb :((
    [eqVc.PcbDoc, eqVcPcb.PcbDoc, equalizer.SchDoc, equalizerAndVoltageControl.PrjPcb, voltageControl.SchDoc]
2024-03-19 Finish base equaliser and volume control PCB drawing. Needs corner things and test points.
    [eqVc.PcbDoc, equalizerAndVoltageControl.PrjPcb]
2024-03-20 Added unity gain part of equaliser
    [eqVc.PcbDoc, equalizer.SchDoc, voltageControl.SchDoc]
2024-03-20 Fix layers
    [eqVc.PcbDoc]
2024-03-20 revise pcb preamp
    [auxpreamp_riaa.PcbDoc, auxpreamp_riaa.SchDoc, pcblibpreamp.PcbLib]
2024-03-20 revise again again preamp
    [auxpreamp_riaa.PcbDoc, auxpreamp_riaa.SchDoc, pcblibpreamp.PcbLib]
2024-03-20 Check Preamp RIAA pcb
    [auxpreamp_riaa.PcbDoc]
2024-03-20 Finalizes PA pcb development and edits bc547 footprint and bc557
    [BC547.SchLib, BC557.SchLib, SOT54A.PcbLib, TO92.PcbLib, class_ab.SchDoc, class_ab_three_stage.PrjPcb, version2.PcbDoc]
2024-03-20 Fix layers :((
    [eqVc.PcbDoc]
2024-03-20 final revision of preamp! :3
    [auxpreamp_riaa.PcbDoc, auxpreamp_riaa.SchDoc, pcblibpreamp.PcbLib, schematiclibpre.SchLib]
2024-03-21 add screwhole to volume gogo
    [equalizer.SchDoc, equalizerAndVoltageControl.PrjPcb]
2024-03-21 final revision of volume/eq pcb (cap)
    [eqVc.PcbDoc, equalizer.SchDoc, equalizerAndVoltageControl.PrjPcb, voltageControl.SchDoc]
2024-03-21 Change volume control to less gain, to match PA
    [auxpreamp_riaa.PcbDoc, auxpreamp_riaa.PrjPcb, eqVc.PcbDoc, equalizer.SchDoc, equalizerAndVoltageControl.PrjPcb, voltageControl.SchDoc]
2024-03-21 fix input impedances and amplification riaa/preamp
    [auxpreamp_riaa.PcbDoc, auxpreamp_riaa.PrjPcb, auxpreamp_riaa.SchDoc]
2024-03-21 RIAA´schematic amplification update
2024-03-21 updates schematic for changes to pcb
    [class_ab.SchDoc, class_ab_three_stage.PrjPcb]
2024-03-25 made johns pcb a bit smaller and aligned terminals
    [auxpreamp_riaa.PcbDoc]
2024-03-25 revise clearance and fix schematic preamp
    [auxpreamp_riaa.PcbDoc, auxpreamp_riaa.PrjPcb, auxpreamp_riaa.SchDoc]
2024-03-26 meesa made big doodo with riaa schematic
    [auxpreamp_riaa.PcbDoc, auxpreamp_riaa.SchDoc]
2024-03-26 Make second version of the equalizer and volume control pcb
    [eqVcVersion1.PcbDoc, eqVcVersion2.PcbDoc, equalizer.SchDoc, equalizerAndVoltageControl.PrjPcb, voltageControl.SchDoc]
2024-03-26 Finish eqvc pcb and make gerber x2 files for it
    [eqVcVersion2.PcbDoc, equalizerAndVoltageControl.PrjPcb]
2024-03-26 Fix free space for connectors
    [eqVcVersion2.PcbDoc, equalizerAndVoltageControl.PrjPcb]
2024-03-26 updates spice and pcb files for new iteration of PA
    [class_ab.SchDoc, version2.PcbDoc]
2024-03-27 add cam to riaa
    [auxpreamp_riaa.PcbDoc, auxpreamp_riaa.PrjPcb]
2024-03-28 changes to riaa schematic
2024-03-28 updates spice files for PA and pcb, generates gerber files for preamp
    [class_ab_three_stage.PrjPcb, version2.PcbDoc]
2024-03-28 adds printed version of riaa
    [auxpreamp_riaa.PcbDoc, auxpreamp_riaa.PrjPcb]
2024-04-04 add front plate potentiometer pcb
    [front_pot_plate.PcbDoc, front_pot_plate.PrjPcb, front_pot_plate.SchDoc]
2024-04-08 update resistor values and cap spice and altium
    [auxpreamp_riaa.SchDoc]
2024-04-08 minor changes?
    [auxpreamp_riaa.PcbDoc]
2024-04-08 added eq_faceplate
    [Part Studio 1 - Part 1(1).stl, Part Studio 1 - Part 1.stl, Part Studio 1 - Part 1.x_t, Part Studio 1 - Sketch 1(1).dxf, Part Studio 1 - Sketch 1.dxf, coil_box.stl, coil_box_with_legs.stl, markus_vil_gerne_have_stepfil.step]
2024-04-09 fixed switchmode
2024-04-10 adds spice schematic for unregulated powersupply
2024-04-11 added negative switching powersupply to ltspice file
2024-04-11 adds changes to spice schematics and adds pcb project for powersupply
    [powersupply.PrjPcb]
2024-04-11 adds new components for powersupply and start of powersupply schematic
    [powersupply.SchDoc]
2024-04-11 fixes pcblib for rsproinductor
    [powersupply.PrjPcb, powersupply.SchDoc]
2024-04-11 adds lm2575 library and updates schematic because footprints dont work
    [powersupply.PcbDoc, powersupply.SchDoc]
2024-04-11 last changes to schematic footprint still dont work
    [powersupply.PcbDoc, powersupply.SchDoc]
2024-04-11 all my windows shit
    [PCB1_Copper_Signal_Bot.gbr, PCB1_Copper_Signal_Top.gbr, PCB1_Legend_Bot.gbr, PCB1_Legend_Top.gbr, PCB1_NPTH_Drill.gbr, PCB1_PTH_Drill.gbr, PCB1_Paste_Bot.gbr, PCB1_Paste_Top.gbr]
2024-04-12 preamp freq response test
    [class_a_waveform_l.csv, class_a_waveform_r.csv, opamp_waveform_l.csv, opamp_waveform_r.csv, riaa_waveform_l.csv, riaa_waveform_r.csv]
2024-04-15 Changed resistor values in altium
    [equalizer.SchDoc, voltageControl.SchDoc]
2024-04-15 changed resistors in LT-Spice to be the same as the ones on the pcb
2024-04-15 adds pcb for powersupply + camfiles
    [powersupply.PcbDoc, powersupply.PrjPcb, powersupply.SchDoc]
2024-04-15 add riaa thd integration
    [LRIAATHD.tsv, LRIAApreampTHD.tsv, RRIAATHD.tsv, RRIAApreampTHD.tsv]
2024-04-15 Added tsv files from testing THD, FreqResp and Impedance
    [1kFreqResp.tsv, LClassA+1kFreqResp.tsv, LClassAFreqResp.tsv, LClassATHD.tsv, LEQVCMaxFreqResp.tsv, LEQVCMid+1kFreqResp.tsv, LEQVCMidFreqResp.tsv, LEQVCMidTHD.tsv]
2024-04-17 organize test data by module
    [1kFreqResp.tsv, LClassA+1kFreqResp.tsv, LClassAFreqResp.tsv, LClassATHD.tsv, LEQVCMaxFreqResp.tsv, LEQVCMid+1kFreqResp.tsv, LEQVCMidFreqResp.tsv, LEQVCMidTHD.tsv]
2024-04-17 rename files for clarity
    ```
    %s/+//g
    %s/\(\w*\)FreqResp.tsv/freqresp_\1.tsv/g
    %s/\(\w*\)THD.tsv/thd_\1.tsv/g
    %s/\(\w*\)_\([RL]\)\(\w*\).tsv/\1_\3_\2.tsv/g
    %g/1k/s/^[^_]*/impedance
    %s/1k//
    %norm guu
    ```
    [freqresp_classA_l.tsv, freqresp_classA_r.tsv, freqresp_eqvolctrl_max_l.tsv, freqresp_eqvolctrl_max_r.tsv, freqresp_eqvolctrl_mid_l.tsv, freqresp_eqvolctrl_mid_r.tsv, freqresp_eqvolctrl_min_l.tsv, freqresp_eqvolctrl_min_r.tsv]
2024-04-17 organize eq tests by potentiometer placement
    [freqresp_eqvolctrl_max_l.tsv, freqresp_eqvolctrl_max_r.tsv, freqresp_eqvolctrl_mid_l.tsv, freqresp_eqvolctrl_mid_r.tsv, freqresp_eqvolctrl_min_l.tsv, freqresp_eqvolctrl_min_r.tsv, impedance_eqvolctrl_mid_l.tsv, impedance_eqvolctrl_mid_r.tsv]
2024-04-17 clean up test data
    [audioanalyzer_classA_l.tsv, audioanalyzer_classA_r.tsv, audioanalyzer_eqvolctrl_max_l.tsv, audioanalyzer_eqvolctrl_max_r.tsv, audioanalyzer_eqvolctrl_mid_l.tsv, audioanalyzer_eqvolctrl_mid_r.tsv, audioanalyzer_eqvolctrl_min_l.tsv, audioanalyzer_eqvolctrl_min_r.tsv]
2024-04-17 output all integration test plots
    [exampledata1.tsv, exampledata2.tsv]
2024-04-17 added moving magnet moving coil figure
2024-04-18 add pdf
    [class_ab_three_stage.PrjPcb]
2024-04-18 added ampl resp files
    [eq_l_amp_sweep.tsv, eq_r_amp_sweep.tsv, preamp_class_a_l_sweep.tsv, preamp_class_a_r_sweep.tsv, preamp_opamp_l_sweep.tsv, preamp_opamp_r_sweep.tsv]
2024-04-18 finalizes powersupply hopefully
    [powersupply.PcbDoc, powersupply.PrjPcb, powersupply.SchDoc]
2024-04-23 adds schematic picture of a fet
2024-04-30 adds three stage figure of pa for report
2024-04-30 adds png for three stage
2024-04-30 updates three stage png with seperation lines
2024-04-30 hopefully finalizes three stage pa figure
2024-04-30 add folder for figures in sd and riaa filters
2024-04-30 adds figure for output stage for pa sd
2024-04-30 adds picture for input stage
2024-04-30 updates input stage
2024-04-30 adds png to update input stage
2024-05-01 adds darlington coupling figure for pa sd
2024-05-01 add picture for mj110 darlington transistor schematic
2024-05-05 bp,hp and lp schematic for eq
2024-05-06 adds current mirror schematic for pa sd
2024-05-06 adds final bias and current mirror design for pa sd
2024-05-07 addded circuit for class A
2024-05-07 add theoretical plot to riaa
    [calculation_data.csv]
2024-05-07 adds input stage with current mirror for input stage calculations
2024-05-08 update output power
2024-05-08 adds picture for feedback system schematic
2024-05-08 add freq resp for class A from ad2
    [freq_resp_class_A_l.csv, freq_resp_class_A_r.csv]
2024-05-08 add zi for class A
    [zi_class_a_l.csv, zi_class_a_r.csv]
2024-05-09 update test descriptions
    [impedance_3.3nF_l.tsv, impedance_classA_r.tsv]
2024-05-09 data for zi test
    [zi_pa_l.csv, zi_pa_r.csv, zi_preamp_opamp_l.csv, zi_preamp_opamp_r.csv, zi_preamp_riaa_l.csv, zi_preamp_riaa_r.csv]
2024-05-09 add zo data for preamp channel r
    [zo_preamp_opamp_r_1k.csv, zo_preamp_opamp_r_2k.csv]
2024-05-09 adds picture for unregulated powersupply
2024-05-13 do not print filenames
2024-05-13 update eq_volctrl plots and data
    [audioanalyzer_eqvolctrl_max_l.tsv, audioanalyzer_eqvolctrl_max_r.tsv, audioanalyzer_eqvolctrl_mid_l.tsv, audioanalyzer_eqvolctrl_mid_r.tsv, audioanalyzer_eqvolctrl_min_l.tsv, audioanalyzer_eqvolctrl_min_r.tsv, impedance_eqvolctrl_mid_l.tsv, impedance_eqvolctrl_mid_r.tsv]
2024-05-13 add power amplifier plots
    [audioanalyzer_poweramp_l.tsv, audioanalyzer_poweramp_r.tsv]
2024-05-13 add zi for equalizer.csv
    [zi_equalizer.csv]
2024-05-13 update eq freqresp
    [audioanalyzer_eqvolctrl_min_l.tsv]
2024-05-13 move data files
    [zi_class_a_l.csv, zi_class_a_r.csv, zi_poweramp_l.csv, zi_poweramp_r.csv, zi_preamp_opamp_l.csv, zi_preamp_opamp_r.csv, zi_preamp_riaa_l.csv, zi_preamp_riaa_r.csv]
2024-05-13 adds voltage follower figure
2024-05-13 add more zo measure data
    [zo_class_a_l_100k.csv, zo_class_a_l_200k.csv, zo_class_a_r_100k.csv, zo_class_a_r_200k.csv, zo_preamp_opamp_l_1k.csv, zo_preamp_opamp_l_2k.csv]
2024-05-13 add output impedance plots
    [zo_class_a_l_100k.csv, zo_class_a_l_200k.csv, zo_class_a_r_100k.csv, zo_class_a_r_200k.csv, zo_preamp_opamp_l_1k.csv, zo_preamp_opamp_l_2k.csv]
2024-05-13 add some impedance plots
    [zi_eq_l.csv, zi_eq_r.csv]
2024-05-13 add zo for riaa+opamp data
    [zo_riaa_l_1k.csv, zo_riaa_l_2k.csv, zo_riaa_r_1k.csv, zo_riaa_r_2k.csv]
2024-05-13 remove bs
    [zo_riaa_l_1k.csv, zo_riaa_l_2k.csv, zo_riaa_r_1k.csv, zo_riaa_r_2k.csv]
2024-05-13 add zi for voltage follower data
    [zi_voltage_follower_l.csv, zi_voltage_follower_r.csv]
2024-05-13 update poweramp input impedance to voltage follower
    [zi_poweramp_l.csv, zi_poweramp_r.csv, zi_voltage_follower_l.csv, zi_voltage_follower_r.csv]
2024-05-13 revise zi poweramp data with vf
    [zi_poweramp_l.csv, zi_poweramp_r.csv]
2024-05-13 add input impedance for power amplifier
2024-05-13 riaa opamp zo try again
    [zi_riaa_opmap_l_100.csv, zi_riaa_opmap_r_200.csv]
2024-05-14 Made sallen key filter topology for design section
2024-05-14 Added preamp figure
    [eqVcVersion2.PcbDoc, equalizer.SchDoc]
2024-05-14 add filter response for bandpass simulation
2024-05-14 fixes my upsie on the vas stage
2024-05-14 fixes another upsie on pa final topology also vas stage
2024-05-15 fixes feedback system resistors
2024-05-15 add snr for total system
    [snr_nosignal.csv, snr_signal.csv]
2024-05-15 adds schematic diagram for output compensation for pa sd
2024-05-15 adds schematic of pa after theoretical design for pa sd
2024-05-15 adds schematic of open loop test for pa sd
2024-05-15 correct input levels
    [zi_class_a_l.csv, zi_class_a_r.csv, zi_preamp_riaa_r.csv]
2024-05-15 adds final schematic of power amplifier in sd
2024-05-16 updates input stage with current mirror with output
2024-05-16 reverse order of plot titles
    Example:
    Power Amplifier THD
    THD: Power Amplifier
    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
2024-05-16 add zo schematic equivalent
2024-05-16 spring cleaning
    [1kFreqResp.tsv, eq_l_amp_sweep.tsv, eq_r_amp_sweep.tsv, impedance_3.3nF_l.tsv, impedance_classA_r.tsv, preamp_class_a_l_sweep.tsv, preamp_class_a_r_sweep.tsv, preamp_opamp_l_sweep.tsv]
2024-05-16 Fixed resistor value
2024-05-17 adds pictures of physical pcb systems for integration
2024-05-17 added box figures and pcb pictures
2024-05-17 modifies pa pcb for integration with sallen key filter
    [class_ab.SchDoc, version2.PcbDoc]
2024-05-18 updates filter, and power amplifier schematic
    [class_ab.SchDoc, version2.PcbDoc]
2024-05-18 adds picture of powersupply for itengration
    [class_ab_three_stage.PrjPcb]
2024-05-20 new small signal for diff stage
2024-05-20 re pushing data for eq
    [audioanalyzer_eqvolctrl_min_l.tsv, audioanalyzer_eqvolctrl_min_r.tsv]
2024-05-20 switch mode powersupply drawing in ltspice
2024-05-20 added pcb itterations photo
2024-05-22 adds bandpass filter figure with values for simulation in sd
2024-05-22 add attachment zip file
